RoboJackets/roboracing-electrical/README.md

# RoboRacing Electrical
This is a repository for the RoboJackets' RoboRacing Electrical team.

## rigatoni
Contains current files associated with Rigatoni.

## sedani
Contains current files associated with Sedani.

## archive
Contains old files no longer in use on the current robots.
