RoboJackets/roboracing-electrical/rigatoni/distributed-vision/CAMOutputs/Assembly/DistributedVisionSchematicPage1_3 4VER2.txt

Partlist exported from /Users/oankarpatil/Documents/GitHub/roboracing-electrical/distributed-vision/DistributedVisionSchematicPage1_3 4VER2.sch at 16/05/2021 17:10

Qty Value                        Device                       Package                    Parts                                                                                            Description                                                                                     AVAILABILITY COMMENT   DATASHEET-URL                                              DESCRIPTION                                                                            DIGI-KEY_PART_NUMBER DKPN                    EU_ROHS_COMPLIANCE FRES   IR   ISAT MF                MOUNT MP              PACKAGE                     PART-NUMBER  POPULARITY POWER PRICE PURCHASE-URL                                                     RDC-MAX RDC-TYP SPICEPREFIX TOLERANCE VALUE VERSION 
1   0.022uF, 50V                 C-USC0603                    C0603                      C123                                                                                             CAPACITOR, American symbol                                                                                                                                                                                                                                                                                                                                                                                                                 37                                                                                                      C                                   
1   0.1uF                        C-USC0402                    C0402                      C120                                                                                             CAPACITOR, American symbol                                                                                                                                                                                                                                                                                                                                                                                                                                                                                                                                                             
2   0.220uF                      C-USC0603                    C0603                      C124, C126                                                                                       CAPACITOR, American symbol                                                                                                                                                                                                                                                                                                                                                                                                                 37                                                                                                      C                                   
2   1-84952-5                    1-84952-5                    TE_1-84952-5               J8, J9                                                                                                                                                                                                        1-84952-5                                                             Conn FPC Connector SKT 15 POS 1mm Solder RA SMD T/R                                   A101391CT-ND                                 Compliant                           TE Connectivity         1-84952-5       None                                                            https://pricing.snapeda.com/search/part/1-84952-5/?ref=eda                                                           
1   1.3A  120r                   INDUCTOR_0805                0805                       L8                                                                                               Generic 0805 Inductor                                                                                                                                                                                                                                                                                                                                                                                                                                                                                                                                                                  
2   1.3A 120r                    INDUCTOR_0805                0805                       L4, L7                                                                                           Generic 0805 Inductor                                                                                                                                                                                                                                                                                                                                                                                                                                                                                                                                                                  
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
2   47k                          R-US_R0603                   R0603                      R8, R9                                                                                           RESISTOR, American symbol                                                                                                                                                                                                                                                                                                                                                                                                                  77                                                                                                      R                                   
1   47uH                         7447709470_7447709470        WE-PD_1210                 L9                                                                                               WE-PD SMT Power Inductor                                                                                               https://www.we-online.com/catalog/datasheet/7447709470.pdf                                                                                                             732-1246-1-ND                              6.5MHz 3.8A 4.5A                   SMT                                                7447709470                                                                                          60mOhm  46mOhm                        47uH  Standard
2   49.9, 1%                     R-US_R0402                   R0402                      R80, R81                                                                                         RESISTOR, American symbol                                                                                                                                                                                                                                                                                                                                                                                                                                                                                                                                                              
2   4A                           INDUCTOR_0805                0805                       L1, L2                                                                                           Generic 0805 Inductor                                                                                                                                                                                                                                                                                                                                                                                                                                                                                                                                                                  
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
1   ARJM11C7-104-AB-EW2          ARJM11C7-104-AB-EW2          CONN_EW_ABR                J12                                                                                              1 Port RJ45 Magjack Connector Through Hole 10/100 Base-T, AutoMDIX, Power over Ethernet (PoE)                                                                                                                                                                                                 535-14148-ND                                                                                                                                                                                                                                                                             
1   DM3D-SF                      DM3D-SF                      CONN8_DM3D-SF_HIR          J6                                                                                               10 (8 + 2) Position Card Connector Secure Digital - microSD™ Surface Mount, Right Angle Gold                                                                                                                                                                                                  HR1941CT-ND                                                                                                                                                                                                                                                                              
3   GRN                          LEDCHIP-LED0603              CHIP-LED0603               D3, D5, D7                                                                                       LED                                                                                                                                                                                                                                                                                                                                                                                                                                        26                                                                                                                                          
1   IFX91041                     IFX91041                     SOIC-8-EXPOSED_PAD         U11                                                                                              1.8A DC/DC Step-Down Voltage Regulator                                                                                                                                                                                                                                                        IFX91041EJV50XUMA1CT-ND                                                                                                                                                                                                                                                                  
1   JST-XH-02-PIN-LONG-PAD       JST-XH-02-PIN-LONG-PAD       JST-XH-02-PACKAGE-LONG-PAD X1                                                                                               JST XH Connector 2 Pin                                                                                                                                                                                                                                                                                                                                                                                                                                                                                                                                                                 
1   LAN9513-JZXQFN64_9X9MC_MCH-M LAN9513-JZXQFN64_9X9MC_MCH-M QFN64_9X9MC_MCH-M          U3                                                                                               USB to Ethernet. Datasheet link: https://ww1.microchip.com/downloads/en/DeviceDoc/00002305A.pdf                                                                                                                                                                                               LAN9513-JZX-ND                                                                                                                                                                                                                                                                           
1   LM26420XMH                   LM26420XMH                   SOP65P640X175-21N          U1                                                                                               Frequency Synchronous Step-Down DCDC Regulator Check prices                                     Good                                                                               Dual 2 A, high-efficiency synchronous DC/DC converter 20-HTSSOP -40 to 125                                                                                             Texas Instruments       LM26420XMH/NOPB HTSSOP-20 Texas Instruments                               None  https://pricing.snapeda.com/search/part/LM26420XMH/NOPB/?ref=eda                                                     
2   MOUNT-PAD-ROUND2.8           MOUNT-PAD-ROUND2.8           2,8-PAD                    H1, H2                                                                                           MOUNTING PAD, round                                                                                                                                                                                                                                                                                                                                                                                                                        6                                                                                                                                           
1   NTS260ESFT3G                 NTS260ESFT3G                 SOD123FL_DIO               D10                                                                                              Diode Schottky 2A Surface Mount SOD-123FL                                                                                                                                                                                                                                                     NTS260ESFT3GOSCT-ND                                                                                                                                                                                                                                                                      
1   RASPBERRRY_COMPUTE_CM3       RASPBERRRY_COMPUTE_CM3       TE_1473149-4_WITH_CM3PLUS  J2                                                                                               RASPBERRY PI COMPUTE 3+ 16GB                                                                                                                                                                                                                                                                  1690-1031-ND                                                                                                                                                                                                                                                                             
2   SP3003-02                    SP3003-02                    SC70-5                     U8, U9                                                                                           TVS DIODE ARRAY                                                                                                                                                                                                                                                                               F3302CT-ND                                                                                                                                                                                                                                                                               
1   TPS26600PWPR                 TPS26600PWPR                 PWP0016H_N                 U12                                                                                                                                                                                                                                                                                                                                                                                            296-47292-1-ND                                                                                                                                                                                                                                                                           
1   USBR-A-D-F-O-TH              USBR-A-D-F-O-TH              SAMTEC_USBR-A-D-F-O-TH     J1                                                                                               HIGH RETENTION USB TYPE A DOUBLE ROW Check prices                                                                                                                                  USB-A (USB TYPE-A) USB 2.0 Receptacle Connector 8 Position Through Hole, Right Angle  SAM10376-ND                                                                      Samtec                  USBR-A-D-F-O-TH None                                                            https://pricing.snapeda.com/search/part/USBR-A-D-F-O-TH/?ref=eda
