RoboJackets/roboracing-electrical/archive/2016-2017/macaroni/doc/ElectricalDocumentation.pdf

Pins:
- Radio: A1, A2
- Mux Output: 10, 11 (both PWM)
- Relay: 5
- Encoder: 3 (interrupt), 4
- Mux State: A0, A3 (pick one)

Layout

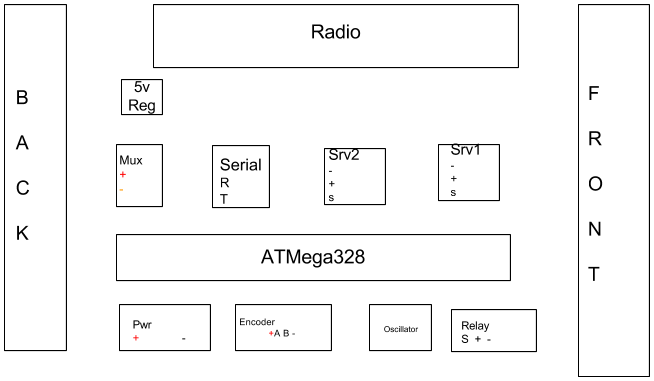
[picture p4: figure]
