RoboJackets/roboracing-electrical/neopixel_board/neopixel_board.png

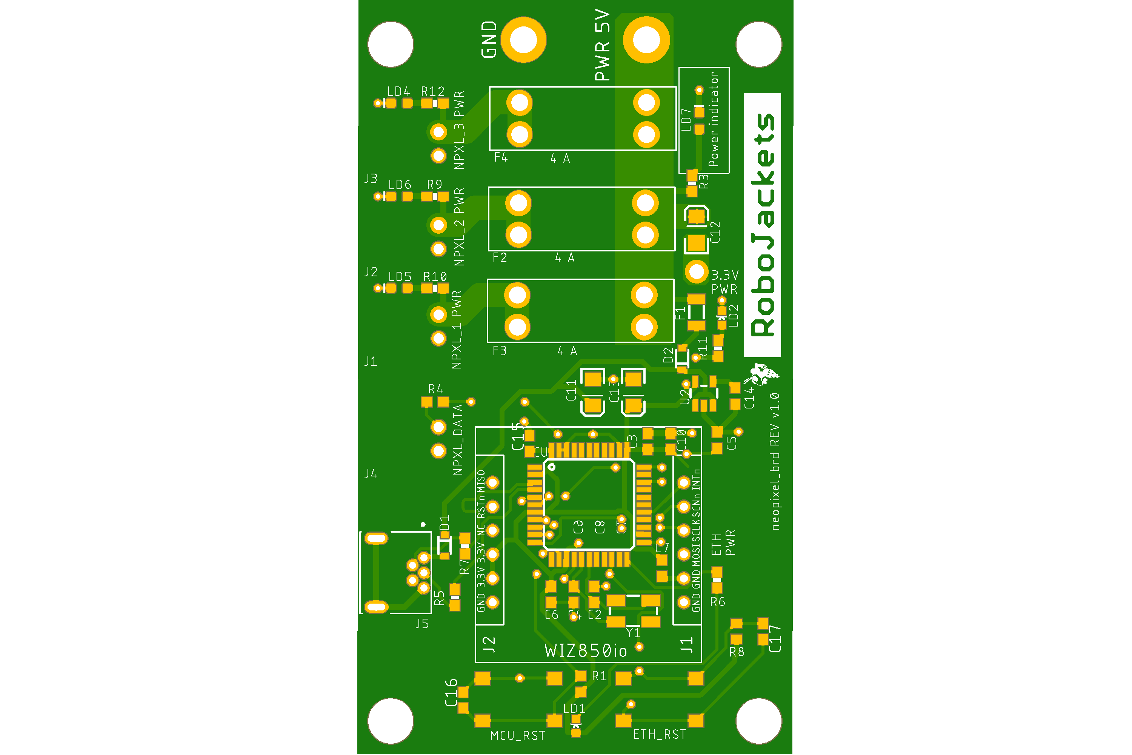
neopixel_board/neopixel_board.png
