RoboJackets/roboracing-electrical/rigatoni/estop/Specs/hytech_main_power_relay_control.png

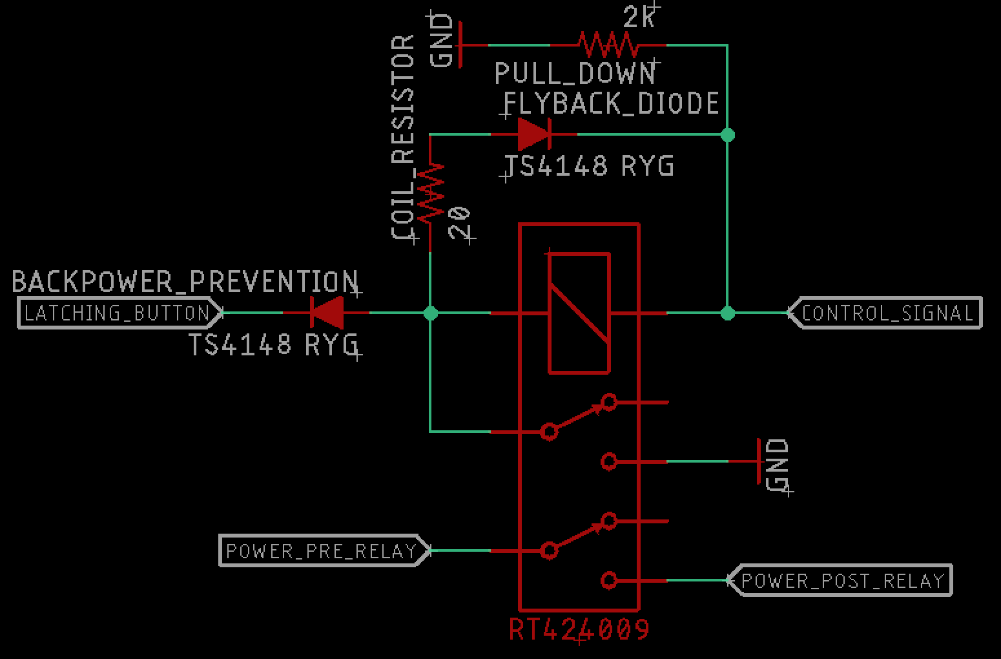
rigatoni/estop/Specs/hytech_main_power_relay_control.png
