RoboJackets/roboracing-electrical/rigatoni/radar-adapter/board_mfg_bottom.png

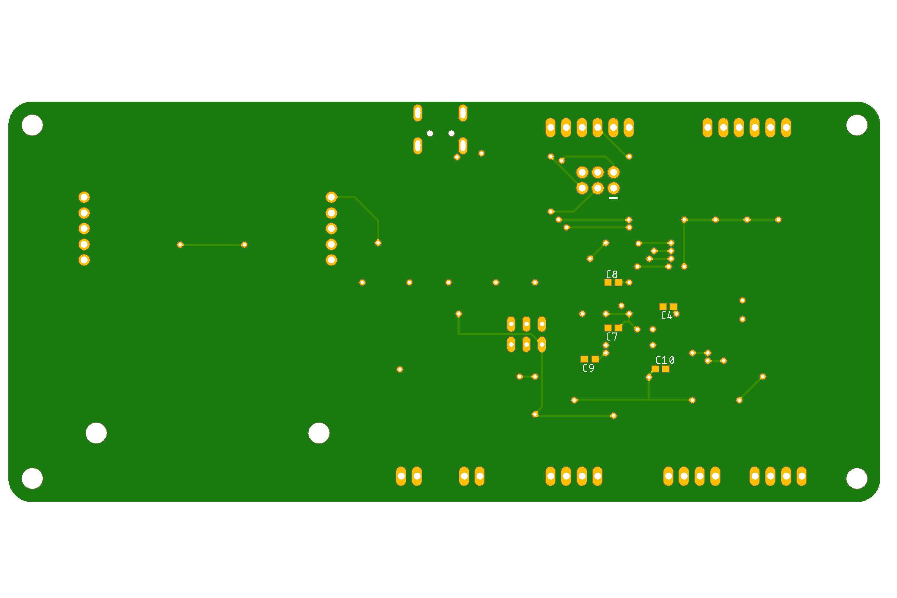
rigatoni/radar-adapter/board_mfg_bottom.png
