RoboJackets/roboracing-electrical/rigatoni/radar-adapter/board_mfg_top.png

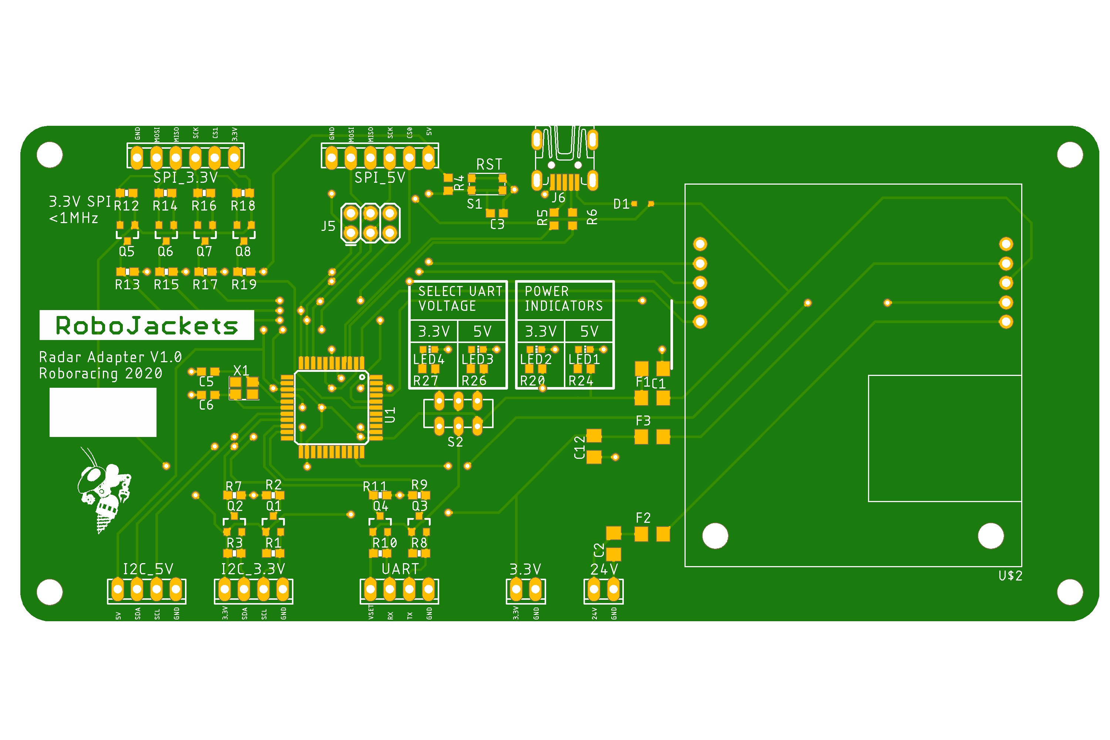
rigatoni/radar-adapter/board_mfg_top.png
