RoboJackets/roboracing-electrical/rigatoni/Steering/Mounting CAD/Steering_Top.png

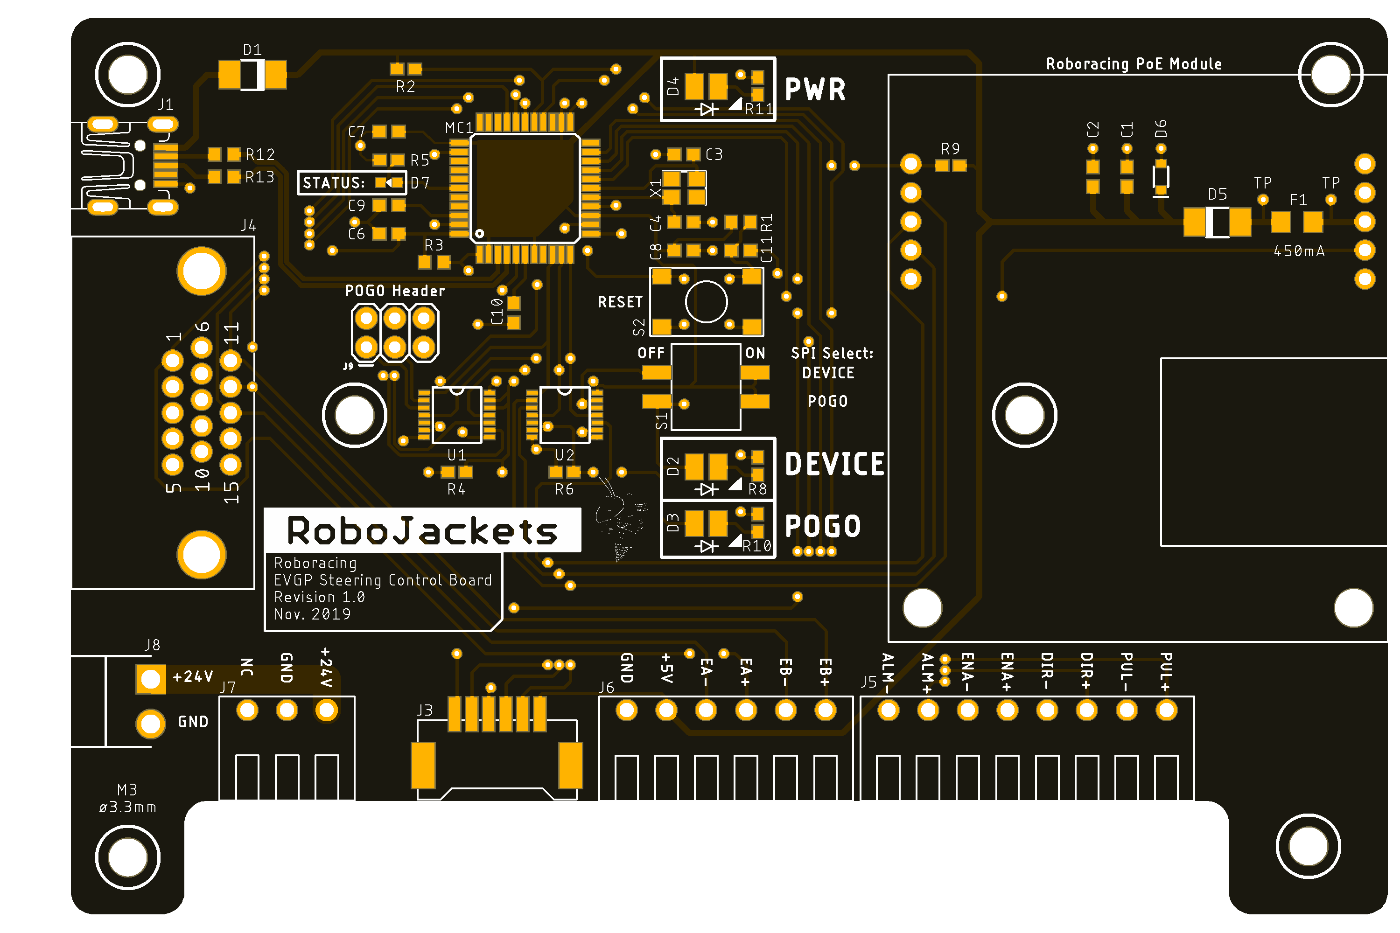
rigatoni/Steering/Mounting CAD/Steering_Top.png
