RoboJackets/roboracing-electrical/rigatoni/Steering/PCB Concept.jpg

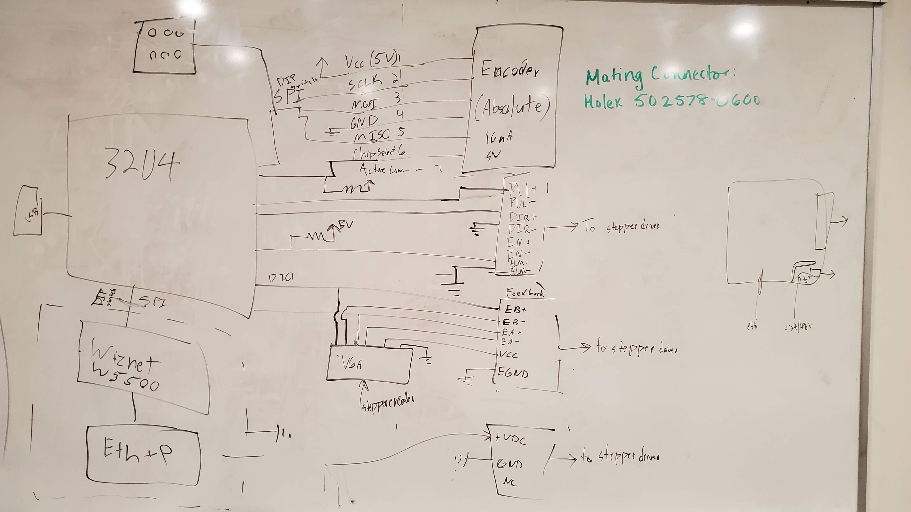
rigatoni/Steering/PCB Concept.jpg
