RoboJackets/roboracing-electrical/rigatoni/Steering/SteeringV2/SteeringV2.png

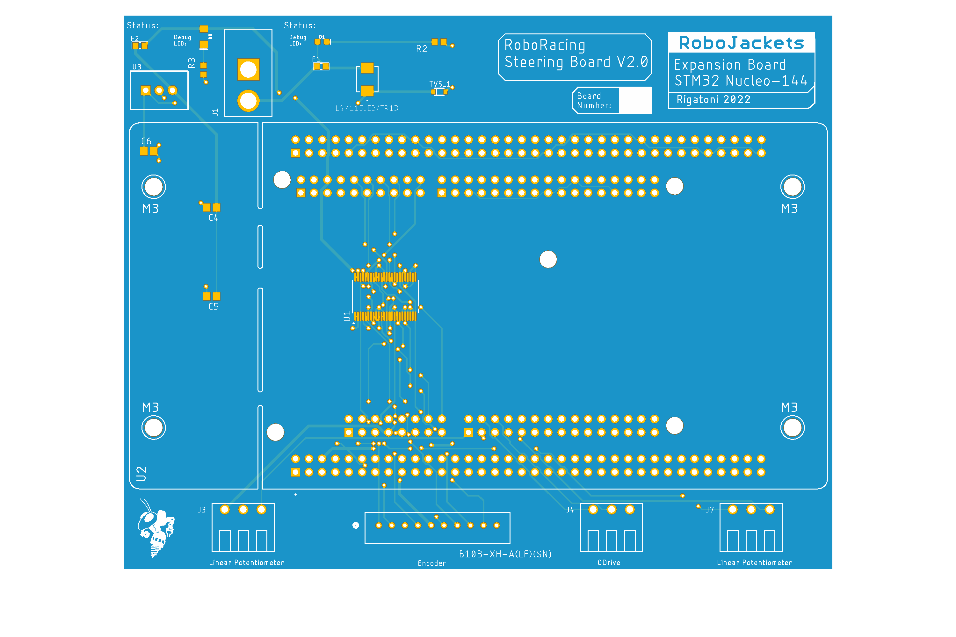
rigatoni/Steering/SteeringV2/SteeringV2.png
