RoboJackets/roboracing-electrical/sedani/estop/Eagle Files/e-stop-radio_v1.3_bot.png

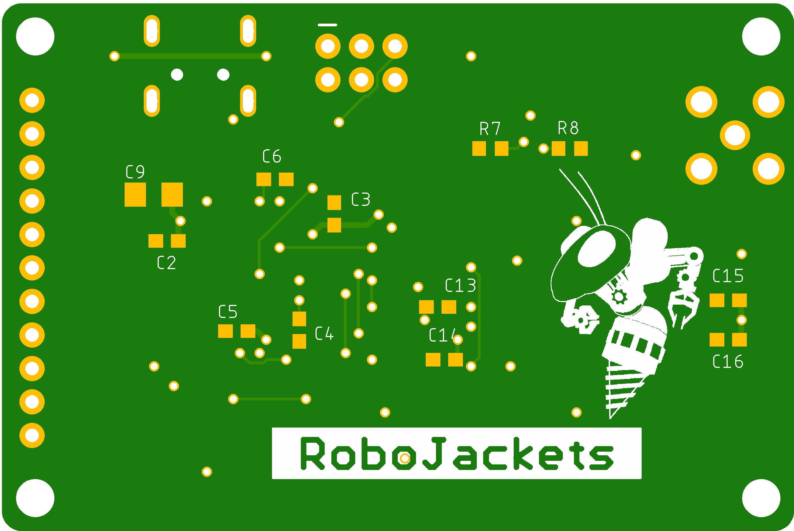
sedani/estop/Eagle Files/e-stop-radio_v1.3_bot.png
