RoboJackets/roboracing-electrical/sedani/estop/Eagle Files/e-stop-radio_v1.3_top.png

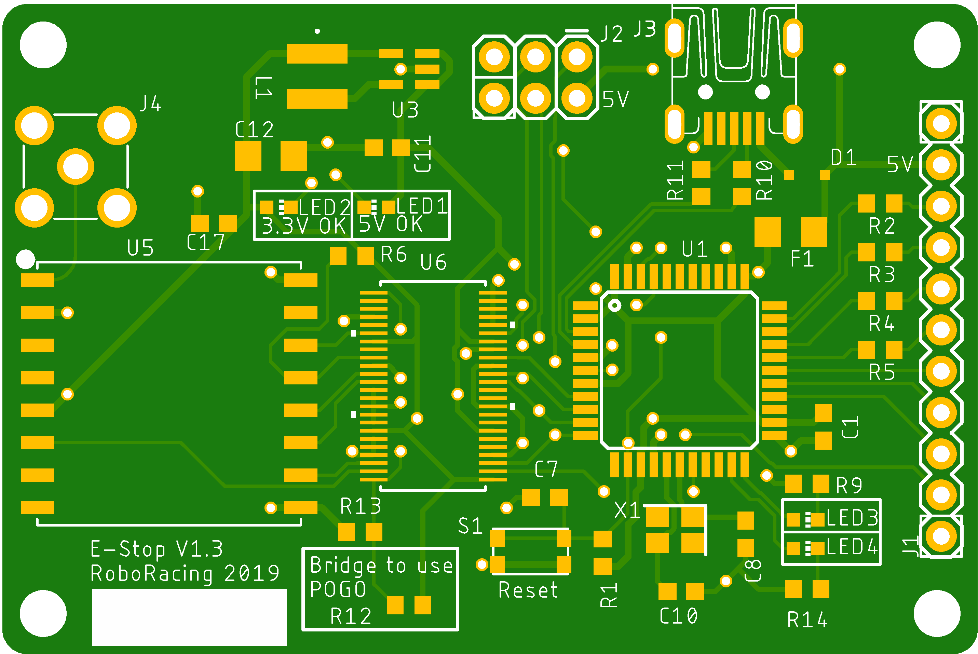
sedani/estop/Eagle Files/e-stop-radio_v1.3_top.png
