RoboJackets/roboracing-electrical/lidar-breakout/PartsList_LidarBreakout.xlsx

Part # | ORDER Quantities | Inventory | QTY | Price | Manufacturer Part # | Manuafacturer | Description | Supplier
455-1568-1-ND | 18 | 0 | 6 | $0.56 | SM06B-GHS-TB(LF)(SN) | JST | CONN HEADER SMD R/A 6POS 1.25MM | DIGIKEY | $3.36
CR0603-JW-201ELFCT-ND | 18 | 0 | 6 | $0.10 | CR0603-JW-201ELF | Bourns Inc. | RES SMD 200 OHM 5% 1/10W 0603 | DIGIKEY | $0.60
CR0603-JW-331ELFCT-ND | 15 | 0 | 5 | $0.10 | CR0603-JW-331ELF | Bourns Inc. | RES SMD 330 OHM 5% 1/10W 0603 | DIGIKEY | $0.50
160-1647-1-ND | 10 | 8 | 6 | $0.53 | LTST-C191TBKT | Lite-On Inc. | LED BLUE CLEAR SMD | DIGIKEY | $3.18
160-1446-1-ND | 8 | 4 | 4 | $0.29 | LTST-C191KGKT | Lite-On Inc. | LED GREEN CLEAR SMD | DIGIKEY | $1.16
507-1797-1-ND | 6 | 13 | 6 | $0.13 | 0ZCJ0020FF2E | Bel Fuse Inc. | PTC RESET FUSE 30V 200MA 1206 | DIGIKEY | $0.78
CR0603-JW-472ELFCT-ND | 6 | 0 | 2 | $0.10 | CR0603-JW-472ELF | Bourns Inc. | RES SMD 4.7K OHM 5% 1/10W 0603 | DIGIKEY | $0.20
1276-1182-1-ND | 5 | 4 | 3 | $0.10 | CL10A105KP8NNNC | Samsung Electro-Mechanics | CAP CER 1UF 10V X5R 0603 | DIGIKEY | $0.30
H2960CT-ND | 3 | 0 | 1 | $0.99 | UX60-MB-5S8 | Hirose Electric Co Ltd | CONN RCPT USB2.0 MINI B SMD R/A | DIGIKEY | $0.99
1276-1921-1-ND | 3 | 1 | 1 | $0.10 | CL10B103KB8NCNC | Samsung Electro-Mechanics | CAP CER 10000PF 50V X7R 0603 | DIGIKEY | $0.10
P22.0HCT-ND | 3 | 3 | 2 | $0.10 | ERJ-3EKF22R0V | Panasonic Electronic Components | RES SMD 22 OHM 1% 1/10W 0603 | DIGIKEY | $0.20
BSS84PH6433XTMA1CT-ND | 3 | 0 | 1 | $0.39 | BSS84PH6433XTMA1 | Infineon Technologies | MOSFET P-CH 60V 170MA SOT-23 | DIGIKEY | $0.39
490-9961-1-ND | 3 | 0 | 1 | $0.75 | GRM21BR61A476ME15L | Murata Electronics North America | CAP CER 47UF 10V X5R 0805 | DIGIKEY | $0.75
1276-1168-1-ND | 3 | 0 | 1 | $0.10 | CL10C471JB8NNNC | Samsung Electro-Mechanics | CAP CER 470PF 50V C0G/NP0 0603 | DIGIKEY | $0.10
EG4372-ND | 3 | 0 | 1 | $0.32 | TL1105XF160Q | E-Switch | SWITCH TACTILE SPST-NO 0.05A 12V | DIGIKEY | $0.32
WM1837CT-ND | 2 | 4 | 2 | $0.16 | 43030-0001 | Molex | CONN TERM FEMALE 20-24AWG TIN | DIGIKEY | $0.32
507-1806-1-ND | 2 | 4 | 2 | $0.21 | 0ZCJ0100FF2E | Bel Fuse Inc. | PTC RESET FUSE 6V 1A 1206 | DIGIKEY | $0.42
SER4070CT-ND | 2 | 1 | 1 | $0.36 | TSX-3225 16.0000MF18X-AC0 | EPSON | CRYSTAL 16.00 MHZ 9PF SMD | DIGIKEY | $0.36
1276-2143-1-ND | 2 | 4 | 2 | $0.10 | CL10C090DB8NNNC | Samsung Electro-Mechanics | CAP CER 9PF 50V C0G/NP0 0603 | DIGIKEY | $0.20
NCP59151DS50R4GOSCT-ND | 2 | 2 | 1 | $1.88 | NCP59151ds50r4g | ON Semiconductor | IC REG LINEAR 5V 1.5A D2PAK-5 | DIGIKEY | $1.88
WM1860-ND | 1 | 2 | 1 | $0.96 | 436500200 | Molex | CONN HEADER 2POS 3MM RT ANG TIN | DIGIKEY | $0.96
WM1845-ND | 1 | 2 | 1 | $0.33 | 43645-0200 | Molex | CONN RECEPT 2POS 3MM SINGLE ROW | DIGIKEY | $0.33
507-1773-1-ND | 1 | 2 | 1 | $0.21 | 0ZCG0150BF2C | Bel Fuse Inc. | PTC RESET FUSE 24V 1.5A 1812 | DIGIKEY | $0.21
160-1447-1-ND | 1 | 2 | 1 | $0.29 | LTST-C191KRKT | Lite-On Inc. | LED RED CLEAR SMD | DIGIKEY | $0.29
576-1281-1-ND | 1 | 2 | 1 | $0.92 | MIC5219-3.3YM5-TR | Microchip Technology | IC REG LINEAR 3.3V 500MA SOT23-5 | DIGIKEY | $0.92
ATMEGA32U4-AU-ND | 1 | 2 | 1 | $4.12 | ATMEGA32U4-AU | Microchip Technology | IC MCU 8BIT 32KB FLASH 44TQFP | DIGIKEY | $4.12
1276-1085-1-ND | 1 | 0 | 3 | $0.11 | CL10A225KP8NNNC | Samsung Electro-Mechanics | CAP CER 2.2UF 10V X5R 0603 | DIGIKEY | $0.33
455-1596-ND | 0 | 38 | 6 | $0.17 | GHR-06V-S | JST | CONN GH HOUSING 6POS 1.25MM | DIGIKEY | $1.02
455-1606-1-ND | 0 | ?? | 36 | $0.11 | SSHL-002T-P0.2 | JST | CONN TERMINAL GH 30-26 AWG | DIGIKEY | $3.96
1528-2553-ND | 0 | 2 | 1 | $1.95 | 3643 | Adafruit Industries LLC | 2.1MM DC POWER JACK WITH ROCKER | DIGIKEY | $1.95
P16767CT-ND | 0 | 4 | 1 | $0.32 | EVQ-P7J01P | Panasonic Electronic Components | SWITCH TACTILE SPST-NO 0.05A 12V | DIGIKEY | $0.32
1276-1258-1-ND | 0 | 31 | 13 | $0.10 | CL10F104ZO8NNNC | Samsung Electro-Mechanics | CAP CER 0.1UF 16V Y5V 0603 | DIGIKEY | $1.30
APD340VRTR-G1DICT-ND | 0 | 7 | 2 | $0.44 | APD340VRTR-G1 | Diodes Incorporated | DIODE SCHOTTKY 40V 3A DO214AC | DIGIKEY | $0.88
P15367CT-ND | 0 | 3 | 1 | $0.80 | EEU-FR1E681LB | Panasonic Electronic Components | CAP ALUM 680UF 20% 25V RADIAL | DIGIKEY | $0.80
1528-1104-ND | 0 | 29 | 1 | $0.45 | 1655 | Adafruit Industries LLC | ADDRESS LED DISCR SER RGB | DIGIKEY | $0.45
RHM10KADCT-ND | 0 | 6 | 2 | $0.14 | ESR03EZPF1002 | Rohm Semiconductor | RES SMD 10K OHM 1% 1/4W 0603 | DIGIKEY | $0.28
P975-ND | 0 | 5 | 1 | $0.27 | ECE-A1EKS100 | Panasonic Electronic Components | CAP ALUM 10UF 20% 25V RADIAL | DIGIKEY | $0.27
