RoboJackets/roboracing-electrical/rigatoni/estop_motherboard/Motherboard Components.csv

 | Specs | Quantity | URL
Connectors
To Optocouplers and Button | JST XH connector (female,2pin) | 3 | https://www.digikey.com/product-detail/en/jst-sales-america-inc/B2B-XH-A-LF-SN/455-2247-ND/1651045
 | JST XH connector (male,2pin) | 3 | https://www.digikey.com/product-detail/en/jst-sales-america-inc/XHP-2/455-2266-ND/555485
To Sensors and Brake | JST XH connector (female,3pin) | 3 | https://www.digikey.com/product-detail/en/jst-sales-america-inc/B3B-XH-A-LF-SN/455-2248-ND/1651046
 | JST XH connector (male,3pin) | 3 | https://www.digikey.com/product-detail/en/jst-sales-america-inc/XHP-3/455-2219-ND/1651017
To Stack Light | JST XH connector (female,4pin) | 1 | https://www.digikey.com/product-detail/en/jst-sales-america-inc/B4B-XH-A-LF-SN/455-2249-ND/1651047
 | JST XH connector (male,4pin) | 1 | https://www.digikey.com/product-detail/en/jst-sales-america-inc/XHP-4/455-2267-ND/683353
USB Connector | Horizontal, mini-usb | 1 | https://www.digikey.com/product-detail/en/cui-devices/UJ2-MBH-1-SMT-TR/102-4003-1-ND/6187925
ICs
AND Gates | AND GATE 2CH 2-INP US8 | 2 | https://www.digikey.com/product-detail/en/on-semiconductor/NL27WZ08USG/NL27WZ08USGOSCT-ND/964589
ATMEGA32u4 |  | 1 | https://www.digikey.com/product-detail/en/microchip-technology/ATMEGA32U4RC-AU/ATMEGA32U4RC-AU-ND/2507982
Stack Light
MOSFET | Dual N-Channel MOSFET | 2 | https://www.digikey.com/product-detail/en/DMN53D0LDW-7/DMN53D0LDW-7DICT-ND/4935006
LEDs
Device LED | Blue 0603 | 1 | https://www.digikey.com/product-detail/en/kingbright/APT1608QBC-D/754-1434-1-ND/2163792
Power LED | Green 0603 | 1 | https://www.digikey.com/product-detail/en/kingbright/APT1608CGCK/754-1116-1-ND/1747833
Ethernet
0.3A Fuse | PTC, for the 24V | 1 | https://www.digikey.com/product-detail/en/schurter-inc/PFNF.012.2/486-3546-1-ND/7682667
0.5A Fuse | PTC, for the 5V | 1 | https://www.digikey.com/product-detail/en/schurter-inc/PFNF.035.2/486-3548-1-ND/7682669
Reset/Clock
Pushbutton | KMR2 | 1 | https://www.digikey.com/product-detail/en/c-k/KMR211GLFS/401-1426-1-ND/550461
Crystal Oscillator | TSX-3225 16.0000MHF18X-AC0 | 1 | https://www.digikey.com/product-detail/en/epson/TSX-3225-16.0000MF18X-AC0/SER4070CT-ND/5413939
Diode
For USB | 200mA | 1 | https://www.digikey.com/product-detail/en/on-semiconductor/BAT54HT1G/BAT54HT1GOSCT-ND/917809
Resistors
For USB | 22 ohm, 0603 | 2 | https://www.digikey.com/product-detail/en/bourns-inc/CR0603-FX-22R0ELF/118-CR0603-FX-22R0ELFCT-ND/3925311
For LEDs | 330 ohm, 0603 | 2 | https://www.digikey.com/product-detail/en/bourns-inc/CR0603-JW-331ELF/CR0603-JW-331ELFCT-ND/3767680
Pull up/down resistors | 10k ohm, 0603; for RST, stack light, button connector | 5 | https://www.digikey.com/product-detail/en/bourns-inc/CR0603-JW-102ELF/CR0603-JW-102ELFCT-ND/3740984
Capacitors
For crystal oscillator | 9pF, 0603 ceramic | 2 | https://www.digikey.com/product-detail/en/samsung-electro-mechanics/CL10C090DB8NNNC/1276-2143-1-ND/3890229
For AREF | 10nF/10,000pF, 0603 ceramic | 1 | https://www.digikey.com/product-detail/en/kemet/C0603C103J5RACTU/399-1092-1-ND/411367
For VCC, RST button debounce | 0.1uF, 0603 ceramic | 5 | https://www.digikey.com/product-detail/en/yageo/CC0603KRX7R9BB104/311-1344-1-ND/2103128
For UCAP | 1uF, 0603 ceramic | 1 | https://www.digikey.com/product-detail/en/tdk-corporation/CGJ3E1X7R1E105K080AC/445-13311-1-ND/3954977
For ethernet-POE | 47uF, 1206 ceramic | 2 | https://www.digikey.com/product-detail/en/yageo/CC1206MKX5R7BB476/311-3521-1-ND/7164542
