RoboJackets/roboracing-electrical/rigatoni/radar-adapter/RADAR BOM.xlsx

Part | Value | Device | Package | Description | Vendor Part Number | description | Unit Quantity | Order Quantity | Unit Price | Total Cost
Header | 2 position | MTA02-100 | 10X02MTA | AMP connector | 455-2247-ND | CONN HEADER VERT 2POS 2.5MM | 2 | 3 | $0.15 | $0.45
Header | 4 position | MTA04-100 | 10X04MTA | AMP connector | 455-2249-ND | CONN HEADER VERT 4POS 2.5MM | 3 | 4 | $0.21 | $0.84
Header | 6 position | MTA06-100 | 10X06MTA | AMP connector | 455-2271-ND | CONN HEADER VERT 6POS 2.5MM | 2 | 3 | $0.27 | $0.81
C1 | 10uF | C-USC1206 | C1206 | CAPACITOR, American symbol | 478-10766-1-ND | CAP CER 10UF 10V X5R 0603 | 3 | 5 | $0.14 | $0.70
C3 | 0.1uF | C-USC0603 | C0603 | CAPACITOR, American symbol | 1276-1006-1-ND | CAP CER 0.1UF 25V X7R 0603 | 5 | 10 | $0.03 | $0.27
C5 | 9pF | C-USC0603 | C0603 | CAPACITOR, American symbol | 490-11483-1-ND | CAP CER 9PF 50V C0G/NP0 0603 | 2 | 4 | $0.12 | $0.48
C8 | 1 uF | C-USC0603 | C0603 | CAPACITOR, American symbol | 1276-1102-1-ND | CAP CER 1UF 25V X5R 0603 | 1 | 10 | $0.04 | $0.35
D1 | 200mA | DIODE-SOD323-R | SOD323-R | DIODE | 1727-3561-1-ND | DIODE SCHOTTKY 30V 200MA SOD323 | 1 | 2 | $0.21 | $0.42
F1 | 0.3A | CHIP_FUSE1206 | F1206 | FUSE | F10984CT-ND | PTC RESET FUSE 24V 300MA 1206 | 3 | 4 | $1.12 | $4.48
J6 | UX60-MB-5S8 | UX60-MB-5S8 | UX60-MB-5S8 | Mini USB Connector | 102-4003-1-ND | CONN RCPT USB2.0 MINI B SMD R/A | 1 | 2 | $0.49 | $0.98
LED1 | RED | LEDCHIP-LED0603 | CHIP-LED0603 | LED | 732-4979-1-ND | LED RED CLEAR 0603 SMD | 2 | 3 | $0.14 | $0.42
LED2 | GREEN | LEDCHIP-LED0603 | CHIP-LED0603 | LED | 732-4971-1-ND | LED GREEN CLEAR 0603 SMD | 2 | 3 | $0.14 | $0.42
Q1 | BSS138 | MOSFET-NCHANNELSMD | SOT23-3 | MOSFET | BSS138CT-ND | MOSFET N-CH 50V 220MA SOT23-3 | 5 | 10 | $0.19 | $1.88
R1 | 10K | RESISTOR0603-RES | 0603-RES | Resistor | CR0603-FX-1002ELFCT-ND | RES SMD 10K OHM 1% 1/10W 0603 | 5 | 10 | $0.02 | $0.16
R5 | 22 | R-US_R0603 | R0603 | RESISTOR, American symbol | CR0603-JW-220ELFCT-ND | RES SMD 22 OHM 5% 1/10W 0603 | 2 | 10 | $0.01 | $0.14
R8 | 4.7K | RESISTOR0603-RES | 0603-RES | Resistor | CR0603-FX-4701ELFCT-ND | RES SMD 4.7K OHM 1% 1/10W 0603 | 6 | 10 | $0.02 | $0.16
R12 | 2.2K | RESISTOR0603-RES | 0603-RES | Resistor | CR0603-JW-222ELFCT-ND | RES SMD 2.2K OHM 5% 1/10W 0603 | 3 | 10 | $0.01 | $0.14
R13 | 1.2K | RESISTOR0603-RES | 0603-RES | Resistor | 118-CR0603-JW-122ELFCT-ND | RES SMD 1.2K OHM 5% 1/10W 0603 | 3 | 10 | $0.02 | $0.22
R20 | 220 | R-US_R0603 | R0603 | RESISTOR, American symbol | 118-CR0603-FX-2200ELFCT-ND | RES SMD 220 OHM 1% 1/10W 0603 | 1 | 10 | $0.02 | $0.16
R24 | 330 | R-US_R0603 | R0603 | RESISTOR, American symbol | CR0603-FX-3300ELFCT-ND | RES SMD 330 OHM 1% 1/10W 0603 | 3 | 10 | $0.02 | $0.16
S1 | KMR2 | KMR2 | KMR2 | Reset button | 401-1426-1-ND | Pushbutton | 1 | 2 | $0.48 | $0.96
U$4 | DPDT_SLIDE_SWITCH | DPDT_SLIDE_SWITCH | DPDT_SLIDE_SWITCH | SWITCH | 401-2001-ND | SWITCH SLIDE DPDT 300MA 6V | 1 | 2 | $0.54 | $1.08
U1 | ATMEGA32U4-AU | ATMEGA32U4-AU | TQFP44 | http://www.ladyada.net/library/eagle | ATMEGA32U4-AURCT-ND | IC MCU 8BIT 32KB FLASH 44TQFP | 1 | 2 | $4.71 | $9.42
X1 | TSX-3225 16.0000MF18X-AC0 | XTAL-3.2X2.5 | XTAL-3.2X2.5 | CRYSTAL OSCILLATOR | SER4070CT-ND | CRYSTAL 16.0000MHZ 9PF SMD | 1 | 2 | $0.33 | $0.66
 |  |  |  |  |  |  |  |  | Total: | $25.76
