RoboJackets/roboracing-electrical/rigatoni/distributed-vision/CAMOutputs/Assembly/DisbVision_JLC_BOM.xlsx

Comment | Designator | Footprint | LCSC Part #（optional）
0.022uF, 50V | C123 | 0603_C
0.1uF | C120 | 0603_C
0.220uF | C124, C126 | 0603_C
1-84952-5 | J8, J9 | TE_1-84952-5
1.3A 120r | L4, L7, L8 | 0805_L
10000pF | C118, C119 | 0402_C
10000pF | C4, C8, C9, C13, C18, C19, C20, C33, C51, C52, C58, C75, C76, C77, C80, C85, C86, C117, C121 | 0603_C
10000pF, 50V | C122 | 0603_C
100k | R23, R24 | 0603_R
100nF | C5, C6, C10, C15, C16, C21, C42, C45, C46, C50, C69, C70, C71, C78, C81, C82, C83, C84, C88, C91, C72, C79 | 0603_C
100nF | C60, C63, C68 | 0402_C
100uF | C125, C129 | E2-5
10k | R13, R14,R78,R79 | 0603_R
10nF | C61 | 0402_C
10uF | C73 | 0402_C
10uF | C7, C12, C17, C22, C35, C102, C103 | 0603_C
11.8k, 1% | R86 | 0603_R
12.4k, 1.0% | R27 | 0805_R
12.7k | R11 | 0603_R
12k, 1.0% | R26 | 0805_R
1M | R39 | 0805_R
1uF | C14, C64 | 0402_C
1uF, 50V | C127 | 0603_C
2.2uF, 50V | C128 | 0603_C
20k, 1% | R84 | 0603_R
22 | RN42, RN43 | 4_1206_RN
22k, 1% | R77 | 0603_R
22k | R82 | 0603_R
22uF | C23, C24 | 0603_C
22uF | C26, C27, C28, C29 | 0805_C
25 MHz | Q7 | FA-20H
2A | F1, F2 | 1812
30.1k, 1% | R85 | 0603_R
31.6k | R10 | 0603_R
330 | R97 | 0603_R
33pF | C65, C66 | 0402_C
34EWMSP12M6RT | S2 | 34EWMSP12M6RT
4.7k | R28, R30, R32, R40 | 0805_R
4.7k | R16, R20, R21, R22, R96 | 0603_R
4.7uF | C62 | 0402_C
4.7uF | C43, C44 | 0603_C
470 | R74, R75, R98 | 0603_R
470nF | C25 | 0603_C
47k | R8, R9 | 0603_R
47uH | L9 | WE-PD_1210
49.9, 1% | R80, R81 | 0402_R
4A | L1, L2 | 0805_L
5.1k | R7 | 0603_R
66.5k, 1% | R87 | 0603_R
715k, 1% | R83 | 0603_R
75, 1% | R73, R76 | 0603_R
‎ARJM11C7-114-BA-EW2‎ | J12 | CONN_EW_ABR
DM3D-SF | J6 | CONN8_DM3D-SF_HIR
‎XZVG53W-8 | D3, D5, D7 | CHIP-LED0603
‎TLF50211ELXUMA2‎ | U11 | SOIC-8
‎B2B-XH-A(LF)(SN)‎ | X1 | JST-XH-02
LAN9513-JZX | U3 | QFN64_9X9MC_MCH-M
LM26420XMH | U1 | SOP65P640X175-21N
‎SMD26PL-TP‎ | D10 | SOD123FL_DIO
RASPBERRRY_COMPUTE_CM3 | J2 | TE_1473149-4_WITH_CM3PLUS
‎SP3003-02XTG‎ | U8, U9 | SC70-5
‎TPS26602PWPT‎ | U12 | PWP0016H_N
USBR-A-D-F-O-TH | J1 | SAMTEC_USBR-A-D-F-O-TH
