RoboJackets/roboracing-electrical/rigatoni/distributed-vision/CAMOutputs/Assembly/DisbVisionBOMVer2_1.xlsx

Value | Designator | Footprint | Device | Quantity | DigiKey Part Number
0.022uF, 50V | C123 | C0603 | C-USC0603 | 1 | 1276-1104-1-ND
0.1uF | C120 | C0402 | C-USC0402 | 1 | 399-C0603X104K5RAC3316CT-ND
0.220uF | C124, C126 | C0603 | C-USC0603 | 2 | 478-1243-1-ND
1-84952-5 | J8, J9 | TE_1-84952-5 | 1-84952-5 | 2 | A101391CT-ND
1.3A 120r | L8 | 805 | INDUCTOR_0805 | 1 | 541-1406-1-ND
1.3A 120r | L4, L7 | 805 | INDUCTOR_0805 | 2 | 541-1406-1-ND
10000pF | C118, C119 | C0402 | C-USC0402 | 2 | 478-5007-1-ND
10000pF | C117, C121 | C0603 | C-USC0603 | 2 | 445-8116-1-ND
10000pF, 50V | C122 | C0603 | C-USC0603 | 1 | 478-1254-1-ND
100k | R23, R24 | R0603 | R-US_R0603 | 2 | 541-100KAYCT-ND
100nF | C72, C79 | C0603 | C-USC0603 | 2 | 445-5667-1-ND
100nF | C60, C63, C68 | C0402 | C-USC0402 | 3 | 1276-1001-1-ND
100nF | C5, C6, C10, C15, C16, C21, C42, C45, C46, C50, C69, C70, C71, C78, C81, C82, C83, C84, C88, C91 | C0603 | C-USC0603 | 20 | 445-5667-1-ND
100uF | C125 | E2-5 | CPOL-USE2-5 | 1 | 445-6007-1-ND
100uF, 35V | C129 | E2,5-7 | CPOL-USE2.5-7 | 1 | 445-6007-1-ND
10k | R13, R14,R78,R79 | R0603 | R-US_R0603 | 4 | 1135-1057-1-ND
10nF | C61 | C0402 | C-USC0402 | 1 | 720-1362-1-ND
10nF | C4, C8, C9, C13, C18, C19, C20, C33, C51, C52, C58, C75, C76, C77, C80, C85, C86 | C0603 | C-USC0603 | 17 | 445-8116-1-ND
10uF | C73 | C0402 | C-USC0402 | 1 | 478-10059-1-ND
10uF | C7, C12, C17, C22, C35, C102, C103 | C0603 | C-USC0603 | 7 | 445-9065-1-ND
11.8k, 1% | R86 | R0603 | R-US_R0603 | 1 | 541-RCS060311K8FKEACT-ND
12.4k, 1.0% | R27 | RC0805N | ERJ-L06KF50MV | 1 | 541-12.4KTCT-ND
12.7k | R11 | R0603 | R-US_R0603 | 1 | 541-3584-1-ND
12k, 1.0% | R26 | RC0805N | ERJ-L06KF50MV | 1 | 541-10502-1-ND
1M | R39 | RC0805N | ERJ-L06KF50MV | 1 | 541-1.00MTCT-ND
1uF | C14, C64 | C0402 | C-USC0402 | 2 | 445-9066-1-ND
1uF, 50V | C127 | C0603 | C-USC0603 | 1 | 445-7468-1-ND
2.2uF, 50V | C128 | C0603 | C-USC0603 | 1 | 490-12332-1-ND
20k, 1% | R84 | R0603 | R-US_R0603 | 1 | 541-2993-1-ND
22 | RN42, RN43 | RA-4_1206 | RA-41206 | 2 | CAY16-22R0F4LFCT-ND
22k, 1% | R77 | R0603 | R-US_R0603 | 1 | 541-10441-1-ND
22k | R82 | R0603 | R-US_R0603 | 1 | 541-CRCW060322K0JNEACCT-ND
22uF | C23, C24 | C0603 | C-USC0603 | 2 | 1276-2868-1-ND
22uF | C26, C27, C28, C29 | C0805 | C-USC0805 | 4 | 445-11527-1-ND
25 MHz | Q7 | FA-20H | FA-20H | 1 | XC3051CT-ND
2A | F1, F2 | 1812 | PTCFUSE-1812 | 2 | SF-0603F200-2CT-ND
30.1k, 1% | R85 | R0603 | R-US_R0603 | 1 | 541-5345-1-ND
31.6k | R10 | R0603 | R-US_R0603 | 1 | 541-RCS060331K6FKEACT-ND
330 | R97 | R0603 | R-US_R0603 | 1 | 541-330GCT-ND
33pF | C65, C66 | C0402 | C-USC0402 | 2 | 445-1241-1-ND
34EWMSP12M6RT | S2 | 34EWMSP12M6RT | 34EWMSP12M6RT | 1 | GH7540CT-ND
4.7k | R28, R30, R32, R40 | RC0805N | ERJ-L06KF50MV | 4 | 541-CRCW08054K70JNEAIFCT-ND
4.7k | R16, R20, R21, R22, R96 | R0603 | R-US_R0603 | 5 | 541-4.7KGCT-ND
4.7uF | C62 | C0402 | C-USC0402 | 1 | 490-11980-1-ND
4.7uF | C43, C44 | C0603 | C-USC0603 | 2 | 1276-6794-1-ND
470 | R74, R75, R98 | R0603 | R-US_R0603 | 3 | 541-4055-1-ND
470nF | C25 | C0603 | C-USC0603 | 1 | 587-3476-1-ND
47k | R8, R9 | R0603 | R-US_R0603 | 2 | 541-4021-1-ND
47uH | L9 | WE-PD_1210 | 7447709470_7447709470 | 1 | 732-1246-1-ND
49.9, 1% | R80, R81 | R0402 | R-US_R0402 | 2 | 541-2963-1-ND
4A | L1, L2 | 805 | INDUCTOR_0805 | 2 | 541-1555-1-ND
5.1k | R7 | R0603 | R-US_R0603 | 1 | 541-2035-1-ND
66.5k, 1% | R87 | R0603 | R-US_R0603 | 1 | 541-CRCW060366K5FKEBCT-ND
715k, 1% | R83 | R0603 | R-US_R0603 | 1 | 311-715KHRCT-ND
75, 1% | R73, R76 | R0603 | R-US_R0603 | 2 | 541-2196-1-ND
ARJM11C7-104-AB-EW2 | J12 | CONN_EW_ABR | ARJM11C7-104-AB-EW2 | 1 | 535-14148-ND
DM3D-SF | J6 | CONN8_DM3D-SF_HIR | DM3D-SF | 1 | HR1941CT-ND
GRN | D3, D5, D7 | CHIP-LED0603 | LEDCHIP-LED0603 | 3 | 1497-1215-1-ND
IFX91041 | U11 | SOIC-8-EXPOSED_PAD | IFX91041 | 1 | IFX91041EJV50XUMA1CT-ND
JST-XH-02-PIN | X1 | JST-XH-02-PIN-LONG-PAD | JST-XH-02-PACKAGE-LONG-PAD | 1 | 455-2247-ND
LAN9513-JZXQF | U3 | QFN64_9X9MC_MCH-M | N64_9X9MC_MCH-M LAN9513-JZXQFN64_9X9MC_MCH-M | 1 | LAN9513-JZX-ND
LM26420XMH | U1 | SOP65P640X175-21N | LM26420XMH | 1 | 296-LM26420XMH/NOPB-ND
NTS260ESFT3G | D10 | SOD123FL_DIO | NTS260ESFT3G | 1 | NTS260ESFT3GOSCT-ND
CONN SKT SODIMM 200POS R/A SMD | J2 | TE_1473149-4_WITH_CM3PLUS | RASPBERRRY_COMPUTE_CM3 | 1 | A114854-ND
RASPBERRRY_COMPUTE_CM3 |  |  |  | 1 | 1690-1031-ND
SP3003-02 | U8, U9 | SC70-5 | SP3003-02 | 2 | F3302CT-ND
TPS26600PWPR | U12 | PWP0016H_N | TPS26600PWPR | 1 | 296-47292-1-ND
USBR-A-D-F-O-TH | J1 | SAMTEC_USBR-A-D-F-O-TH | USBR-A-D-F-O-TH | 1 | SAM10376-ND
