RoboJackets/roboracing-electrical/rigatoni/2024-drive-steering/2024-drive-steering.csv

Source: | C:\Users\JMACHALE\RoboJackets\roboracing-electrical\2024-drive-steering\2024-drive-steering.kicad_sch
Date: | 4/13/2024 21:35
Tool: | Eeschema 7.0.7
Generator: | C:\Program Files\KiCad\7.0\bin\scripting\plugins/bom_csv_grouped_by_value.py
Component Count: | 15
Collated Components:
Item | Qty | Reference(s) | Value | LibPart | Footprint | Datasheet | DNP | DigiKey Part Number | Part Description | Part Name
1 | 1 | C1 | 10uF | Device:C | Capacitor_SMD:C_0805_2012Metric_Pad1.18x1.45mm_HandSolder | https://mm.digikey.com/Volume0/opasdata/d220001/medias/docus/609/CL21A106KOQNNNE_Spec.pdf |  | 1276-1096-1-ND | 10 µF ±10% 16V Ceramic Capacitor X5R 0805 (2012 Metric) | CL21A106KOQNNNE
2 | 2 | C2, C3 | 47uF | Device:C | Capacitor_SMD:C_1210_3225Metric_Pad1.33x2.70mm_HandSolder | https://www.samsungsem.com/resources/file/global/support/product_catalog/MLCC.pdf |  | 1276-3376-1-ND | 47 µF ±10% 16V Ceramic Capacitor X5R 1210 (3225 Metric) | CL32A476KOJNNNE
3 | 1 | CR1 | Schottky - LSM115JE3/TR13 | Device:D_Schottky | RoboRacing:DO-214BA_MCH | https://mm.digikey.com/Volume0/opasdata/d220001/medias/docus/794/LSM115J.pdf |  | 150-LSM115JE3/TR13CT-ND | Diode 15 V 1A Surface Mount DO-214BA
4 | 1 | D1 | YELLOW | Device:LED | LED_SMD:LED_0603_1608Metric_Pad1.05x0.95mm_HandSolder | https://www.we-online.com/components/products/datasheet/150060YS75000.pdf |  | 732-4981-1-ND | Yellow 590nm LED Indication - Discrete 2V 0603 (1608 Metric) | 150060YS75000
5 | 1 | D2 | TVS - D5V0L1B2WS-7 | Device:D_TVS | Diode_SMD:D_SOD-323_HandSoldering | https://www.diodes.com/assets/Datasheets/D5V0L1B2WS.pdf |  | D5V0L1B2WS-7DICT-ND | 14V Clamp 6A (8/20µs) Ipp Tvs Diode Surface Mount SOD-323
6 | 1 | D3 | GREEN | Device:LED | LED_SMD:LED_0603_1608Metric_Pad1.05x0.95mm_HandSolder | https://www.we-online.com/components/products/datasheet/150060GS75000.pdf |  | 732-4971-1-ND | Green 520nm LED Indication - Discrete 3.2V 0603 (1608 Metric) | 150060GS75000
7 | 1 | F1 | Fuse 500mA | Device:Fuse | Fuse:Fuse_0603_1608Metric_Pad1.05x0.95mm_HandSolder | https://www.belfuse.com/resources/datasheets/circuitprotection/ds-cp-c2q-series.pdf |  | 507-1089-1-ND | 500 mA 32 V AC 63 V DC Fuse Board Mount (Cartridge Style Excluded) Surface Mount 0603 (1608 Metric) | C2Q 500
8 | 1 | J1 | Barrel_Jack | Connector:Barrel_Jack | RoboRacing:CUI_PJ-037A | https://www.cuidevices.com/product/resource/pj-037a.pdf |  | CP-037A-ND | Power Barrel Connector Jack 2.10mm ID (0.083"), 5.50mm OD (0.217") Through Hole, Right Angle | PJ-037A
9 | 1 | J3 | Screw_Terminal_01x03 | Connector:Screw_Terminal_01x03 | RoboRacing:282837-3_TYC | https://www.te.com/usa-en/product-282837-3.datasheet.pdf |  | A113321-ND | 3 Position Wire to Board Terminal Block Horizontal with Board 0.200" (5.08mm) Through Hole | 282837-3
10 | 2 | J4, J5 | Screw_Terminal_01x02 | Connector:Screw_Terminal_01x02 | RoboRacing:TE_282837-2 | https://www.te.com/usa-en/product-282837-2.datasheet.pdf |  | A113320-ND | 2 Position Wire to Board Terminal Block Horizontal with Board 0.200" (5.08mm) Through Hole | 282837-2
11 | 1 | R1 | 499R | Device:R_US | Resistor_SMD:R_0603_1608Metric_Pad0.98x0.95mm_HandSolder | https://www.yageo.com/upload/media/product/products/datasheet/rchip/PYu-RC_Group_51_RoHS_L_12.pdf |  | 311-499HRCT-ND | 499 Ohms ±1% 0.1W, 1/10W Chip Resistor 0603 (1608 Metric) Moisture Resistant Thick Film | RC0603FR-07499RL
12 | 1 | R2 | 150R | Device:R_US | Resistor_SMD:R_0603_1608Metric_Pad0.98x0.95mm_HandSolder | https://www.yageo.com/upload/media/product/productsearch/datasheet/rchip/PYu-AC_51_RoHS_L_10.pdf |  | YAG3568CT-ND | 150 Ohms ±1% 0.1W, 1/10W Chip Resistor 0603 (1608 Metric) Automotive AEC-Q200, Moisture Resistant Thick Film | AC0603FR-07150RL
13 | 1 | U1 | TPSM84205EAB | RoboRacing:TPSM84205EAB | RoboRacing:TPSM84205EAB | https://www.ti.com/lit/ds/symlink/tpsm84203.pdf?HQS=dis-dk-null-digikeymode-dsf-pf-null-wwe&ts=1712864330127 |  | 296-47074-ND | Linear Regulator Replacement DC DC Converter 1 Output 5V 1.5A 7V - 28V Input
