RoboJackets/roboracing-electrical/neopixel_board/partsList_Neopixel.xlsx

Digikey Part # | Order Quatities | QTY | Price | Manufacturer Part # | Manuafacturer | Description | Supplier | Total Cost | link
ATMEGA32U4-AURCT-ND |  | 1 | $4.20 | ATMEGA32U4-AUR | Microchip Technology | Microcontroller | Digikey |  | https://www.digikey.com/product-detail/en/microchip-technology/ATMEGA32U4-AUR/ATMEGA32U4-AURCT-ND/3440960
WM17143CT-ND |  | 1 | $0.83 | 475890001 | Molex | USB Programmer | Digikey |  | https://www.digikey.com/product-detail/en/molex-llc/0475890001/WM17143CT-ND/1832255
1278-1043-ND |  | 1 | $19.87 | WIZ850IO | WIZnet | INTERNET OFFLOAD PLAT | Digikey |  | https://www.digikey.com/product-detail/en/wiznet/WIZ850IO/1278-1043-ND/8789619
576-1281-1-ND |  | 1 | $0.92 | MIC5219-3.3YM5-TR | Microchip Technology | IC REG LINEAR 3.3V 500mA | Digikey |  | https://www.digikey.com/product-detail/en/microchip-technology/MIC5219-3.3YM5-TR/576-1281-1-ND/771902
SAM11929-ND |  | 4 | $0.55 | SSW-102-02-T-S-RA | Samtec Inc. | CONN RCPT 2POS (right angle) | Digikey |  | https://www.digikey.com/product-detail/en/samtec-inc/SSW-102-02-T-S-RA/SAM11929-ND/6691686
CKN9112CT-ND |  | 2 | $0.17 | PTS645SM43SMTR92 LFS | C&K | SWITCH TACTILE | Digikey |  | https://www.digikey.com/product-detail/en/c-k/PTS645SM43SMTR92-LFS/CKN9112CT-ND/1146934
