RoboJackets/roboracing-electrical/kicad-libraries/3D Models/LSM115JE3_TR13.STEP

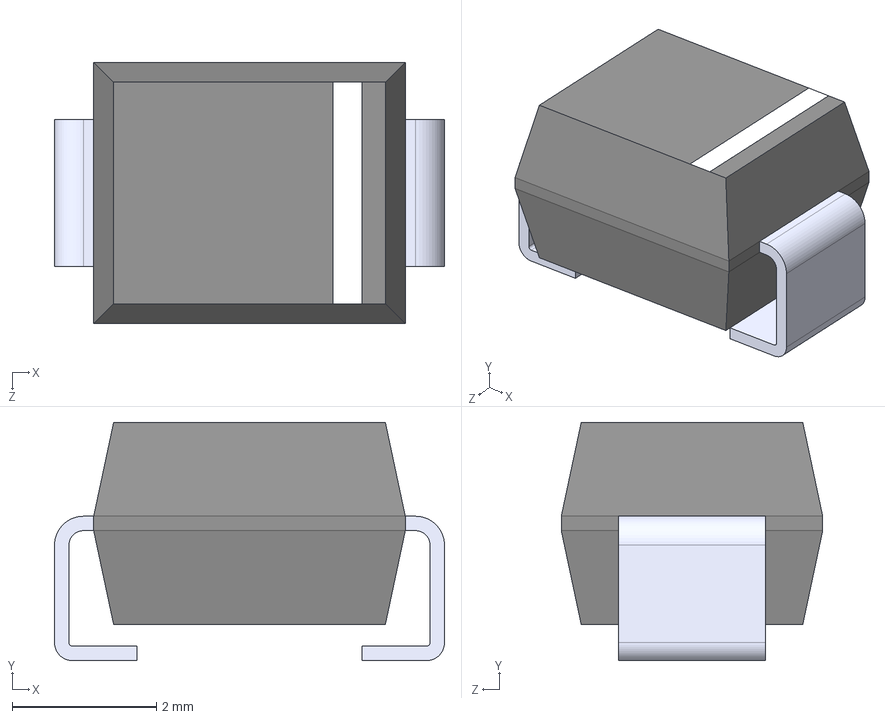
[picture p14: CAD file, 2025-03-09]
kicad-libraries/3D Models/LSM115JE3_TR13.STEP
5.40 x 3.30 x 3.62 mm
