RoboJackets/roboracing-electrical/sedani/estop/Eagle Files/e-stop-radio.dxf

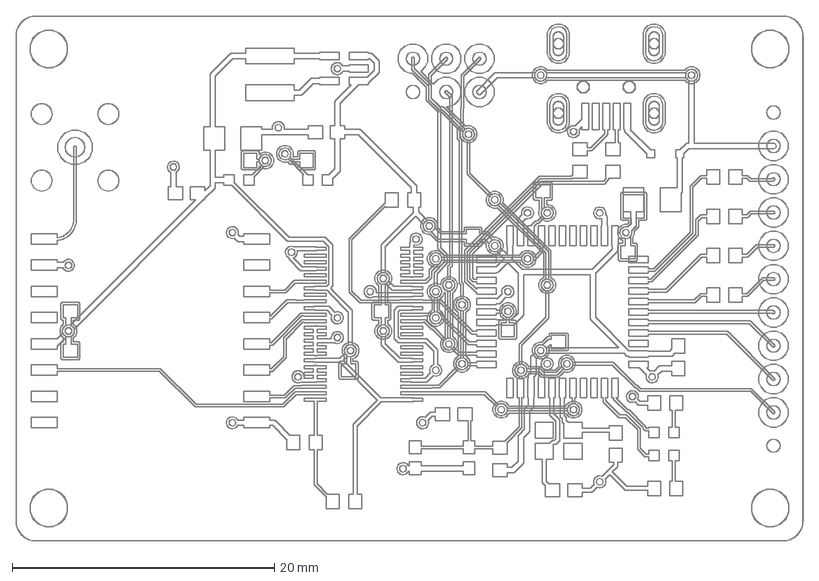
[picture p15: CAD file, 2020-05-11]
sedani/estop/Eagle Files/e-stop-radio.dxf
60.0 x 40.0 mm
