RoboJackets/roboracing-electrical/kicad-libraries/3D Models/RELAY_AGQ_PAN.step

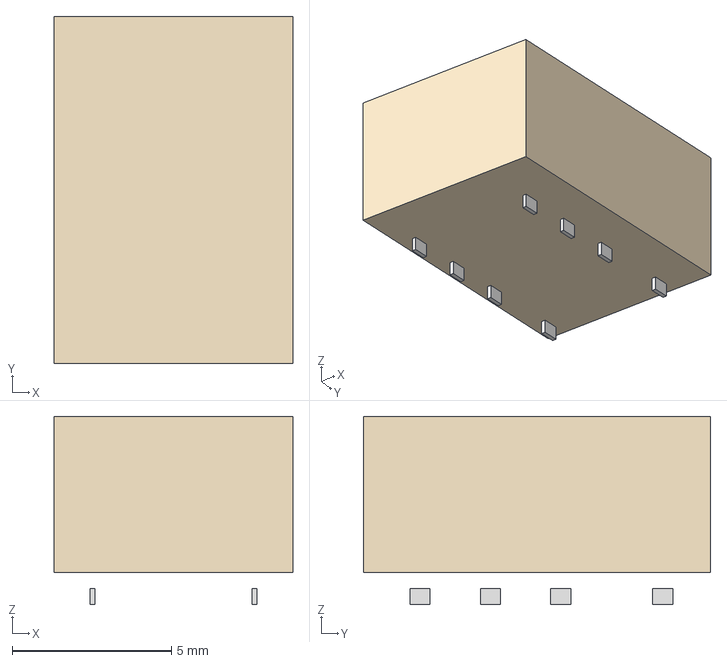
[picture p16: CAD file, 2025-03-09]
kicad-libraries/3D Models/RELAY_AGQ_PAN.step
7.49 x 10.9 x 5.92 mm
