RoboJackets/roboracing-electrical/(list of files, cad)

Other CAD files:
rigatoni/Steering/Mounting CAD/92000A114_18-8 SS METRIC PAN HEAD PHIL MACHINE SCREW.ipt
rigatoni/Steering/Mounting CAD/92000A120_18-8 SS METRIC PAN HEAD PHIL MACHINE SCREW.ipt
rigatoni/Steering/Mounting CAD/92095A208_18-8 SS BUTTON-HEAD SOCKET CAP SCREW.ipt
rigatoni/Steering/Mounting CAD/93657A207_NYLON UNTHREADED SPACER.ipt
rigatoni/Steering/Mounting CAD/95947A509_ALUM FEM THRDED HEX STANDOFF.ipt
rigatoni/Steering/Mounting CAD/Aluminum_Heatsink_Base.ipt
rigatoni/Steering/Mounting CAD/CL57T_Stepper_Driver.ipt
rigatoni/Steering/Mounting CAD/M3_5mm_Insert.ipt
rigatoni/Steering/Mounting CAD/OldVersions/92000A120_18-8 SS METRIC PAN HEAD PHIL MACHINE SCREW.0001.ipt
rigatoni/Steering/Mounting CAD/OldVersions/Aluminum_Heatsink_Base.0007.ipt
rigatoni/Steering/Mounting CAD/OldVersions/M3_5mm_Insert.0003.ipt
rigatoni/Steering/Mounting CAD/OldVersions/Plastic_Bracket.0016.ipt
rigatoni/Steering/Mounting CAD/OldVersions/Steering Electrical Assembly.0014.iam
rigatoni/Steering/Mounting CAD/OldVersions/Steering.brd.0008.ipt
rigatoni/Steering/Mounting CAD/OldVersions/ethernet_poe.brd.0003.ipt
rigatoni/Steering/Mounting CAD/Plastic_Bracket.ipt
rigatoni/Steering/Mounting CAD/Steering Electrical Assembly.iam
rigatoni/Steering/Mounting CAD/Steering.brd.ipt
rigatoni/Steering/Mounting CAD/ethernet_poe.brd.ipt
