RoboJackets/roboracing-electrical/sedani/estop/Specs/remote-wiring-diagram.png

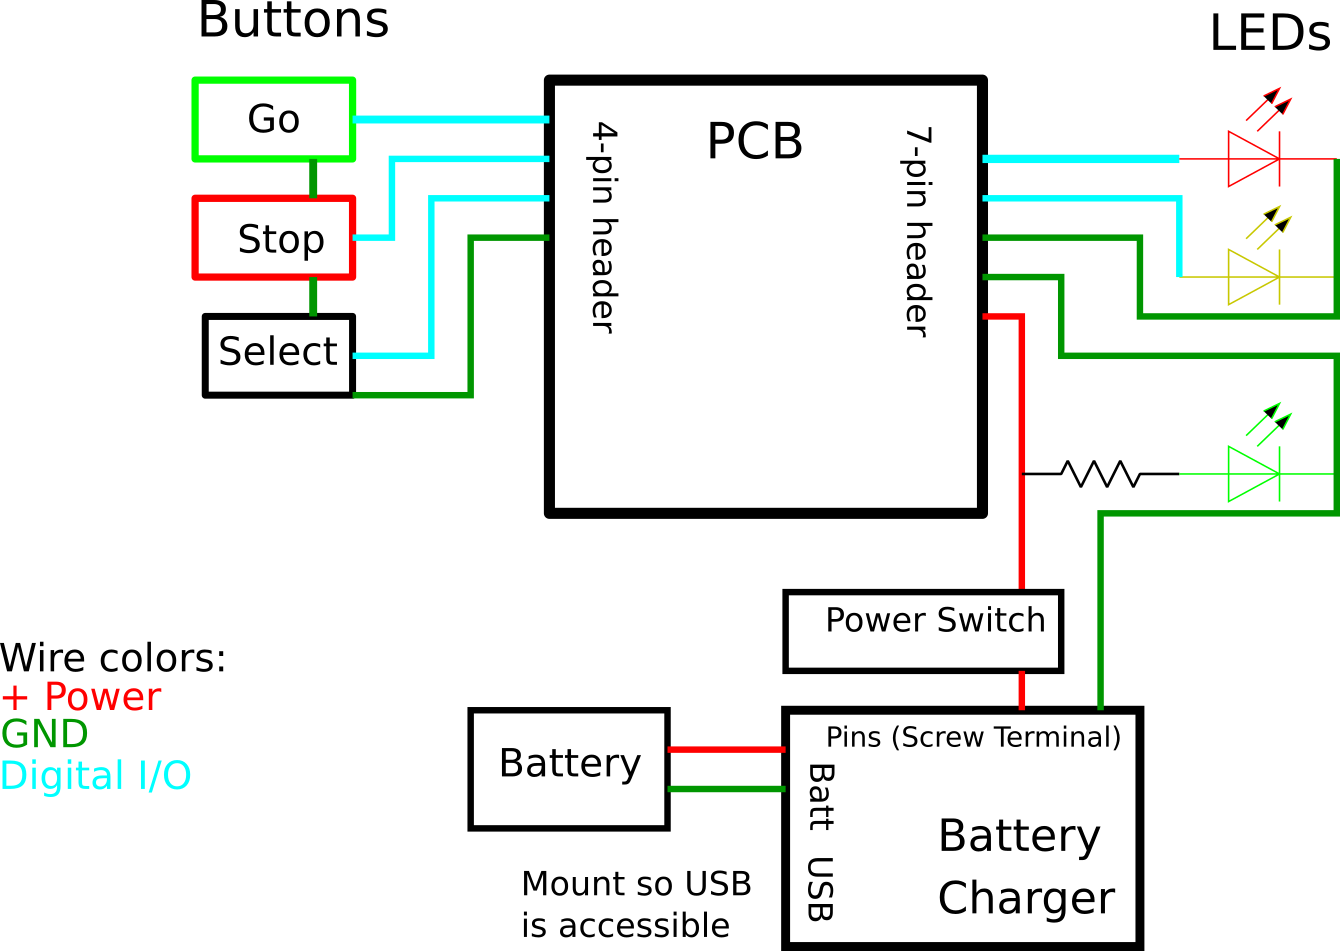
sedani/estop/Specs/remote-wiring-diagram.png
