RoboJackets/roboracing-electrical/(threads)

Thread 10 (2018-12-02):

Power source requirements will be different for Sedani and Bigolii

Iwilsonp, 2018-12-02:
Make sure it can handle both

Iwilsonp, 2018-12-02:
Added a 5V terminal for regulated 5V on Bigoli that bypasses 5V regulator. Don't populate 5V regulator on Bigoli except for decoupling caps.

Closed 2018-12-02.

Thread 11 (2018-12-02):

Reverse Polarity Protection on power input

Iwilsonp, 2018-12-02:

Iwilsonp, 2018-12-02:
Can use an ideal diode to save on board complexity over P-FET circuit and voltage drop over Schottky diode.

jfkunz, 2018-12-04:
added diode for regulated input and mosfet protection for unregulated input

Closed 2018-12-04.

Thread 13 (2018-12-02):

Don’t run LEDs off of SDA and SCL lines

Iwilsonp, 2018-12-02:
Have it connected to an interrupt run when a packet is received

Iwilsonp, 2018-12-02:
Might be able to use wire.onRecieve to use an interrupt to toggle an LED whenever we get a packet.

jfkunz, 2018-12-04:
Added I2C activity led

Closed 2018-12-04.

Thread 19 (2018-12-02):

Silkscreen might not get printed

Iwilsonp, 2018-12-02:
Could be too close to the edge.

Closed 2019-01-10.

Thread 20 (2018-12-02):

Missing Decoupling caps between VCC1_3.3 and GND; Between 2 and 4 0.1uF caps between VCC1_3.3V and GND

kwaddles, 2018-12-02:

Closed 2019-03-24.

Thread 26 (2018-12-02):

USB D+ and D- routing

Iwilsonp, 2018-12-02:
Must be same length and must be parallel. We can use Eagle's Meander tool and guide here: https://www.autodesk.com/products/eagle/blog/route-differential-pairs/

Iwilsonp, 2018-12-07:
Fixed it in the schematic, not routed yet.

Closed 2019-01-08.

Thread 38 (2018-12-02):

Swap order of remote and button E-STOP

Iwilsonp, 2018-12-02:

Iwilsonp, 2019-01-15:
Done.

Closed 2019-01-15.

Thread 43 (2018-12-02):

Verify power input diode

Iwilsonp, 2018-12-02:

jspall0327, 2019-01-14:
Need to prevent the PC from powering the 5V rail.

Iwilsonp, 2019-01-15:
Done. MCU USB power cannot power board.

Closed 2019-01-15.

Thread 8 (2018-12-02):

External Oscillator for more speed on SPI line

Iwilsonp, 2018-12-02:
Not sue why - isn't this exactly what the crystal is?

jfkunz, 2018-12-04:
Crystal already there

Closed 2018-12-04.

Thread 53 (2019-01-06):

Add reset pushbutton on board or terminals to external pushbutton

jspall0327, 2019-01-06:
When the board bricks, we need to easily reset it. Nice if we could put a pushbutton reset on the enclosure/hole that we can put pointy thing to reset it.

Iwilsonp, 2019-01-13:
Done

Closed 2019-01-13.

Thread 62 (2019-02-22):

Swap Enable LED direction so ground faces outside

akeener97, 2019-02-22:

Closed 2019-02-28.

Thread 68 (2019-03-05):

Reverse Lidar Header Pinout to Match Color Scheme

akeener97, 2019-03-05:

Closed 2019-03-12.

Thread 69 (2019-03-10):

Change fuse package

Iwilsonp, 2019-03-10:
The fuse package on the 3.1 control board is incorrect. Should be changed to 1812.

jspall0327, 2019-04-29:
Corrected in v3.2

Closed 2019-04-29.

Thread 70 (2019-03-10):

Get diode with right package

Iwilsonp, 2019-03-10:
Need to order a new Schottky diode with the right package for the diode that prevents the Pro Micro from backdriving the rest of the 5V system.

jspall0327, 2019-04-29:
Corrected on v3.2

Closed 2019-04-29.

Thread 76 (2019-03-28):

Correct Silkscreen issues for Sedani

jspall0327, 2019-03-28:

jspall0327, 2019-04-29:
Resolved in v3.2

Closed 2019-04-29.

Thread 85 (2019-04-27):

3.3V Regulator Feedback on Wrong Side of Inductor

akeener97, 2019-04-27:

Iwilsonp, 2019-05-03:
Done in v1.1

Closed 2019-05-03.

Thread 88 (2019-04-29):

Make it easier to not include level shifter on remote board

jspall0327, 2019-04-29:

Iwilsonp, 2019-05-03:
Changed ATMEGA to be 5V, so done. (Current level shifter is needed for both remote and car boards).

Closed 2019-05-03.

Thread 94 (2019-05-02):

Fix MC Reset PB Pin to Signal Connections

akeener97, 2019-05-02:

Thread 101 (2019-06-04):

Connect reset line from RFM69HCW to DIO on Atmega

jspall0327, 2019-06-04:
3.3V reset line. Note- Atmega is running at 5V so should voltage divide

Thread 103 (2019-06-04):

Replace existing level shifter with one that works with SPI

jspall0327, 2019-06-04:

Thread 107 (2019-09-16):

Use symbol for Tri-state Buffer and Inverter in Control Board Schematic

varunm99, 2019-09-16:
Currently the two above named circuit components are represented by boxes.  However they have actual circuit symbols.  The parts for these components need to be edited in the library file and updated in the schematic.
