RoboJackets/roboracing-electrical/rigatoni/distributed-vision/DistributedVision.pdf

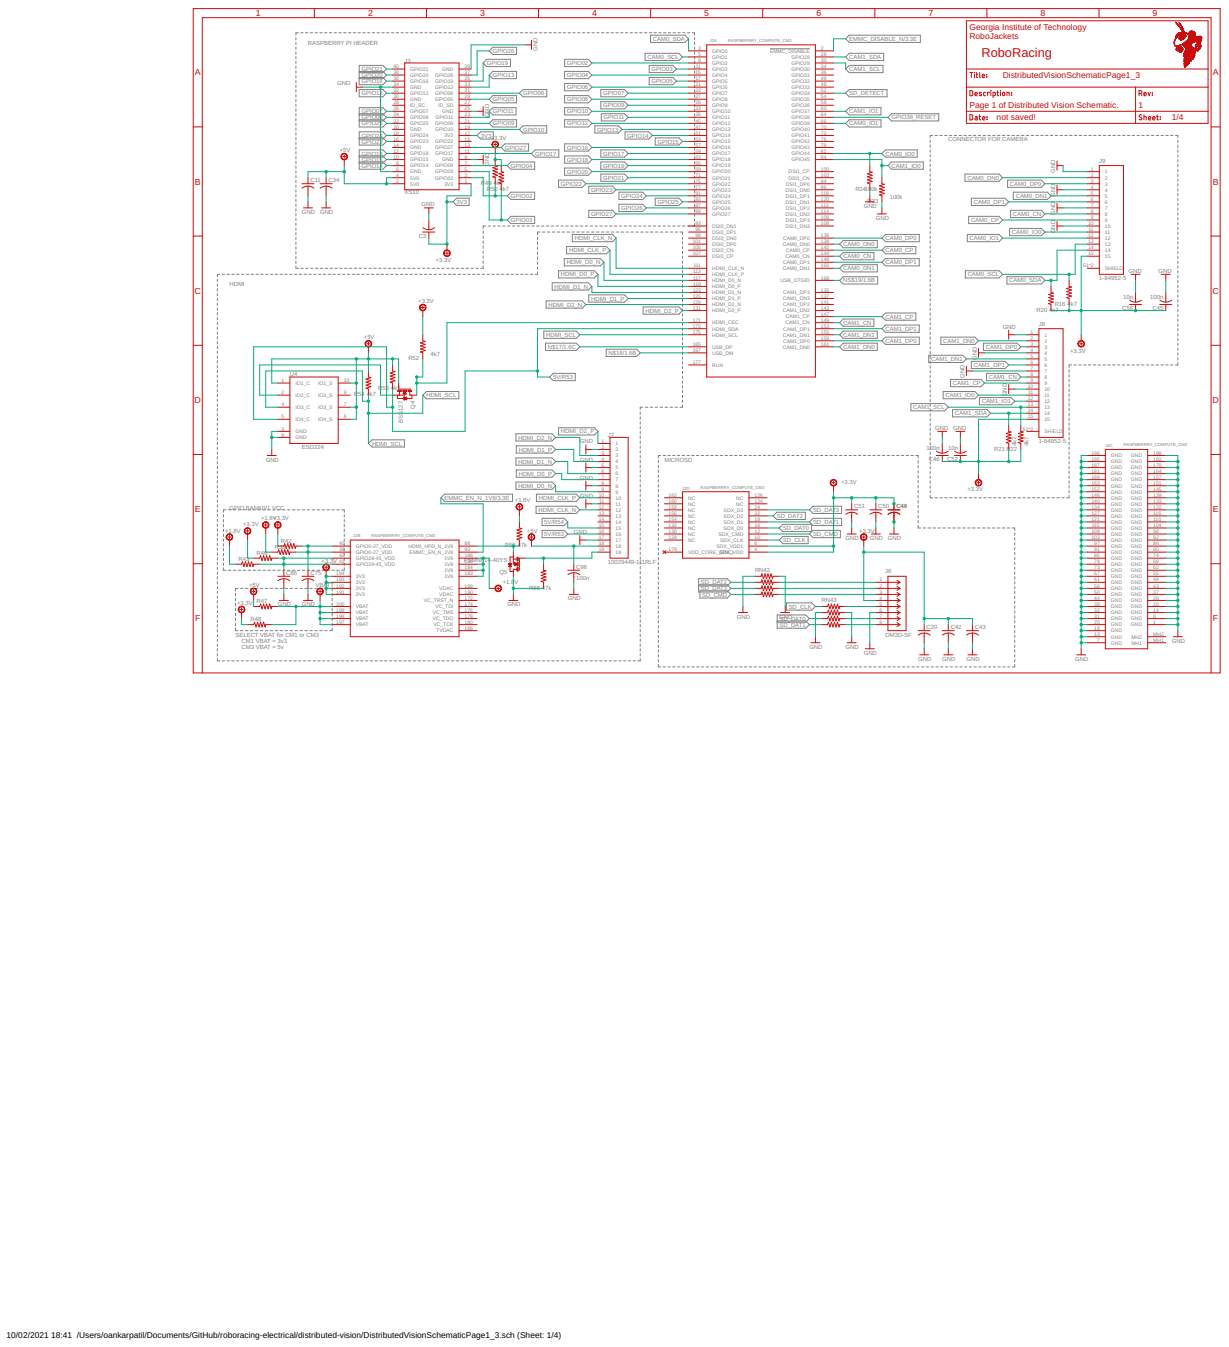
[picture p18: page 1]

Georgia Institute of Technology
RoboJackets
RoboRacing

SELECT VBAT for CM1 or CM3
CM1 VBAT = 3v3
CM3 VBAT = 5v

10/02/2021 18:41 /Users/oankarpatil/Documents/GitHub/roboracing-electrical/distributed-vision/DistributedVisionSchematicPage1_3.sch (Sheet: 1/4)

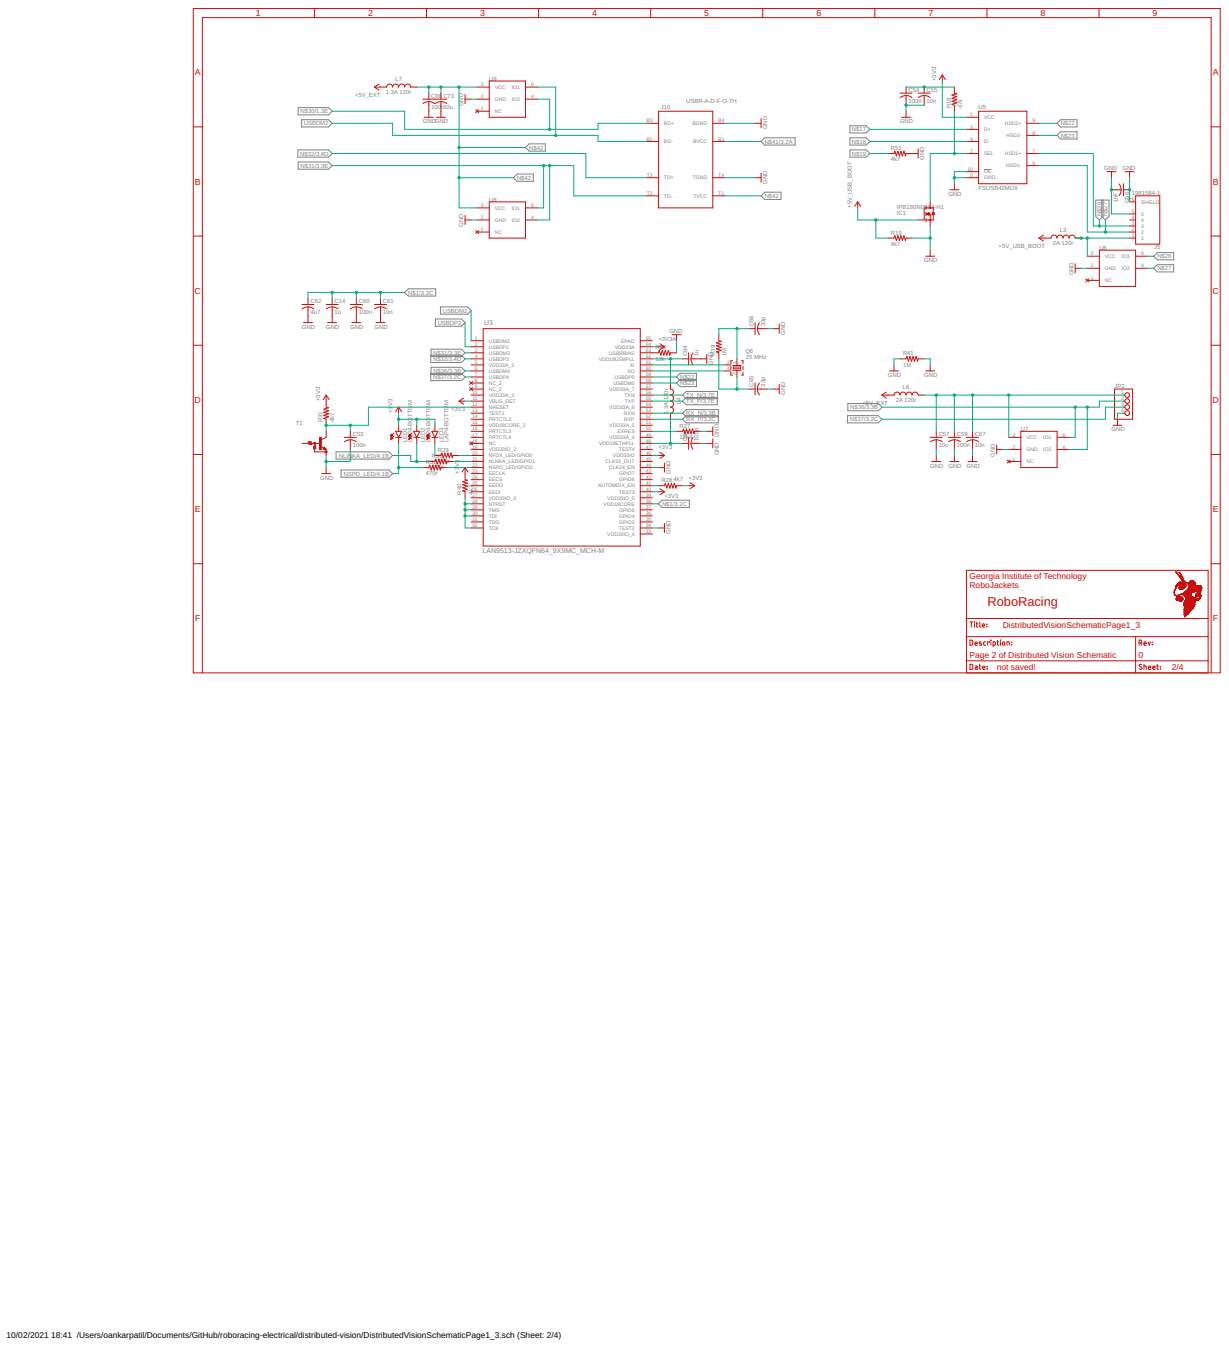
[picture p19: page 2]

USBR-A-D-F-O-TH GND GND

Georgia Institute of Technology
RoboJackets
RoboRacing

10/02/2021 18:41 /Users/oankarpatil/Documents/GitHub/roboracing-electrical/distributed-vision/DistributedVisionSchematicPage1_3.sch (Sheet: 2/4)

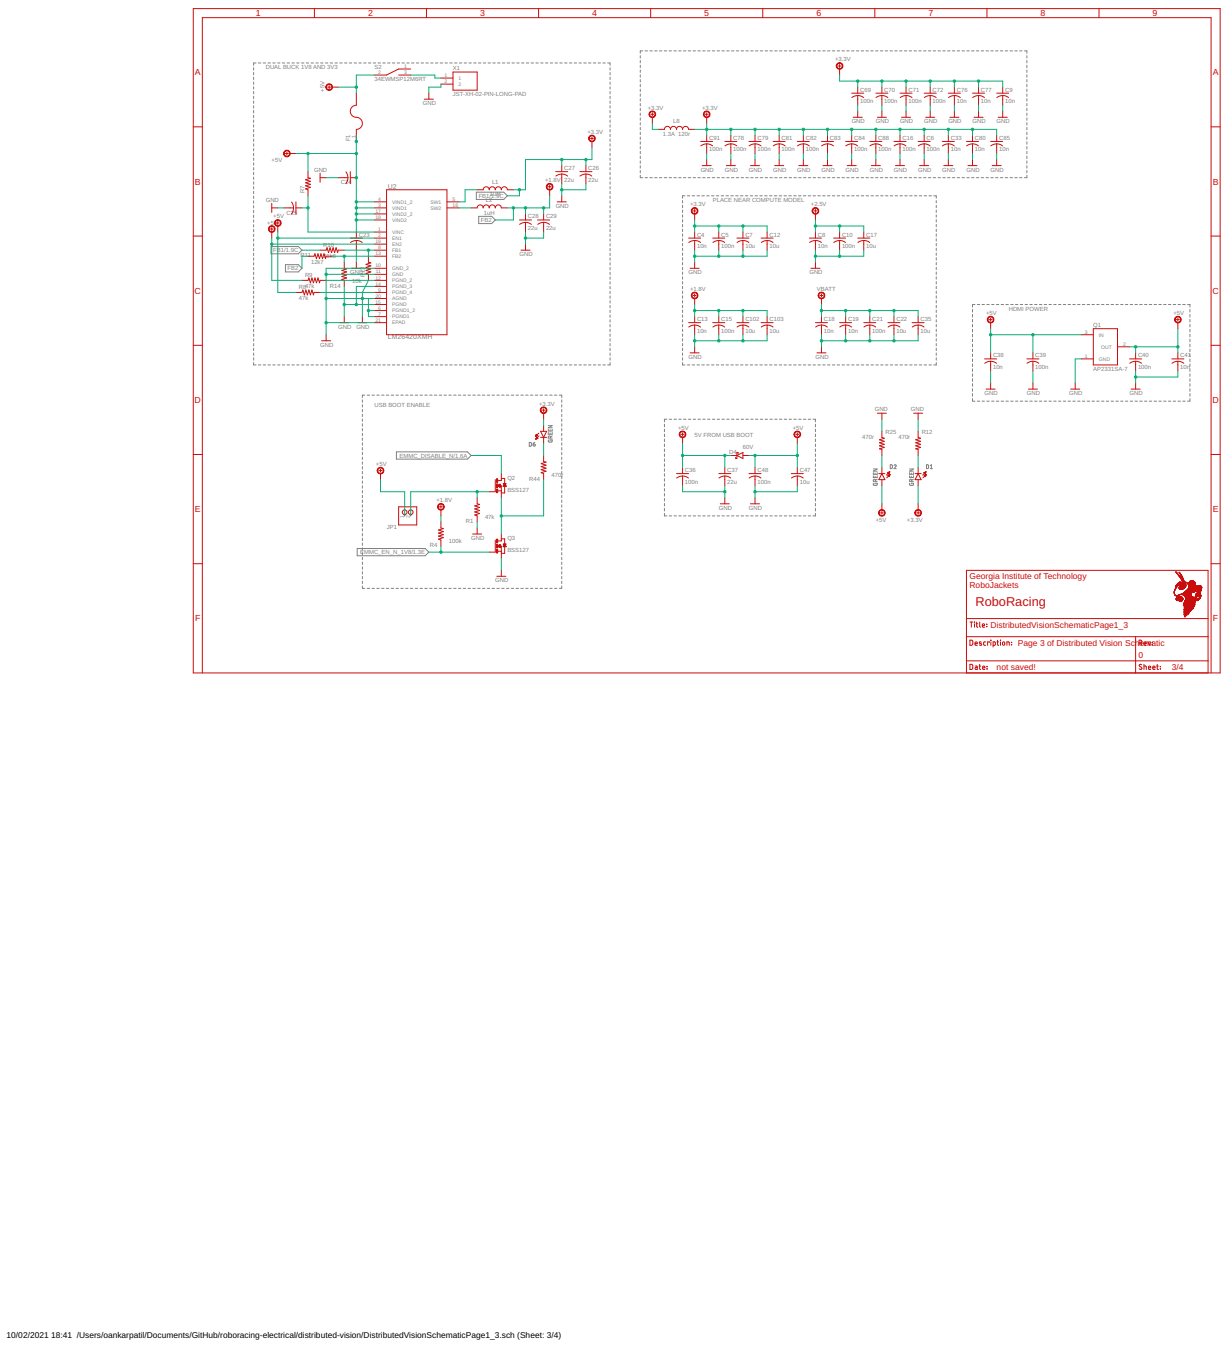
[picture p20: page 3]

PLACE NEAR COMPUTE MODEL

Georgia Institute of Technology
RoboJackets
RoboRacing

DistributedVisionSchematicPage1_3
Page 3 of Distributed Vision Schematic

10/02/2021 18:41 /Users/oankarpatil/Documents/GitHub/roboracing-electrical/distributed-vision/DistributedVisionSchematicPage1_3.sch (Sheet: 3/4)

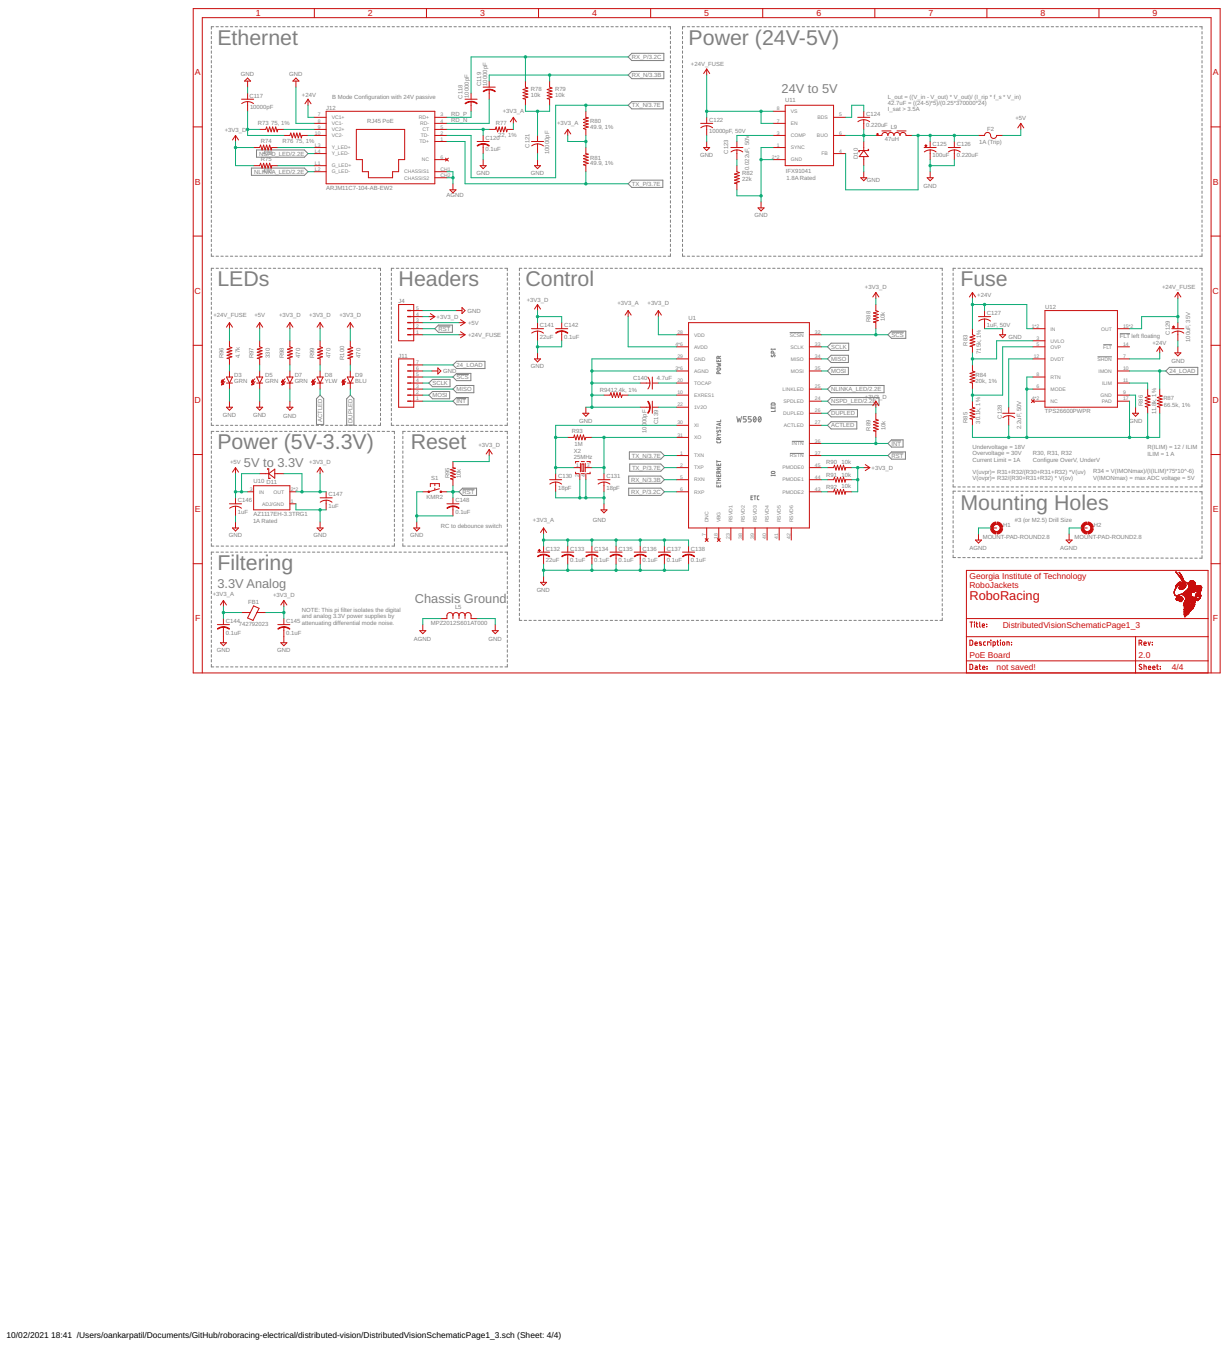
[picture p21: page 4]

B Mode Configuration with 24V passive

R34 = V(IMONmax)/(I(ILIM)*75*10^-6)
V(IMONmax) = max ADC voltage = 5V

RC to debounce switch

Georgia Institute of Technology
RoboJackets
RoboRacing

NOTE: This pi filter isolates the digital and analog 3.3V power supplies by attenuating differential mode noise.

10/02/2021 18:41 /Users/oankarpatil/Documents/GitHub/roboracing-electrical/distributed-vision/DistributedVisionSchematicPage1_3.sch (Sheet: 4/4)
