RoboJackets/roboracing-electrical/archive/2016-2017/macaroni/doc/RoboRacing RC Block Diagram.pdf

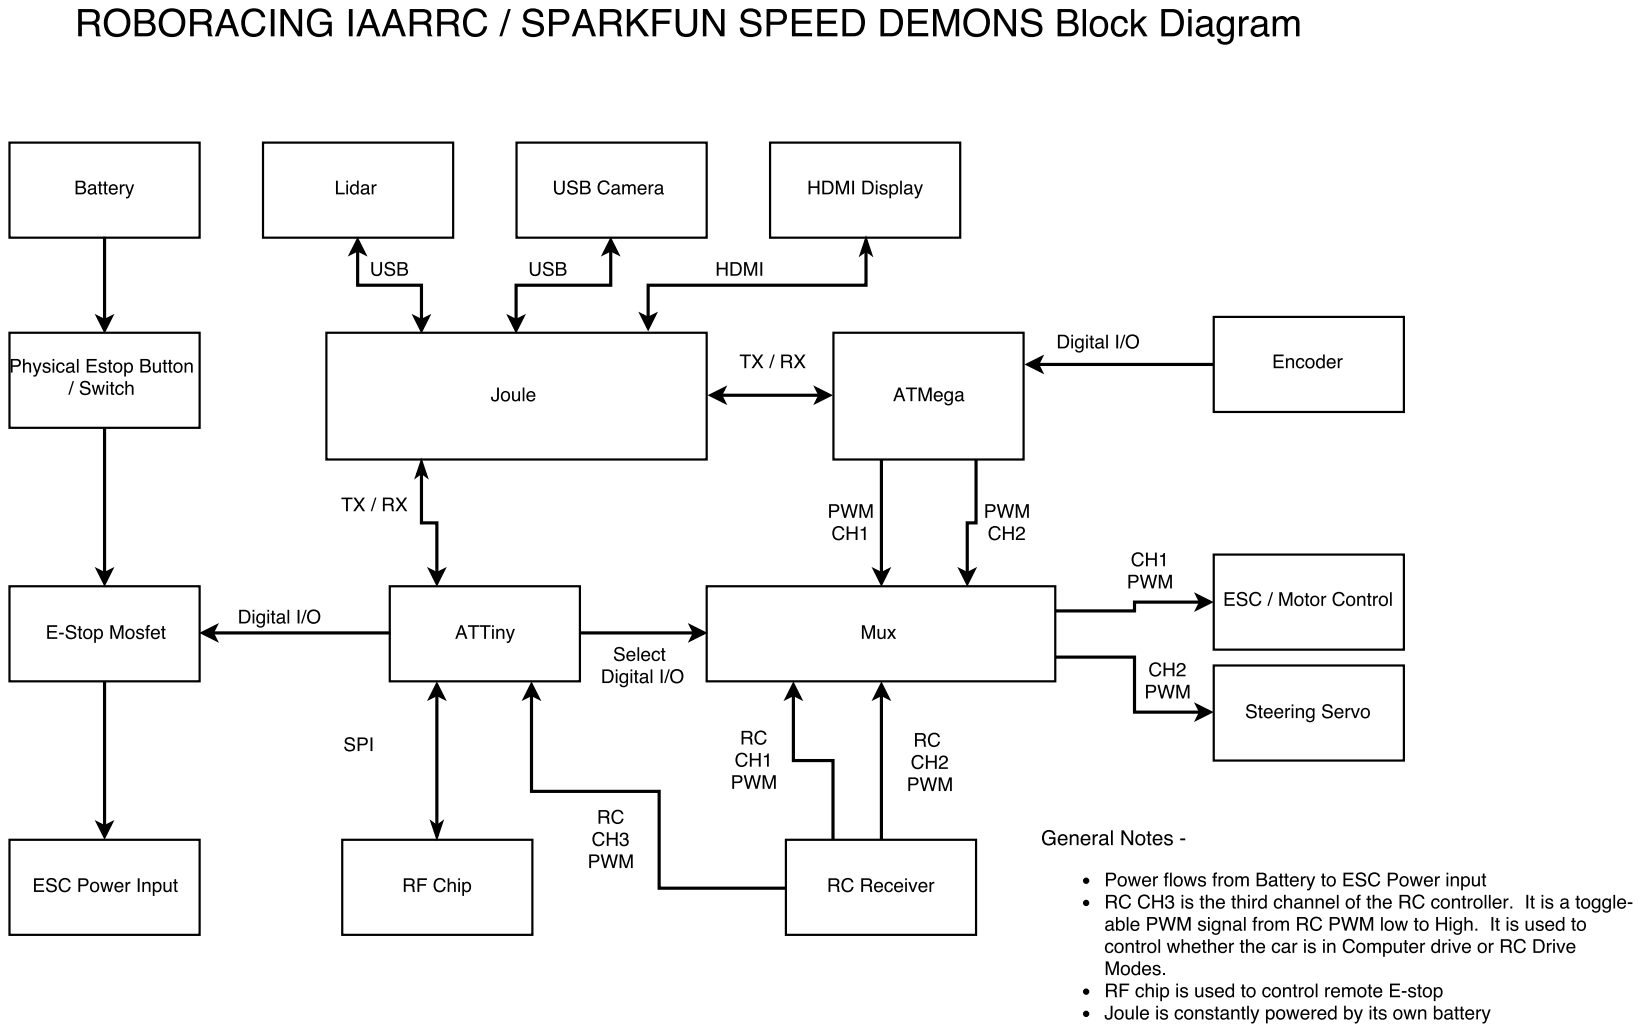
[picture p22: page 1]
