RoboJackets/roboracing-electrical/rigatoni/2024-drive-steering/2024-drive-steering.kicad_pcb

## KiCad design rigatoni/2024-drive-steering/2024-drive-steering.kicad_pcb (2025-03-09)

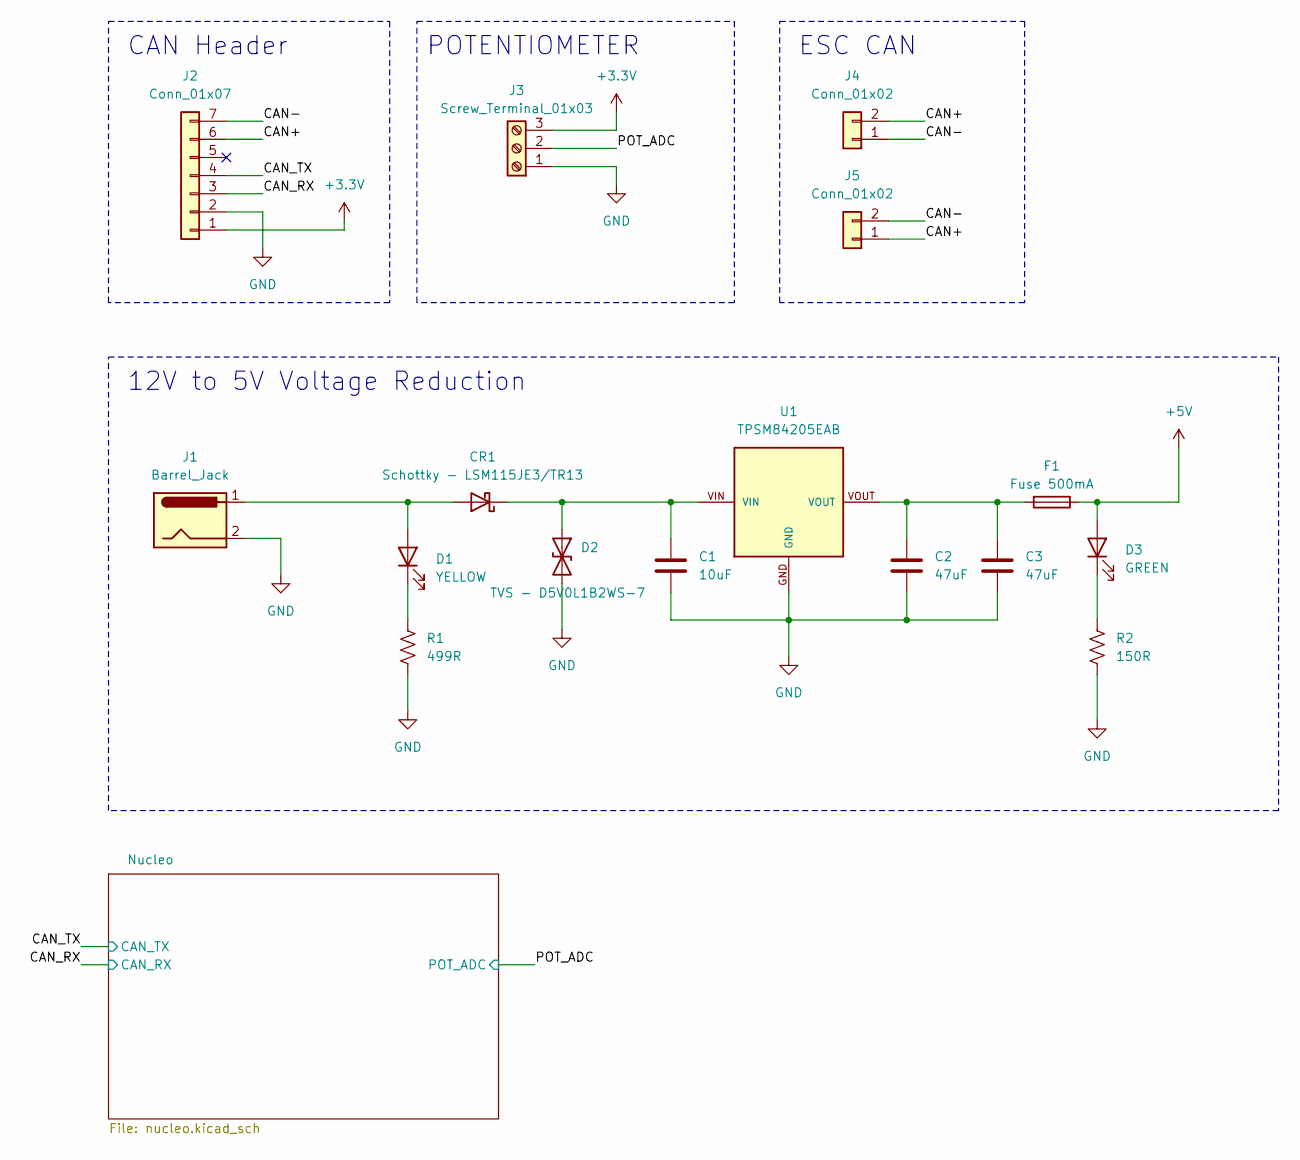
[picture p23: schematic 2024-drive-steering.kicad_sch, Drive/Steering Board]

Parts:
C1: 10uF; C_0805_2012Metric_Pad1.18x1.45mm_HandSolder; Part Name CL21A106KOQNNNE; DigiKey Part Number 1276-1096-1-ND
C2, C3: 47uF; C_1210_3225Metric_Pad1.33x2.70mm_HandSolder; Part Name CL32A476KOJNNNE; DigiKey Part Number 1276-3376-1-ND
CR1: Schottky - LSM115JE3/TR13; DO-214BA_MCH; Part Description Diode 15 V 1A Surface Mount DO-214BA; DigiKey Part Number 150-LSM115JE3/TR13CT-ND
D1: YELLOW; LED_0603_1608Metric_Pad1.05x0.95mm_HandSolder; Part Name 150060YS75000; DigiKey Part Number 732-4981-1-ND
D2: TVS - D5V0L1B2WS-7; D_SOD-323_HandSoldering; Part Description 14V Clamp 6A (8/20µs) Ipp Tvs Diode Sur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; DigiKey Part Number D5V0L1B2WS-7DICT-ND
D3: GREEN; LED_0603_1608Metric_Pad1.05x0.95mm_HandSolder; Part Name 150060GS75000; DigiKey Part Number 732-4971-1-ND
F1: Fuse 500mA; Fuse_0603_1608Metric_Pad1.05x0.95mm_HandSolder; Part Name C2Q 500; DigiKey Part Number 507-1089-1-ND
J1: Barrel_Jack; CUI_PJ-037A; Part Name PJ-037A; DigiKey Part Number CP-037A-ND
J2: Conn_01x07; CAN_Header
J3: Screw_Terminal_01x03; 282837-3_TYC; Part Name 282837-3; DigiKey Part Number A113321-ND
J4, J5: Conn_01x02; JST_PH_B2B-PH-K_1x02_P2.00mm_Vertical
R1: 499R; R_0603_1608Metric_Pad0.98x0.95mm_HandSolder; Part Name RC0603FR-07499RL; DigiKey Part Number 311-499HRCT-ND
R2: 150R; R_0603_1608Metric_Pad0.98x0.95mm_HandSolder; Part Name AC0603FR-07150RL; DigiKey Part Number YAG3568CT-ND
U1: TPSM84205EAB; Part Description Linear Regulator Replacement DC DC Conv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; DigiKey Part Number 296-47074-ND

Connections:
+3.3V: J2.1, J3.3; also elsewhere on the board
+5V: D3.2 (A), F1.1; also elsewhere on the board
/CAN+: J2.6, J4.2, J5.1
/CAN-: J2.7, J4.1, J5.2
/CAN_RX: J2.3; also elsewhere on the board
/CAN_TX: J2.4; also elsewhere on the board
/POT_ADC: J3.2; also elsewhere on the board
GND: C1.2, C2.2, C3.2, D2.2 (A2), J1.2, J2.2, J3.1, R1.1, R2.2, U1.GND; also elsewhere on the board
unnamed: C2.1, C3.1, F1.2, U1.VOUT
unnamed: CR1.2 (A), D1.2 (A), J1.1
unnamed: C1.1, CR1.1 (K), D2.1 (A1), U1.VIN
unnamed: D1.1 (K), R1.2
unnamed: D3.1 (K), R2.1

Notes on the sheet:
12V to 5V Voltage Reduction
ESC CAN
POTENTIOMETER
CAN Header

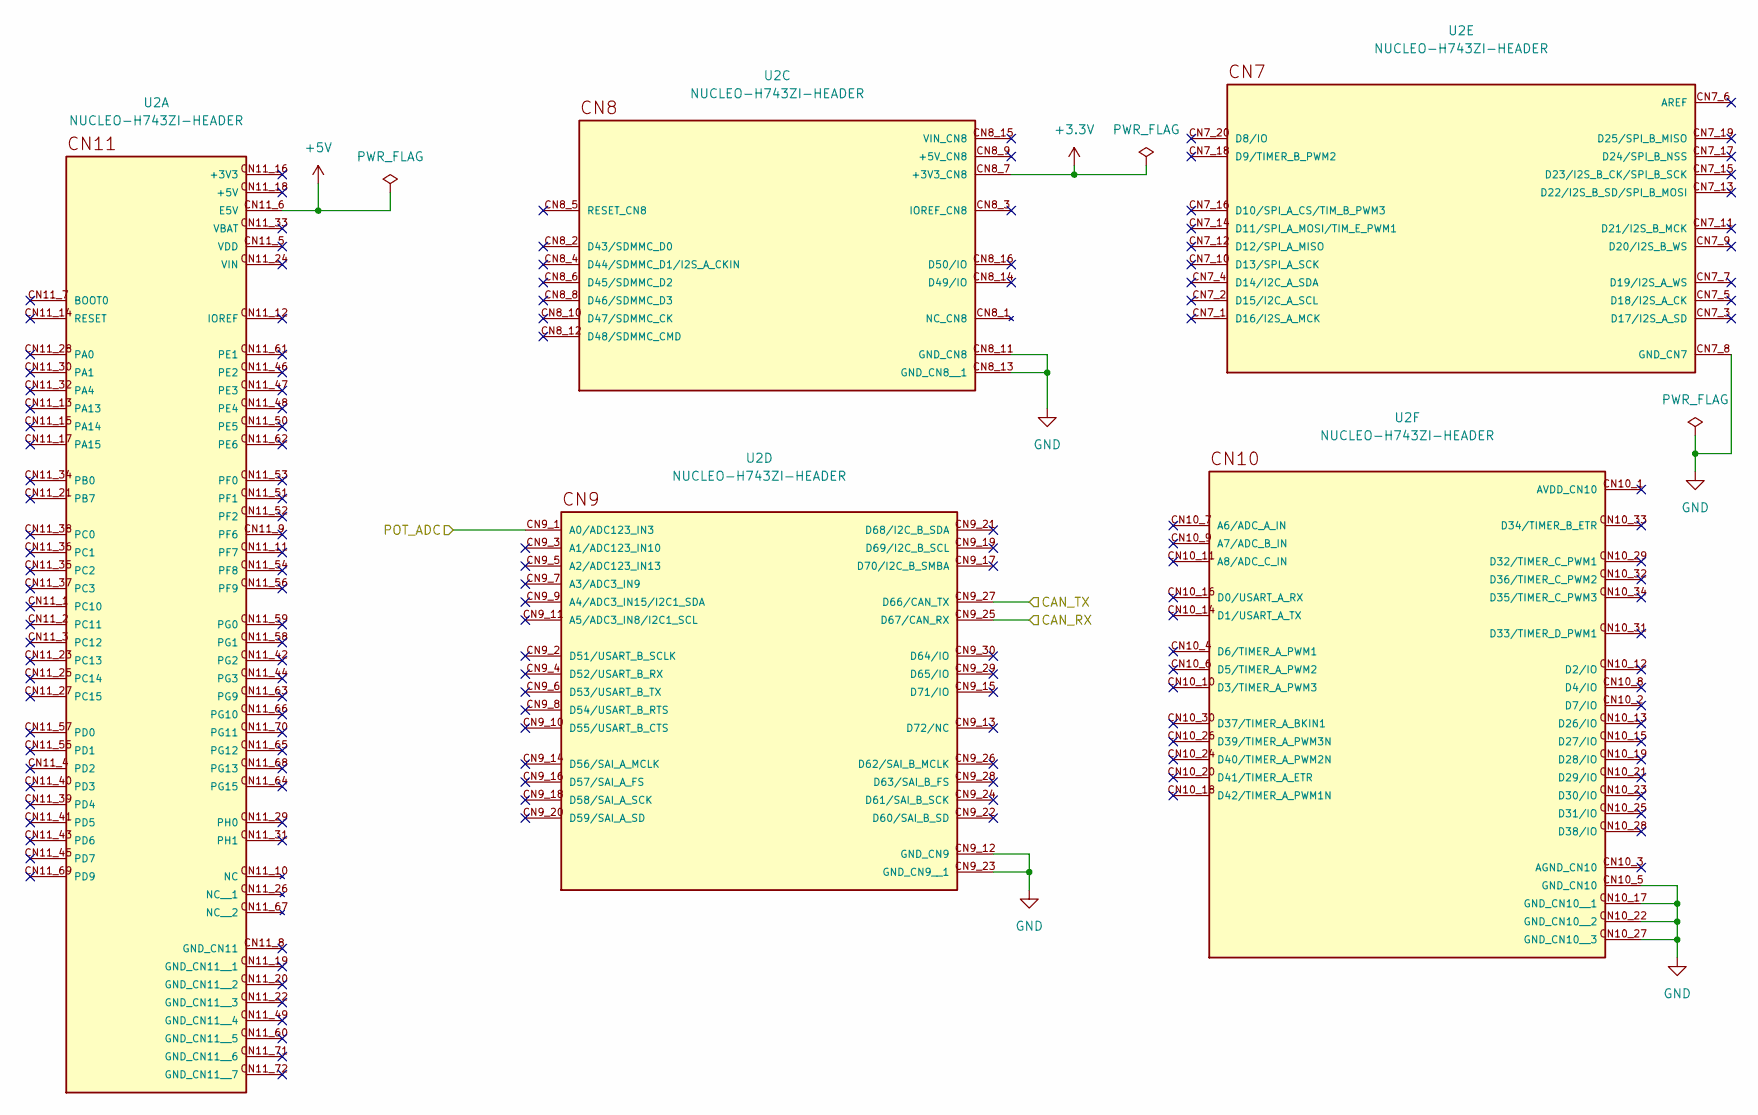
[picture p24: schematic nucleo.kicad_sch, Drive/Steering Board]

Parts:
U2: NUCLEO-H743ZI-HEADER; Custom-Nucleo144-Header; PARTREV 8

Connections:
+3.3V: U2.CN8_7 (+3V3_CN8); also elsewhere on the board
+5V: U2.CN11_6 (E5V); also elsewhere on the board
/CAN_RX: U2.CN9_25 (D67/CAN_RX); also elsewhere on the board
/CAN_TX: U2.CN9_27 (D66/CAN_TX); also elsewhere on the board
/POT_ADC: U2.CN9_1 (A0/ADC123_IN3); also elsewhere on the board
GND: U2.CN7_8 (GND_CN7), U2.CN8_11 (GND_CN8), U2.CN8_13 (GND_CN8__1), U2.CN9_12 (GND_CN9), U2.CN9_23 (GND_CN9__1), U2.CN10_5 (GND_CN10), U2.CN10_17 (GND_CN10__1), U2.CN10_22 (GND_CN10__2), U2.CN10_27 (GND_CN10__3); also elsewhere on the board

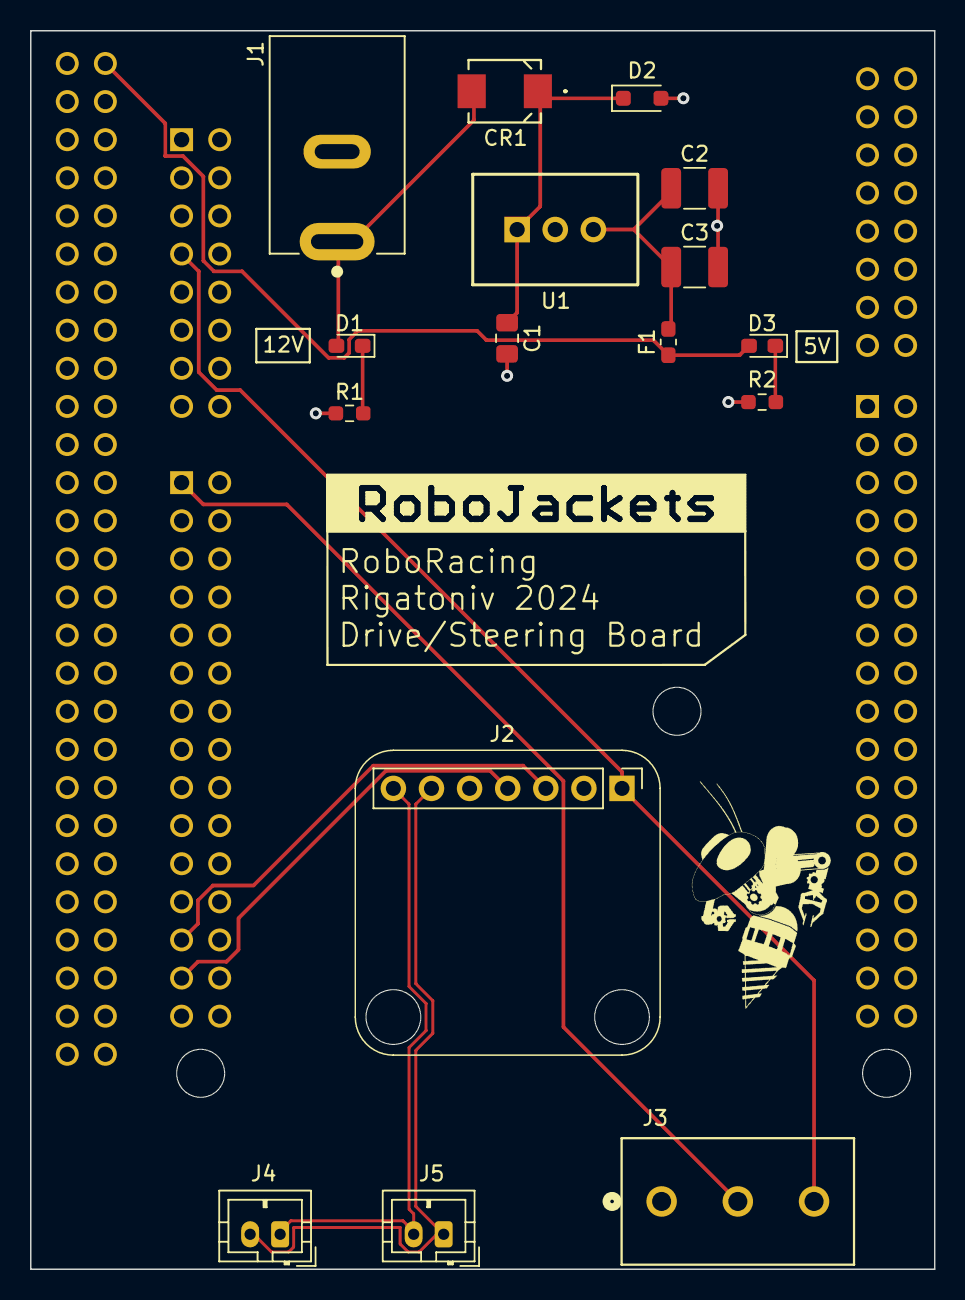
[picture p25: board 2024-drive-steering.kicad_pcb from above]

Board: 2 copper layers, 60.2 x 82.5 mm, 17 parts (0 on the bottom side), 13 nets.
