RoboJackets/roboracing-electrical/rigatoni/Steering/SteeringV2/SteeringV2.brd

## EAGLE design rigatoni/Steering/SteeringV2/SteeringV2.brd (2024-01-21)

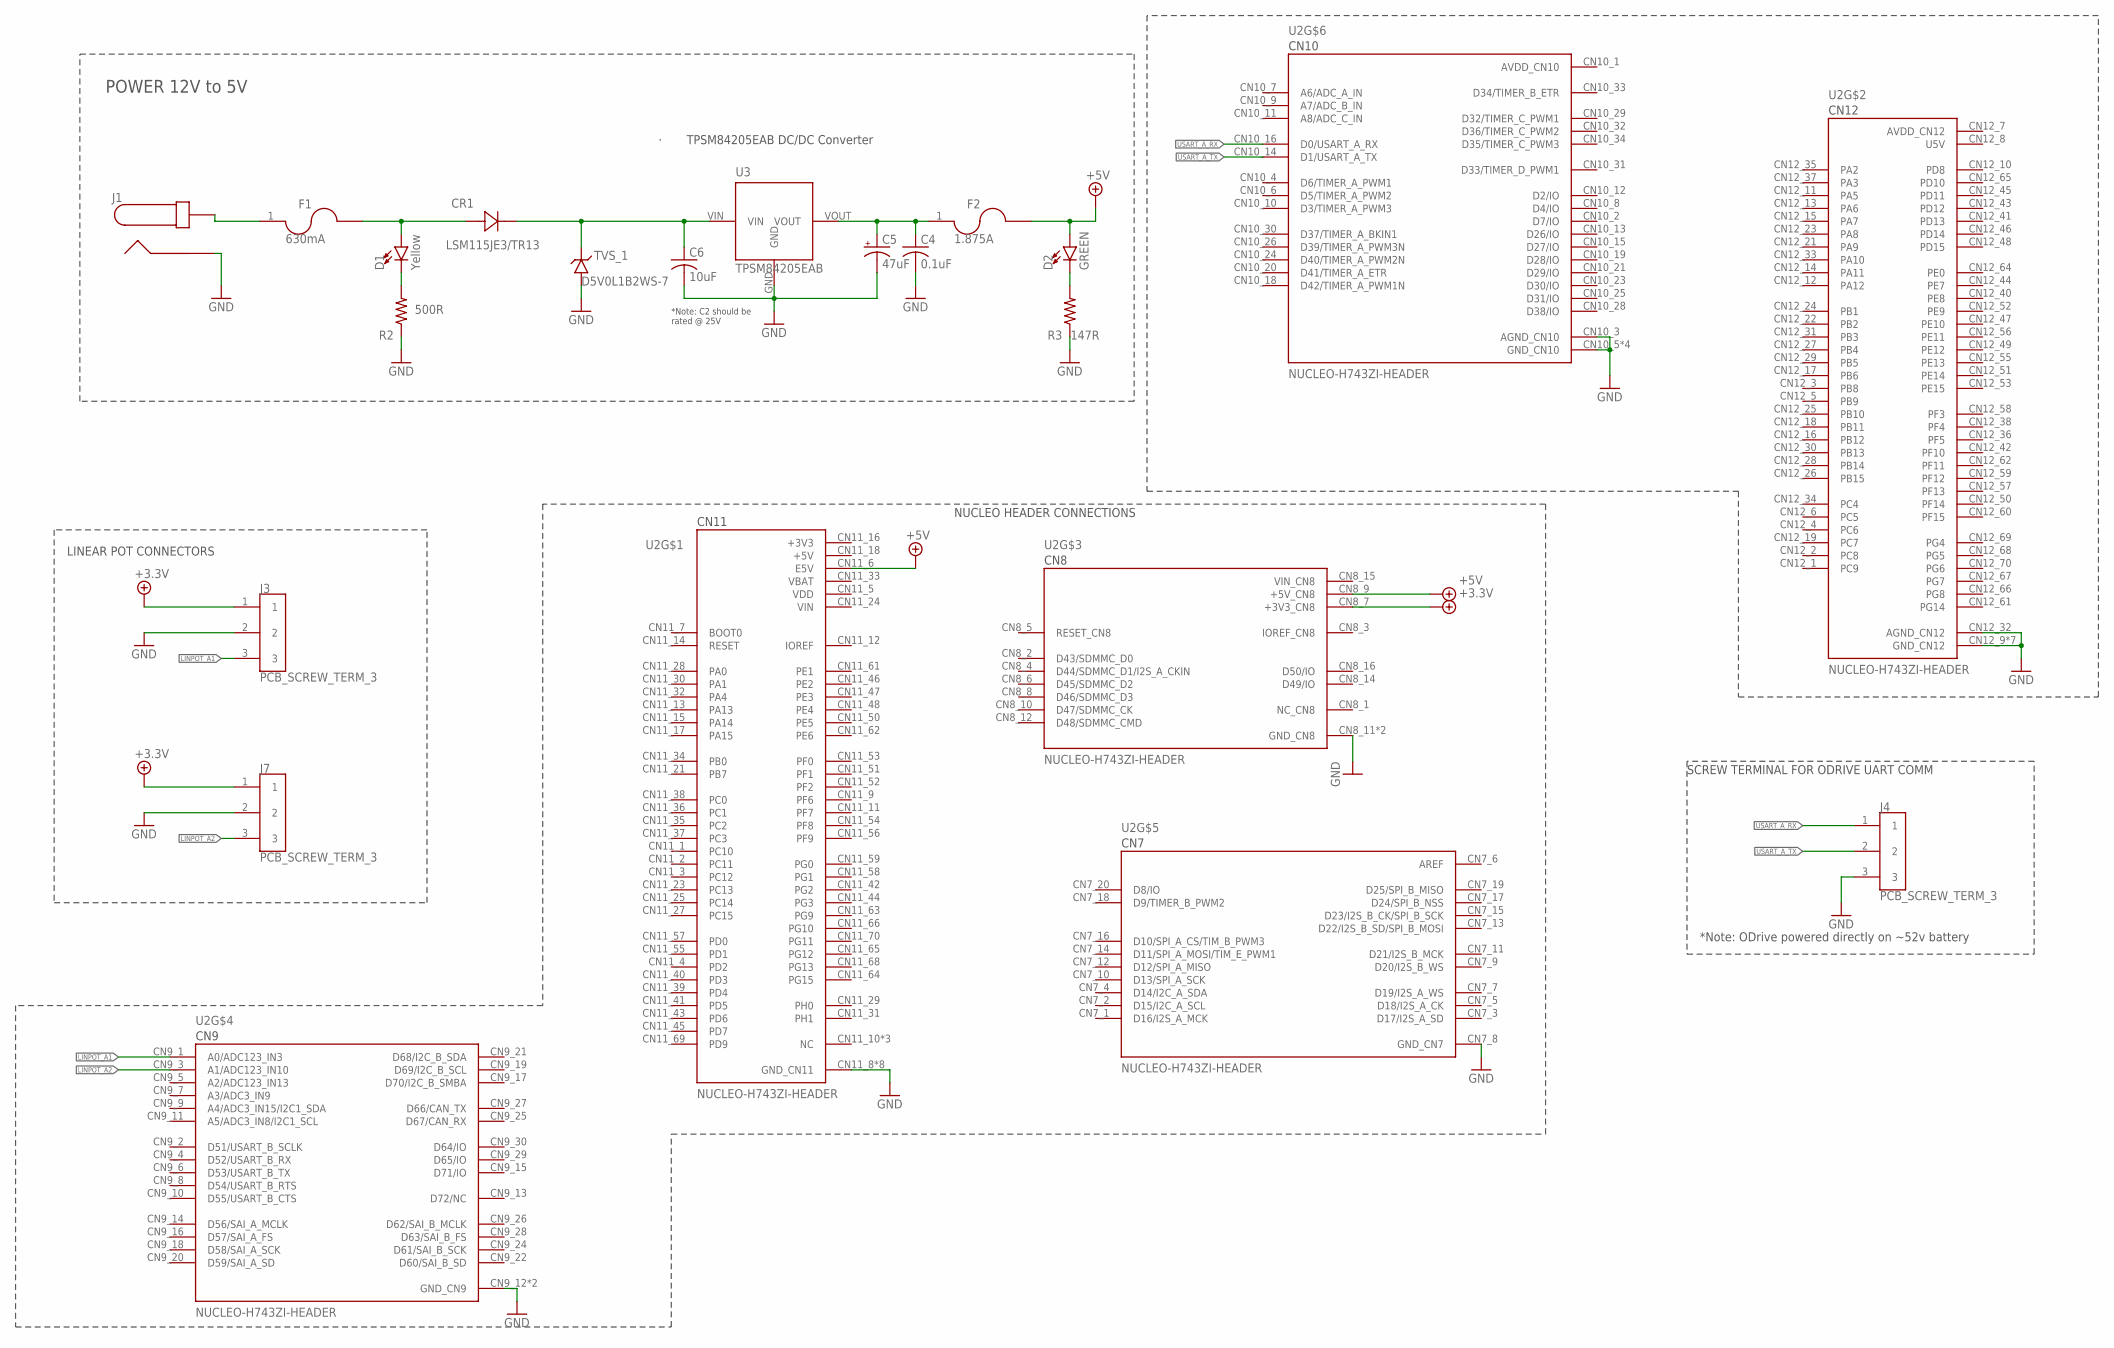
[picture p26: schematic SteeringV2.sch]

Parts:
C4: 0.1uF; C0805
C5: 47uF; EIA3528
C6: 10uF; C0805
CR1: LSM115JE3/TR13; DO-214BA_MCH
D1: Yellow; LED-0603
D2: GREEN; LED-1206
F1: 630mA; F0603
F2: 1.875A; F0603
J1: PJ-037A
J3, J4, J7: PCB_SCREW_TERM_3; SCREW_TERMINAL_PCB_CONN_3_POLE
R2: 500R; R0603
R3: 147R; R0603
TVS_1: D5V0L1B2WS-7; SOD-323
U2: NUCLEO-H743ZI-HEADER; MODULE_NUCLEO-H743ZI
U3: TPSM84205EAB

Connections:
5V_MAIN: C4.1, C5.A (+), F2.1, U3.VOUT
+3.3V: J3.1, J7.1, U2.CN8_7 (+3V3_CN8)
+3V3: U2.CN11_16 (+3V3)
+5V: D2.A, F2.2, U2.CN8_9 (+5V_CN8), U2.CN11_6 (E5V), U2.CN11_18 (+5V)
AREF: U2.CN7_6 (AREF)
AVDD_CN10: U2.CN10_1 (AVDD_CN10)
AVDD_CN12: U2.CN12_7 (AVDD_CN12)
GND: C4.2, C5.C (-), C6.2, J1.P$1 (2), J3.2, J4.3, J7.2, R2.1, R3.1, TVS_1.A, U2.CN7_8 (GND_CN7), U2.CN8_11 (GND_CN8), U2.CN8_13 (GND_CN8), U2.CN9_12 (GND_CN9), U2.CN9_23 (GND_CN9), U2.CN10_3 (AGND_CN10), U2.CN10_5 (GND_CN10), U2.CN10_17 (GND_CN10), U2.CN10_22 (GND_CN10), U2.CN10_27 (GND_CN10), U2.CN11_8 (GND_CN11), U2.CN11_19 (GND_CN11), U2.CN11_20 (GND_CN11), U2.CN11_22 (GND_CN11), U2.CN11_49 (GND_CN11), U2.CN11_60 (GND_CN11), U2.CN11_71 (GND_CN11), U2.CN11_72 (GND_CN11), U2.CN12_9 (GND_CN12), U2.CN12_20 (GND_CN12), U2.CN12_32 (AGND_CN12), U2.CN12_39 (GND_CN12), U2.CN12_54 (GND_CN12), U2.CN12_63 (GND_CN12), U2.CN12_71 (GND_CN12), U2.CN12_72 (GND_CN12), U3.GND
LINPOT_A1: J3.3, U2.CN9_1 (A0/ADC123_IN3)
LINPOT_A2: J7.3, U2.CN9_3 (A1/ADC123_IN10)
unnamed: CR1.2, D1.A, F1.2
unnamed: C6.1, CR1.1, TVS_1.C, U3.VIN
unnamed: F1.1, J1.P$2 (1)
unnamed: D1.C, R2.2
unnamed: D2.C, R3.2
U5V: U2.CN12_8 (U5V)
USART_A_RX: J4.1, U2.CN10_16 (D0/USART_A_RX)
USART_A_TX: J4.2, U2.CN10_14 (D1/USART_A_TX)
VBAT: U2.CN11_33 (VBAT)
VDD: U2.CN11_5 (VDD)
VIN: U2.CN11_24 (VIN)
VIN_CN8: U2.CN8_15 (VIN_CN8)

Notes on the sheet:
POWER 12V to 5V
NUCLEO HEADER CONNECTIONS
SCREW TERMINAL FOR ODRIVE UART COMM
LINEAR POT CONNECTORS
*Note: ODrive powered directly on ~52v battery
· TPSM84205EAB DC/DC Converter
*Note: C2 should be rated @ 25V

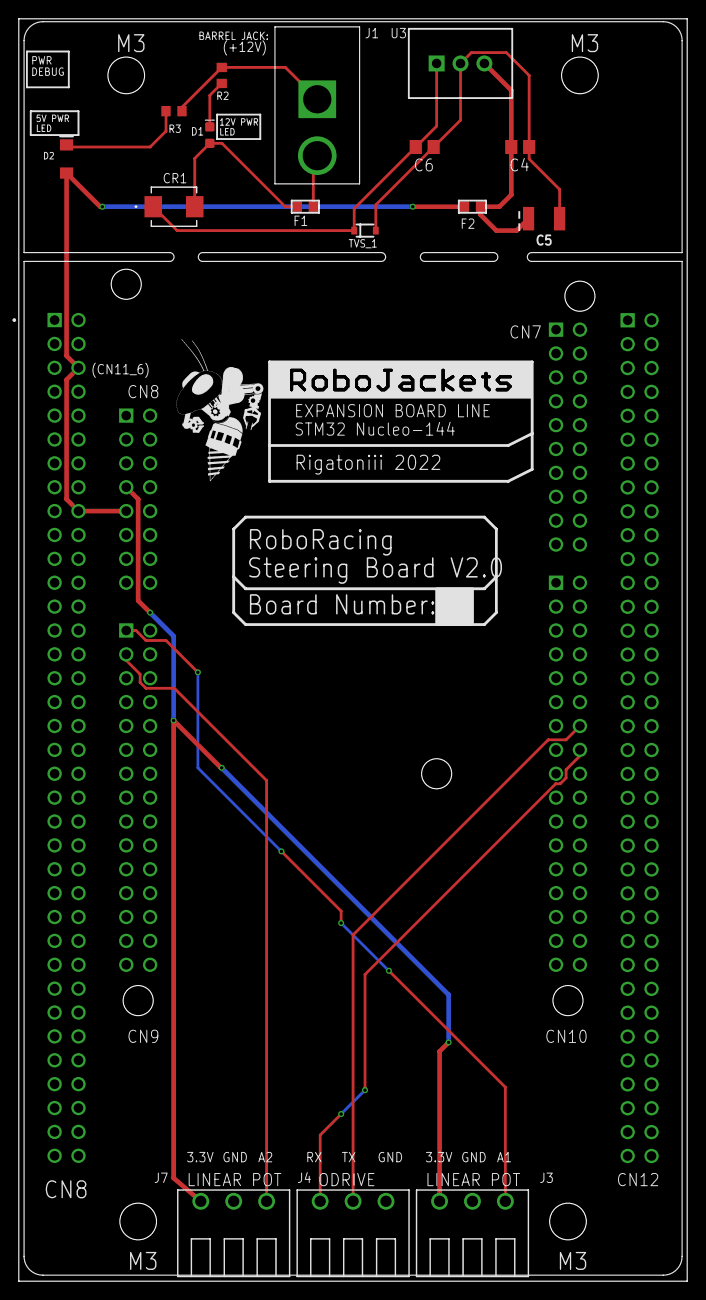
[picture p27: board SteeringV2.brd from above]

Board: 2 copper layers, 71.1 x 134.3 mm, 23 parts (0 on the bottom side), 13 nets.

Other parts of the board:
U$1: ROBOBUZZ_0.8X
U$2, U$3, U$4, U$5: STANDOFF-HOLE
U$6: ROBOJACKETS
