RoboJackets/roboracing-electrical/rigatoni/Steering/Steering.brd

## EAGLE design rigatoni/Steering/Steering.brd (2020-05-11)

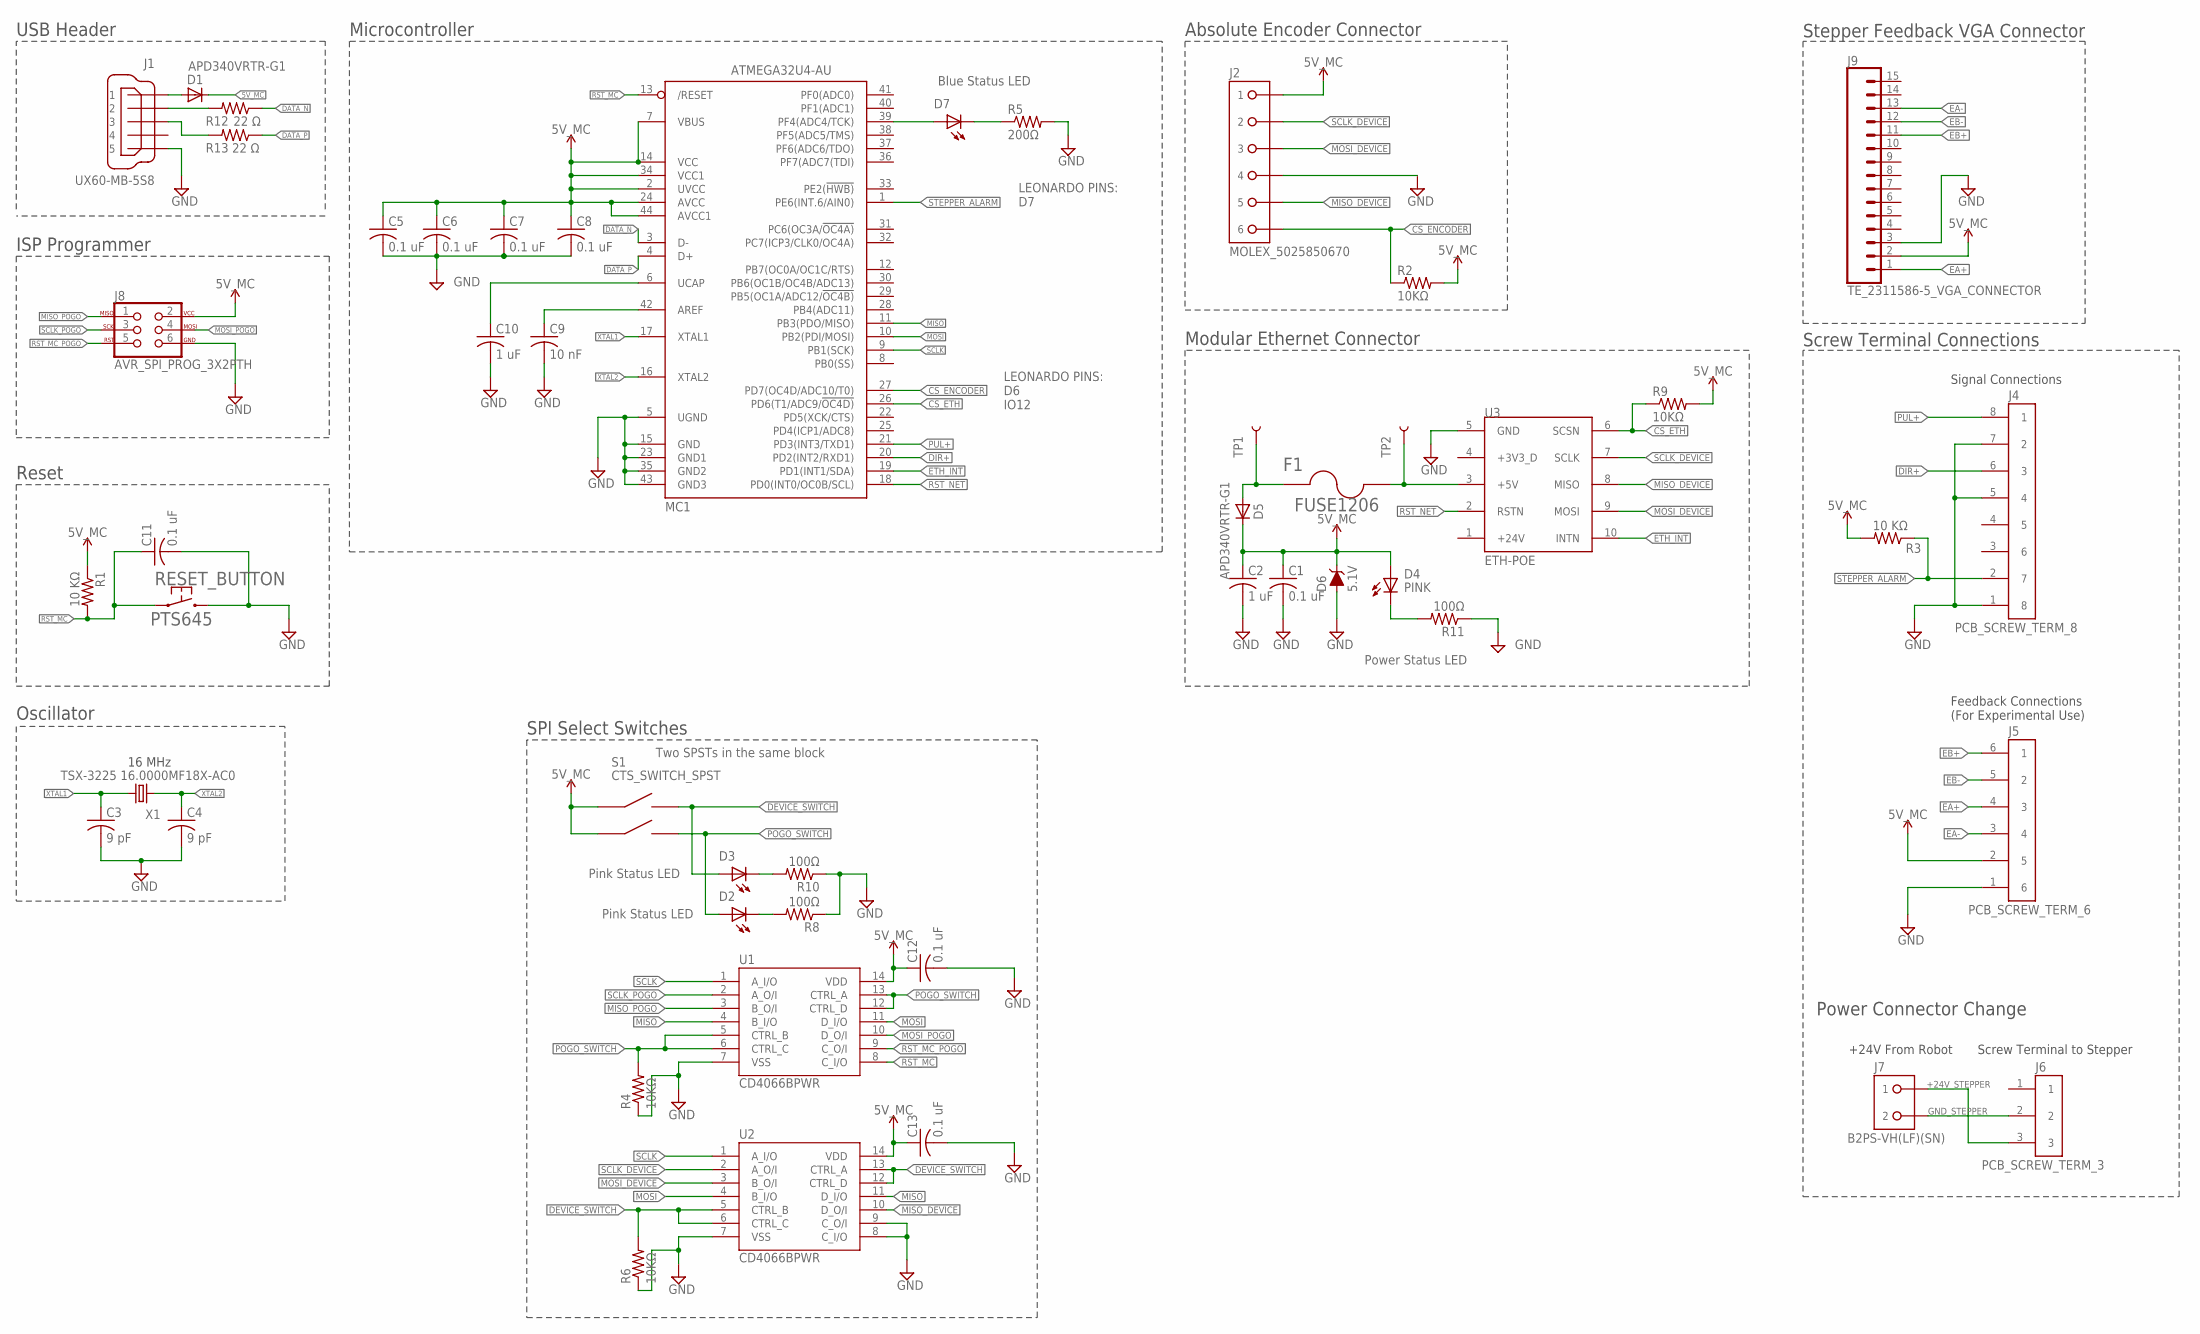
[picture p28: schematic Steering.sch]

Parts:
C1, C5, C6, C7, C8, C11, C12, C13: 0.1 uF; C0603
C2, C10: 1 uF; C0603
C3, C4: 9 pF; C0603
C9: 10 nF; C0603
D1, D5: APD340VRTR-G1; DO-214AC
D2, D3: LED_AA3528VRVCS/A; KINGBRIGHT_LED
D4: PINK; KINGBRIGHT_LED
D6: 5.1V; SOD-323
D7: BLUE; CHIP-LED0603
F1: FUSE1206; F1206
J1: UX60-MB-5S8
J2: MOLEX_5025850670
J4: PCB_SCREW_TERM_8; SCREW_TERMINAL_PCB_CONN_8_POLE
J5: PCB_SCREW_TERM_6; SCREW_TERMINAL_PCB_CONN_6_POLE
J6: PCB_SCREW_TERM_3; SCREW_TERMINAL_PCB_CONN_3_POLE
J7: B2PS-VH(LF)(SN); B2PS-CENTERED
J8: AVR_SPI_PROG_3X2PTH; 2X3
J9: TE_2311586-5_VGA_CONNECTOR; TE_VGA_2311586-5
MC1: ATMEGA32U4-AU; TQFP44
R1, R3: 10 KΩ; R0603
R2, R4, R6, R9: 10KΩ; R0603W
R5: 200Ω; R0603W
R8, R10, R11: 100Ω; R0603W
R12, R13: 22 Ω; R0603
RESET_BUTTON: PTS645
S1: CTS_SWITCH_SPST; CTS_DIP_SWITCH
TP1, TP2: TEST-POINTTP_15TH_THRU; TP_15TH
U1, U2: CD4066BPWR; TSSOP14
U3: ETH-POE; HDRVR10W64P4000X254_2X5_1016X508X254B
X1: TSX-3225 16.0000MF18X-AC0; XTAL-3.2X2.5

Connections:
5V_MC: C1.1, C2.1, C5.1, C6.1, C7.1, C8.1, C12.1, C13.1, D1.C, D4.P$2 (A), D5.C, D6.C, J2.1, J5.2 (5), J8.2, J9.2, MC1.2 (UVCC), MC1.7 (VBUS), MC1.14 (VCC), MC1.24 (AVCC), MC1.34 (VCC1), MC1.44 (AVCC1), R1.1, R2.2 (PIN2), R3.2, R9.2 (PIN2), S1.A2 (COMMON), S1.B2 (COMMON1), U1.14 (VDD), U2.14 (VDD)
+24V_STEPPER: J6.3, J7.1
AREF: C9.1, MC1.42 (AREF)
CS_ENCODER: J2.6, MC1.27 (PD7(OC4D/ADC10/T0)), R2.1 (PIN1)
CS_ETH: MC1.26 (PD6(T1/ADC9/!OC4D)), R9.1 (PIN1), U3.6 (SCSN)
DATA_N: MC1.3 (D-), R12.1
DATA_P: MC1.4 (D+), R13.1
DEVICE_SWITCH: D3.P$2 (A), R6.2 (PIN2), S1.A1 (A), U2.5 (CTRL_B), U2.6 (CTRL_C), U2.12 (CTRL_D), U2.13 (CTRL_A)
DIR+: J4.6 (3), MC1.20 (PD2(INT2/RXD1))
EA+: J5.4 (3), J9.1
EA-: J5.3 (4), J9.13
EB+: J5.6 (1), J9.11
EB-: J5.5 (2), J9.12
ETH_INT: MC1.19 (PD1(INT1/SDA)), U3.10 (INTN)
GND: C1.2, C2.2, C3.2, C4.2, C5.2, C6.2, C7.2, C8.2, C9.2, C10.2, C11.2, C12.2, C13.2, D6.A, J1.5, J2.4, J4.1 (8), J4.5 (4), J4.7 (2), J5.1 (6), J8.6, J9.3, MC1.5 (UGND), MC1.15 (GND), MC1.23 (GND1), MC1.35 (GND2), MC1.43 (GND3), R4.1 (PIN1), R5.2 (PIN2), R6.1 (PIN1), R8.1 (PIN1), R10.1 (PIN1), R11.1 (PIN1), RESET_BUTTON.P$3 (2), RESET_BUTTON.P$4 (2), U1.7 (VSS), U2.7 (VSS), U2.8 (C_I/O), U2.9 (C_O/I), U3.5 (GND)
GND_STEPPER: J6.2, J7.2
MISO: MC1.11 (PB3(PDO/MISO)), U1.4 (B_I/O), U2.11 (D_I/O)
MISO_DEVICE: J2.5, U2.10 (D_O/I), U3.8 (MISO)
MISO_POGO: J8.1, U1.3 (B_O/I)
MOSI: MC1.10 (PB2(PDI/MOSI)), U1.11 (D_I/O), U2.4 (B_I/O)
MOSI_DEVICE: J2.3, U2.3 (B_O/I), U3.9 (MOSI)
MOSI_POGO: J8.4, U1.10 (D_O/I)
unnamed: D1.A, J1.1
unnamed: D7.A, MC1.39 (PF4(ADC4/TCK))
unnamed: D7.C (K), R5.1 (PIN1)
unnamed: D3.P$1 (B), R10.2 (PIN2)
unnamed: D2.P$1 (B), R8.2 (PIN2)
unnamed: J1.2, R12.2
unnamed: F1.2, TP2.P$1, U3.3 (+5V)
unnamed: D4.P$1 (B), R11.2 (PIN2)
unnamed: D5.A, F1.1, TP1.P$1
unnamed: J1.3, R13.2
POGO_SWITCH: D2.P$2 (A), R4.2 (PIN2), S1.B1 (A1), U1.5 (CTRL_B), U1.6 (CTRL_C), U1.12 (CTRL_D), U1.13 (CTRL_A)
PUL+: J4.8 (1), MC1.21 (PD3(INT3/TXD1))
RST_MC: C11.1, MC1.13 (/RESET), R1.2, RESET_BUTTON.P$1 (1), RESET_BUTTON.P$2 (1), U1.8 (C_I/O)
RST_MC_POGO: J8.5, U1.9 (C_O/I)
RST_NET: MC1.18 (PD0(INT0/OC0B/SCL)), U3.2 (RSTN)
SCLK: MC1.9 (PB1(SCK)), U1.1 (A_I/O), U2.1 (A_I/O)
SCLK_DEVICE: J2.2, U2.2 (A_O/I), U3.7 (SCLK)
SCLK_POGO: J8.3, U1.2 (A_O/I)
STEPPER_ALARM: J4.2 (7), MC1.1 (PE6(INT.6/AIN0)), R3.1
UCAP: C10.1, MC1.6 (UCAP)
XTAL1: C3.1, MC1.17 (XTAL1), X1.1
XTAL2: C4.1, MC1.16 (XTAL2), X1.3 (2)

Notes on the sheet:
Reset
Oscillator
Microcontroller
USB Header
16 MHz
ISP Programmer
Stepper Feedback VGA Connector
Absolute Encoder Connector
LEONARDO PINS: D6 IO12
Screw Terminal Connections
Modular Ethernet Connector
Signal Connections
Feedback Connections (For Experimental Use)
Power Connector Change
LEONARDO PINS: D7
+24V From Robot
SPI Select Switches
Screw Terminal to Stepper
Blue Status LED
Power Status LED
Pink Status LED
Two SPSTs in the same block

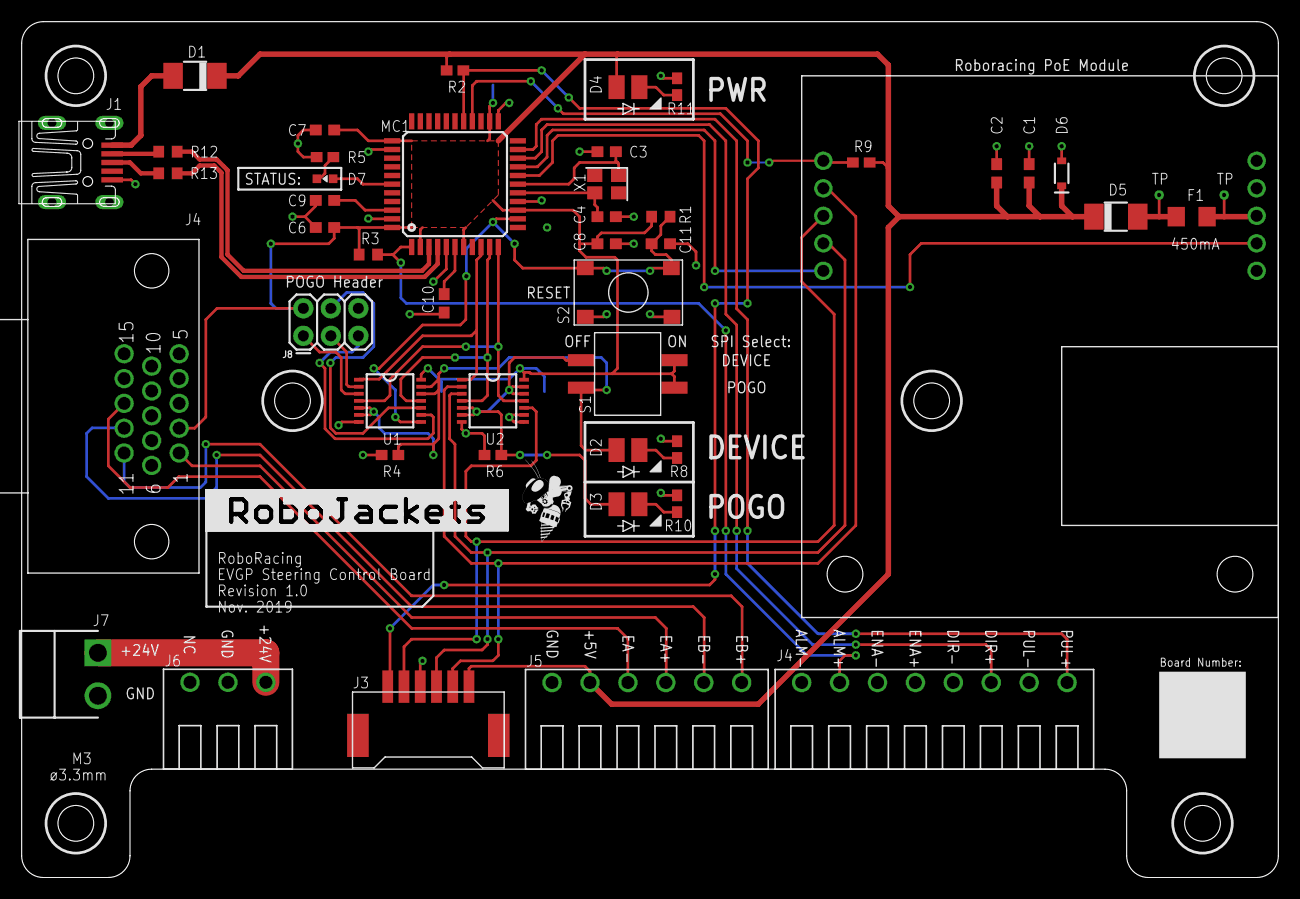
[picture p29: board Steering.brd from above]

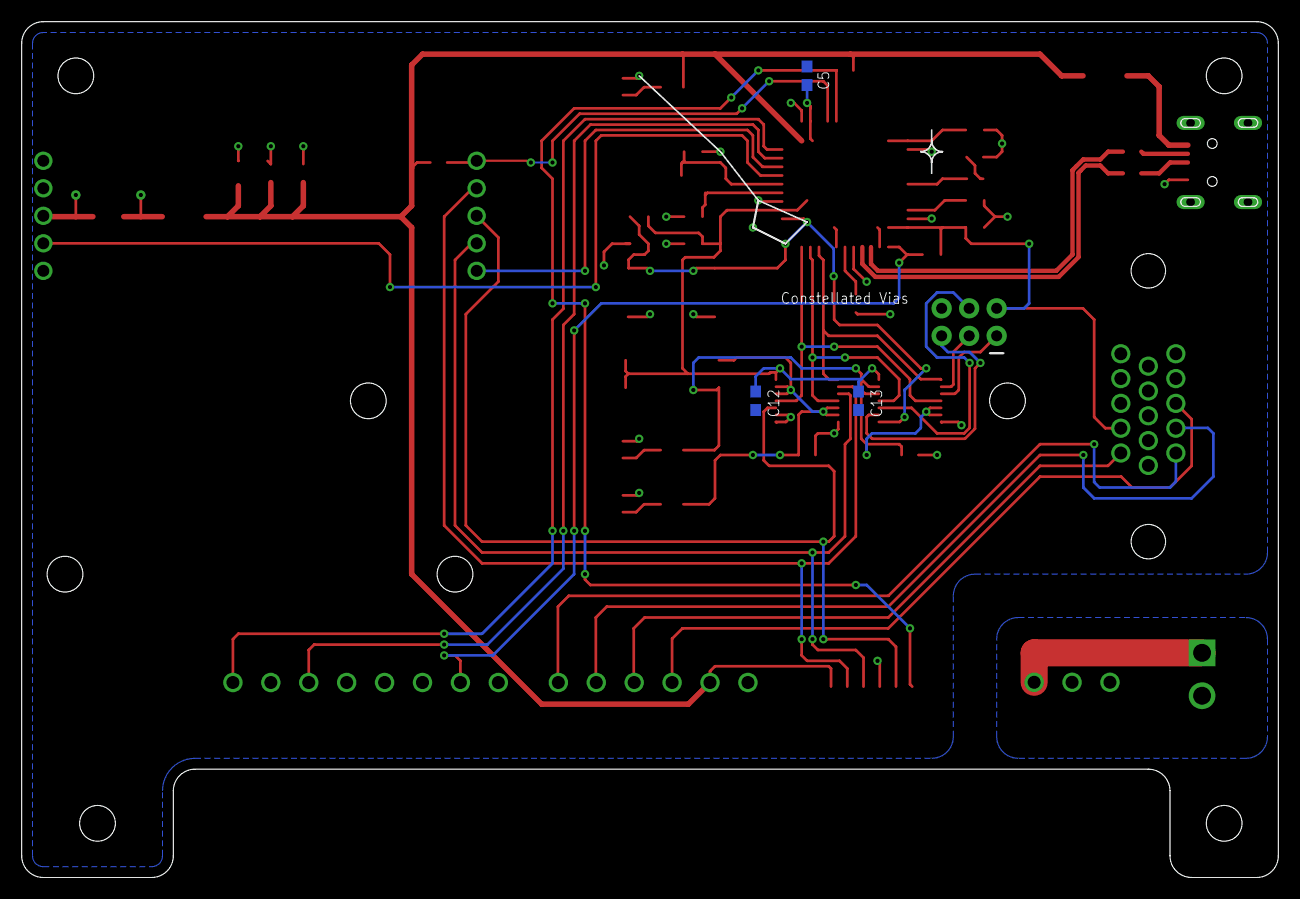
[picture p30: board Steering.brd from below]

Board: 2 copper layers, 116.0 x 79.0 mm, 52 parts (3 on the bottom side), 44 nets.

Other parts of the board:
U$4: ROBOJACKETS
U$5: ROBOBUZZ_0.4X
