RoboJackets/roboracing-electrical/rigatoni/manual-rc/manual-rc.brd

## EAGLE design rigatoni/manual-rc/manual-rc.brd (2020-05-11)

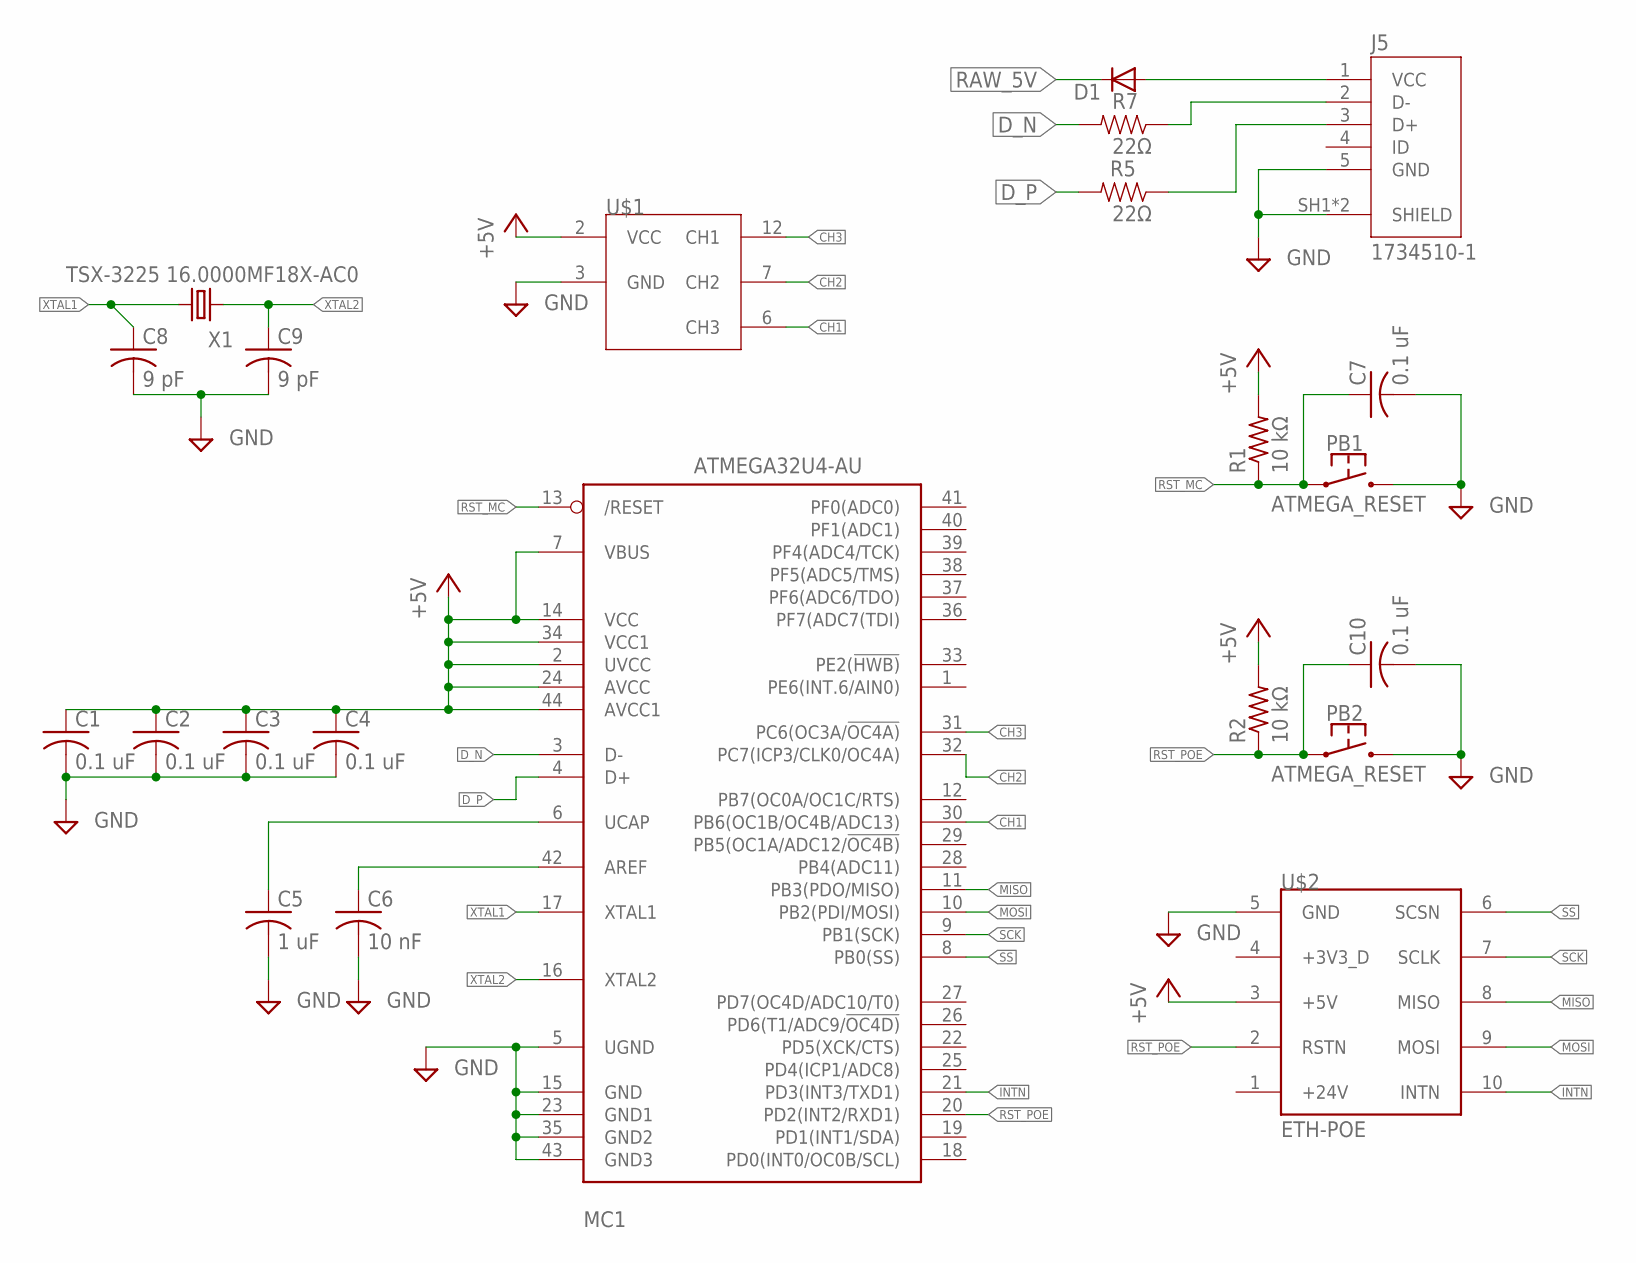
[picture p31: schematic manual-rc.sch]

Parts:
C1, C2, C3, C4, C7, C10: 0.1 uF; C0603
C5: 1 uF; C0603
C6: 10 nF; C0603
C8, C9: 9 pF; C0603
D1: DIODESOD; SOD-323
J5: 1734510-1; TE_1734510-1
MC1: ATMEGA32U4-AU; TQFP44
PB1, PB2: ATMEGA_RESET; TACT_PB_RA
R1, R2: 10 kΩ; R0603
R5, R7: 22Ω; 0603-RES
U$1: HK-GT2B; HDRVR12W64P254_4X3_1016X508X254B
U$2: ETH-POE; HDRVR10W64P4000X254_2X5_1016X508X254B
X1: TSX-3225 16.0000MF18X-AC0; XTAL-3.2X2.5

Connections:
+5V: C1.1, C2.1, C3.1, C4.1, MC1.2 (UVCC), MC1.7 (VBUS), MC1.14 (VCC), MC1.24 (AVCC), MC1.34 (VCC1), MC1.44 (AVCC1), U$1.2 (VCC), U$2.3 (+5V)
CH1: MC1.30 (PB6(OC1B/OC4B/ADC13)), U$1.6 (CH3)
CH2: MC1.32 (PC7(ICP3/CLK0/OC4A)), U$1.7 (CH2)
CH3: MC1.31 (PC6(OC3A/!OC4A)), U$1.12 (CH1)
D2_N: J5.2 (D-), R7.1
D2_P: J5.3 (D+), R5.1
D_N: MC1.3 (D-), R7.2
D_P: MC1.4 (D+), R5.2
GND: C1.2, C2.2, C3.2, C4.2, C5.2, C6.2, C7.2, C10.2, PB1.P$2 (2), PB2.P$2 (2), U$1.3 (GND), U$2.5 (GND)
INTN: MC1.21 (PD3(INT3/TXD1)), U$2.10 (INTN)
MISO: MC1.11 (PB3(PDO/MISO)), U$2.8 (MISO)
MOSI: MC1.10 (PB2(PDI/MOSI)), U$2.9 (MOSI)
unnamed: C5.1, MC1.6 (UCAP)
unnamed: C6.1, MC1.42 (AREF)
unnamed: MC1.5 (UGND), MC1.15 (GND), MC1.23 (GND1), MC1.35 (GND2), MC1.43 (GND3)
unnamed: R1.2, R2.2
unnamed: J5.5 (GND), J5.SH1 (SHIELD), J5.SH2 (SHIELD)
unnamed: C8.2, C9.2
unnamed: D1.2 (A), J5.1 (VCC)
RAW_5V: D1.1 (C)
RST_MC: C7.1, MC1.13 (/RESET), PB1.P$1 (1), R1.1
RST_POE: C10.1, MC1.20 (PD2(INT2/RXD1)), PB2.P$1 (1), R2.1, U$2.2 (RSTN)
SCK: MC1.9 (PB1(SCK)), U$2.7 (SCLK)
SS: MC1.8 (PB0(SS)), U$2.6 (SCSN)
XTAL1: C8.1, MC1.17 (XTAL1), X1.1
XTAL2: C9.1, MC1.16 (XTAL2), X1.3 (2)

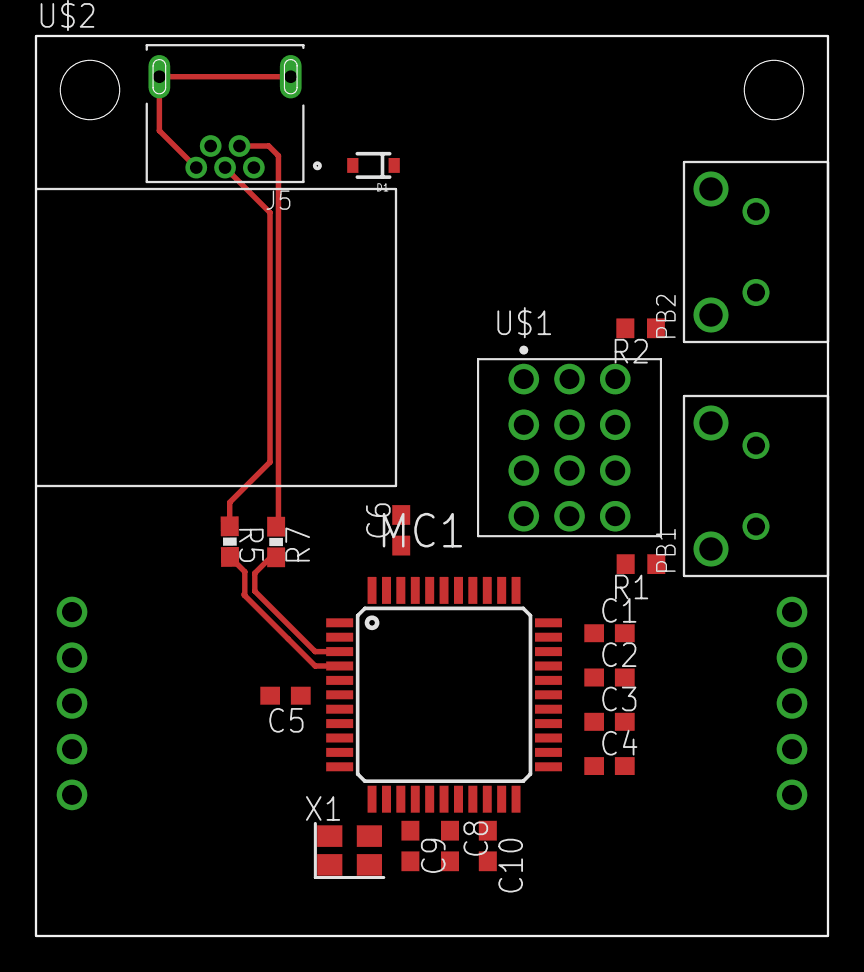
[picture p32: board manual-rc.brd from above]

Board: 2 copper layers, 44.0 x 50.0 mm, 22 parts (1 on the bottom side), 25 nets.
