RoboJackets/roboracing-electrical/rigatoni/manual-rc/manual-rc-v2.brd

## EAGLE design rigatoni/manual-rc/manual-rc-v2.brd (2020-05-11)

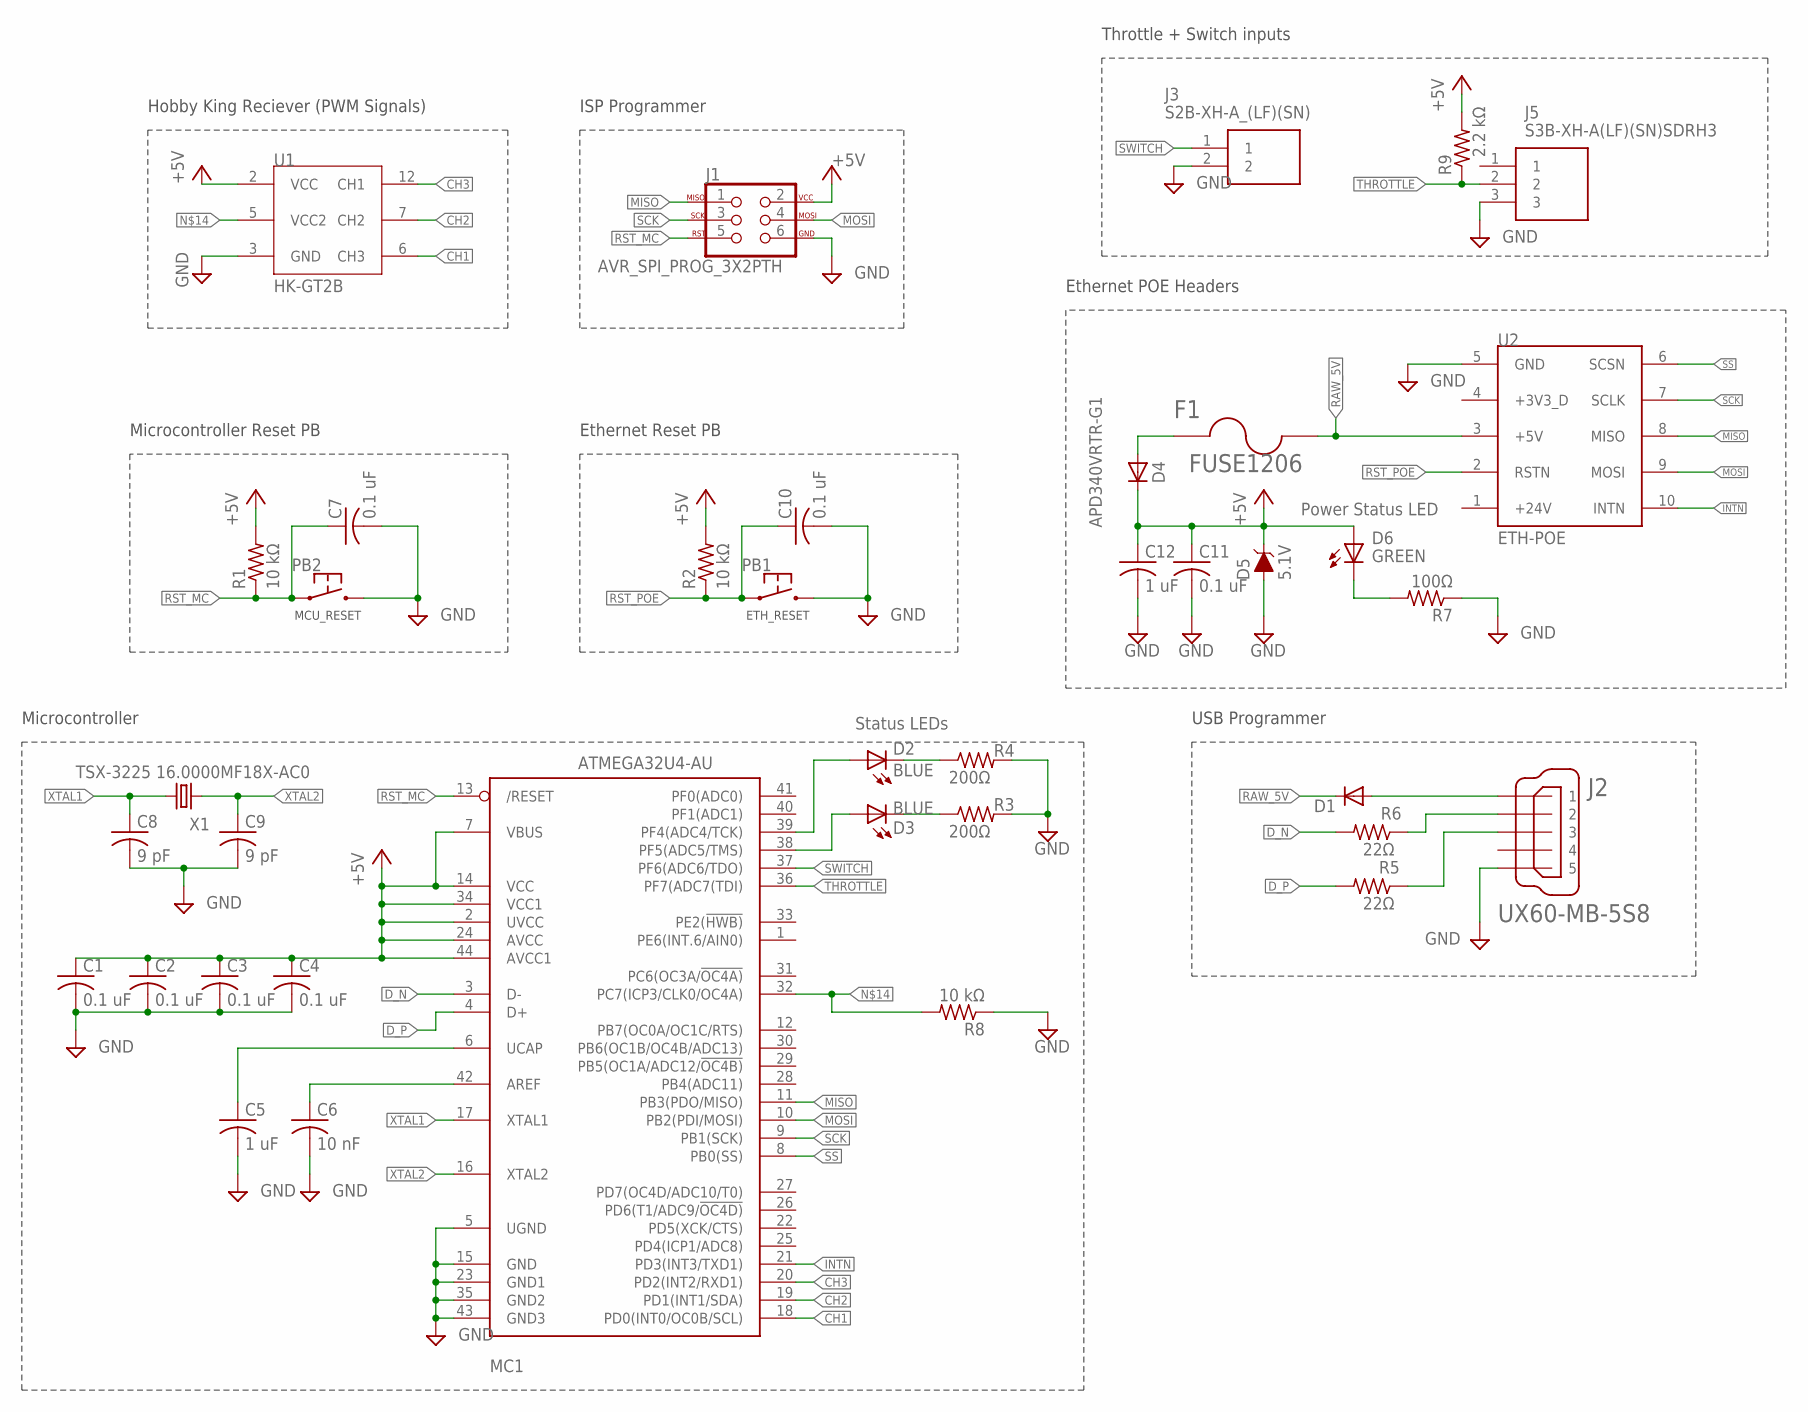
[picture p33: schematic manual-rc-v2.sch]

Parts:
C1, C2, C3, C4, C7, C10, C11: 0.1 uF; C0603
C5, C12: 1 uF; C0603
C6: 10 nF; C0603
C8, C9: 9 pF; C0603
D1: DIODESOD; SOD-323
D2, D3: BLUE; CHIP-LED0603
D4: APD340VRTR-G1; DO-214AC
D5: 5.1V; SOD-323
D6: GREEN; CHIP-LED0603
F1: FUSE1206; F1206
J1: AVR_SPI_PROG_3X2PTH; 2X3
J2: UX60-MB-5S8
J3: S2B-XH-A_(LF)(SN); SHDR2W80P0X250_1X2_740X1150X61
J5: S3B-XH-A(LF)(SN)SDRH3; SHDR4
MC1: ATMEGA32U4-AU; TQFP44
PB1, PB2: PTS645
R1, R2, R8: 10 kΩ; R0603
R3, R4: 200Ω; R0603W
R5, R6: 22Ω; R0603
R7: 100Ω; R0603W
R9: 2.2 kΩ; R0603
U1: HK-GT2B; HDRVR12W64P254_4X3_1016X508X254B
U2: ETH-POE; HDRVR10W64P4000X254_2X5_1016X508X254B
X1: TSX-3225 16.0000MF18X-AC0; XTAL-3.2X2.5

Connections:
+5V: C1.1, C2.1, C3.1, C4.1, C11.1, C12.1, D4.C, D5.C, D6.A, J1.2, MC1.2 (UVCC), MC1.7 (VBUS), MC1.14 (VCC), MC1.24 (AVCC), MC1.34 (VCC1), MC1.44 (AVCC1), R1.2, R2.2, R9.2, U1.2 (VCC)
CH1: MC1.18 (PD0(INT0/OC0B/SCL)), U1.6 (CH3)
CH2: MC1.19 (PD1(INT1/SDA)), U1.7 (CH2)
CH3: MC1.20 (PD2(INT2/RXD1)), U1.12 (CH1)
D_N: MC1.3 (D-), R6.2
D_P: MC1.4 (D+), R5.2
GND: C1.2, C2.2, C3.2, C4.2, C5.2, C6.2, C7.2, C8.2, C9.2, C10.2, C11.2, C12.2, D5.A, J1.6, J2.5, J3.2, J5.3, MC1.5 (UGND), MC1.15 (GND), MC1.23 (GND1), MC1.35 (GND2), MC1.43 (GND3), PB1.P$3 (2), PB1.P$4 (2), PB2.P$3 (2), PB2.P$4 (2), R3.2 (PIN2), R4.2 (PIN2), R7.1 (PIN1), R8.1, U1.3 (GND), U2.5 (GND)
INTN: MC1.21 (PD3(INT3/TXD1)), U2.10 (INTN)
MISO: J1.1, MC1.11 (PB3(PDO/MISO)), U2.8 (MISO)
MOSI: J1.4, MC1.10 (PB2(PDI/MOSI)), U2.9 (MOSI)
unnamed: C5.1, MC1.6 (UCAP)
unnamed: C6.1, MC1.42 (AREF)
unnamed: D2.A, MC1.39 (PF4(ADC4/TCK))
unnamed: D3.C (K), R3.1 (PIN1)
unnamed: J2.2, R6.1
unnamed: D1.2 (A), J2.1
unnamed: J2.3, R5.1
unnamed: D6.C (K), R7.2 (PIN2)
unnamed: D2.C (K), R4.1 (PIN1)
unnamed: D4.A, F1.1
unnamed: D3.A, MC1.38 (PF5(ADC5/TMS))
unnamed: MC1.32 (PC7(ICP3/CLK0/OC4A)), R8.2, U1.5 (VCC2)
RAW_5V: D1.1 (C), F1.2, U2.3 (+5V)
RST_MC: C7.1, J1.5, MC1.13 (/RESET), PB2.P$1 (1), PB2.P$2 (1), R1.1
RST_POE: C10.1, PB1.P$1 (1), PB1.P$2 (1), R2.1, U2.2 (RSTN)
SCK: J1.3, MC1.9 (PB1(SCK)), U2.7 (SCLK)
SS: MC1.8 (PB0(SS)), U2.6 (SCSN)
SWITCH: J3.1, MC1.37 (PF6(ADC6/TDO))
THROTTLE: J5.2, MC1.36 (PF7(ADC7(TDI)), R9.1
XTAL1: C8.1, MC1.17 (XTAL1), X1.1
XTAL2: C9.1, MC1.16 (XTAL2), X1.3 (2)

Notes on the sheet:
Hobby King Reciever (PWM Signals)
Microcontroller
ISP Programmer
Ethernet Reset PB
Microcontroller Reset PB
Ethernet POE Headers
USB Programmer
Power Status LED
Status LEDs
BLUE
Throttle + Switch inputs

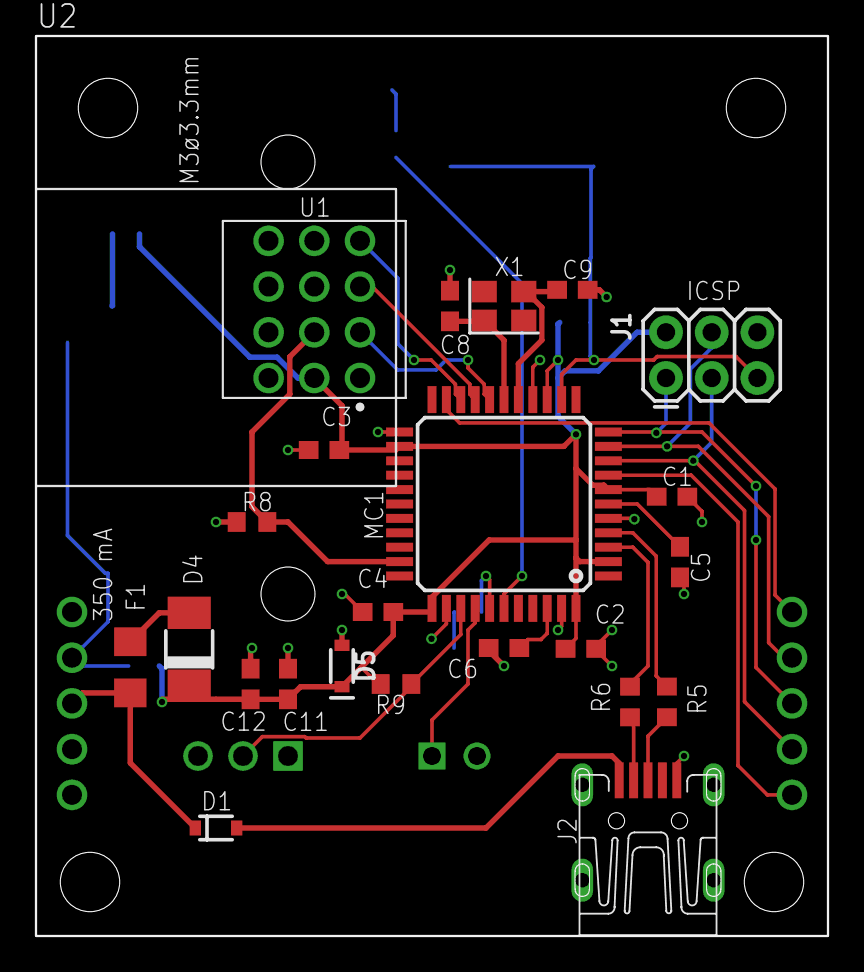
[picture p34: board manual-rc-v2.brd from above]

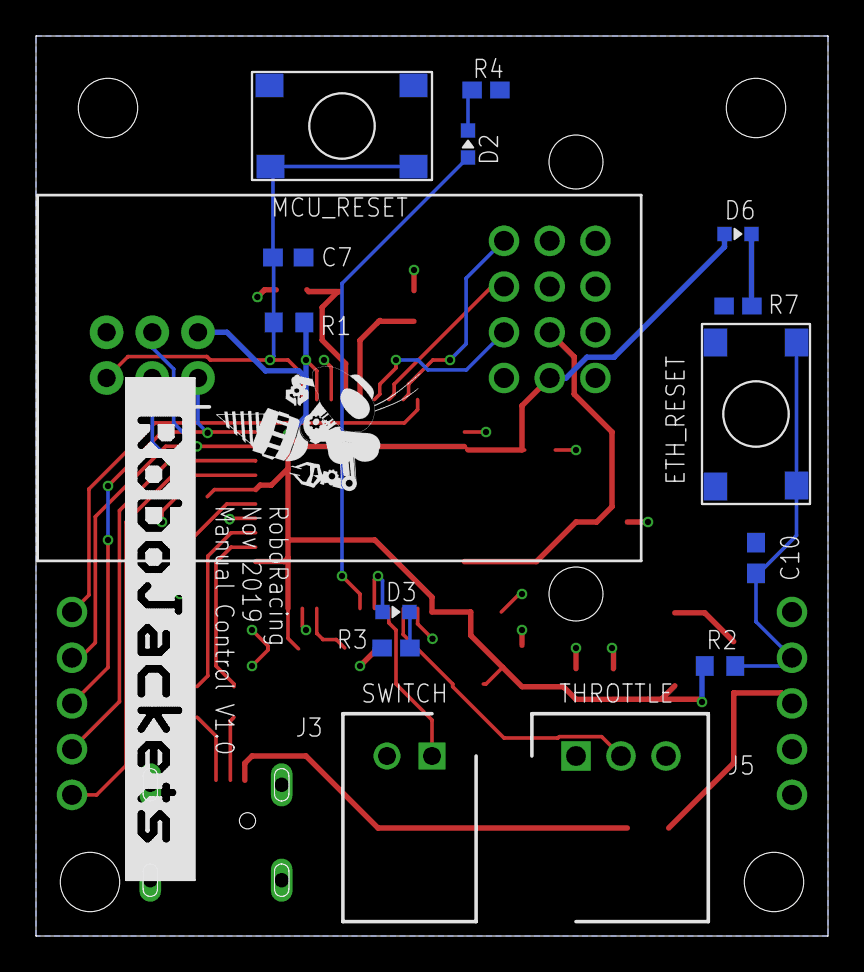
[picture p35: board manual-rc-v2.brd from below]

Board: 2 copper layers, 44.0 x 50.0 mm, 40 parts (16 on the bottom side), 31 nets.

Other parts of the board:
U$3: ROBOBUZZ_0.6X
U$4: ROBOJACKETS
