RoboJackets/roboracing-electrical/rigatoni/Speedometer/Speedometer.brd

## EAGLE design rigatoni/Speedometer/Speedometer.brd (2021-10-24)

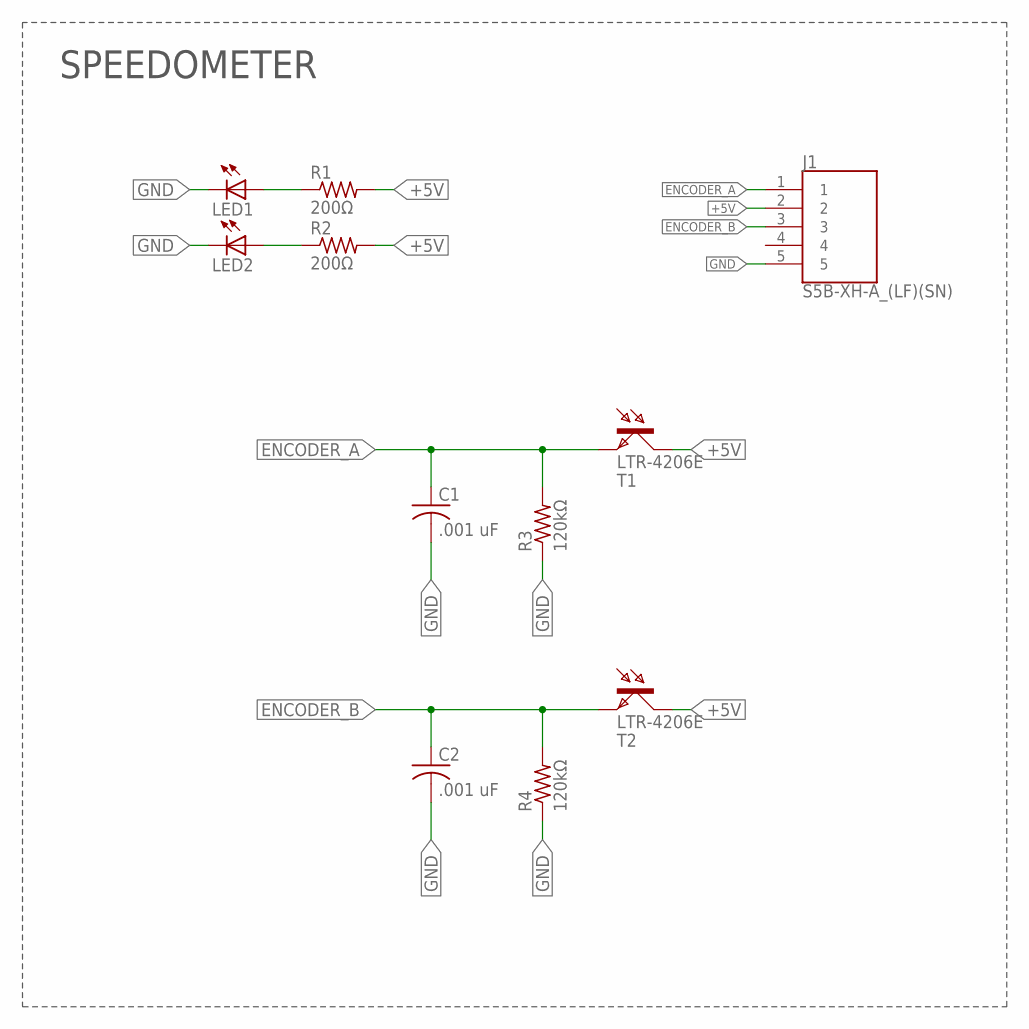
[picture p36: schematic Speedometer.sch]

Parts:
C1, C2: .001 uF; C0603
J1: S5B-XH-A_(LF)(SN); SHDR5W80P0X250_1X5_1490X1150X6
LED1, LED2: LED3MM
R1, R2: 200Ω; R0603
R3, R4: 120kΩ; R0603
T1, T2: LTR-4206E; BPX81

Connections:
+5V: J1.2, R1.2, R2.2, T1.C, T2.C
ENCODER_A: C1.1, J1.1, R3.2, T1.E
ENCODER_B: C2.1, J1.3, R4.2, T2.E
GND: C1.2, C2.2, J1.5, LED1.K (C), LED2.K (C), R3.1, R4.1
unnamed: LED1.A, R1.1
unnamed: LED2.A, R2.1

Notes on the sheet:
SPEEDOMETER

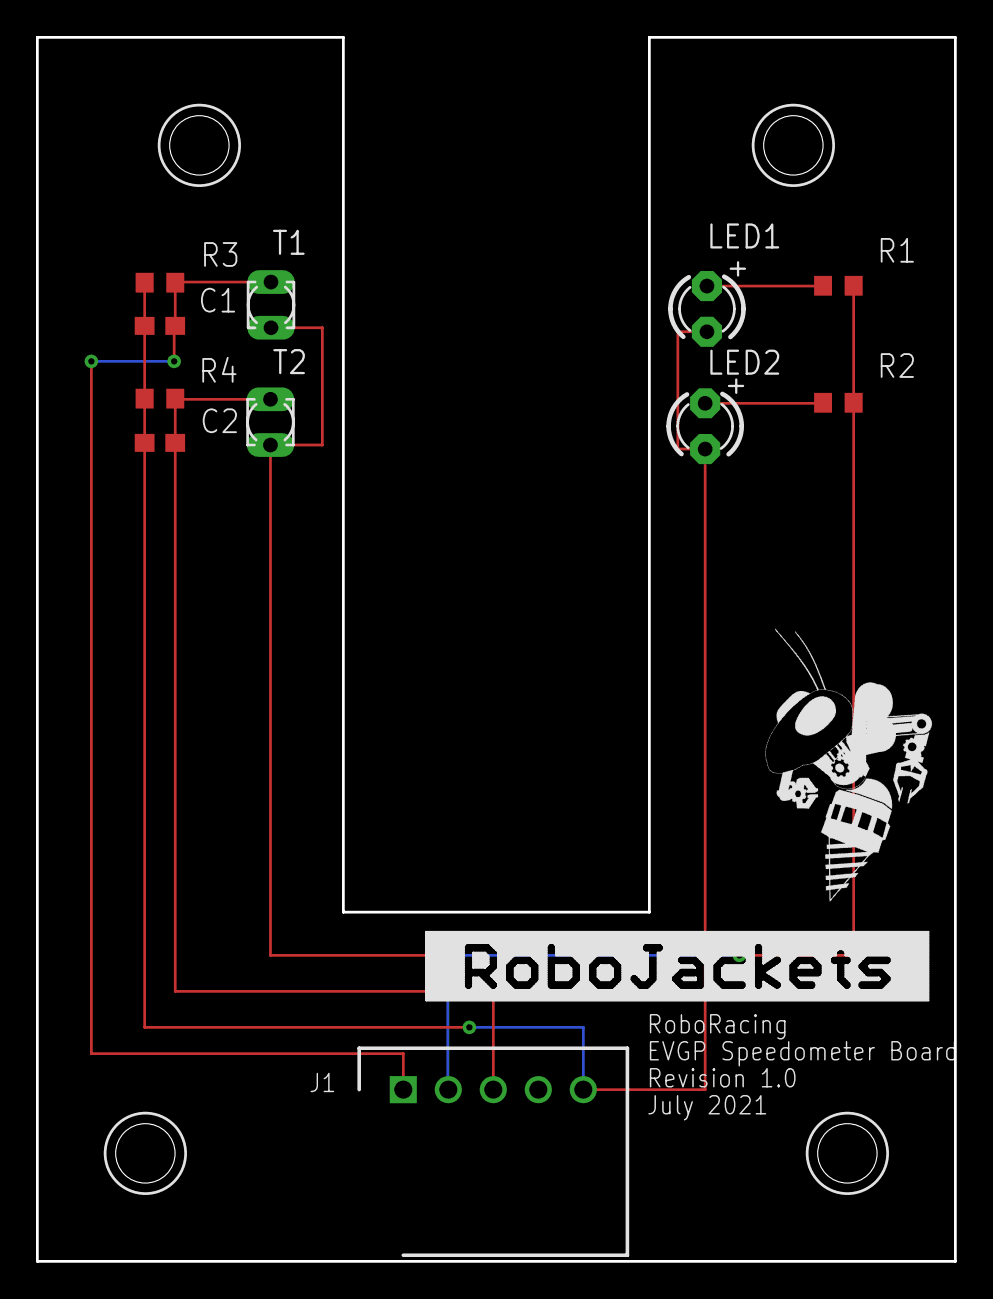
[picture p37: board Speedometer.brd from above]

Board: 2 copper layers, 51.0 x 68.0 mm, 13 parts (0 on the bottom side), 6 nets.

Other parts of the board:
U$1: ROBOBUZZ_0.8X
U$2: ROBOJACKETS
