RoboJackets/roboracing-electrical/rigatoni/ethernet_poe/v2/ethernet_poe.brd

## EAGLE design rigatoni/ethernet_poe/v2/ethernet_poe.brd (2020-09-19, an earlier design)

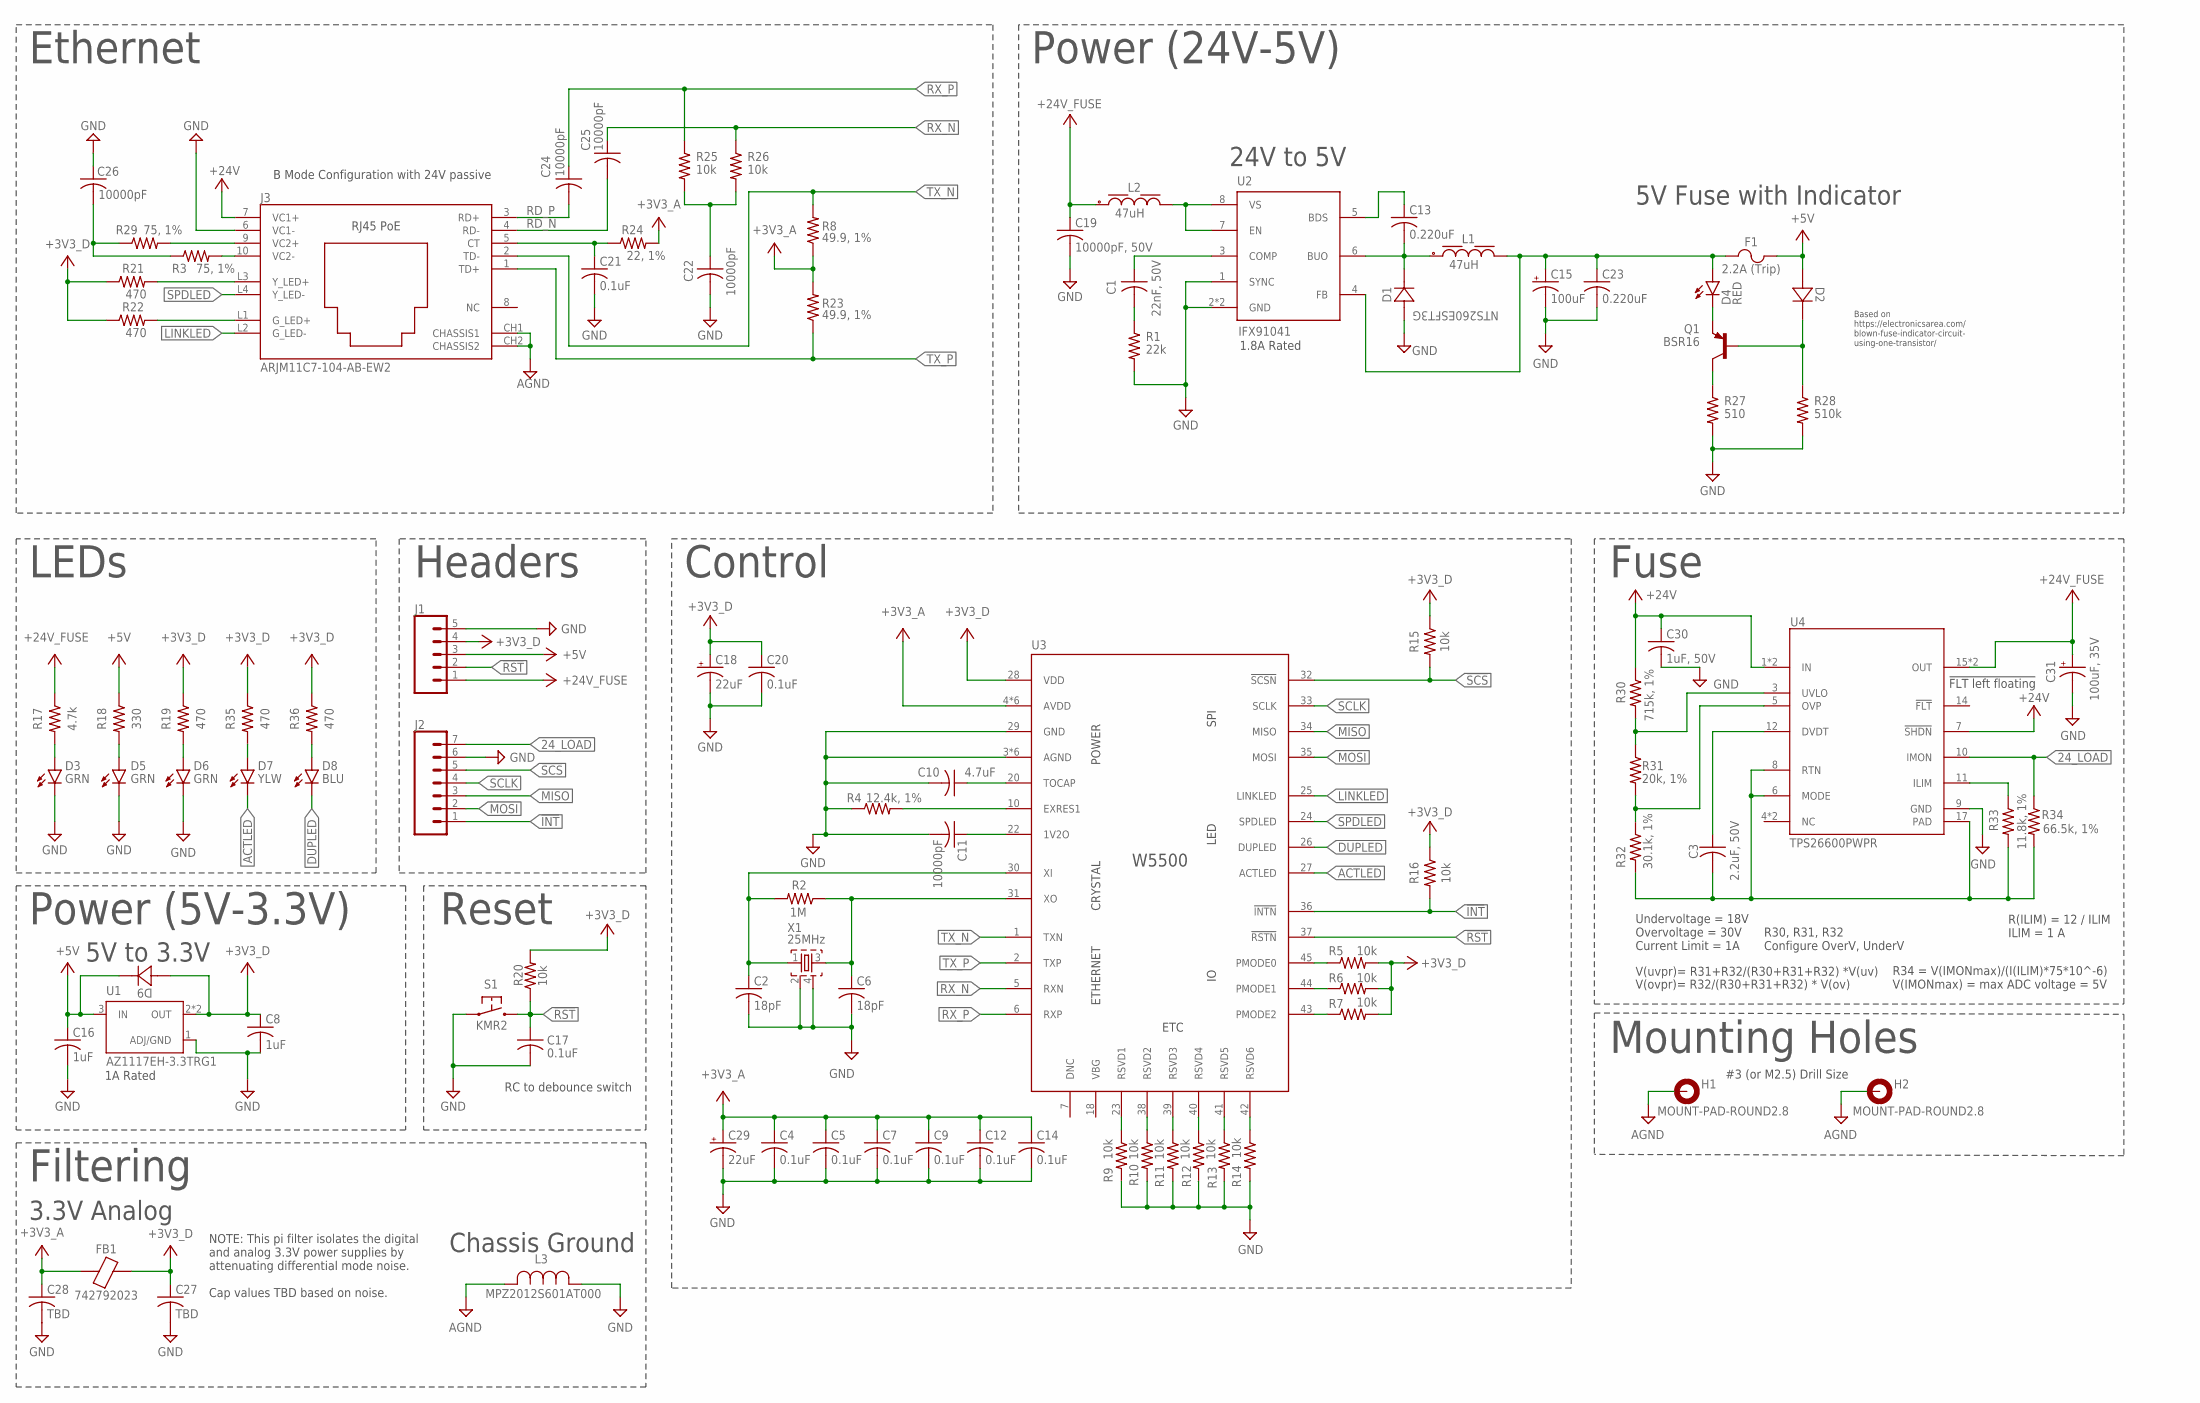
[picture p38: schematic ethernet_poe.sch]

Parts:
C1: 22nF, 50V; C0603
C2, C6: 18pF; C0603
C3: 2.2uF, 50V; C0603
C4, C5, C7, C9, C12, C14: 0.1uF; C0402
C8, C16: 1uF; C0603
C10: 4.7uF; C0603
C11, C24, C25: 10000pF; C0402
C13, C23: 0.220uF; C0603
C15: 100uF; E2-5
C17, C20, C21: 0.1uF; C0603
C18: 22uF; E2-5
C19: 10000pF, 50V; C0603
C22, C26: 10000pF; C0603
C27, C28: TBD; C0603
C29: 22uF; PANASONIC_C
C30: 1uF, 50V; C0603
C31: 100uF, 35V; E2-5
D1: NTS260ESFT3G; DIO_SS26FL
D2, D9: 1N4148W-7-F; SOD123_DIO
D3, D5, D6: GRN; CHIP-LED0603
D4: RED; CHIP-LED0603
D7: YLW; CHIP-LED0603
D8: BLU; CHIP-LED0603
F1: 2.2A (Trip); 0ZCG_BEL
FB1: 742792023; 0805
H1, H2: MOUNT-PAD-ROUND2.8; 2,8-PAD
J1: CONN_05; 1X05
J2: CONN_07; 1X07
J3: ARJM11C7-104-AB-EW2; CONN_EW_ABR
L1: 47uH; WE-PD_1260
L2: 47uH; WE-PD_7345
L3: MPZ2012S601AT000; IND_2012_TDK
Q1: BSR16; SOT-23-3
R1: 22k; R0603
R2: 1M; R0402
R3, R29: 75, 1%; R0603
R4: 12.4k, 1%; R0603
R5, R6, R7, R9, R10, R11, R12, R13, R14, R15, R16, R20, R25, R26: 10k; R0603
R8, R23: 49.9, 1%; R0402
R17: 4.7k; R0603
R18: 330; R0603
R19, R21, R22, R35, R36: 470; R0603
R24: 22, 1%; R0603
R27: 510; R0603
R28: 510k; R0603
R30: 715k, 1%; R0603
R31: 20k, 1%; R0603
R32: 30.1k, 1%; R0603
R33: 11.8k, 1%; R0603
R34: 66.5k, 1%; R0603
S1: KMR2
U1: AZ1117EH-3.3TRG1; SOT230P700X180-4N
U2: IFX91041; SOIC-8-EXPOSED_PAD
U3: W5500; 48-LQFP
U4: TPS26600PWPR; PWP0016H_N
X1: 25MHz; OSCILLATOR-SMD-2.5X2

Connections:
3V3_LED: D6.A, R19.2
3V3_LED1: D7.A, R35.2
3V3_LED2: D8.A, R36.2
5V_LED: D5.A, R18.2
5V_RAW: C13.2, D1.1, L1.1, U2.6 (BUO)
24V_LED: D3.A, R17.2
24_LOAD: J2.7, R34.1, U4.10 (IMON)
!INT: J2.1, R16.2, U3.36 (!INTN)
!RST: C17.1, J1.2, R20.1, S1.2.1 (2), S1.2.2 (2), U3.37 (!RSTN)
!SCS: J2.5, R15.2, U3.32 (!SCSN)
+3V3_A: C4.1, C5.1, C7.1, C9.1, C12.1, C14.1, C28.1, C29.+, FB1.1, R8.1, R23.2, R24.2, U3.4 (AVDD), U3.8 (AVDD), U3.11 (AVDD), U3.15 (AVDD), U3.17 (AVDD), U3.21 (AVDD)
+3V3_D: C8.1, C18.+, C20.1, C27.1, D9.2, FB1.2, J1.4, R5.2, R6.2, R7.2, R15.1, R16.1, R19.1, R20.2, R21.1, R22.1, R35.1, R36.1, U1.2 (OUT), U1.4 (OUT), U3.28 (VDD)
+5V: C16.1, D2.2, D9.1, F1.2, J1.3, R18.1, U1.3 (IN)
+5V_PREFUSE: C15.+, C23.1, D4.A, F1.1, L1.2, U2.4 (FB)
+24V: C30.1, J3.7 (VC1+), R30.1, U4.1 (IN), U4.2 (IN), U4.7 (!SHDN)
+24V_FILTERED: L2.2, U2.7 (EN), U2.8 (VS)
+24V_FUSE: C19.1, C31.+, J1.1, L2.1, R17.1, U4.15 (OUT), U4.16 (OUT)
ACTLED: D7.C, U3.27 (ACTLED)
AGND: H1.B2,8, H2.B2,8, J3.CH1 (CHASSIS1), J3.CH2 (CHASSIS2), L3.2
CT: C21.1, J3.5 (CT), R24.1
DUPLED: D8.C, U3.26 (DUPLED)
GND: C2.2, C4.2, C5.2, C6.2, C7.2, C8.2, C9.2, C10.2, C11.2, C12.2, C14.2, C15.-, C16.2, C17.2, C18.-, C19.2, C20.2, C21.2, C22.2, C23.2, C26.1, C27.2, C28.2, C29.-, C30.2, C31.-, D1.2, D3.C, D5.C, D6.C, J1.5, J2.6, J3.6 (VC1-), L3.1, R1.2, R4.1, R9.2, R10.2, R11.2, R12.2, R13.2, R14.2, R27.2, R28.2, S1.1.1 (1), S1.1.2 (1), U1.1 (ADJ/GND), U2.1 (SYNC), U2.2 (GND), U2.9 (GND), U3.3 (AGND), U3.9 (AGND), U3.14 (AGND), U3.16 (AGND), U3.19 (AGND), U3.29 (GND), U3.48 (AGND), U4.9 (GND), X1.2 (SHD1), X1.4 (SHD2)
G_LED+: J3.L1 (G_LED+), R22.2
LINKLED: J3.L2 (G_LED-), U3.25 (LINKLED)
MISO: J2.3, U3.34 (MISO)
MOSI: J2.2, U3.35 (MOSI)
unnamed: R9.1, U3.23 (RSVD1)
unnamed: R10.1, U3.38 (RSVD2)
unnamed: R11.1, U3.39 (RSVD3)
unnamed: R5.1, U3.45 (PMODE0)
unnamed: R6.1, U3.44 (PMODE1)
unnamed: R12.1, U3.40 (RSVD4)
unnamed: R7.1, U3.43 (PMODE2)
unnamed: J3.9 (VC2+), R29.2
unnamed: R30.2, R31.1, U4.3 (UVLO)
unnamed: J3.10 (VC2-), R3.2
unnamed: C6.1, R2.1, U3.31 (XO), X1.3 (OUT)
unnamed: C26.2, R3.1, R29.1
unnamed: C2.1, R2.2, U3.30 (XI), X1.1 (IN)
unnamed: C13.1, U2.5 (BDS)
unnamed: C1.2, R1.1
unnamed: C1.1, U2.3 (COMP)
unnamed: C11.1, U3.22 (1V2O)
unnamed: C10.1, U3.20 (TOCAP)
unnamed: R13.1, U3.41 (RSVD5)
unnamed: R4.2, U3.10 (EXRES1)
unnamed: R14.1, U3.42 (RSVD6)
unnamed: D4.C, Q1.2 (E)
unnamed: D2.1, Q1.1 (B), R28.1
unnamed: Q1.3 (C), R27.1
unnamed: R31.2, R32.1, U4.5 (OVP)
unnamed: C3.1, U4.12 (DVDT)
unnamed: R33.1, U4.11 (ILIM)
RD_N: C25.2, J3.4 (RD-)
RD_P: C24.2, J3.3 (RD+)
RTN: C3.2, R32.2, R33.2, R34.2, U4.6 (MODE), U4.8 (RTN), U4.17 (PAD)
RX_FILTER: C22.1, R25.2, R26.2
RX_N: C25.1, R26.1, U3.5 (RXN)
RX_P: C24.1, R25.1, U3.6 (RXP)
SCLK: J2.4, U3.33 (SCLK)
SPDLED: J3.L4 (Y_LED-), U3.24 (SPDLED)
TX_N: J3.2 (TD-), R8.2, U3.1 (TXN)
TX_P: J3.1 (TD+), R23.1, U3.2 (TXP)
Y_LED+: J3.L3 (Y_LED+), R21.2

Notes on the sheet:
Power (24V-5V)
Control
LEDs
Ethernet
Headers
RC to debounce switch
Reset
24V to 5V
5V to 3.3V
5V Fuse with Indicator
3.3V Analog
B Mode Configuration with 24V passive
Based on https://electronicsarea.com/ blown-fuse-indicator-circuit- using-one-transistor/
NOTE: This pi filter isolates the digital and analog 3.3V power supplies by attenuating differential mode noise. Cap values TBD based on noise.
R(ILIM) = 12 / ILIM ILIM = 1 A
Undervoltage = 18V Overvoltage = 30V Current Limit = 1A
R30, R31, R32 Configure OverV, UnderV
V(ovpr)= R32/(R30+R31+R32) * V(ov)
V(uvpr)= R31+R32/(R30+R31+R32) *V(uv)
Fuse
!FLT left floating
Mounting Holes
Power (5V-3.3V)
Filtering
Chassis Ground
R34 = V(IMONmax)/(I(ILIM)*75*10^-6) V(IMONmax) = max ADC voltage = 5V
1.8A Rated
#3 (or M2.5) Drill Size
1A Rated

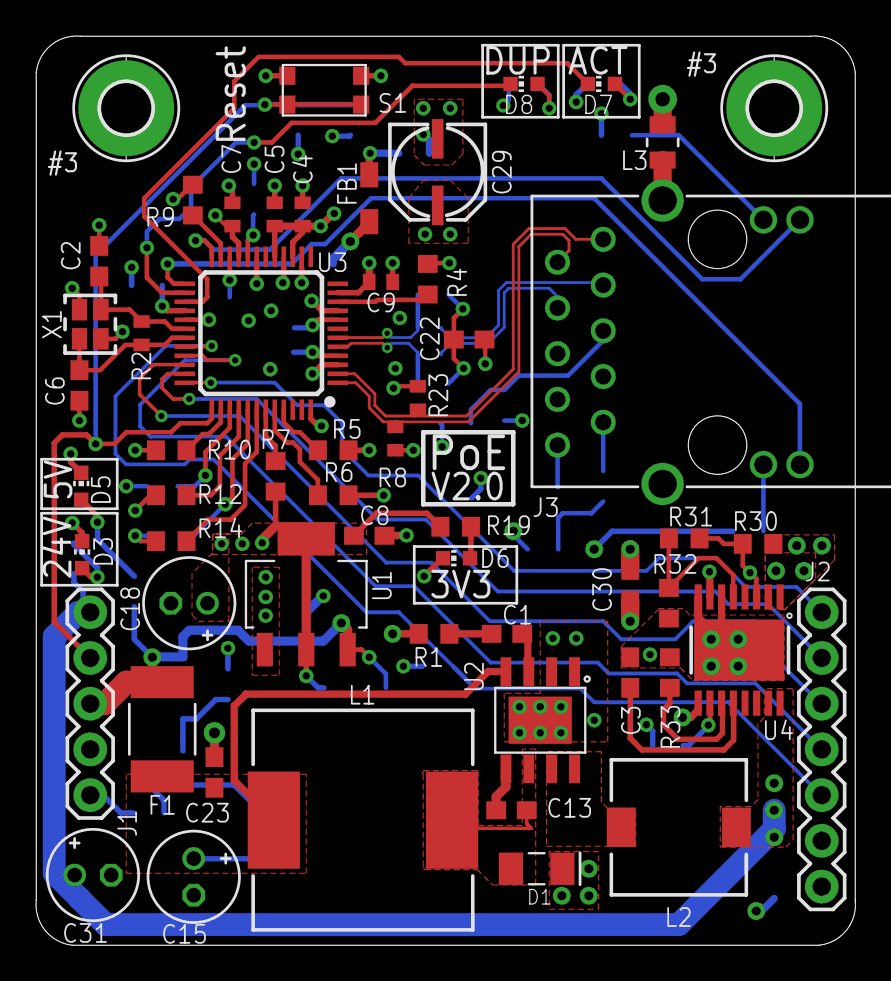
[picture p39: board rigatoni/ethernet_poe/v2/ethernet_poe.brd from above]

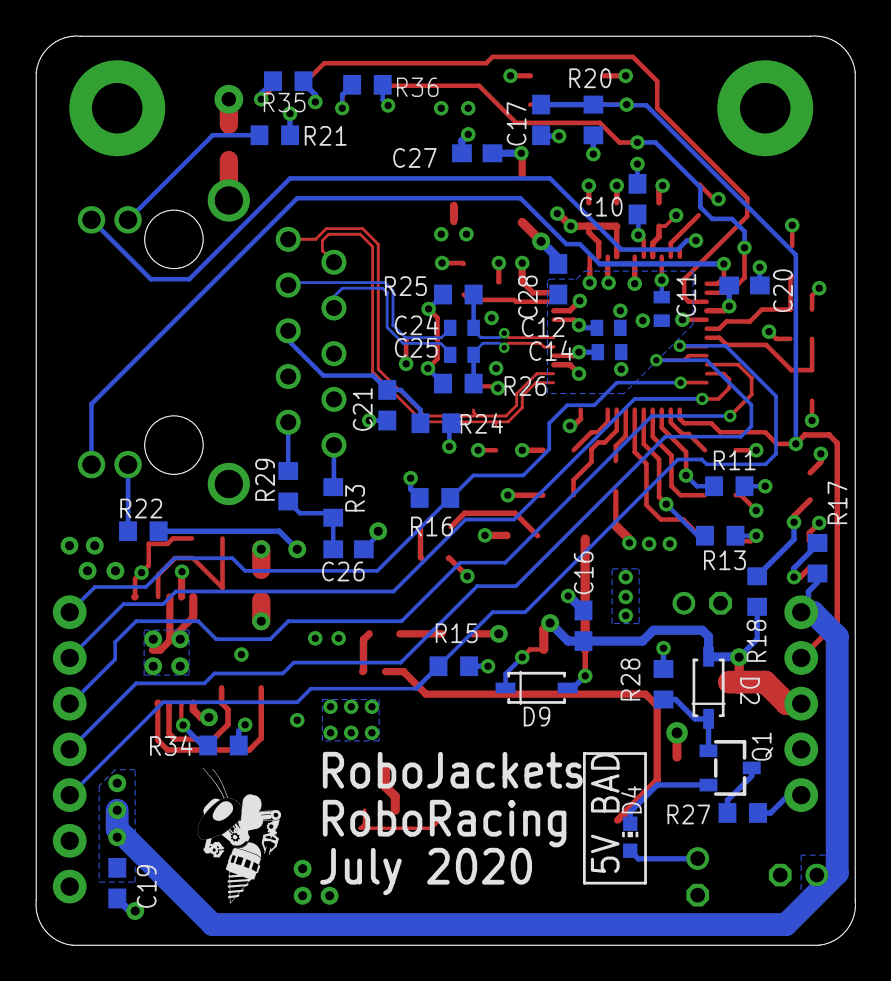
[picture p40: board rigatoni/ethernet_poe/v2/ethernet_poe.brd from below]

Board: 4 copper layers, 45.5 x 50.5 mm, 94 parts (38 on the bottom side), 64 nets.

Other parts of the board:
U$2: ROBOBUZZ_0.4X
