RoboJackets/roboracing-electrical/rigatoni/distributed-vision/DistributedVision.brd

## EAGLE design rigatoni/distributed-vision/DistributedVision.brd (2021-10-24)

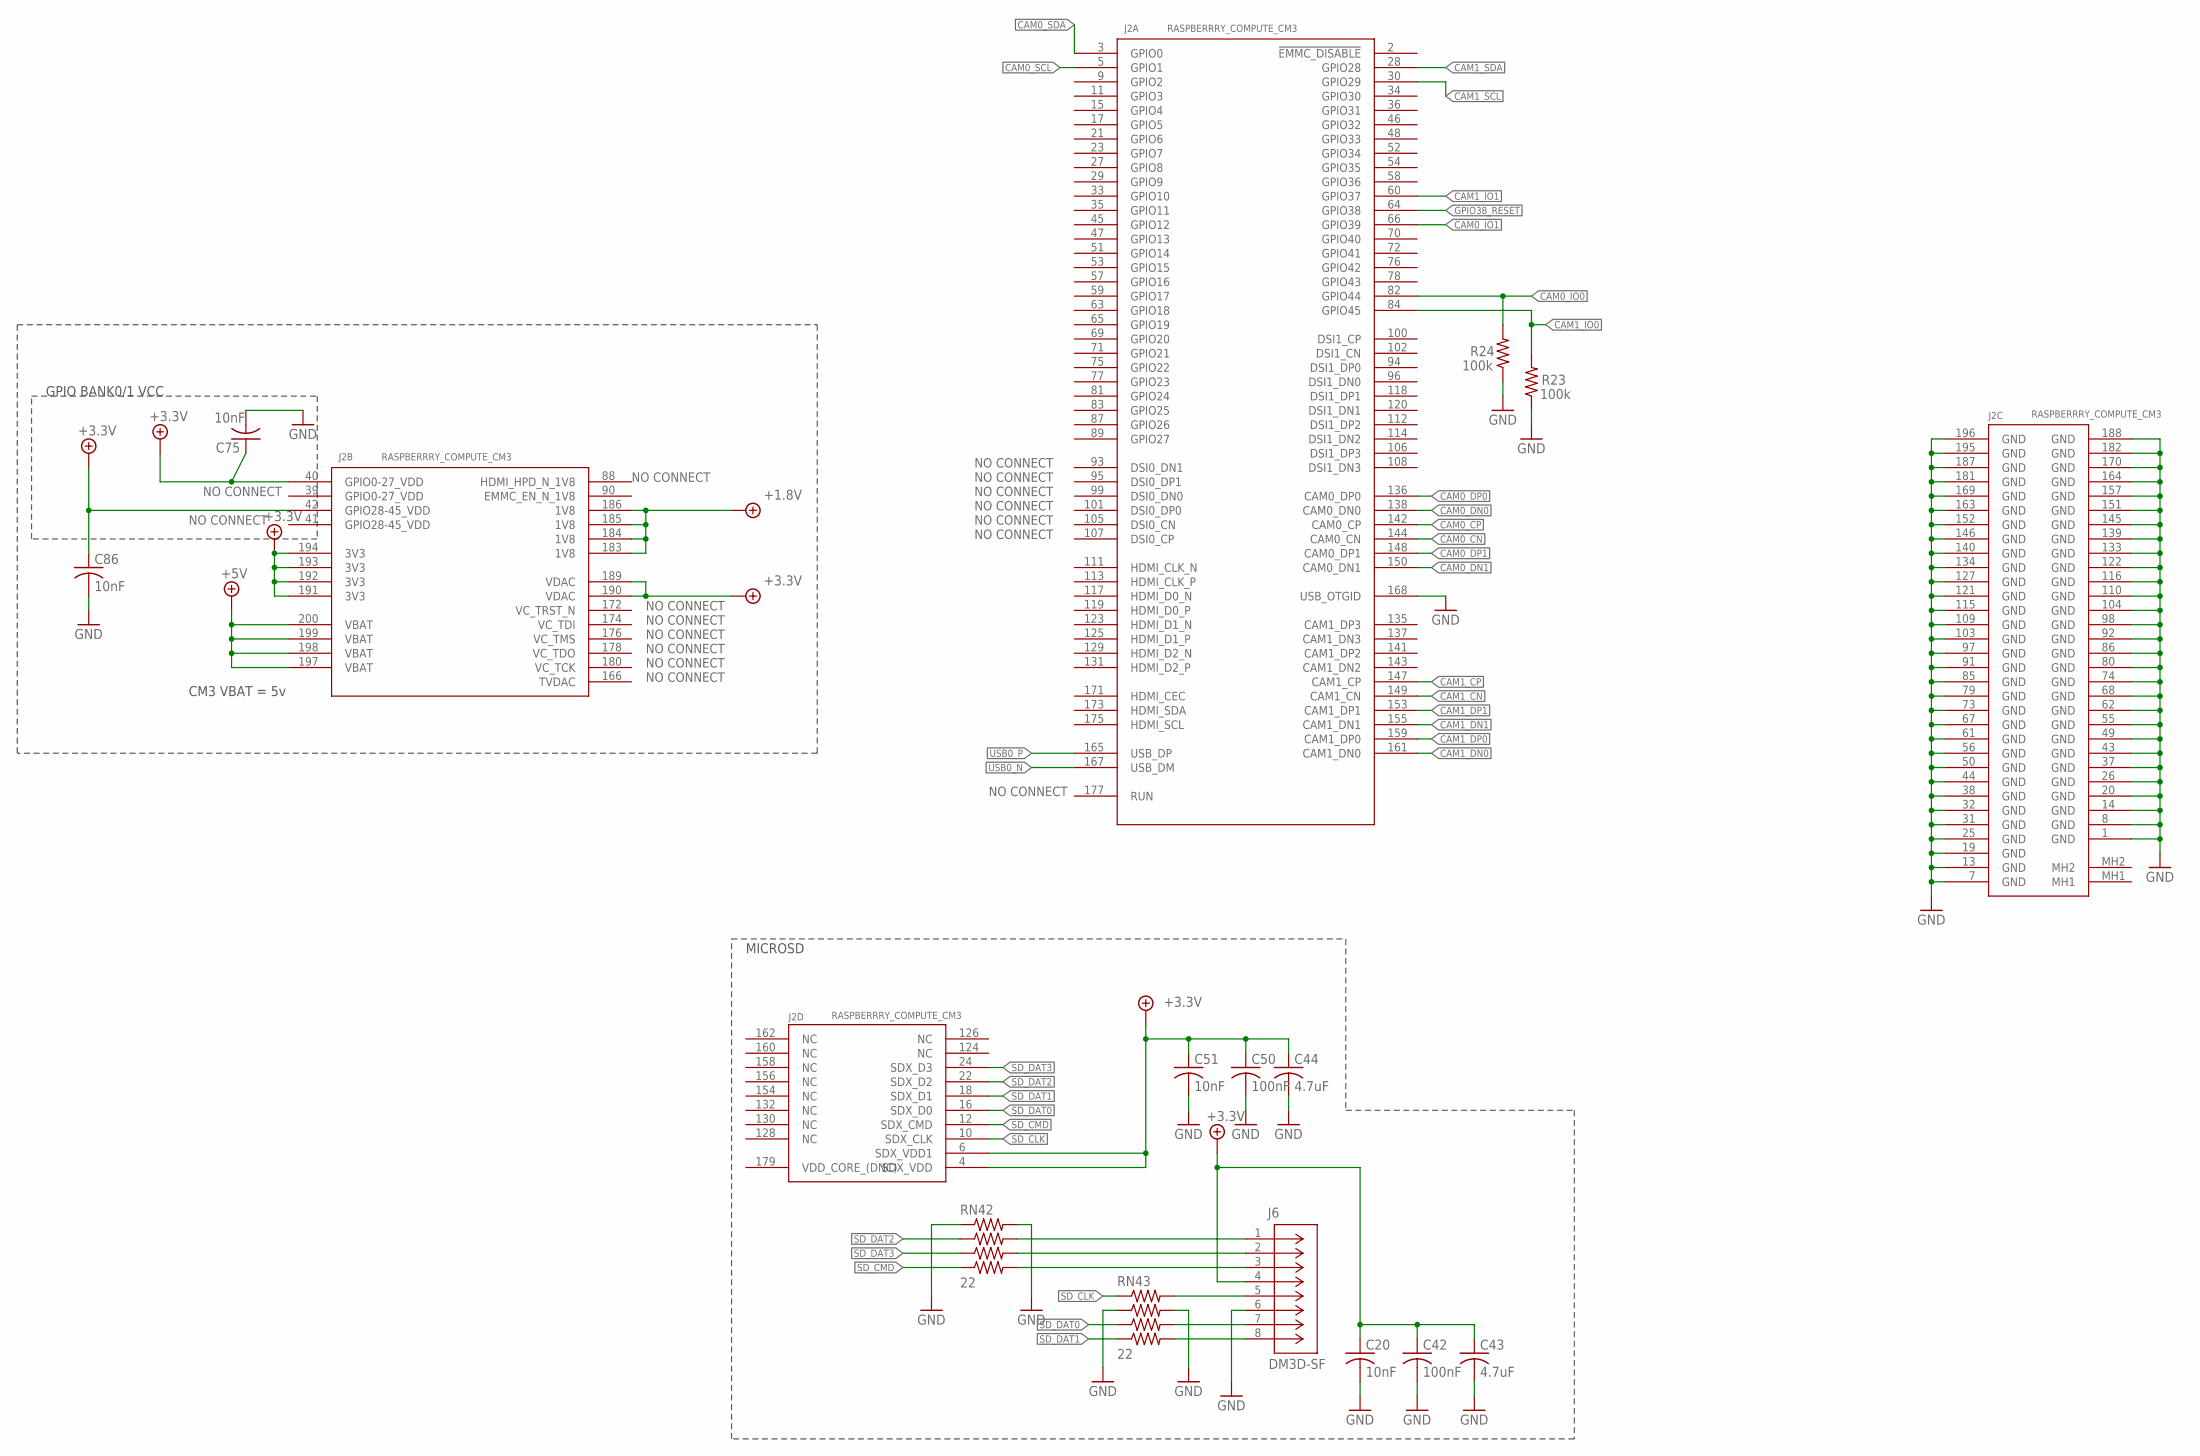
[picture p41: schematic DistributedVision.sch, sheet 1, Page 1]

Parts:
C20, C51, C75, C86: 10nF; C0603
C42, C50: 100nF; C0603
C43, C44: 4.7uF; C0603
J2: RASPBERRRY_COMPUTE_CM3; TE_1473149-4_WITH_CM3PLUS
J6: DM3D-SF; CONN8_DM3D-SF_HIR
R23, R24: 100k; R0603
RN42, RN43: 22; RA-4_1206

Connections:
+1.8V: J2.183 (1V8), J2.184 (1V8), J2.185 (1V8), J2.186 (1V8); also elsewhere on the board
+3.3V: C20.1, C42.1, C43.1, C44.1, C50.1, C51.1, C75.1, C86.1, J2.4 (SDX_VDD), J2.6 (SDX_VDD1), J2.40 (GPIO0-27_VDD), J2.42 (GPIO28-45_VDD), J2.189 (VDAC), J2.190 (VDAC), J2.191 (3V3), J2.192 (3V3), J2.193 (3V3), J2.194 (3V3), J6.4; also elsewhere on the board
+5V: J2.197 (VBAT), J2.198 (VBAT), J2.199 (VBAT), J2.200 (VBAT); also elsewhere on the board
CAM0_CN: J2.144 (CAM0_CN); also elsewhere on the board
CAM0_CP: J2.142 (CAM0_CP); also elsewhere on the board
CAM0_DN0: J2.138 (CAM0_DN0); also elsewhere on the board
CAM0_DN1: J2.150 (CAM0_DN1); also elsewhere on the board
CAM0_DP0: J2.136 (CAM0_DP0); also elsewhere on the board
CAM0_DP1: J2.148 (CAM0_DP1); also elsewhere on the board
CAM0_IO0: J2.82 (GPIO44), R24.2; also elsewhere on the board
CAM0_IO1: J2.66 (GPIO39); also elsewhere on the board
CAM0_SCL: J2.5 (GPIO1); also elsewhere on the board
CAM0_SDA: J2.3 (GPIO0); also elsewhere on the board
CAM1_CN: J2.149 (CAM1_CN); also elsewhere on the board
CAM1_CP: J2.147 (CAM1_CP); also elsewhere on the board
CAM1_DN0: J2.161 (CAM1_DN0); also elsewhere on the board
CAM1_DN1: J2.155 (CAM1_DN1); also elsewhere on the board
CAM1_DP0: J2.159 (CAM1_DP0); also elsewhere on the board
CAM1_DP1: J2.153 (CAM1_DP1); also elsewhere on the board
CAM1_IO0: J2.84 (GPIO45), R23.2; also elsewhere on the board
CAM1_IO1: J2.60 (GPIO37); also elsewhere on the board
CAM1_SCL: J2.30 (GPIO29); also elsewhere on the board
CAM1_SDA: J2.28 (GPIO28); also elsewhere on the board
GND: C20.2, C42.2, C43.2, C44.2, C50.2, C51.2, C75.2, C86.2, J2.1 (GND), J2.7 (GND), J2.8 (GND), J2.13 (GND), J2.14 (GND), J2.19 (GND), J2.20 (GND), J2.25 (GND), J2.26 (GND), J2.31 (GND), J2.32 (GND), J2.37 (GND), J2.38 (GND), J2.43 (GND), J2.44 (GND), J2.49 (GND), J2.50 (GND), J2.55 (GND), J2.56 (GND), J2.61 (GND), J2.62 (GND), J2.67 (GND), J2.68 (GND), J2.73 (GND), J2.74 (GND), J2.79 (GND), J2.80 (GND), J2.85 (GND), J2.86 (GND), J2.91 (GND), J2.92 (GND), J2.97 (GND), J2.98 (GND), J2.103 (GND), J2.104 (GND), J2.109 (GND), J2.110 (GND), J2.115 (GND), J2.116 (GND), J2.121 (GND), J2.122 (GND), J2.127 (GND), J2.133 (GND), J2.134 (GND), J2.139 (GND), J2.140 (GND), J2.145 (GND), J2.146 (GND), J2.151 (GND), J2.152 (GND), J2.157 (GND), J2.163 (GND), J2.164 (GND), J2.168 (USB_OTGID), J2.169 (GND), J2.170 (GND), J2.181 (GND), J2.182 (GND), J2.187 (GND), J2.188 (GND), J2.195 (GND), J2.196 (GND), J6.6, R23.1, R24.1, RN42.1, RN42.2, RN43.3, RN43.4; also elsewhere on the board
GPIO0-27_VDD: J2.39 (GPIO0-27_VDD)
GPIO28-45_VDD: J2.41 (GPIO28-45_VDD)
GPIO38_RESET: J2.64 (GPIO38)
unnamed: J6.1, RN42.4
unnamed: J6.2, RN42.6
unnamed: J6.3, RN42.8
unnamed: J6.5, RN43.2
unnamed: J6.7, RN43.6
unnamed: J6.8, RN43.8
SD_CLK: J2.10 (SDX_CLK), RN43.1
SD_CMD: J2.12 (SDX_CMD), RN42.7
SD_DAT0: J2.16 (SDX_D0), RN43.5
SD_DAT1: J2.18 (SDX_D1), RN43.7
SD_DAT2: J2.22 (SDX_D2), RN42.3
SD_DAT3: J2.24 (SDX_D3), RN42.5
USB0_N: J2.167 (USB_DM); also elsewhere on the board
USB0_P: J2.165 (USB_DP); also elsewhere on the board
VC_TCK: J2.180 (VC_TCK)
VC_TDO: J2.178 (VC_TDO)

Notes on the sheet:
MICROSD
NO CONNECT
GPIO BANK0/1 VCC
CM3 VBAT = 5v

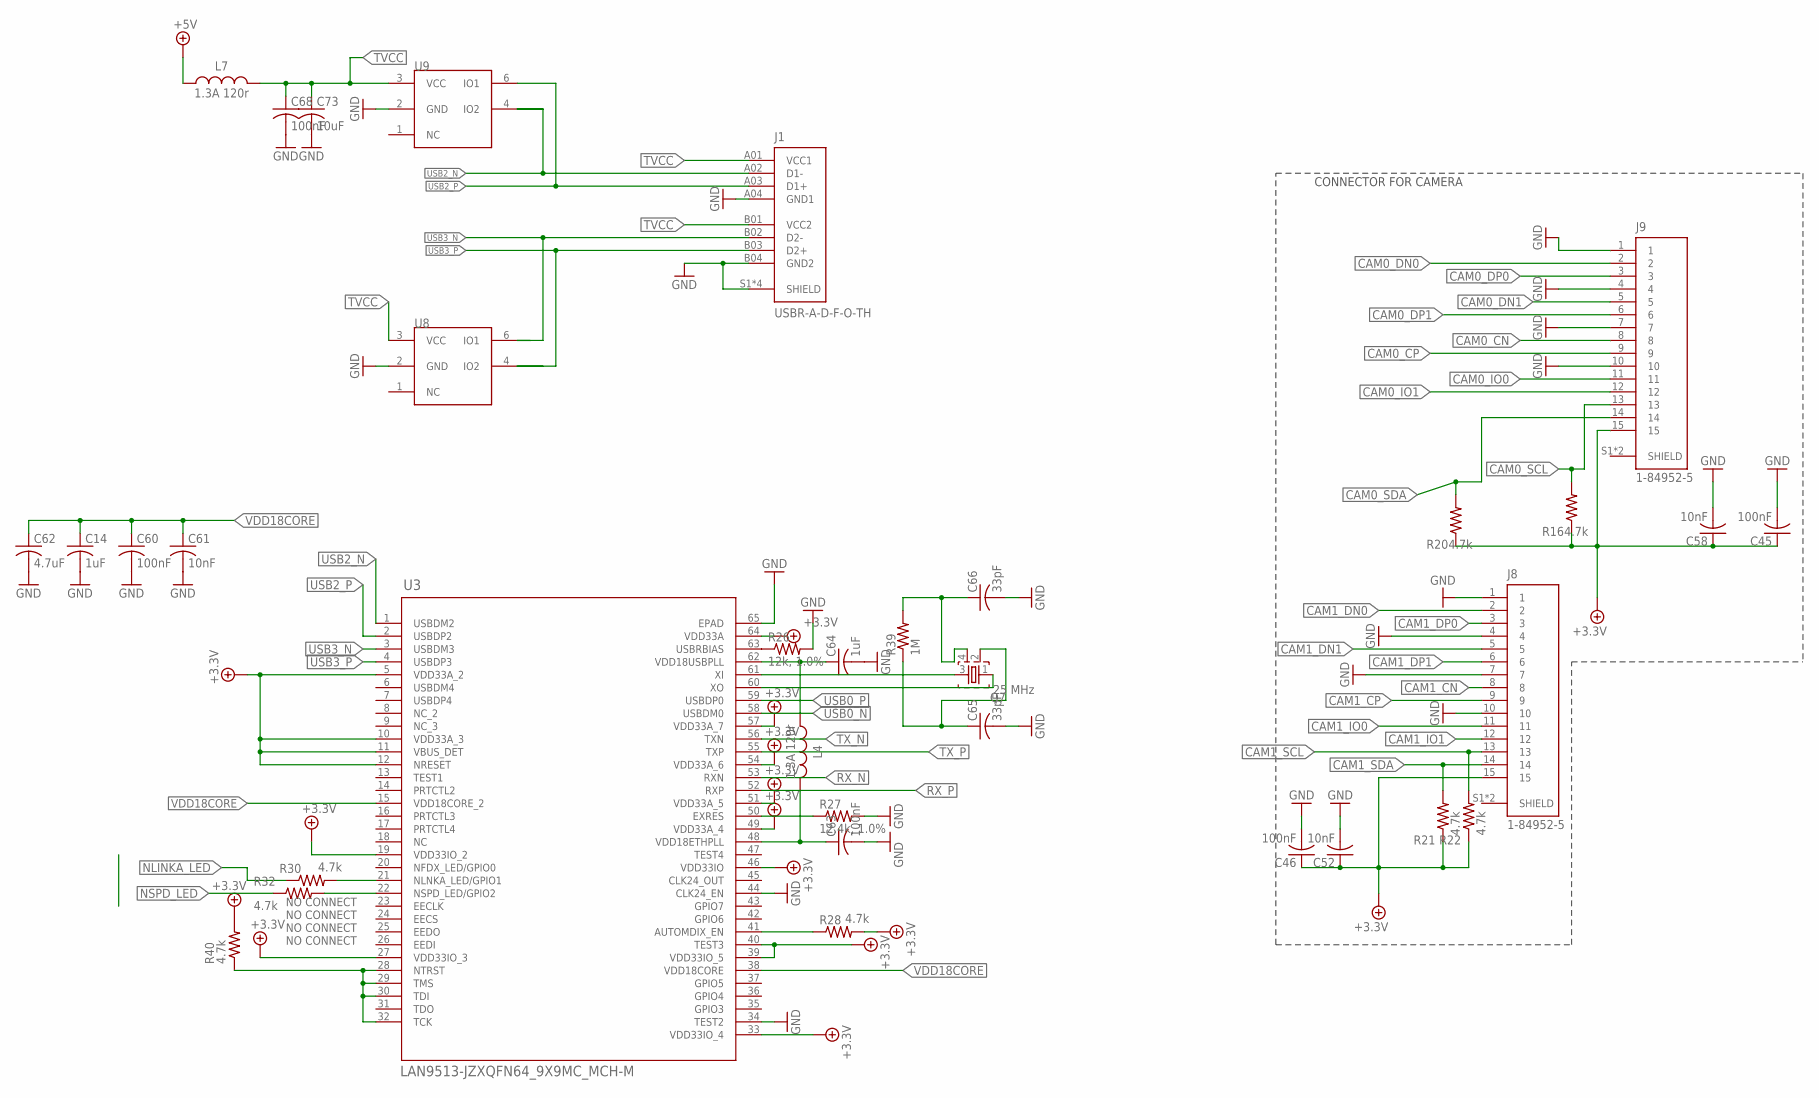
[picture p42: schematic DistributedVision.sch, sheet 2]

Parts:
C14, C64: 1uF; C0402
C45, C46: 100nF; C0603
C52, C58: 10nF; C0603
C60, C63, C68: 100nF; C0402
C61: 10nF; C0402
C62: 4.7uF; C0402
C65, C66: 33pF; C0402
C73: 10uF; C0402
J1: USBR-A-D-F-O-TH; SAMTEC_USBR-A-D-F-O-TH
J8, J9: 1-84952-5; TE_1-84952-5
L4, L7: 1.3A 120r; 0805
Q7: 25 MHz; FA-20H
R16, R20, R21, R22: 4.7k; R0603
R26: 12k, 1.0%; RC0805N
R27: 12.4k, 1.0%; RC0805N
R28, R30, R32, R40: 4.7k; RC0805N
R39: 1M; RC0805N
U3: LAN9513-JZXQFN64_9X9MC_MCH-M; QFN64_9X9MC_MCH-M
U8, U9: SP3003-02; SC70-5

Connections:
+3.3V: C45.1, C46.1, C52.1, C58.1, J8.15, J9.15, R16.1, R20.1, R21.1, R22.1, R28.2 (PIN2), R40.2 (PIN2), U3.5 (VDD33A_2), U3.10 (VDD33A_3), U3.11 (VBUS_DET), U3.12 (NRESET), U3.19 (VDD33IO_2), U3.27 (VDD33IO_3), U3.33 (VDD33IO_4), U3.39 (VDD33IO_5), U3.40 (TEST3), U3.46 (VDD33IO), U3.49 (VDD33A_4), U3.51 (VDD33A_5), U3.54 (VDD33A_6), U3.57 (VDD33A_7), U3.64 (VDD33A); also elsewhere on the board
+5V: L7.1; also elsewhere on the board
CAM0_CN: J9.8; also elsewhere on the board
CAM0_CP: J9.9; also elsewhere on the board
CAM0_DN0: J9.2; also elsewhere on the board
CAM0_DN1: J9.5; also elsewhere on the board
CAM0_DP0: J9.3; also elsewhere on the board
CAM0_DP1: J9.6; also elsewhere on the board
CAM0_IO0: J9.11; also elsewhere on the board
CAM0_IO1: J9.12; also elsewhere on the board
CAM0_SCL: J9.13, R16.2; also elsewhere on the board
CAM0_SDA: J9.14, R20.2; also elsewhere on the board
CAM1_CN: J8.8; also elsewhere on the board
CAM1_CP: J8.9; also elsewhere on the board
CAM1_DN0: J8.2; also elsewhere on the board
CAM1_DN1: J8.5; also elsewhere on the board
CAM1_DP0: J8.3; also elsewhere on the board
CAM1_DP1: J8.6; also elsewhere on the board
CAM1_IO0: J8.11; also elsewhere on the board
CAM1_IO1: J8.12; also elsewhere on the board
CAM1_SCL: J8.13, R22.2; also elsewhere on the board
CAM1_SDA: J8.14, R21.2; also elsewhere on the board
GND: C14.2, C45.2, C46.2, C52.2, C58.2, C60.2, C61.2, C62.2, C63.2, C64.2, C65.2, C66.2, C68.2, C73.2, J1.A04 (GND1), J1.B04 (GND2), J1.S1 (SHIELD), J1.S2 (SHIELD), J1.S3 (SHIELD), J1.S4 (SHIELD), J8.1, J8.4, J8.7, J8.10, J9.1, J9.4, J9.7, J9.10, R26.2 (PIN2), R27.2 (PIN2), U3.34 (TEST2), U3.44 (CLK24_EN), U3.65 (EPAD), U8.2 (GND), U9.2 (GND); also elsewhere on the board
unnamed: C64.1, L4.1, U3.62 (VDD18USBPLL)
unnamed: C63.1, L4.2, U3.48 (VDD18ETHPLL)
unnamed: R30.2 (PIN2), U3.21 (NLNKA_LED/GPIO1)
unnamed: R32.2 (PIN2), U3.22 (NSPD_LED/GPIO2)
unnamed: R40.1 (PIN1), U3.28 (NTRST), U3.29 (TMS), U3.30 (TDI), U3.32 (TCK)
unnamed: Q7.3, U3.61 (XI)
unnamed: Q7.1, U3.60 (XO)
unnamed: C66.1, Q7.4, R39.2 (PIN2)
unnamed: C65.1, Q7.2, R39.1 (PIN1)
unnamed: R26.1 (PIN1), U3.63 (USBRBIAS)
unnamed: R28.1 (PIN1), U3.41 (AUTOMDIX_EN)
unnamed: R27.1 (PIN1), U3.50 (EXRES)
NLINKA_LED: R30.1 (PIN1)
NSPD_LED: R32.1 (PIN1)
RX_N: U3.53 (RXN); also elsewhere on the board
RX_P: U3.52 (RXP); also elsewhere on the board
TVCC: C68.1, C73.1, J1.A01 (VCC1), J1.B01 (VCC2), L7.2, U8.3 (VCC), U9.3 (VCC)
TX_N: U3.56 (TXN); also elsewhere on the board
TX_P: U3.55 (TXP); also elsewhere on the board
USB0_N: U3.58 (USBDM0); also elsewhere on the board
USB0_P: U3.59 (USBDP0); also elsewhere on the board
USB2_N: J1.A02 (D1-), U3.1 (USBDM2)
USB2_P: J1.A03 (D1+), U3.2 (USBDP2)
USB3_N: J1.B02 (D2-), U3.3 (USBDM3)
USB3_P: J1.B03 (D2+), U3.4 (USBDP3)
USBDM2: U9.6 (IO1)
VDD18CORE: C14.1, C60.1, C61.1, C62.1, U3.15 (VDD18CORE_2), U3.38 (VDD18CORE)

Notes on the sheet:
CONNECTOR FOR CAMERA
NO CONNECT

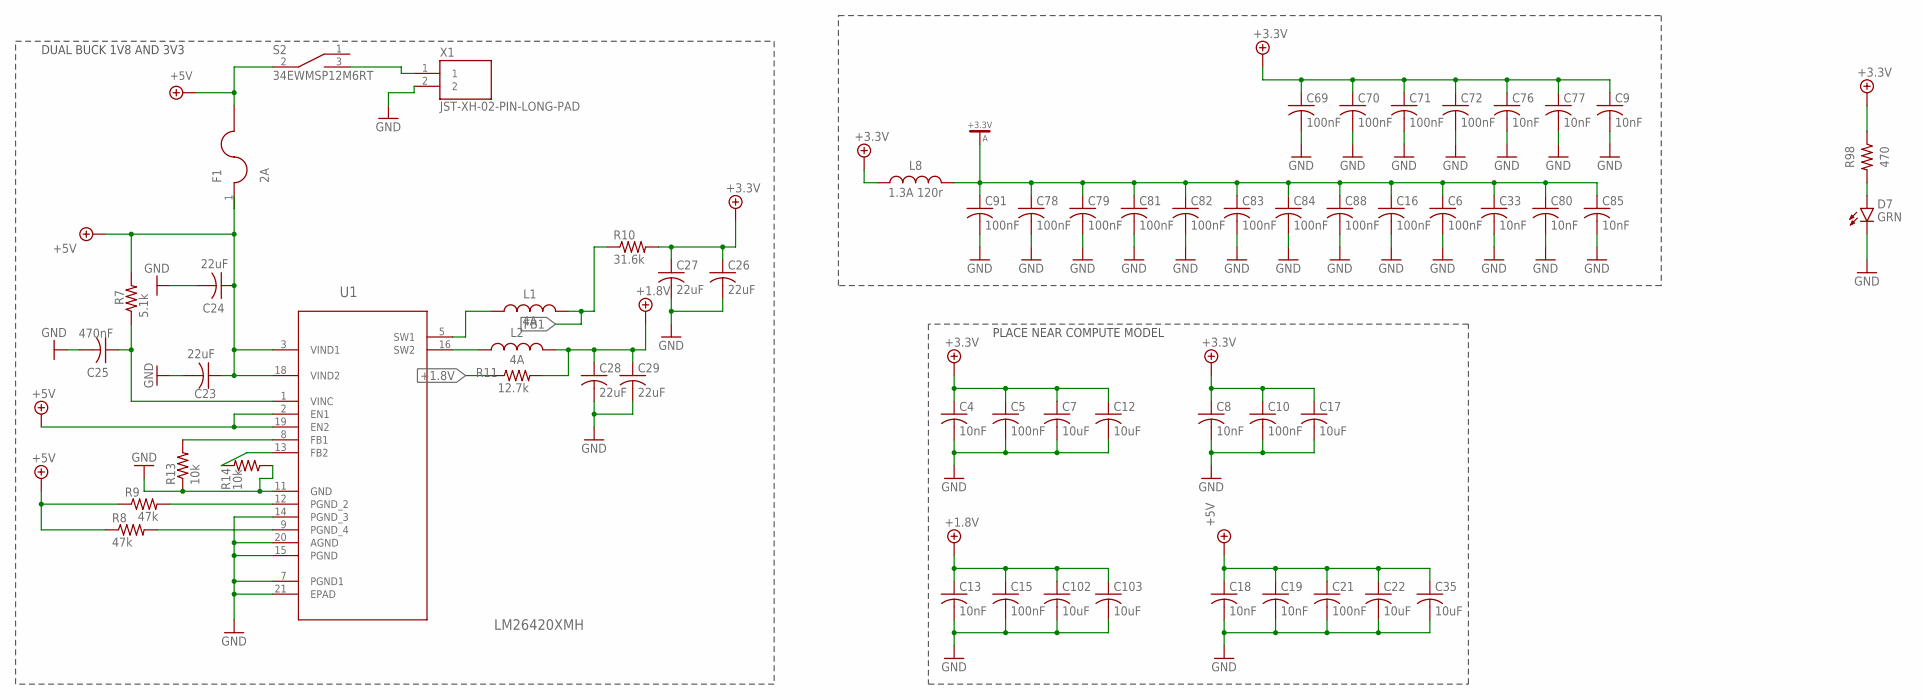
[picture p43: schematic DistributedVision.sch, sheet 3, Page 3]

Parts:
C4, C8, C9, C13, C18, C19, C33, C76, C77, C80, C85: 10nF; C0603
C5, C6, C10, C15, C16, C21, C69, C70, C71, C72, C78, C79, C81, C82, C83, C84, C88, C91: 100nF; C0603
C7, C12, C17, C22, C35, C102, C103: 10uF; C0603
C23, C24: 22uF; C0603
C25: 470nF; C0603
C26, C27, C28, C29: 22uF; C0805
D7: GRN; CHIP-LED0603
F1: 2A; 1812
L1, L2: 4A; 0805
L8: 1.3A 120r; 0805
R7: 5.1k; R0603
R8, R9: 47k; R0603
R10: 31.6k; R0603
R11: 12.7k; R0603
R13, R14: 10k; R0603
R98: 470; R0603
S2: 34EWMSP12M6RT
U1: LM26420XMH; SOP65P640X175-21N
X1: JST-XH-02-PIN-LONG-PAD; JST-XH-02-PACKAGE-LONG-PAD

Connections:
3V3_LED: D7.A, R98.2
+1.8V: C13.1, C15.1, C28.1, C29.1, C102.1, C103.1, L2.2, R11.2; also elsewhere on the board
+3.3V: C4.1, C5.1, C7.1, C8.1, C9.1, C10.1, C12.1, C17.1, C26.1, C27.1, C69.1, C70.1, C71.1, C72.1, C76.1, C77.1, L8.1, R10.2, R98.1; also elsewhere on the board
+3.3V-A: C6.1, C16.1, C33.1, C78.1, C79.1, C80.1, C81.1, C82.1, C83.1, C84.1, C85.1, C88.1, C91.1, L8.2
+5V: C18.1, C19.1, C21.1, C22.1, C23.1, C24.1, C35.1, F1.1, F1.2, R7.2, R8.1, R9.1, S2.2 (COMMON), U1.2 (EN1), U1.3 (VIND1), U1.18 (VIND2), U1.19 (EN2); also elsewhere on the board
BVCC: S2.3 (B), X1.1
FB1: L1.2, R10.1
GND: C4.2, C5.2, C6.2, C7.2, C8.2, C9.2, C10.2, C12.2, C13.2, C15.2, C16.2, C17.2, C18.2, C19.2, C21.2, C22.2, C23.2, C24.2, C25.2, C26.2, C27.2, C28.2, C29.2, C33.2, C35.2, C69.2, C70.2, C71.2, C72.2, C76.2, C77.2, C78.2, C79.2, C80.2, C81.2, C82.2, C83.2, C84.2, C85.2, C88.2, C91.2, C102.2, C103.2, D7.C, R13.1, R14.1, U1.7 (PGND1), U1.11 (GND), U1.14 (PGND_3), U1.15 (PGND), U1.20 (AGND), U1.21 (EPAD), X1.2; also elsewhere on the board
unnamed: R13.2, U1.8 (FB1)
unnamed: C25.1, R7.1, U1.1 (VINC)
unnamed: R8.2, U1.9 (PGND_4)
RX_N: L1.1, U1.5 (SW1); also elsewhere on the board
RX_P1: R9.2, U1.12 (PGND_2)
USBDM4: L2.1, U1.16 (SW2)
USBDP4: R14.2, U1.13 (FB2)

Notes on the sheet:
DUAL BUCK 1V8 AND 3V3
PLACE NEAR COMPUTE MODEL
