RoboJackets/roboracing-electrical/rigatoni/distributed-vision/DistributedVision.brd

## EAGLE design rigatoni/distributed-vision/DistributedVision.brd (continued)

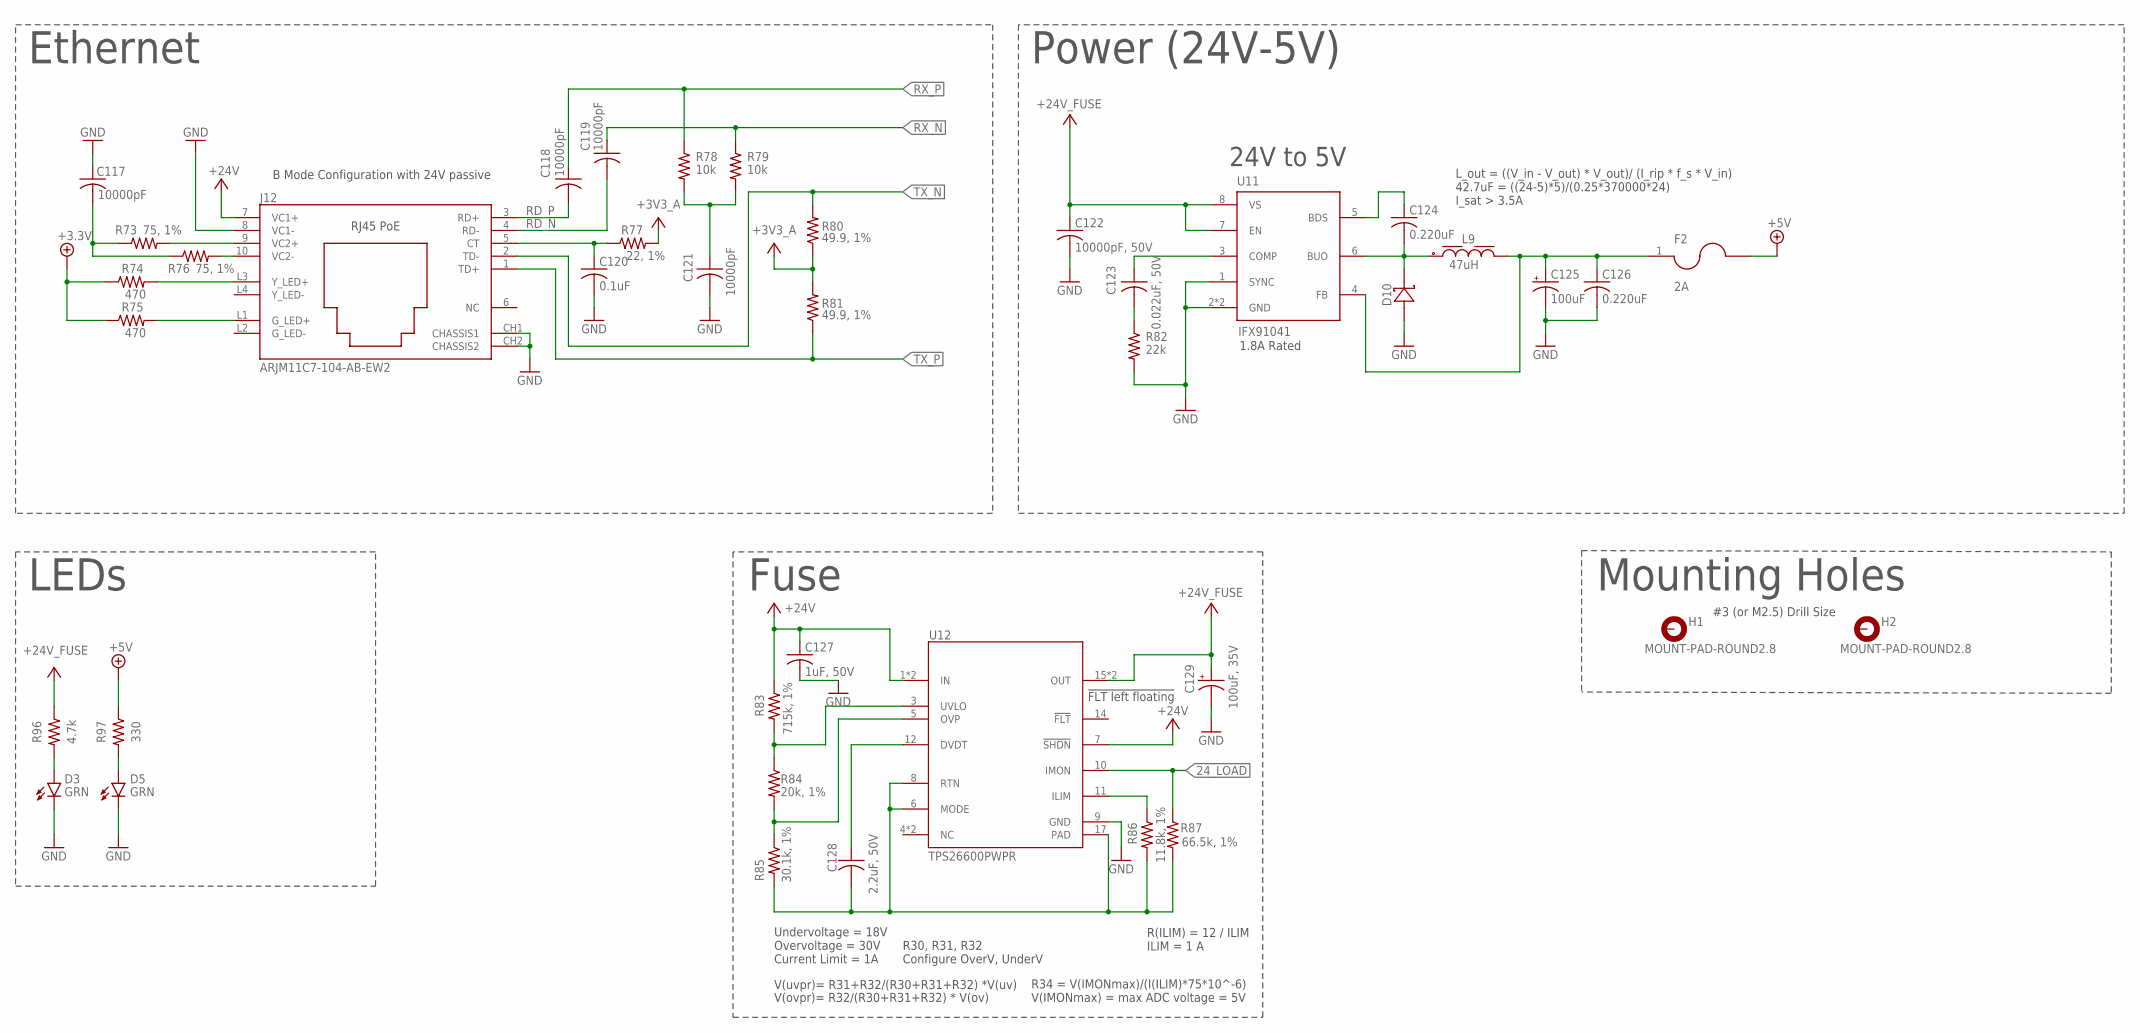
[picture p44: schematic DistributedVision.sch, sheet 4]

Parts:
C117, C121: 10000pF; C0603
C118, C119: 10000pF; C0402
C120: 0.1uF; C0402
C122: 10000pF, 50V; C0603
C123: 0.022uF, 50V; C0603
C124, C126: 0.220uF; C0603
C125: 100uF; E2-5
C127: 1uF, 50V; C0603
C128: 2.2uF, 50V; C0603
C129: 100uF, 35V; E2,5-7
D3, D5: GRN; CHIP-LED0603
D10: NTS260ESFT3G; SOD123FL_DIO
F2: 2A; 1812
H1, H2: MOUNT-PAD-ROUND2.8; 2,8-PAD
J12: ARJM11C7-104-AB-EW2; CONN_EW_ABR
L9: 47uH; WE-PD_1210
R73, R76: 75, 1%; R0603
R74, R75: 470; R0603
R77: 22, 1%; R0603
R78, R79: 10k; R0603
R80, R81: 49.9, 1%; R0402
R82: 22k; R0603
R83: 715k, 1%; R0603
R84: 20k, 1%; R0603
R85: 30.1k, 1%; R0603
R86: 11.8k, 1%; R0603
R87: 66.5k, 1%; R0603
R96: 4.7k; R0603
R97: 330; R0603
U11: IFX91041; SOIC-8-EXPOSED_PAD
U12: TPS26600PWPR; PWP0016H_N

Connections:
5V_LED: D5.A, R97.2
5V_RAW: C124.2, D10.1, L9.1, U11.6 (BUO)
24V_LED: D3.A, R96.2
24_LOAD: R87.1, U12.10 (IMON)
+3.3V: R74.1, R75.1; also elsewhere on the board
+3V3_A: R77.2, R80.1, R81.2
+5V: F2.2, R97.1; also elsewhere on the board
+5V_PREFUSE: C125.+, C126.1, F2.1, L9.2, U11.4 (FB)
+24V: C127.1, J12.7 (VC1+), R83.1, U12.1 (IN), U12.2 (IN), U12.7 (!SHDN)
+24V_FUSE: C122.1, C129.+, R96.1, U11.7 (EN), U11.8 (VS), U12.15 (OUT), U12.16 (OUT)
CT: C120.1, J12.5 (CT), R77.1
GND: C117.1, C120.2, C121.2, C122.2, C125.-, C126.2, C127.2, C129.-, D3.C, D5.C, D10.2, J12.8 (VC1-), J12.CH1 (CHASSIS1), J12.CH2 (CHASSIS2), R82.2, U11.1 (SYNC), U11.2 (GND), U11.9 (GND), U12.9 (GND); also elsewhere on the board
G_LED+: J12.L1 (G_LED+), R75.2
unnamed: C123.1, U11.3 (COMP)
unnamed: J12.9 (VC2+), R73.2
unnamed: J12.10 (VC2-), R76.2
unnamed: C124.1, U11.5 (BDS)
unnamed: C123.2, R82.1
unnamed: C117.2, R73.1, R76.1
unnamed: R83.2, R84.1, U12.3 (UVLO)
unnamed: R84.2, R85.1, U12.5 (OVP)
unnamed: C128.1, U12.12 (DVDT)
unnamed: R86.1, U12.11 (ILIM)
RD_N: C119.2, J12.4 (RD-)
RD_P: C118.2, J12.3 (RD+)
RTN: C128.2, R85.2, R86.2, R87.2, U12.6 (MODE), U12.8 (RTN), U12.17 (PAD)
RX_FILTER: C121.1, R78.2, R79.2
RX_N: C119.1, R79.1; also elsewhere on the board
RX_P: C118.1, R78.1; also elsewhere on the board
TX_N: J12.2 (TD-), R80.2; also elsewhere on the board
TX_P: J12.1 (TD+), R81.1; also elsewhere on the board
Y_LED+: J12.L3 (Y_LED+), R74.2

Notes on the sheet:
Power (24V-5V)
LEDs
Ethernet
24V to 5V
B Mode Configuration with 24V passive
R(ILIM) = 12 / ILIM ILIM = 1 A
Undervoltage = 18V Overvoltage = 30V Current Limit = 1A
R30, R31, R32 Configure OverV, UnderV
V(ovpr)= R32/(R30+R31+R32) * V(ov)
V(uvpr)= R31+R32/(R30+R31+R32) *V(uv)
Fuse
!FLT left floating
Mounting Holes
R34 = V(IMONmax)/(I(ILIM)*75*10^-6) V(IMONmax) = max ADC voltage = 5V
1.8A Rated
#3 (or M2.5) Drill Size
L_out = ((V_in - V_out) * V_out)/ (I_rip * f_s * V_in) 42.7uF = ((24-5)*5)/(0.25*370000*24) I_sat > 3.5A

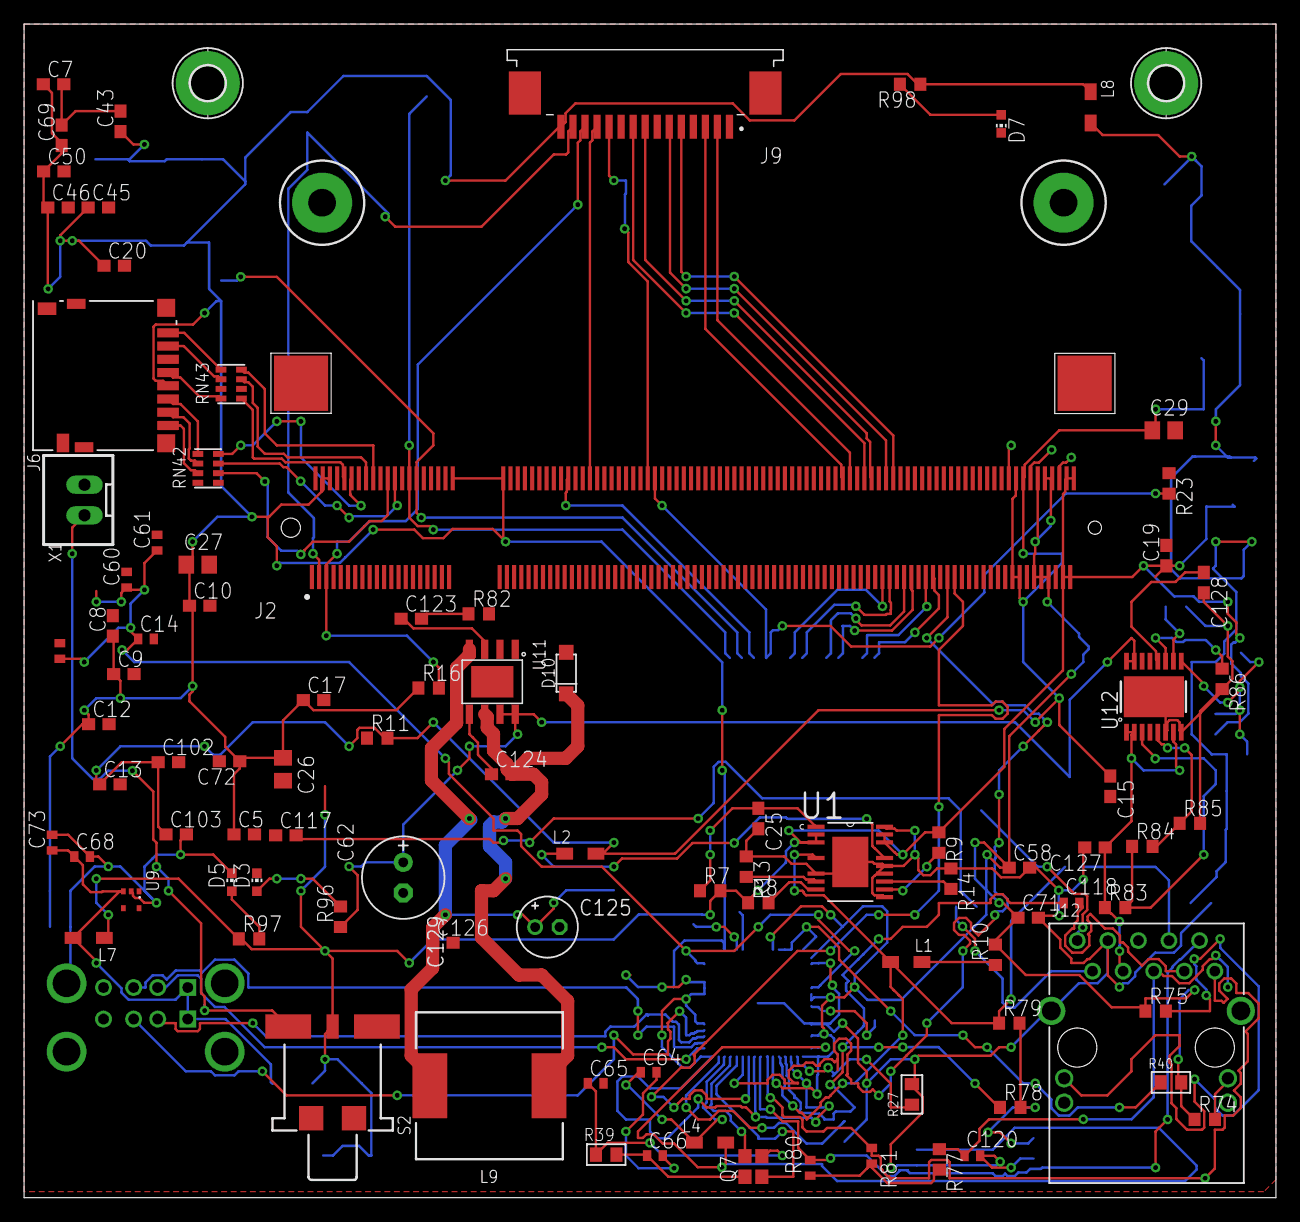
[picture p45: board DistributedVision.brd from above]

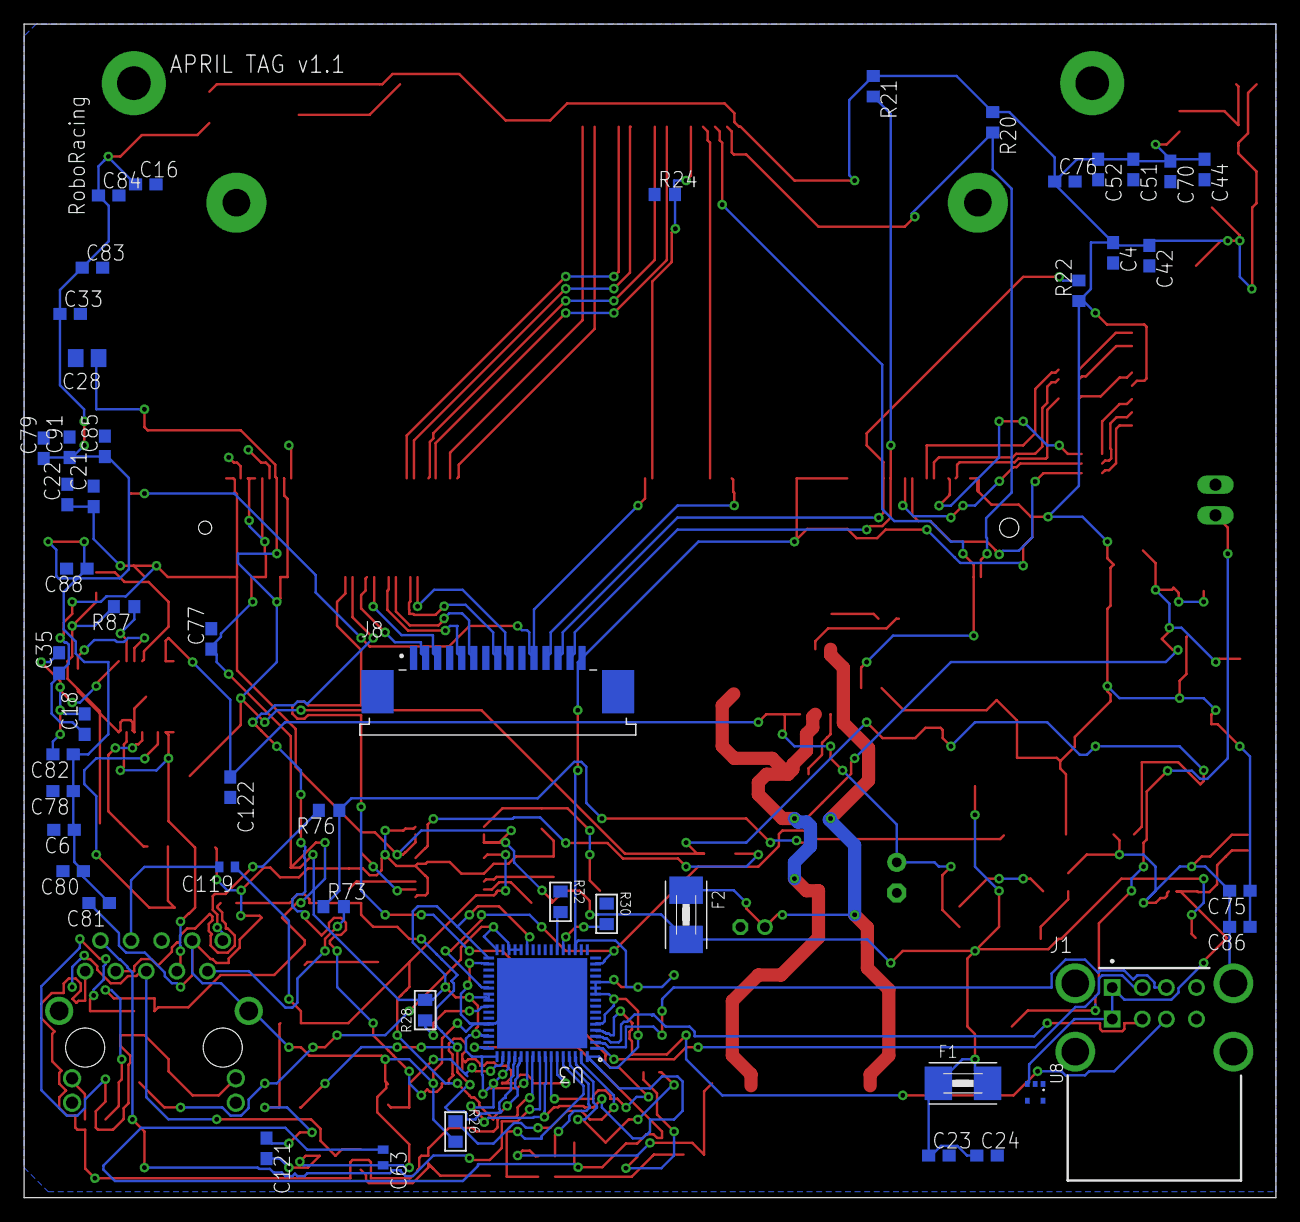
[picture p46: board DistributedVision.brd from below]

Board: 2 copper layers, 104.0 x 97.5 mm, 147 parts (51 on the bottom side), 95 nets.
