RoboJackets/roboracing-electrical/rigatoni/estop_motherboard/EVGP_Estop_Motherboard.brd

## EAGLE design rigatoni/estop_motherboard/EVGP_Estop_Motherboard.brd (2020-05-11)

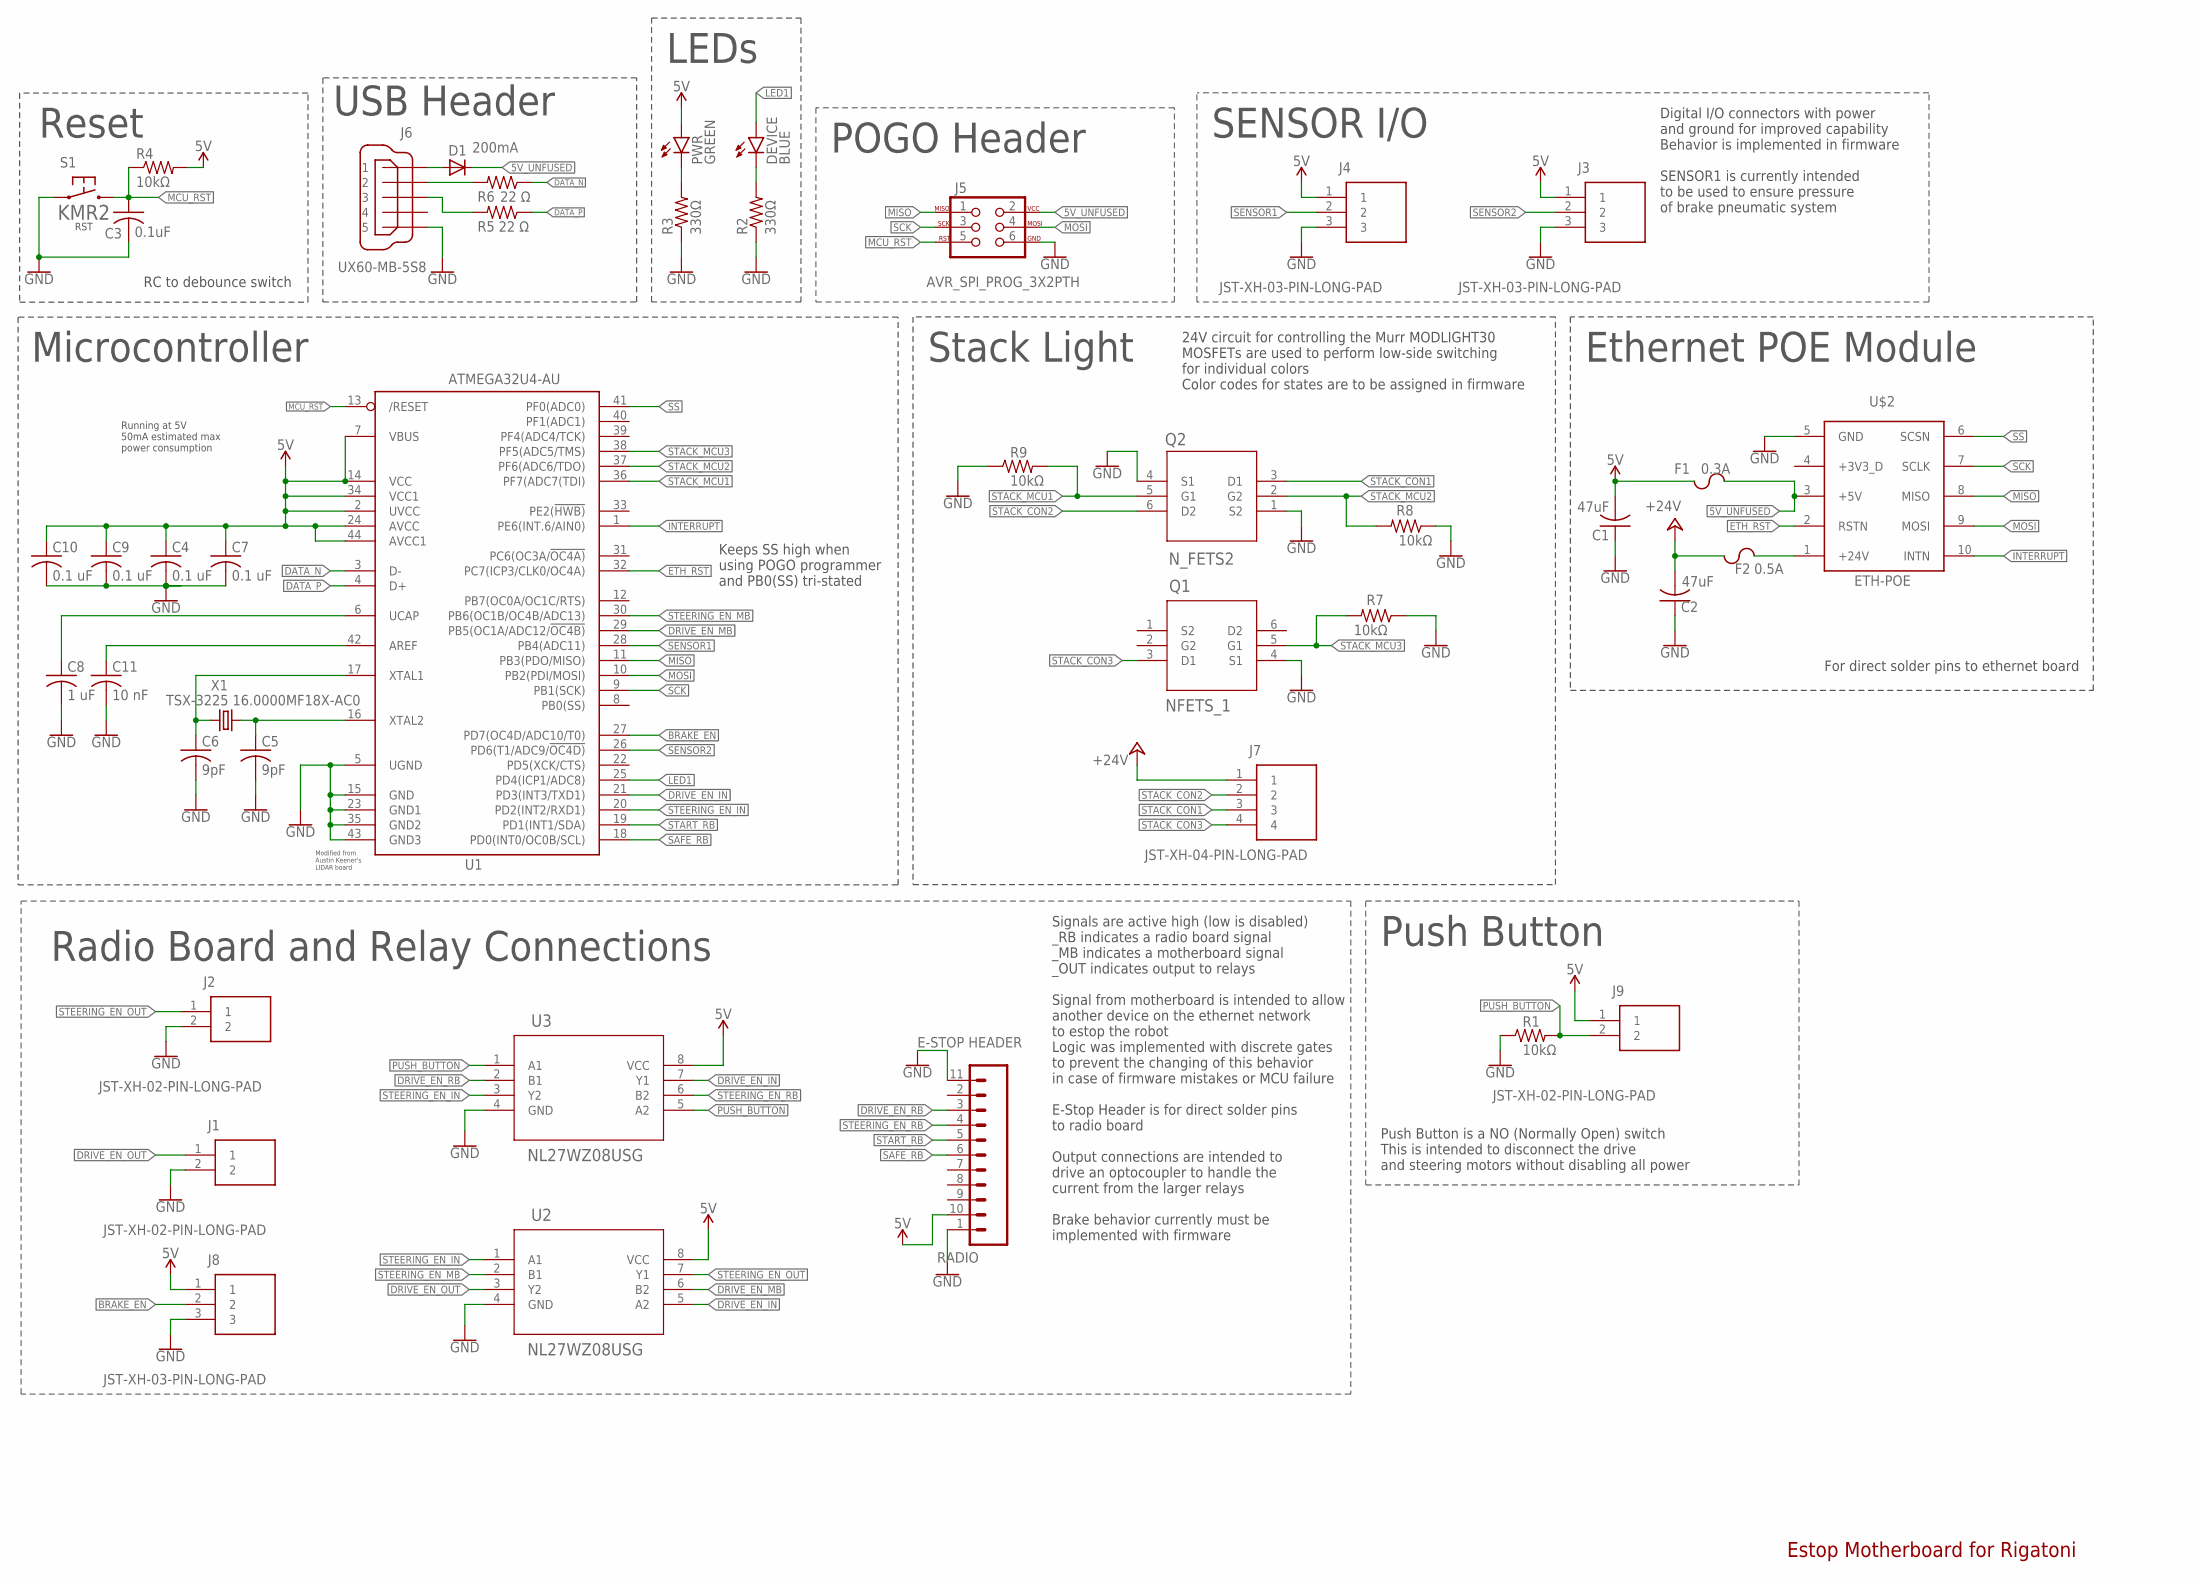
[picture p47: schematic EVGP_Estop_Motherboard.sch]

Parts:
C1, C2: 47uF; C1206
C3: 0.1uF; C0603
C4, C7, C9, C10: 0.1 uF; C0603
C5, C6: 9pF; C0603
C8: 1 uF; C0603
C11: 10 nF; C0603
D1: 200mA; SOD323-R
DEVICE: BLUE; CHIP-LED0603
F1: 0.3A; F1206
F2: 0.5A; F1206
J1, J2, J9: JST-XH-02-PIN-LONG-PAD; JST-XH-02-PACKAGE-LONG-PAD
J3, J4, J8: JST-XH-03-PIN-LONG-PAD; JST-XH-03-PACKAGE-LONG-PAD
J5: AVR_SPI_PROG_3X2PTH; 2X3
J6: UX60-MB-5S8
J7: JST-XH-04-PIN-LONG-PAD; JST-XH-04-PACKAGE-LONG-PAD
PWR: GREEN; CHIP-LED0603
Q1: NFETS_1; SOT-363
Q2: N_FETS2; SOT-363
R1, R4, R7, R8, R9: 10kΩ; R0603
R2, R3: 330Ω; R0603
R5, R6: 22 Ω; R0603
RADIO: E-STOP HEADER; RADIO_V1.3
S1: KMR2
U1: ATMEGA32U4-AU; TQFP44
U2, U3: NL27WZ08USG; US8_2P40X2P10
U$2: ETH-POE; HDRVR10W64P4000X254_2X5_1016X508X254B
X1: TSX-3225 16.0000MF18X-AC0; XTAL-3.2X2.5

Connections:
5V: C1.2, C4.1, C7.1, C9.1, C10.1, F1.1, J3.1, J4.1, J8.1, J9.1, PWR.A, R4.2, RADIO.10 (5V), U1.2 (UVCC), U1.7 (VBUS), U1.14 (VCC), U1.24 (AVCC), U1.34 (VCC1), U1.44 (AVCC1), U2.8 (VCC), U3.8 (VCC)
5V_UNFUSED: D1.C, F1.2, J5.2, U$2.3 (+5V)
24V_UNFUSED: F2.2, U$2.1 (+24V)
+24V: C2.2, F2.1, J7.1
AREF: C11.1, U1.42 (AREF)
BRAKE_EN: J8.2, U1.27 (PD7(OC4D/ADC10/T0))
DATA_N: R6.1, U1.3 (D-)
DATA_P: R5.1, U1.4 (D+)
DRIVE_EN_IN: U1.21 (PD3(INT3/TXD1)), U2.5 (A2), U3.7 (Y1)
DRIVE_EN_MB: U1.29 (PB5(OC1A/ADC12/!OC4B)), U2.6 (B2)
DRIVE_EN_OUT: J1.1, U2.3 (Y2)
DRIVE_EN_RB: RADIO.3 (D1), U3.2 (B1)
ETH_RST: U1.32 (PC7(ICP3/CLK0/OC4A)), U$2.2 (RSTN)
GND: C1.1, C2.1, C3.2, C4.2, C5.2, C6.2, C7.2, C8.2, C9.2, C10.2, C11.2, J1.2, J2.2, J3.3, J4.3, J5.6, J6.5, J8.3, Q1.4 (S1), Q2.1 (S2), Q2.4 (S1), R1.1, R2.1, R3.1, R7.1, R8.1, R9.1, RADIO.1 (GND), RADIO.11 (GND), S1.1.1 (1), S1.1.2 (1), U1.5 (UGND), U1.15 (GND), U1.23 (GND1), U1.35 (GND2), U1.43 (GND3), U2.4 (GND), U3.4 (GND), U$2.5 (GND)
INTERRUPT: U1.1 (PE6(INT.6/AIN0)), U$2.10 (INTN)
LED1: DEVICE.A, U1.25 (PD4(ICP1/ADC8))
MCU_RST: C3.1, J5.5, R4.1, S1.2.1 (2), S1.2.2 (2), U1.13 (/RESET)
MISO: J5.1, U1.11 (PB3(PDO/MISO)), U$2.8 (MISO)
MOSI: J5.4, U1.10 (PB2(PDI/MOSI)), U$2.9 (MOSI)
unnamed: PWR.C, R3.2
unnamed: J6.2, R6.2
unnamed: DEVICE.C, R2.2
unnamed: D1.A, J6.1
unnamed: J6.3, R5.2
PUSH_BUTTON: J9.2, R1.2, U3.1 (A1), U3.5 (A2)
SAFE_RB: RADIO.6 (D4), U1.18 (PD0(INT0/OC0B/SCL))
SCK: J5.3, U1.9 (PB1(SCK)), U$2.7 (SCLK)
SENSOR1: J4.2, U1.28 (PB4(ADC11))
SENSOR2: J3.2, U1.26 (PD6(T1/ADC9/!OC4D))
SS: U1.41 (PF0(ADC0)), U$2.6 (SCSN)
STACK_CON1: J7.3, Q2.3 (D1)
STACK_CON2: J7.2, Q2.6 (D2)
STACK_CON3: J7.4, Q1.3 (D1)
STACK_MCU1: Q2.5 (G1), R9.2, U1.36 (PF7(ADC7(TDI))
STACK_MCU2: Q2.2 (G2), R8.2, U1.37 (PF6(ADC6/TDO))
STACK_MCU3: Q1.5 (G1), R7.2, U1.38 (PF5(ADC5/TMS))
START_RB: RADIO.5 (D3), U1.19 (PD1(INT1/SDA))
STEERING_EN_IN: U1.20 (PD2(INT2/RXD1)), U2.1 (A1), U3.3 (Y2)
STEERING_EN_MB: U1.30 (PB6(OC1B/OC4B/ADC13)), U2.2 (B1)
STEERING_EN_OUT: J2.1, U2.7 (Y1)
STEERING_EN_RB: RADIO.4 (D2), U3.6 (B2)
UCAP: C8.1, U1.6 (UCAP)
XTAL1: C6.1, U1.17 (XTAL1), X1.1
XTAL2: C5.1, U1.16 (XTAL2), X1.3 (2)

Notes on the sheet:
Modified from Austin Keener's LIDAR board
POGO Header
RC to debounce switch
Reset
LEDs
Running at 5V 50mA estimated max power consumption
Microcontroller
USB Header
Keeps SS high when using POGO programmer and PB0(SS) tri-stated
Radio Board and Relay Connections
SENSOR I/O
Stack Light
Ethernet POE Module
Estop Motherboard for Rigatoni
Push Button
Signals are active high (low is disabled) _RB indicates a radio board signal _MB indicates a motherboard signal _OUT indicates output to relays Signal from motherboard is intended to allow another device on the ethernet network to estop the robot Logic was implemented with discrete gates to prevent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
Push Button is a NO (Normally Open) switch This is intended to disconnect the drive and steering motors without disabling all power
24V circuit for controlling the Murr MODLIGHT30 MOSFETs are used to perform low-side switching for individual colors Color codes for states are to be assigned in firmware
Digital I/O connectors with power and ground for improved capability Behavior is implemented in firmware SENSOR1 is currently intended to be used to ensure pressure of brake pneumatic system
For direct solder pins to ethernet board

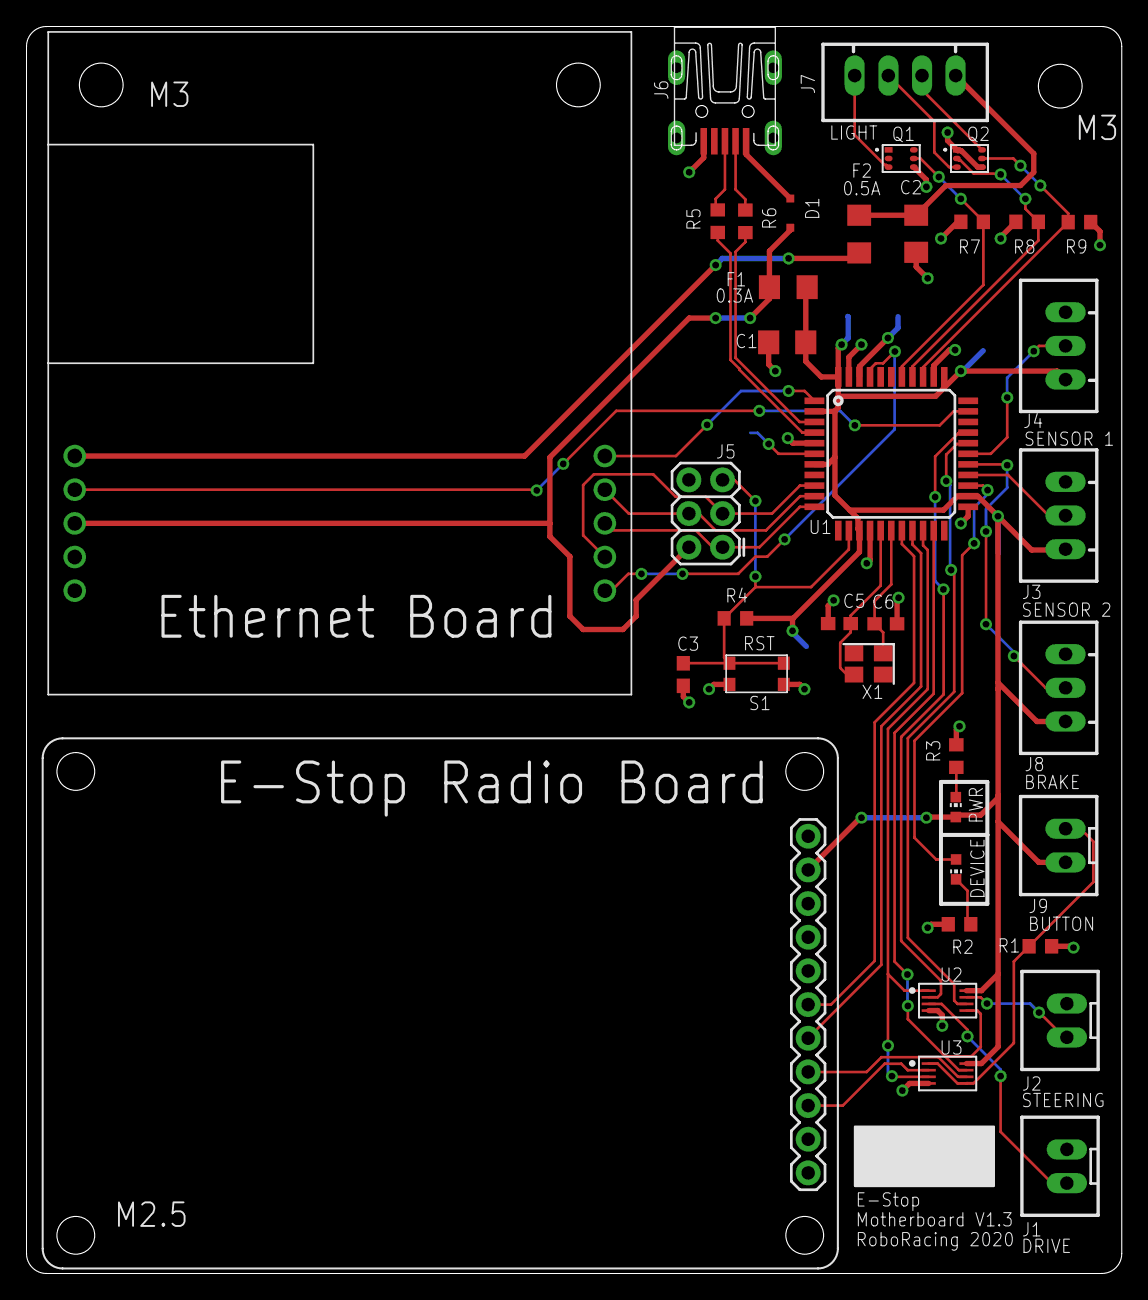
[picture p48: board EVGP_Estop_Motherboard.brd from above]

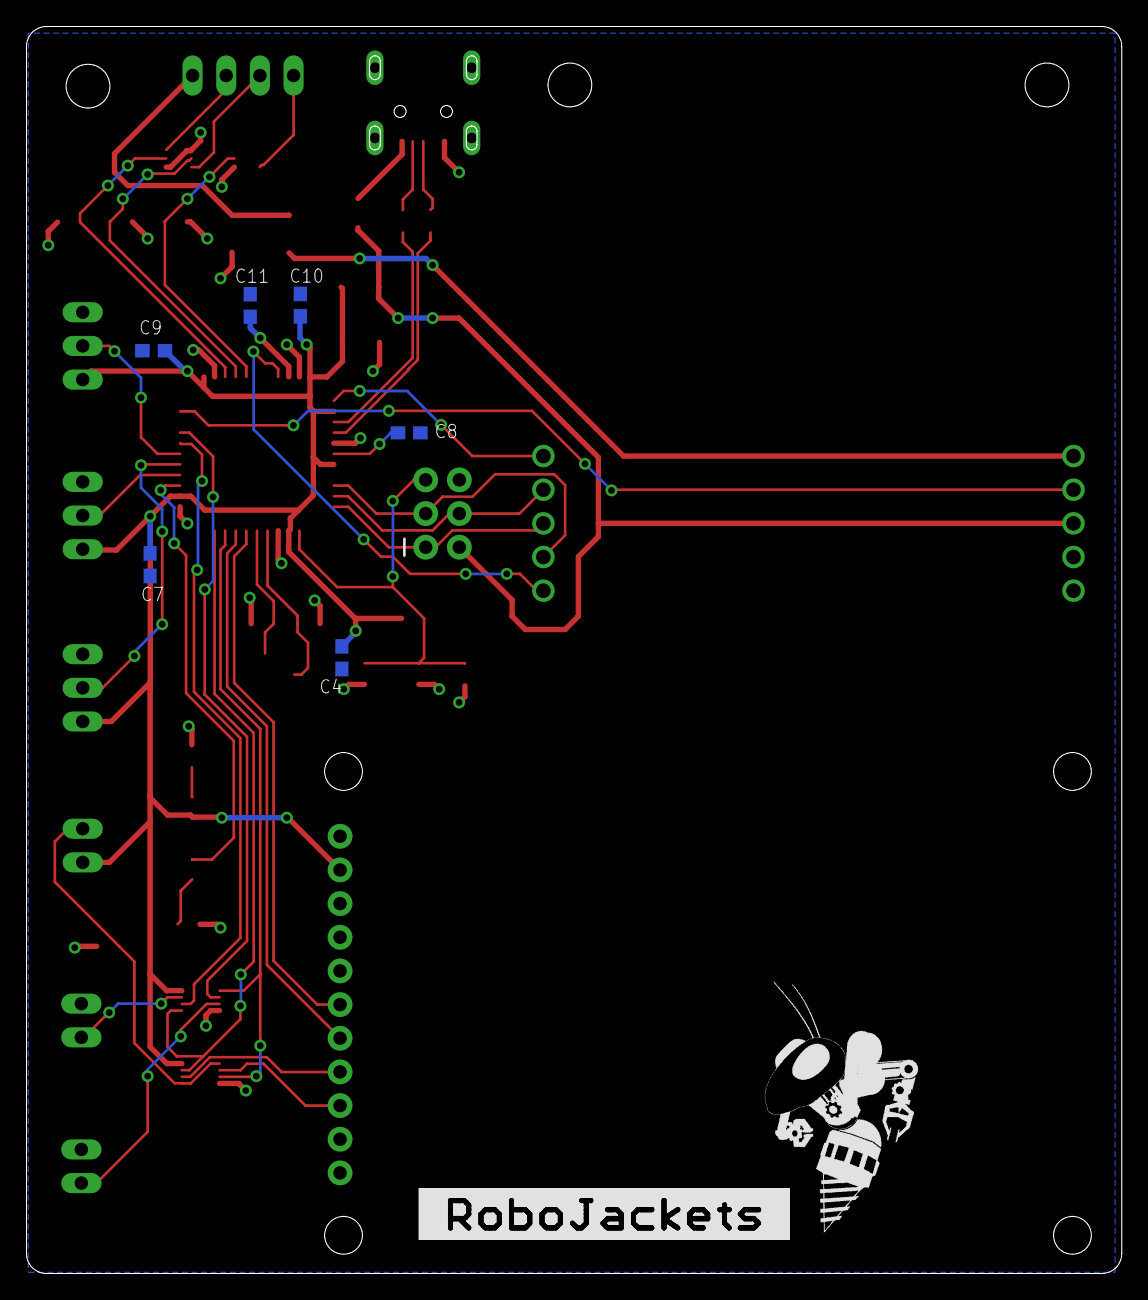
[picture p49: board EVGP_Estop_Motherboard.brd from below]

Board: 2 copper layers, 82.6 x 94.1 mm, 45 parts (8 on the bottom side), 44 nets.

Other parts of the board:
U$1: ROBOBUZZ_1.0X
U$3: ROBOJACKETS
