RoboJackets/roboracing-electrical/rigatoni/ethernet_top_board/ethernet_top_board.brd

## EAGLE design rigatoni/ethernet_top_board/ethernet_top_board.brd (2020-09-19)

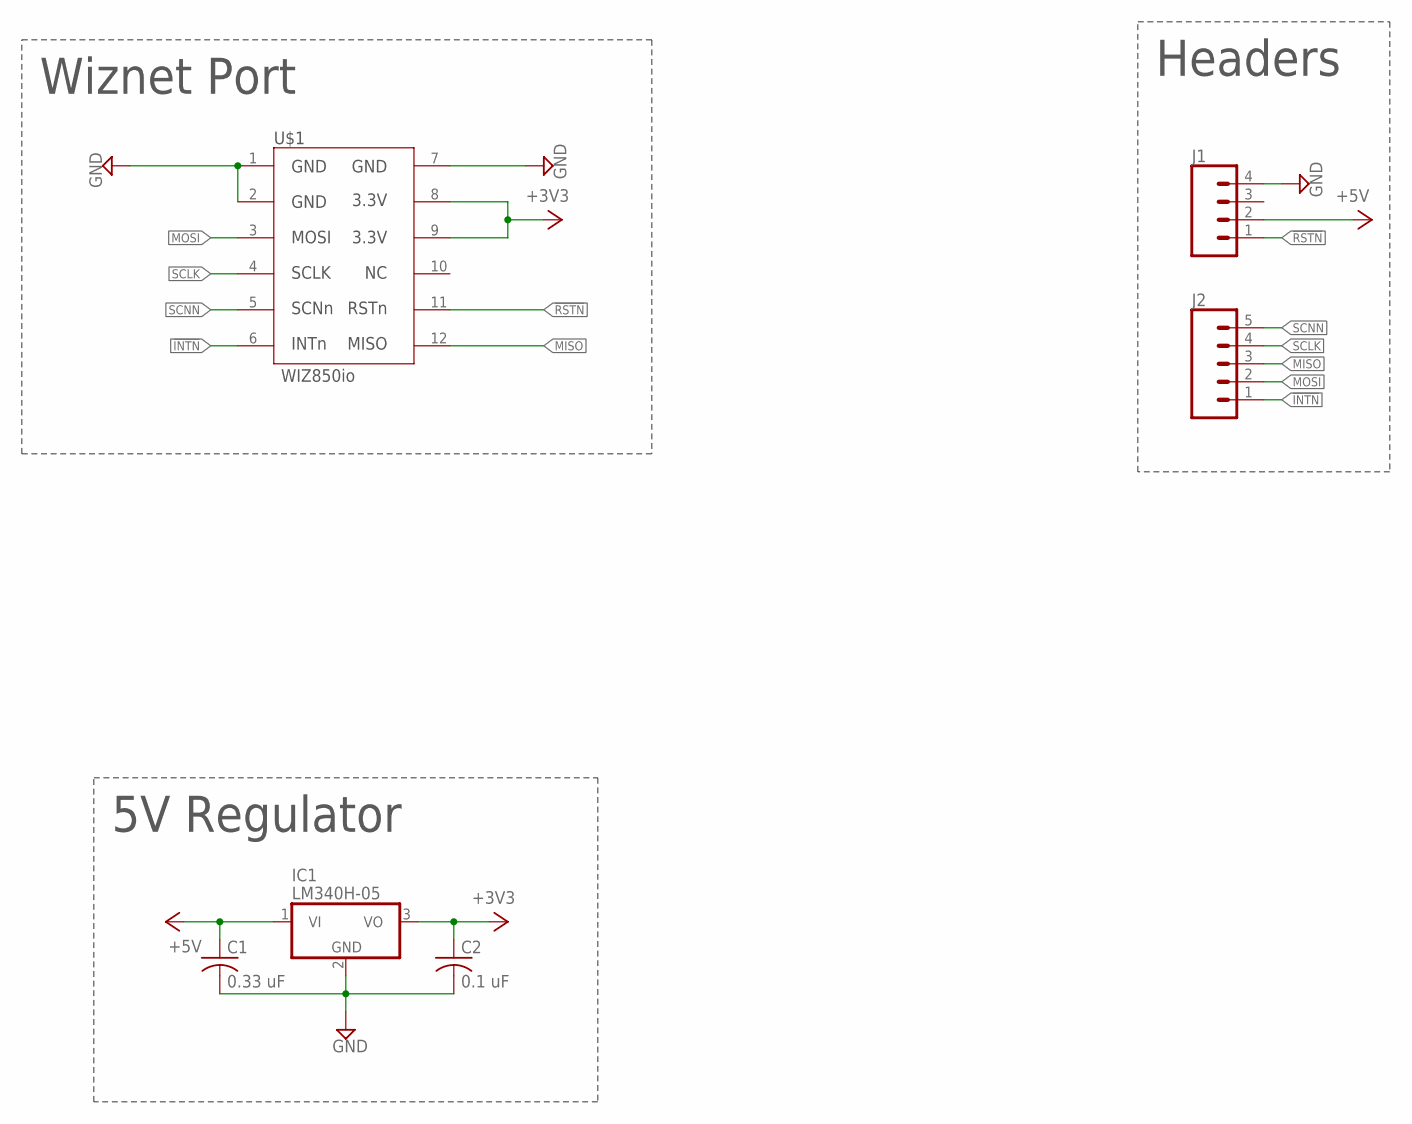
[picture p50: schematic ethernet_top_board.sch]

Parts:
C1: 0.33 uF; C0603
C2: 0.1 uF; C0603
IC1: LM340H-05; TO220H
J1: CONN_04; 1X04
J2: CONN_05; 1X05
U$1: WIZ850IO

Connections:
!INTN: J2.1, U$1.6
!RSTN: J1.1, U$1.11
+3V3: C2.1, IC1.3 (VO), U$1.8, U$1.9
+5V: C1.1, IC1.1 (VI), J1.2
GND: C1.2, C2.2, IC1.2 (GND), J1.4, U$1.1, U$1.2, U$1.7
MISO: J2.3, U$1.12
MOSI: J2.2, U$1.3
SCLK: J2.4, U$1.4
SCNN: J2.5, U$1.5

Notes on the sheet:
5V Regulator
Headers
Wiznet Port

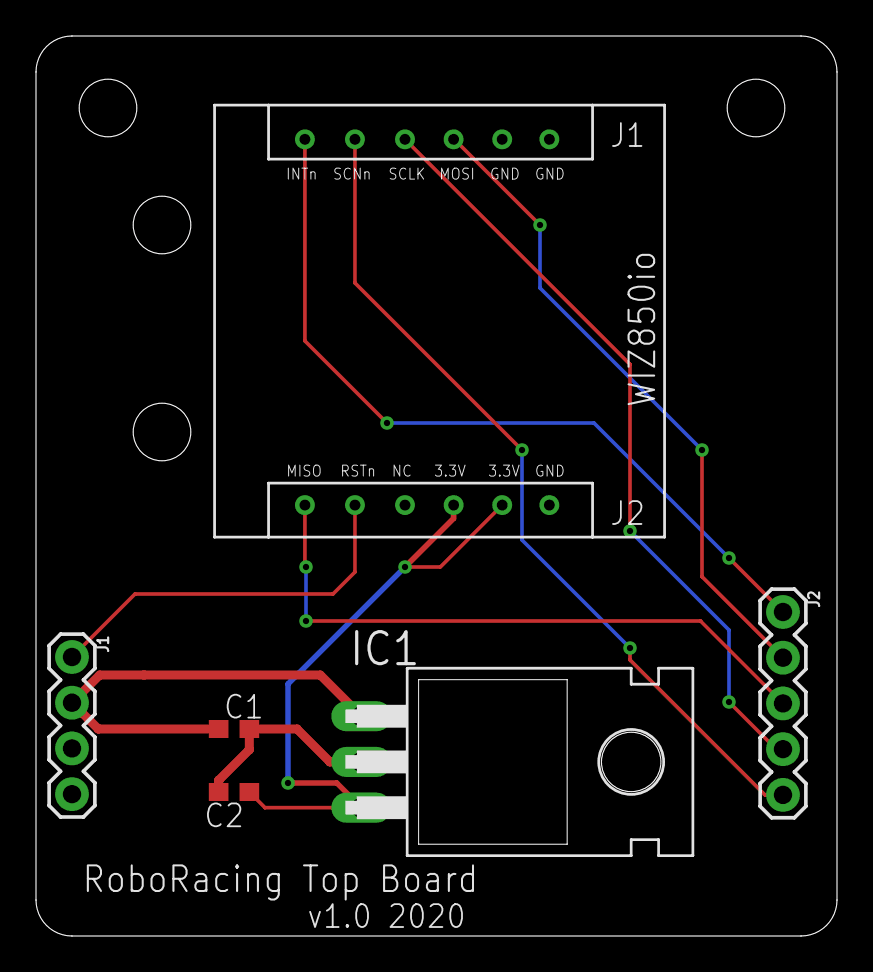
[picture p51: board ethernet_top_board.brd from above]

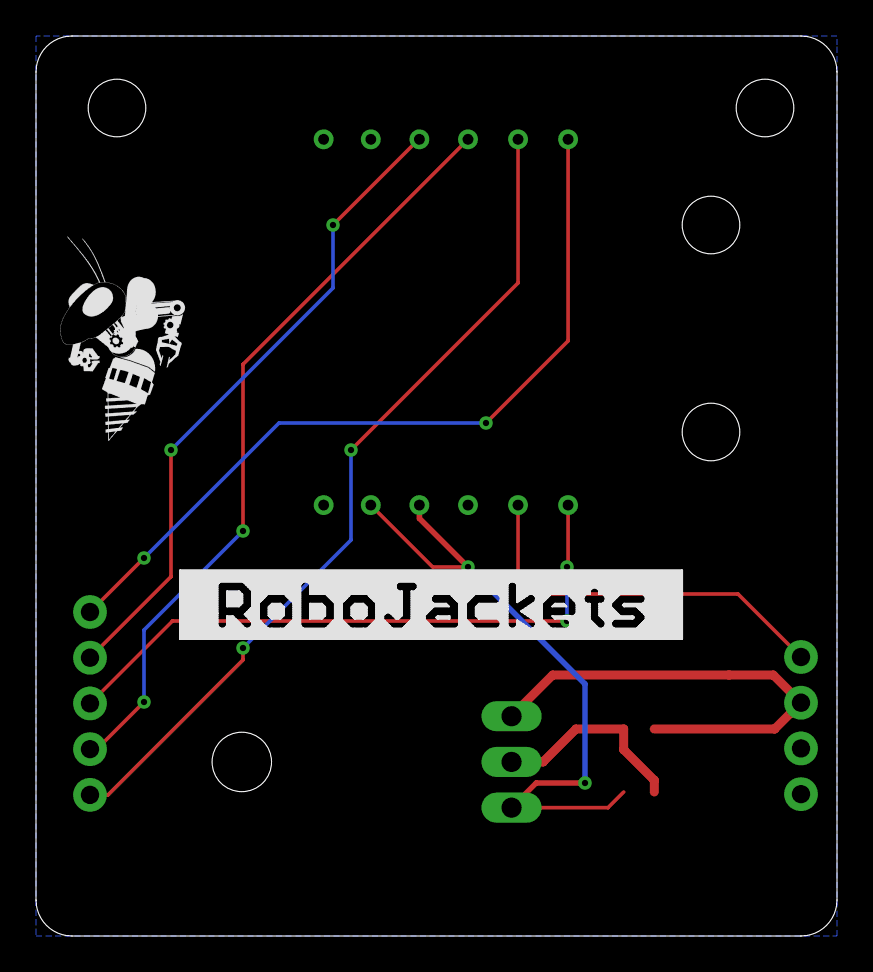
[picture p52: board ethernet_top_board.brd from below]

Board: 2 copper layers, 44.5 x 50.0 mm, 8 parts (2 on the bottom side), 9 nets.

Other parts of the board:
U$2: ROBOBUZZ_0.6X
U$3: ROBOJACKETS
