RoboJackets/roboracing-electrical/rigatoni/drive_brake/drive_brake.brd

## EAGLE design rigatoni/drive_brake/drive_brake.brd (2020-05-11)

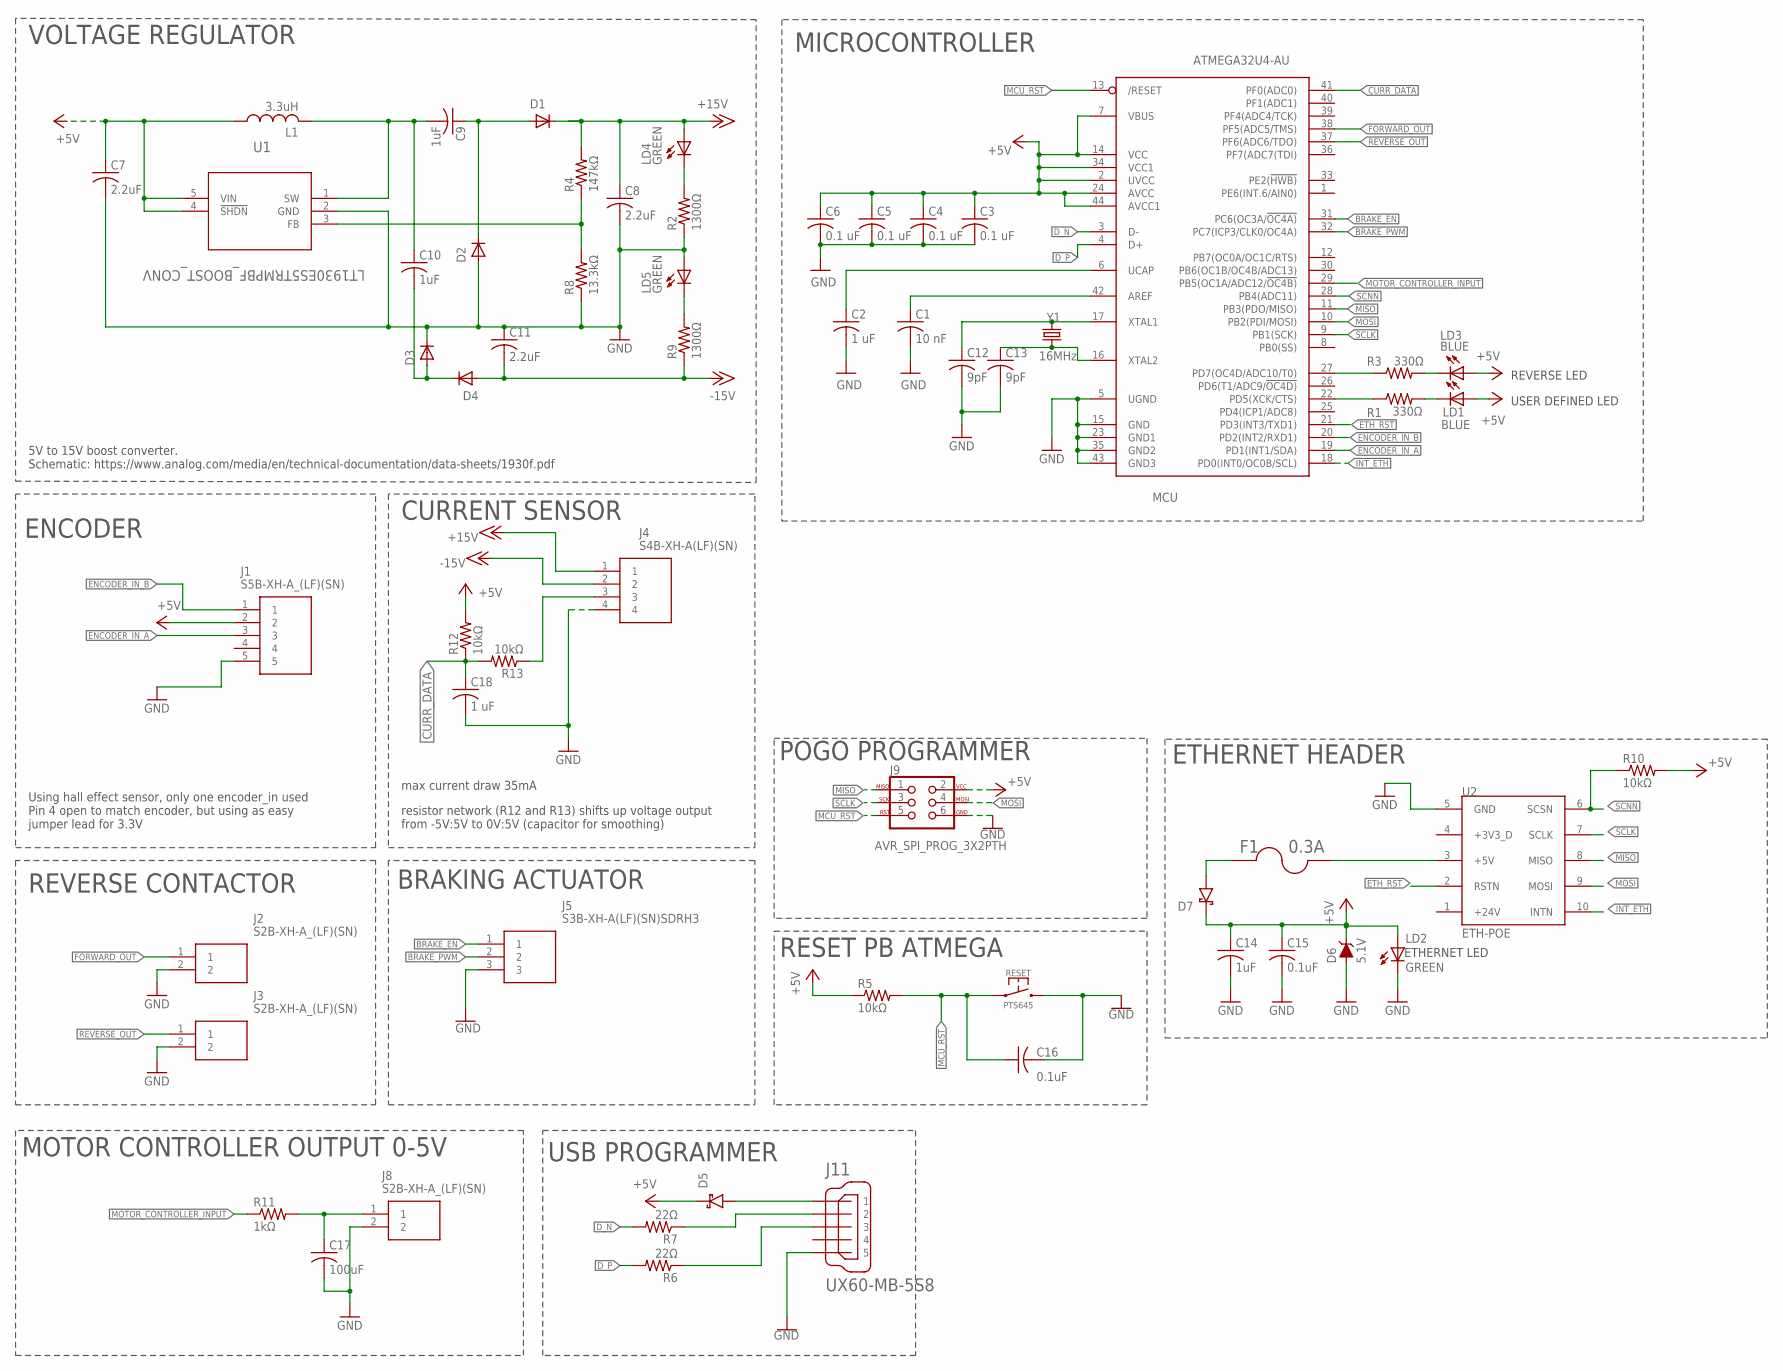
[picture p53: schematic drive_brake.sch]

Parts:
C1: 10 nF; C0603
C2, C18: 1 uF; C0603
C3, C4, C5, C6: 0.1 uF; C0603
C7: 2.2uF; C0805
C8, C11: 2.2uF; C1206
C9, C10, C14: 1uF; C0603
C12, C13: 9pF; C0603
C15, C16: 0.1uF; C0603
C17: 100uF; C1206
D1, D2, D3, D4: DIODE-SOD123; SOD123
D5, D7: SCHOTTKYSOD-323; SOD-323
D6: 5.1V; SOD-323
F1: 0.3A; F1206
J1: S5B-XH-A_(LF)(SN); SHDR5W80P0X250_1X5_1490X1150X6
J2, J3, J8: S2B-XH-A_(LF)(SN); SHDR2W80P0X250_1X2_740X1150X61
J4: S4B-XH-A(LF)(SN); SHDR4W64P0X250_1X4_1240X1155X7
J5: S3B-XH-A(LF)(SN)SDRH3; SHDR4
J9: AVR_SPI_PROG_3X2PTH; 2X3
J11: UX60-MB-5S8
L1: 3.3uH; L3225M
LD1, LD3: BLUE; LED-0603
LD2, LD4, LD5: GREEN; LED-0603
MCU: ATMEGA32U4-AU; TQFP44
R1, R3: 330Ω; 0603-RES
R2, R9: 1300Ω; R0603
R4: 147kΩ; R0603
R5, R10: 10kΩ; R0603
R6, R7: 22Ω; 0603-RES
R8: 13.3kΩ; R0603
R11: 1kΩ; 0603-RES
R12, R13: 10kΩ; 0603-RES
RESET: PTS645
U1: LT1930ES5TRMPBF_BOOST_CONV; SOT-5_S
U2: ETH-POE; HDRVR10W64P4000X254_2X5_1016X508X254B
Y1: 16MHz; CRYSTAL-SMD-5X3

Connections:
+5V: C3.1, C4.1, C5.1, C6.1, C7.1, C14.1, C15.1, D5.C, D6.C, D7.C, J1.2, J9.2, L1.1, LD1.A, LD2.A, LD3.A, MCU.2 (UVCC), MCU.7 (VBUS), MCU.14 (VCC), MCU.24 (AVCC), MCU.34 (VCC1), MCU.44 (AVCC1), R5.1, R10.2, R12.2, U1.4 (!SHDN), U1.5 (VIN)
+15V: C8.1, D1.C, J4.1, LD4.A, R4.2
-15V: C11.2, D4.A, J4.2, R9.1
BRAKE_EN: J5.1, MCU.31 (PC6(OC3A/!OC4A))
BRAKE_PWM: J5.2, MCU.32 (PC7(ICP3/CLK0/OC4A))
CURR_DATA: C18.1, MCU.41 (PF0(ADC0)), R12.1, R13.2
CURR_RAW: J4.3, R13.1
D_N: MCU.3 (D-), R7.2
D_P: MCU.4 (D+), R6.2
ENCODER_IN_A: J1.3, MCU.19 (PD1(INT1/SDA))
ENCODER_IN_B: J1.1, MCU.20 (PD2(INT2/RXD1))
ETH_RST: MCU.21 (PD3(INT3/TXD1)), U2.2 (RSTN)
FORWARD_OUT: J2.1, MCU.38 (PF5(ADC5/TMS))
GND: C1.2, C2.2, C3.2, C4.2, C5.2, C6.2, C7.2, C8.2, C11.1, C12.2, C13.2, C14.2, C15.2, C16.2, C17.2, C18.2, D2.A, D3.C, D6.A, J1.5, J2.2, J3.2, J4.4, J5.3, J8.2, J9.6, J11.5, LD2.C, LD5.A, MCU.5 (UGND), MCU.15 (GND), MCU.23 (GND1), MCU.35 (GND2), MCU.43 (GND3), R2.1, R8.1, RESET.P$3 (2), RESET.P$4 (2), U1.2 (GND), U2.5 (GND)
INT_ETH: MCU.18 (PD0(INT0/OC0B/SCL)), U2.10 (INTN)
MCU_RST: C16.1, J9.5, MCU.13 (/RESET), R5.2, RESET.P$1 (1), RESET.P$2 (1)
MISO: J9.1, MCU.11 (PB3(PDO/MISO)), U2.8 (MISO)
MOSI: J9.4, MCU.10 (PB2(PDI/MOSI)), U2.9 (MOSI)
MOTOR_CONTROLLER_INPUT: MCU.29 (PB5(OC1A/ADC12/!OC4B)), R11.1
unnamed: C1.1, MCU.42 (AREF)
unnamed: C2.1, MCU.6 (UCAP)
unnamed: LD3.C, R3.2
unnamed: F1.2, U2.3 (+5V)
unnamed: R4.1, R8.2, U1.3 (FB)
unnamed: C9.2, C10.1, L1.2, U1.1 (SW)
unnamed: LD1.C, R1.2
unnamed: C10.2, D3.A, D4.C
unnamed: D5.A, J11.1
unnamed: D7.A, F1.1
unnamed: J11.2, R7.1
unnamed: J11.3, R6.1
unnamed: C13.1, MCU.16 (XTAL2), Y1.1
unnamed: LD4.C, R2.2
unnamed: C12.1, MCU.17 (XTAL1), Y1.3 (2)
unnamed: C9.1, D1.A, D2.C
unnamed: LD5.C, R9.2
unnamed: C17.1, J8.1, R11.2
REVERSE_OUT: J3.1, MCU.37 (PF6(ADC6/TDO))
SCLK: J9.3, MCU.9 (PB1(SCK)), U2.7 (SCLK)
SCNN: MCU.28 (PB4(ADC11)), R10.1, U2.6 (SCSN)
TXLED: MCU.22 (PD5(XCK/CTS)), R1.1
TXLED1: MCU.27 (PD7(OC4D/ADC10/T0)), R3.1

Notes on the sheet:
ENCODER
BRAKING ACTUATOR
REVERSE CONTACTOR
CURRENT SENSOR
USB PROGRAMMER
MOTOR CONTROLLER OUTPUT 0-5V
RESET PB ATMEGA
ETHERNET HEADER
POGO PROGRAMMER
MICROCONTROLLER
REVERSE LED
USER DEFINED LED
VOLTAGE REGULATOR
ETHERNET LED
max current draw 35mA
resistor network (R12 and R13) shifts up voltage output from -5V:5V to 0V:5V (capacitor for smoothing)
Using hall effect sensor, only one encoder_in used Pin 4 open to match encoder, but using as easy jumper lead for 3.3V
5V to 15V boost converter. Schematic: https://www.analog.com/media/en/technical-documentation/data-sheets/1930f.pdf

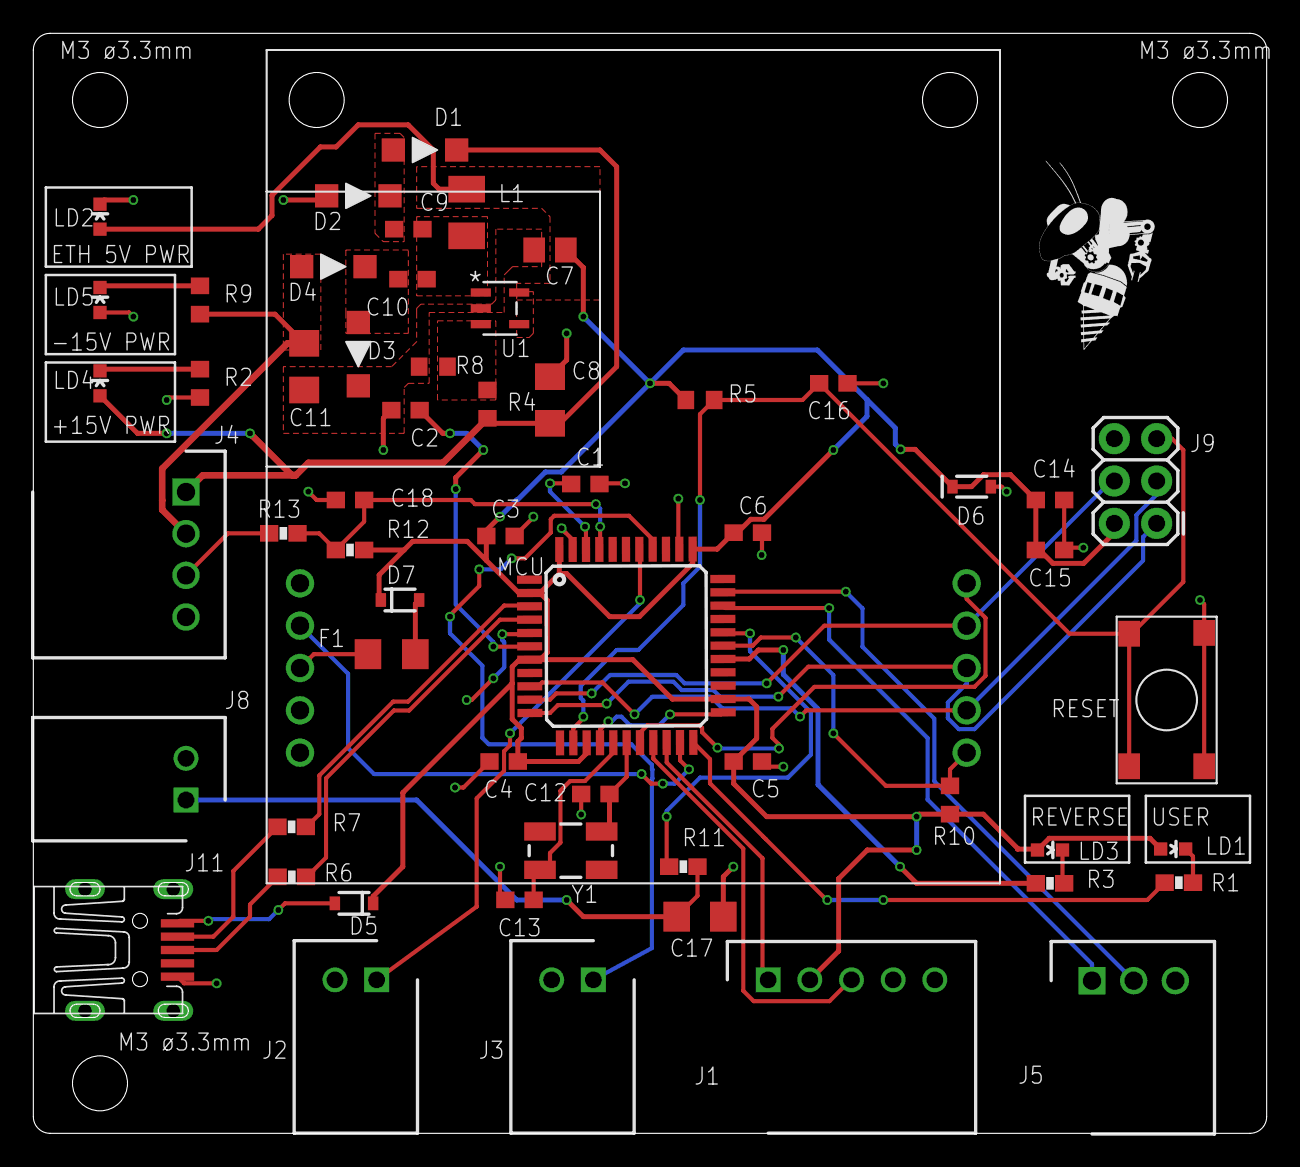
[picture p54: board drive_brake.brd from above]

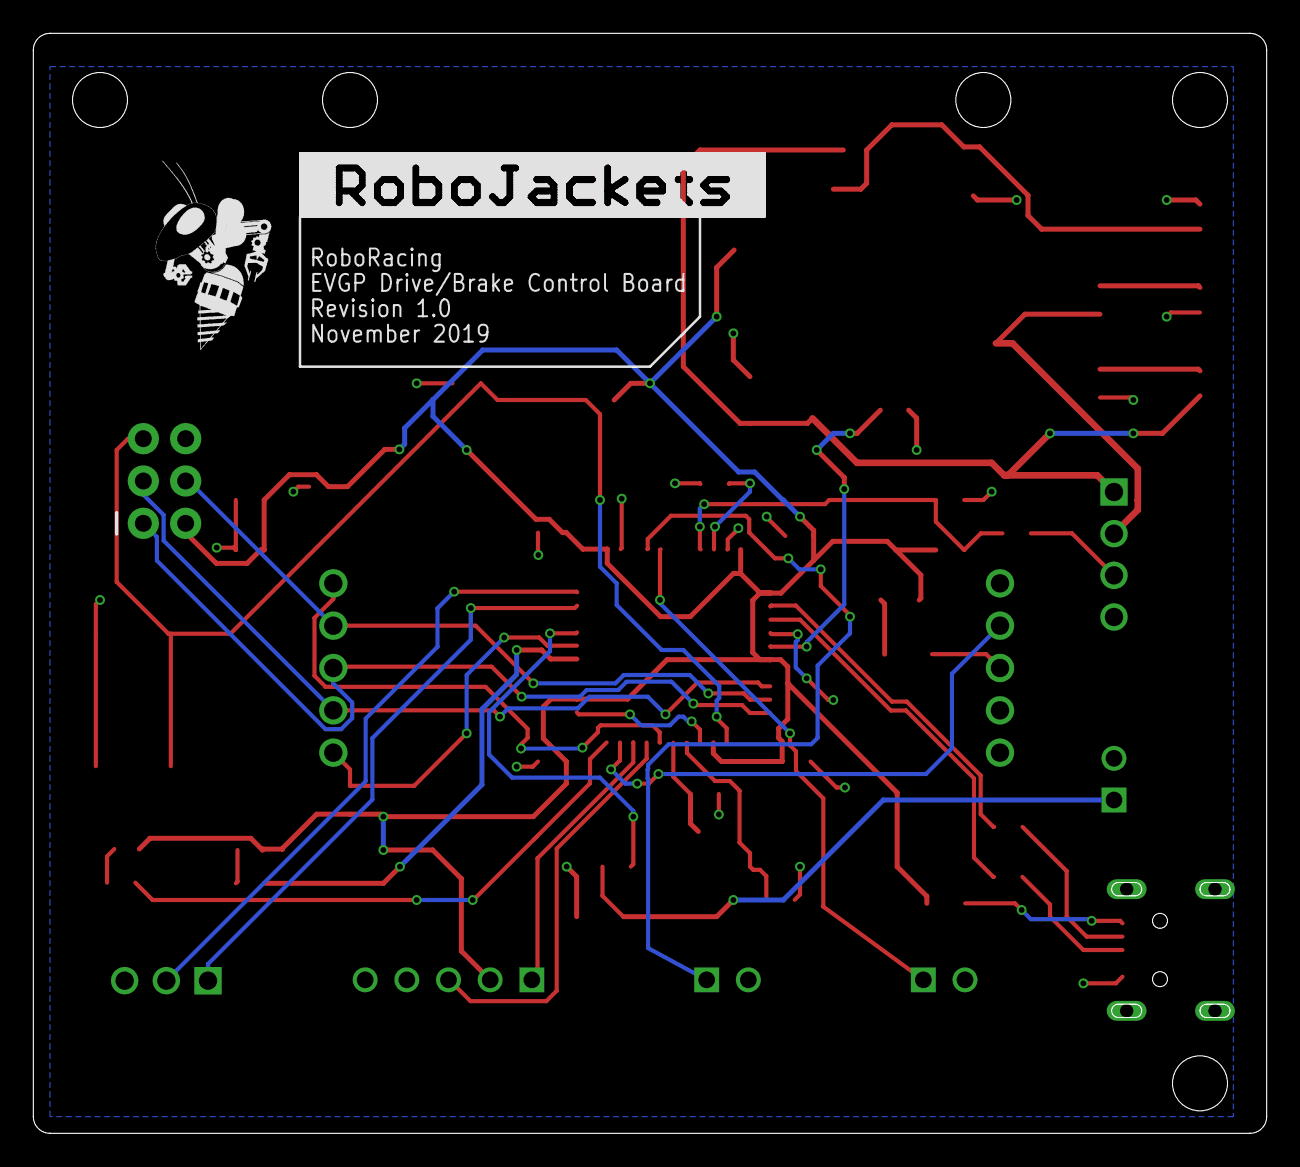
[picture p55: board drive_brake.brd from below]

Board: 2 copper layers, 74.0 x 66.0 mm, 61 parts (2 on the bottom side), 42 nets.

Other parts of the board:
E$3: ROBOBUZZ_0.6X
ROBORACING: ROBOJACKETS
U$1: ROBOBUZZ_0.6X
