RoboJackets/roboracing-electrical/rigatoni/ethernet_poe/v1/ethernet_poe.brd

## EAGLE design rigatoni/ethernet_poe/v1/ethernet_poe.brd (2020-05-11, an earlier design)

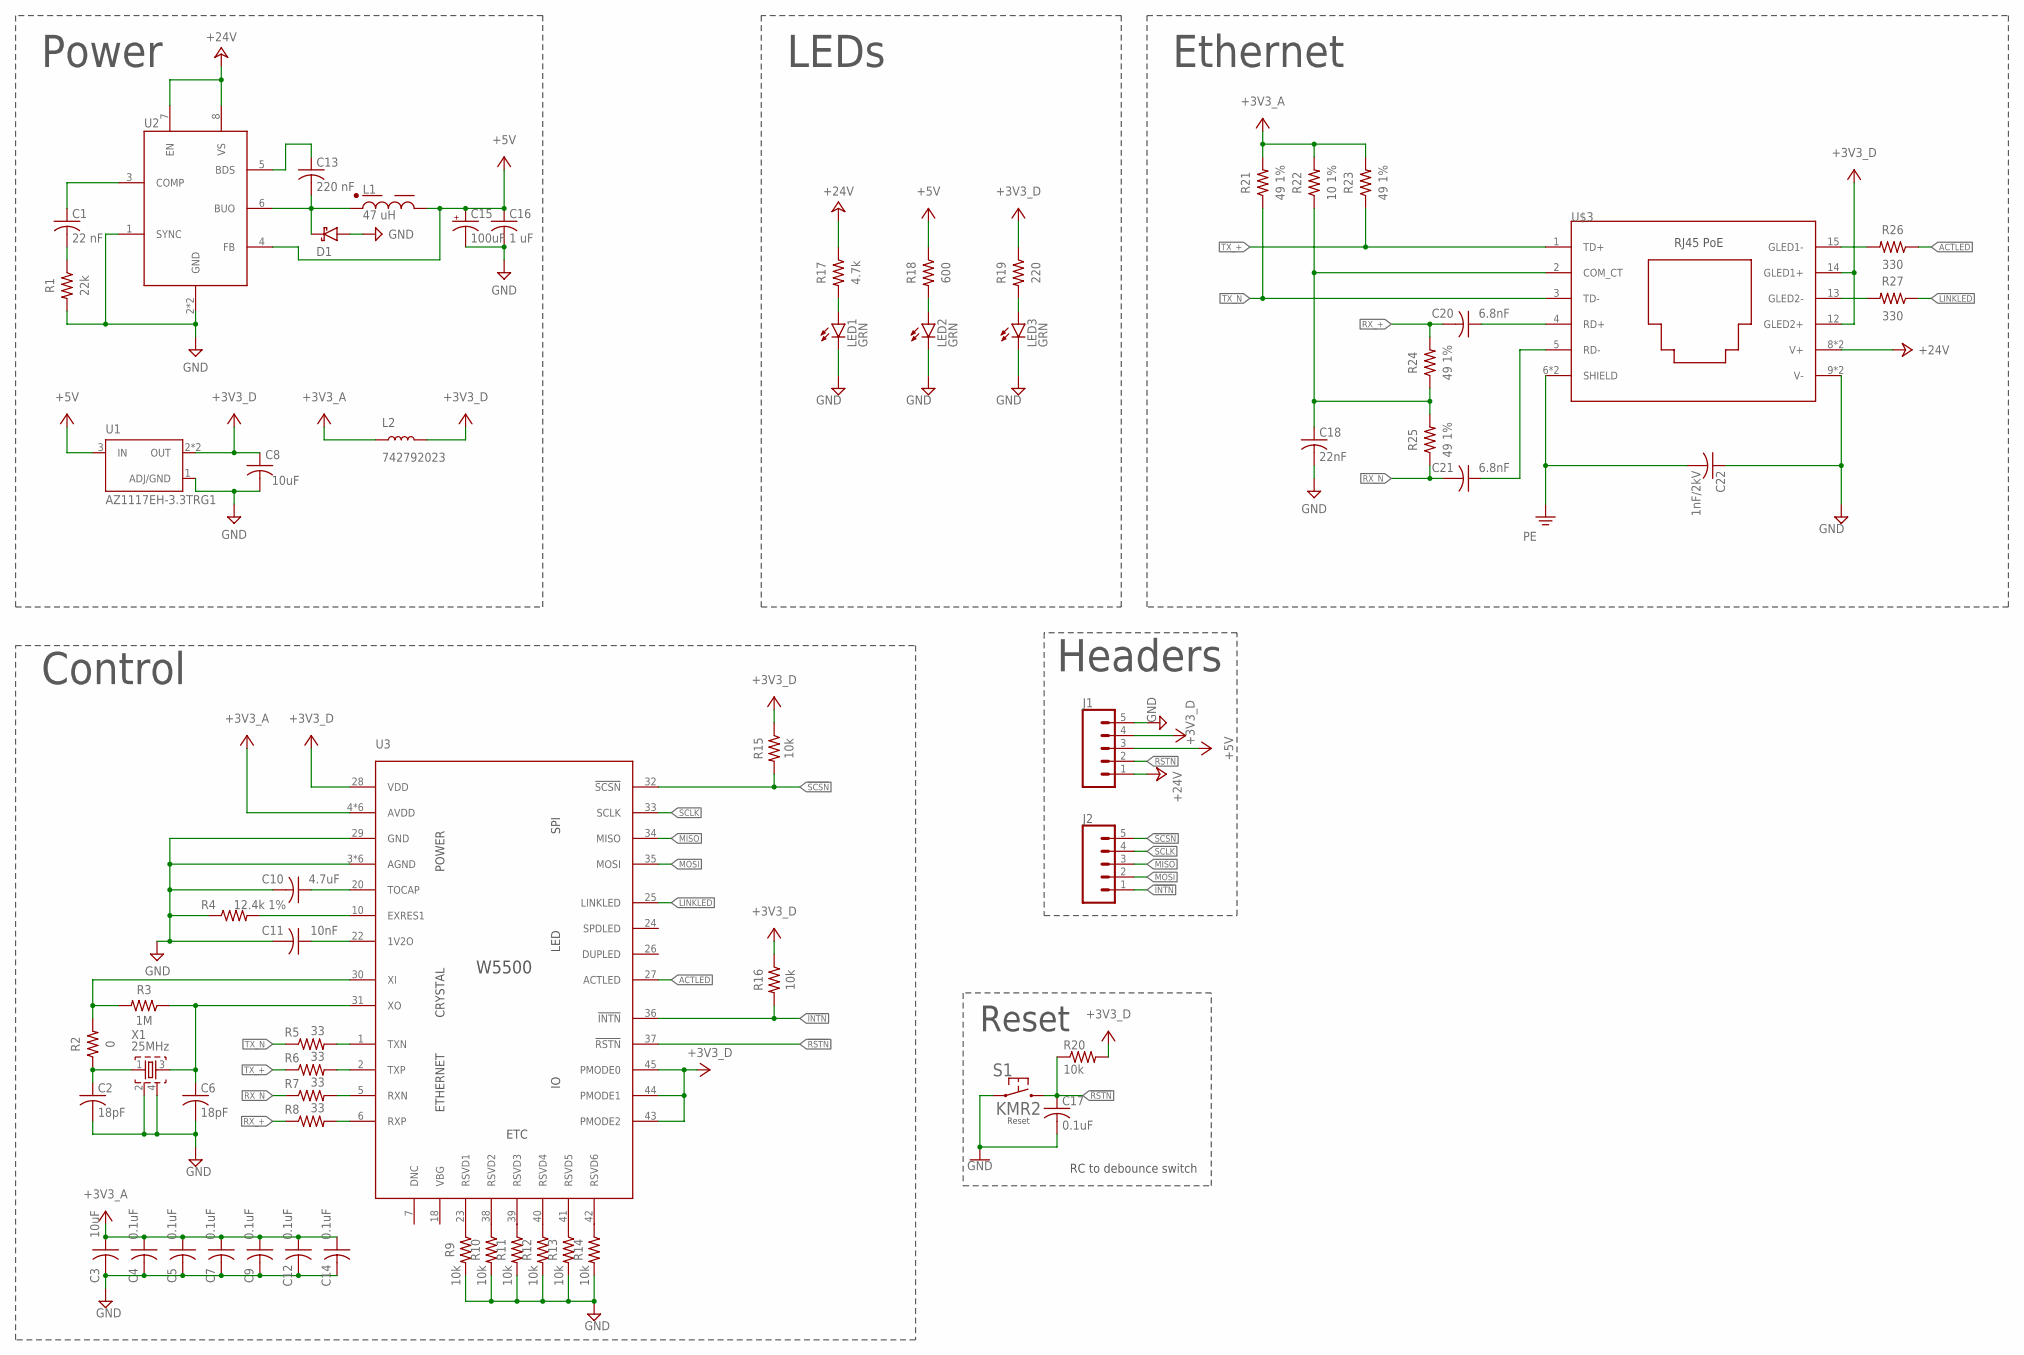
[picture p56: schematic ethernet_poe.sch]

Parts:
C1: 22 nF; C0603
C2, C6: 18pF; C0603
C3, C8: 10uF; C0603
C4, C5, C7, C9, C12, C14, C17: 0.1uF; C0603
C10: 4.7uF; C0603
C11: 10nF; C0603
C13: 220 nF; C0603
C15: 100uF; E2-5
C16: 1 uF; C0603
C18: 22nF; C0603
C20, C21: 6.8nF; C0603
C22: 1nF/2kV; C1206
D1: SCHOTTKYSOD-323; SOD-323
J1, J2: CONN_05; 1X05
L1: 47 uH; 744771147
L2: 742792023; 0805
LED1, LED2, LED3: GRN; CHIP-LED0603
R1: 22k; R0603
R2: 0; R0603
R3: 1M; R0603
R4: 12.4k 1%; R0603
R5, R6, R7, R8: 33; R0603
R9, R10, R11, R12, R13, R14, R15, R16, R20: 10k; R0603
R17: 4.7k; R0603
R18: 600; R0603
R19: 220; R0603
R21, R23, R24, R25: 49 1%; R0603
R22: 10 1%; R0603
R26, R27: 330; R0603
S1: KMR2
U1: AZ1117EH-3.3TRG1; SOT230P700X180-4N
U2: IFX91041; SOIC-8-EXPOSED_PAD
U3: W5500; 48-LQFP
U$3: SI-52003-F
X1: 25MHz; OSCILLATOR-SMD-2.5X2

Connections:
3V3_LED: LED3.A, R19.2
5V_LED: LED2.A, R18.2
24V_LED: LED1.A, R17.2
!INTN: J2.1, R16.2, U3.36 (!INTN)
!RSTN: C17.1, J1.2, R20.1, S1.2.1 (2), S1.2.2 (2), U3.37 (!RSTN)
!SCSN: J2.5, R15.2, U3.32 (!SCSN)
+3V3_A: C3.1, C4.1, C5.1, C7.1, C9.1, C12.1, C14.1, L2.1, R21.2, R22.2, R23.2, U3.4 (AVDD), U3.8 (AVDD), U3.11 (AVDD), U3.15 (AVDD), U3.17 (AVDD), U3.21 (AVDD)
+3V3_D: C8.1, J1.4, L2.2, R15.1, R16.1, R19.1, R20.2, U1.2 (OUT), U1.4 (OUT), U3.28 (VDD), U3.43 (PMODE2), U3.44 (PMODE1), U3.45 (PMODE0), U$3.12 (GLED2+), U$3.14 (GLED1+)
+5V: C15.+, C16.1, J1.3, L1.1, R18.1, U1.3 (IN), U2.4 (FB)
+24V: J1.1, R17.1, U2.7 (EN), U2.8 (VS), U$3.8 (V+), U$3.10 (V+)
ACTLED: R26.1, U3.27 (ACTLED)
COM_CT: C18.1, R22.1, R24.1, R25.2, U$3.2 (COM_CT)
GND: C2.2, C3.2, C4.2, C5.2, C6.2, C7.2, C8.2, C9.2, C10.2, C11.2, C12.2, C14.2, C15.-, C16.2, C17.2, C18.2, C22.1, D1.A, J1.5, LED1.C, LED2.C, LED3.C, R1.2, R4.1, R9.2, R10.2, R11.2, R12.2, R13.2, R14.2, S1.1.1 (1), S1.1.2 (1), U1.1 (ADJ/GND), U2.1 (SYNC), U2.2 (GND), U2.P$9 (GND), U3.3 (AGND), U3.9 (AGND), U3.14 (AGND), U3.16 (AGND), U3.19 (AGND), U3.29 (GND), U3.48 (AGND), U$3.9 (V-), U$3.11 (V-), X1.2 (SHD1), X1.4 (SHD2)
LINKLED: R27.1, U3.25 (LINKLED)
MISO: J2.3, U3.34 (MISO)
MOSI: J2.2, U3.35 (MOSI)
unnamed: R9.1, U3.23 (RSVD1)
unnamed: R10.1, U3.38 (RSVD2)
unnamed: R11.1, U3.39 (RSVD3)
unnamed: R5.2, U3.1 (TXN)
unnamed: R6.2, U3.2 (TXP)
unnamed: R12.1, U3.40 (RSVD4)
unnamed: R7.2, U3.5 (RXN)
unnamed: R8.2, U3.6 (RXP)
unnamed: C2.1, R2.1, X1.1 (IN)
unnamed: R27.2, U$3.13 (GLED2-)
unnamed: C6.1, R3.1, U3.31 (XO), X1.3 (OUT)
unnamed: R26.2, U$3.15 (GLED1-)
unnamed: R2.2, R3.2, U3.30 (XI)
unnamed: C13.2, D1.C, L1.P$2, U2.6 (BUO)
unnamed: C13.1, U2.5 (BDS)
unnamed: C1.2, R1.1
unnamed: C1.1, U2.3 (COMP)
unnamed: C11.1, U3.22 (1V2O)
unnamed: C10.1, U3.20 (TOCAP)
unnamed: R13.1, U3.41 (RSVD5)
unnamed: R4.2, U3.10 (EXRES1)
unnamed: R14.1, U3.42 (RSVD6)
PE: C22.2, U$3.6 (SHIELD), U$3.7 (SHIELD)
RD_+: C20.1, U$3.4 (RD+)
RD_N: C21.1, U$3.5 (RD-)
RX_+: C20.2, R8.1, R24.2
RX_N: C21.2, R7.1, R25.1
SCLK: J2.4, U3.33 (SCLK)
TX_+: R6.1, R23.1, U$3.1 (TD+)
TX_N: R5.1, R21.1, U$3.3 (TD-)

Notes on the sheet:
Power
Control
LEDs
Ethernet
Headers
RC to debounce switch
Reset

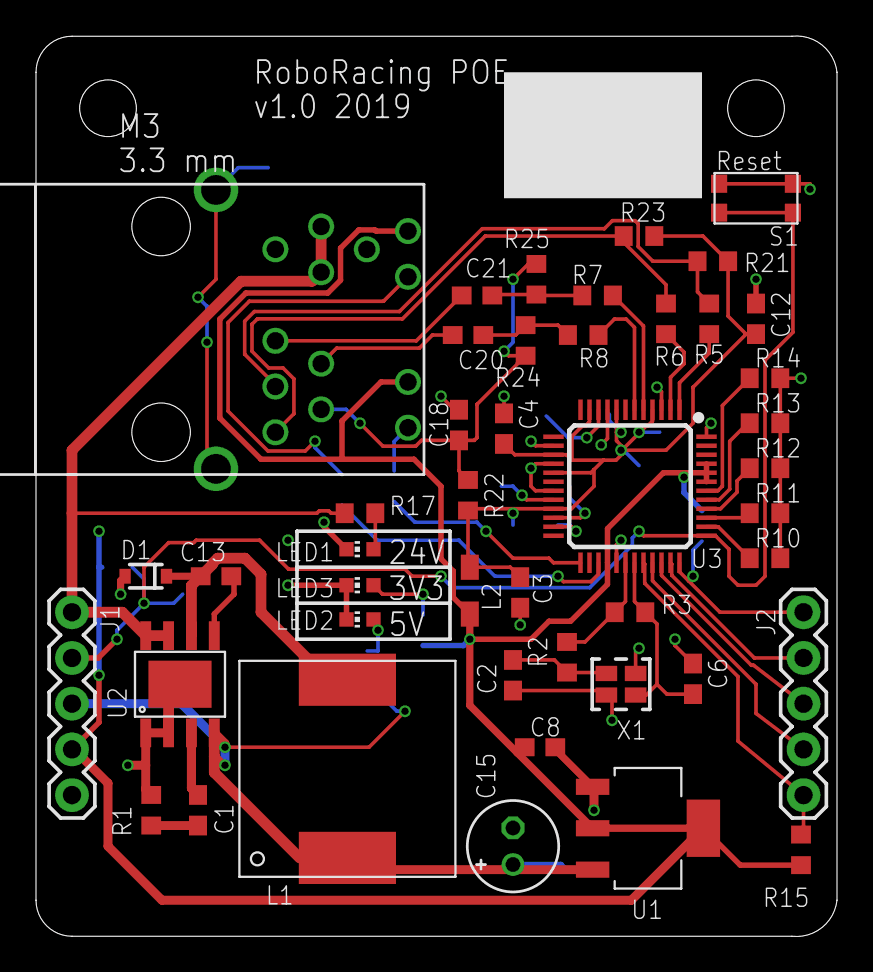
[picture p57: board rigatoni/ethernet_poe/v1/ethernet_poe.brd from above]

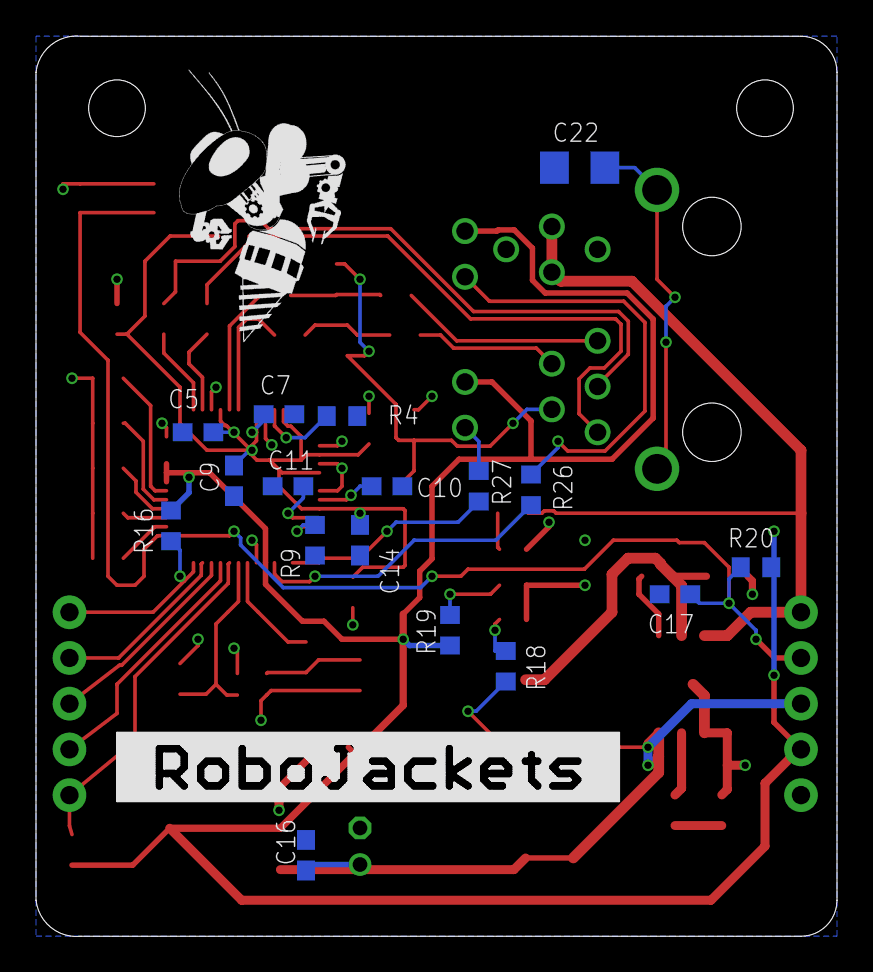
[picture p58: board rigatoni/ethernet_poe/v1/ethernet_poe.brd from below]

Board: 2 copper layers, 44.5 x 50.0 mm, 64 parts (19 on the bottom side), 46 nets.

Other parts of the board:
U$1: ROBOJACKETS
U$2: ROBOBUZZ_0.8X
