RoboJackets/roboracing-electrical/rigatoni/radar-adapter/adapterSchematic.brd

## EAGLE design rigatoni/radar-adapter/adapterSchematic.brd (2021-10-24)

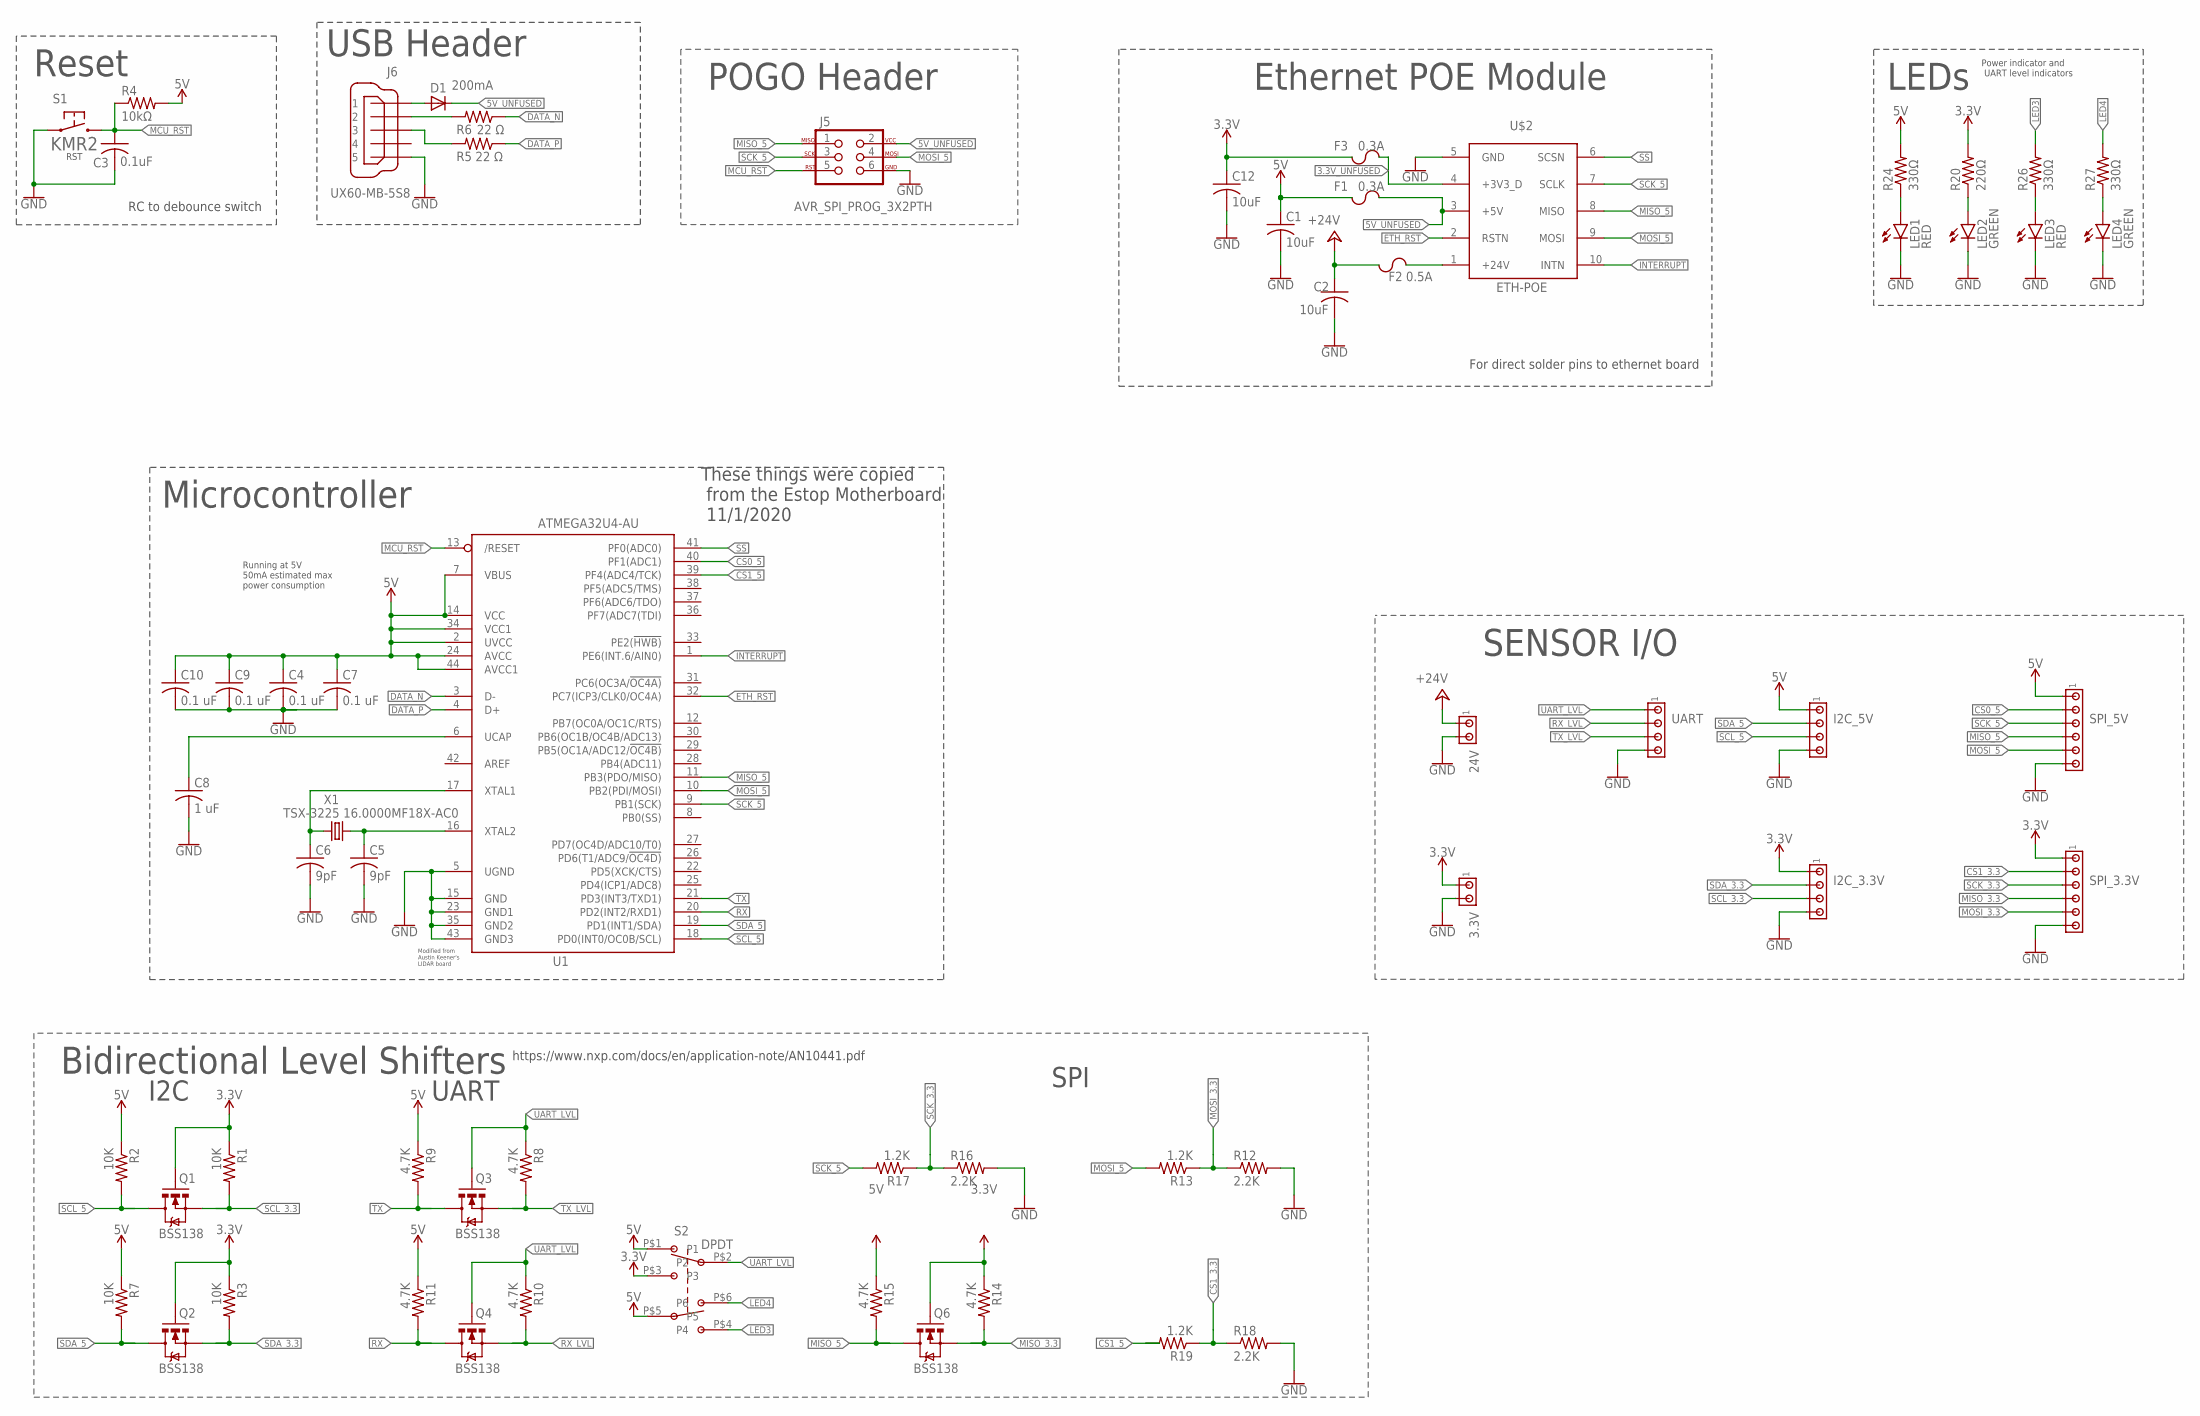
[picture p59: schematic adapterSchematic.sch]

Parts:
3.3V, 24V: MTA02-100; 10X02MTA
C1, C2, C12: 10uF; C1206
C3: 0.1uF; C0603
C4, C7, C9, C10: 0.1 uF; C0603
C5, C6: 9pF; C0603
C8: 1 uF; C0603
D1: 200mA; SOD323-R
F1, F3: 0.3A; F1206
F2: 0.5A; F1206
I2C_3.3V, I2C_5V: MTA04-100; 10X04MTA
J5: AVR_SPI_PROG_3X2PTH; 2X3
J6: UX60-MB-5S8
LED1, LED3: RED; CHIP-LED0603
LED2, LED4: GREEN; CHIP-LED0603
Q1, Q2, Q3, Q4, Q6: BSS138; SOT23-3
R1, R2, R3, R7: 10K; 0603-RES
R4: 10kΩ; R0603
R5, R6: 22 Ω; R0603
R8, R9, R10, R11, R14, R15: 4.7K; 0603-RES
R12, R16, R18: 2.2K; 0603-RES
R13, R17, R19: 1.2K; 0603-RES
R20: 220Ω; R0603
R24, R26, R27: 330Ω; R0603
S1: KMR2
SPI_3.3V, SPI_5V: MTA06-100; 10X06MTA
U1: ATMEGA32U4-AU; TQFP44
U$2: ETH-POE; HDRVR10W64P4000X254_2X5_1016X508X254B
U$4: DPDT_SLIDE_SWITCH
UART: MTA04-100; 10X04MTA
X1: TSX-3225 16.0000MF18X-AC0; XTAL-3.2X2.5

Connections:
3.3V: 3.3V.1, C12.1, F3.1, I2C_3.3V.1, Q1.1 (G), Q2.1 (G), Q6.1 (G), R1.1, R3.1, R14.1, R20.2, SPI_3.3V.1, U$4.P$3 (P3)
3.3V_UNFUSED: F3.2, U$2.4 (+3V3_D)
5V: C1.1, C4.1, C7.1, C9.1, C10.1, F1.1, I2C_5V.1, R2.1, R4.2, R7.1, R9.1, R11.1, R15.1, R24.2, SPI_5V.1, U1.2 (UVCC), U1.7 (VBUS), U1.14 (VCC), U1.24 (AVCC), U1.34 (VCC1), U1.44 (AVCC1), U$4.P$1 (P1), U$4.P$5 (P5)
5V_UNFUSED: D1.C, F1.2, J5.2, U$2.3 (+5V)
24V_UNFUSED: F2.2, U$2.1 (+24V)
+24V: 24V.1, C2.1, F2.1
CS0_5: SPI_5V.2, U1.40 (PF1(ADC1))
CS1_3.3: R18.1, R19.1, SPI_3.3V.2
CS1_5: R19.2, U1.39 (PF4(ADC4/TCK))
DATA_N: R6.1, U1.3 (D-)
DATA_P: R5.1, U1.4 (D+)
ETH_RST: U1.32 (PC7(ICP3/CLK0/OC4A)), U$2.2 (RSTN)
GND: 3.3V.2, 24V.2, C1.2, C2.2, C3.2, C4.2, C5.2, C6.2, C7.2, C8.2, C9.2, C10.2, C12.2, I2C_3.3V.4, I2C_5V.4, J5.6, J6.5, LED1.C, LED2.C, LED3.C, LED4.C, R12.2, R16.2, R18.2, S1.1.1 (1), S1.1.2 (1), SPI_3.3V.6, SPI_5V.6, U1.5 (UGND), U1.15 (GND), U1.23 (GND1), U1.35 (GND2), U1.43 (GND3), U$2.5 (GND), UART.4
INTERRUPT: U1.1 (PE6(INT.6/AIN0)), U$2.10 (INTN)
LED3: R26.2, U$4.P$4 (P4)
LED4: R27.2, U$4.P$6 (P6)
MCU_RST: C3.1, J5.5, R4.1, S1.2.1 (2), S1.2.2 (2), U1.13 (/RESET)
MISO_3.3: Q6.2 (S), R14.2, SPI_3.3V.4
MISO_5: J5.1, Q6.3 (D), R15.2, SPI_5V.4, U1.11 (PB3(PDO/MISO)), U$2.8 (MISO)
MOSI_3.3: R12.1, R13.1, SPI_3.3V.5
MOSI_5: J5.4, R13.2, SPI_5V.5, U1.10 (PB2(PDI/MOSI)), U$2.9 (MOSI)
unnamed: LED2.A, R20.1
unnamed: LED1.A, R24.1
unnamed: LED3.A, R26.1
unnamed: J6.2, R6.2
unnamed: D1.A, J6.1
unnamed: LED4.A, R27.1
unnamed: J6.3, R5.2
RX: Q4.3 (D), R11.2, U1.20 (PD2(INT2/RXD1))
RX_LVL: Q4.2 (S), R10.2, UART.2
SCK_3.3: R16.1, R17.1, SPI_3.3V.3
SCK_5: J5.3, R17.2, SPI_5V.3, U1.9 (PB1(SCK)), U$2.7 (SCLK)
SCL_3.3: I2C_3.3V.3, Q1.2 (S), R1.2
SCL_5: I2C_5V.3, Q1.3 (D), R2.2, U1.18 (PD0(INT0/OC0B/SCL))
SDA_3.3: I2C_3.3V.2, Q2.2 (S), R3.2
SDA_5: I2C_5V.2, Q2.3 (D), R7.2, U1.19 (PD1(INT1/SDA))
SS: U1.41 (PF0(ADC0)), U$2.6 (SCSN)
TX: Q3.3 (D), R9.2, U1.21 (PD3(INT3/TXD1))
TX_LVL: Q3.2 (S), R8.2, UART.3
UART_LVL: Q3.1 (G), Q4.1 (G), R8.1, R10.1, U$4.P$2 (P2), UART.1
UCAP: C8.1, U1.6 (UCAP)
XTAL1: C6.1, U1.17 (XTAL1), X1.1
XTAL2: C5.1, U1.16 (XTAL2), X1.3 (2)

Notes on the sheet:
Modified from Austin Keener's LIDAR board
Running at 5V 50mA estimated max power consumption
Microcontroller
Ethernet POE Module
For direct solder pins to ethernet board
RC to debounce switch
Reset
USB Header
POGO Header
SENSOR I/O
These things were copied from the Estop Motherboard 11/1/2020
Bidirectional Level Shifters
I2C
UART
SPI
Power indicator and UART level indicators
LEDs
https://www.nxp.com/docs/en/application-note/AN10441.pdf

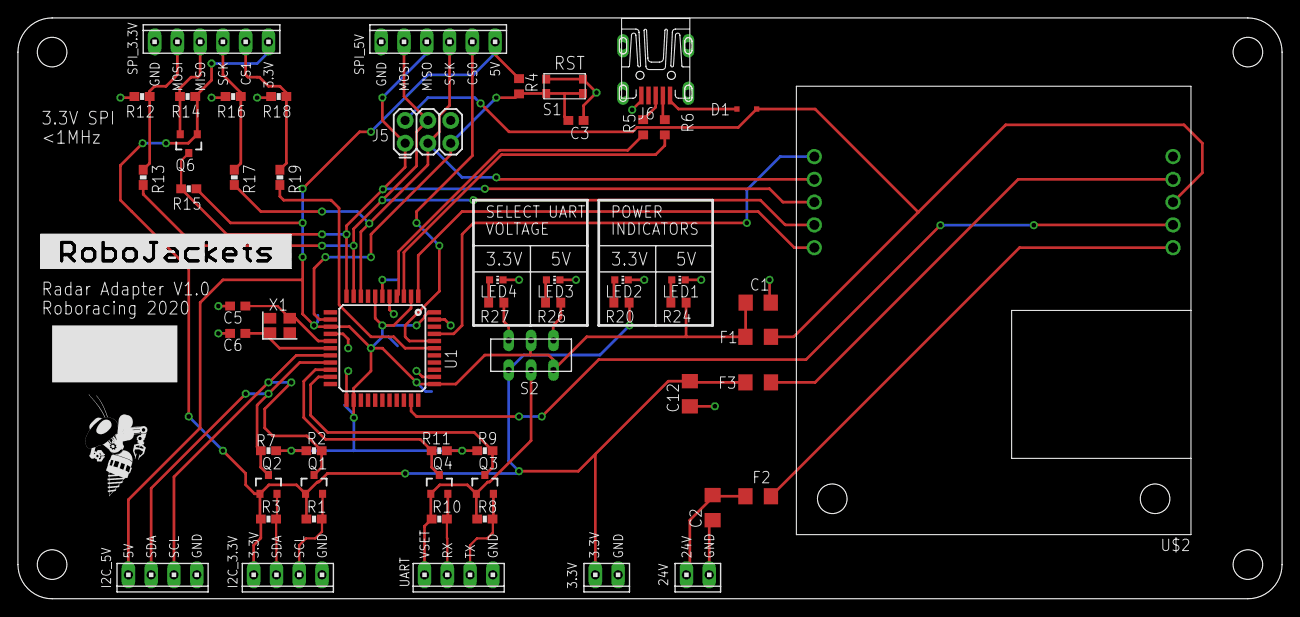
[picture p60: board adapterSchematic.brd from above]

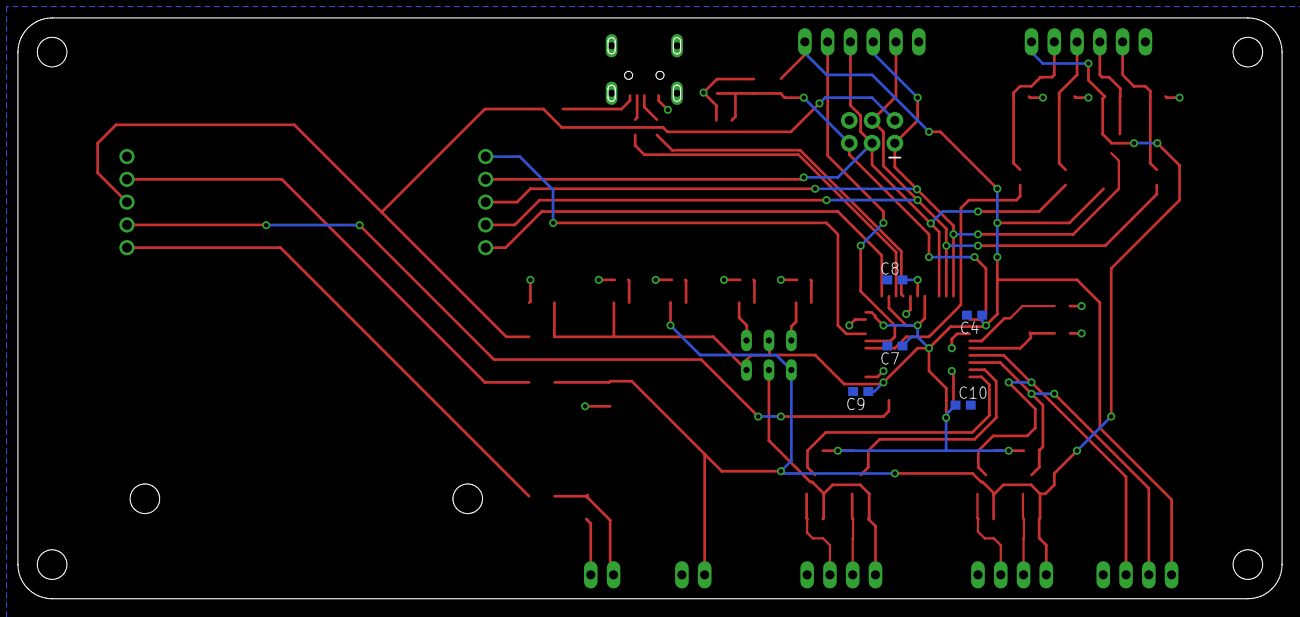
[picture p61: board adapterSchematic.brd from below]

Board: 2 copper layers, 141.0 x 64.8 mm, 63 parts (5 on the bottom side), 43 nets.

Other parts of the board:
U$1: ROBOBUZZ_0.6X
U$3: ROBOJACKETS
