RoboJackets/roboracing-electrical/sedani/estop/Eagle Files/e-stop-radio.brd

## EAGLE design sedani/estop/Eagle Files/e-stop-radio.brd (2020-05-11)

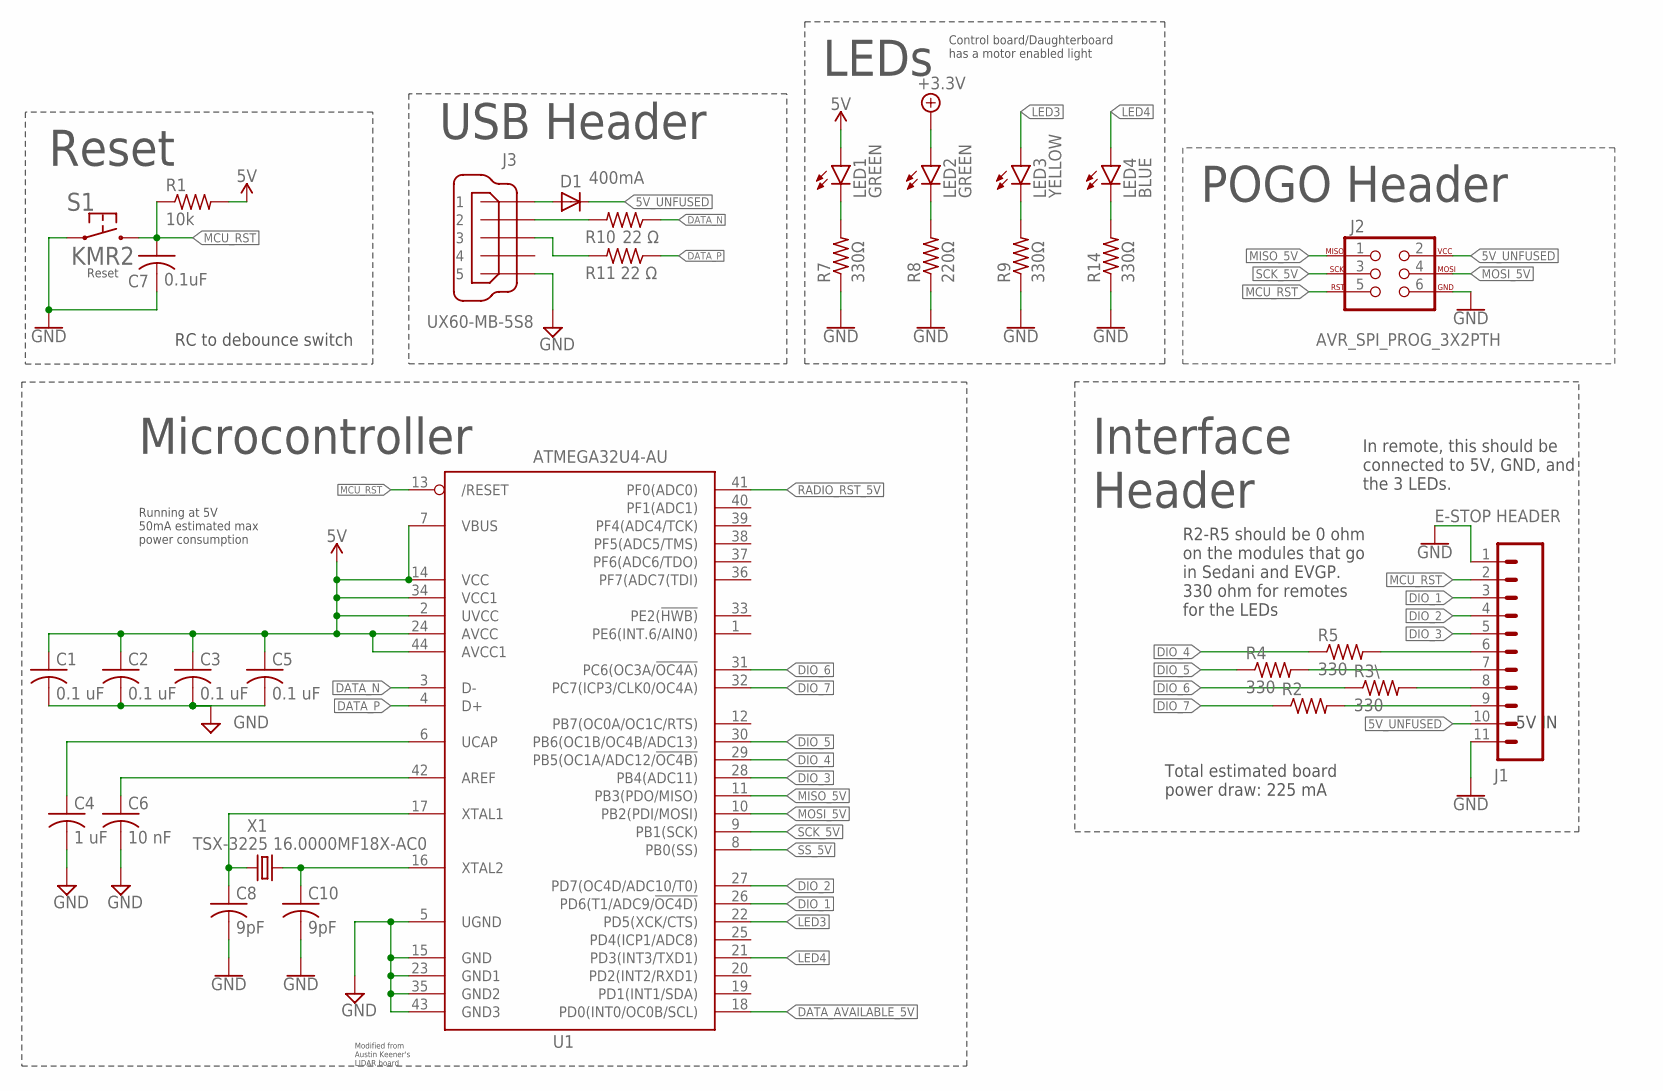
[picture p65: schematic e-stop-radio.sch, sheet 1]

Parts:
C1, C2, C3, C5: 0.1 uF; C0603
C4: 1 uF; C0603
C6: 10 nF; C0603
C7: 0.1uF; C0603
C8, C10: 9pF; C0603
D1: 400mA; SOD323-R
J1: E-STOP HEADER; 1X11
J2: AVR_SPI_PROG_3X2PTH; 2X3
J3: UX60-MB-5S8
LED1, LED2: GREEN; CHIP-LED0603
LED3: YELLOW; CHIP-LED0603
LED4: BLUE; CHIP-LED0603
R1: 10k; R0603
R2, R3\, R4, R5: 330; R0603
R7, R9, R14: 330Ω; R0603
R8: 220Ω; R0603
R10, R11: 22 Ω; R0603
S1: KMR2
U1: ATMEGA32U4-AU; TQFP44
X1: TSX-3225 16.0000MF18X-AC0; XTAL-3.2X2.5

Connections:
5V: C1.1, C2.1, C3.1, C5.1, LED1.A, R1.2, U1.2 (UVCC), U1.7 (VBUS), U1.14 (VCC), U1.24 (AVCC), U1.34 (VCC1), U1.44 (AVCC1); also elsewhere on the board
5V_UNFUSED: D1.C, J1.10, J2.2; also elsewhere on the board
+3.3V: LED2.A; also elsewhere on the board
AREF: C6.1, U1.42 (AREF)
DATA_AVAILABLE_5V: U1.18 (PD0(INT0/OC0B/SCL)); also elsewhere on the board
DATA_N: R10.1, U1.3 (D-)
DATA_P: R11.1, U1.4 (D+)
DIO_1: J1.3, U1.26 (PD6(T1/ADC9/!OC4D))
DIO_2: J1.4, U1.27 (PD7(OC4D/ADC10/T0))
DIO_3: J1.5, U1.28 (PB4(ADC11))
DIO_4: R5.1, U1.29 (PB5(OC1A/ADC12/!OC4B))
DIO_4_R: J1.6, R5.2
DIO_5: R4.1, U1.30 (PB6(OC1B/OC4B/ADC13))
DIO_5_R: J1.7, R4.2
DIO_6: R3\.1, U1.31 (PC6(OC3A/!OC4A))
DIO_6_R: J1.8, R3\.2
DIO_7: R2.1, U1.32 (PC7(ICP3/CLK0/OC4A))
DIO_7_R: J1.9, R2.2
GND: C1.2, C2.2, C3.2, C4.2, C5.2, C6.2, C7.2, C8.2, C10.2, J1.1, J1.11, J2.6, J3.5, R7.1, R8.1, R9.1, R14.1, S1.1.1 (1), S1.1.2 (1), U1.5 (UGND), U1.15 (GND), U1.23 (GND1), U1.35 (GND2), U1.43 (GND3); also elsewhere on the board
LED3: LED3.A, U1.22 (PD5(XCK/CTS))
LED4: LED4.A, U1.21 (PD3(INT3/TXD1))
MCU_RST: C7.1, J1.2, J2.5, R1.1, S1.2.1 (2), S1.2.2 (2), U1.13 (/RESET)
MISO_5V: J2.1, U1.11 (PB3(PDO/MISO)); also elsewhere on the board
MOSI_5V: J2.4, U1.10 (PB2(PDI/MOSI)); also elsewhere on the board
unnamed: LED3.C, R9.2
unnamed: LED1.C, R7.2
unnamed: LED2.C, R8.2
unnamed: J3.2, R10.2
unnamed: LED4.C, R14.2
unnamed: D1.A, J3.1
unnamed: J3.3, R11.2
RADIO_RST_5V: U1.41 (PF0(ADC0)); also elsewhere on the board
SCK_5V: J2.3, U1.9 (PB1(SCK)); also elsewhere on the board
SS_5V: U1.8 (PB0(SS)); also elsewhere on the board
UCAP: C4.1, U1.6 (UCAP)
XTAL1: C8.1, U1.17 (XTAL1), X1.1
XTAL2: C10.1, U1.16 (XTAL2), X1.3 (2)

Notes on the sheet:
Modified from Austin Keener's LIDAR board
5V IN
Interface Header
POGO Header
RC to debounce switch
Reset
Control board/Daughterboard has a motor enabled light
LEDs
Running at 5V 50mA estimated max power consumption
In remote, this should be connected to 5V, GND, and the 3 LEDs.
R2-R5 should be 0 ohm on the modules that go in Sedani and EVGP. 330 ohm for remotes for the LEDs
Microcontroller
USB Header
Total estimated board power draw: 225 mA

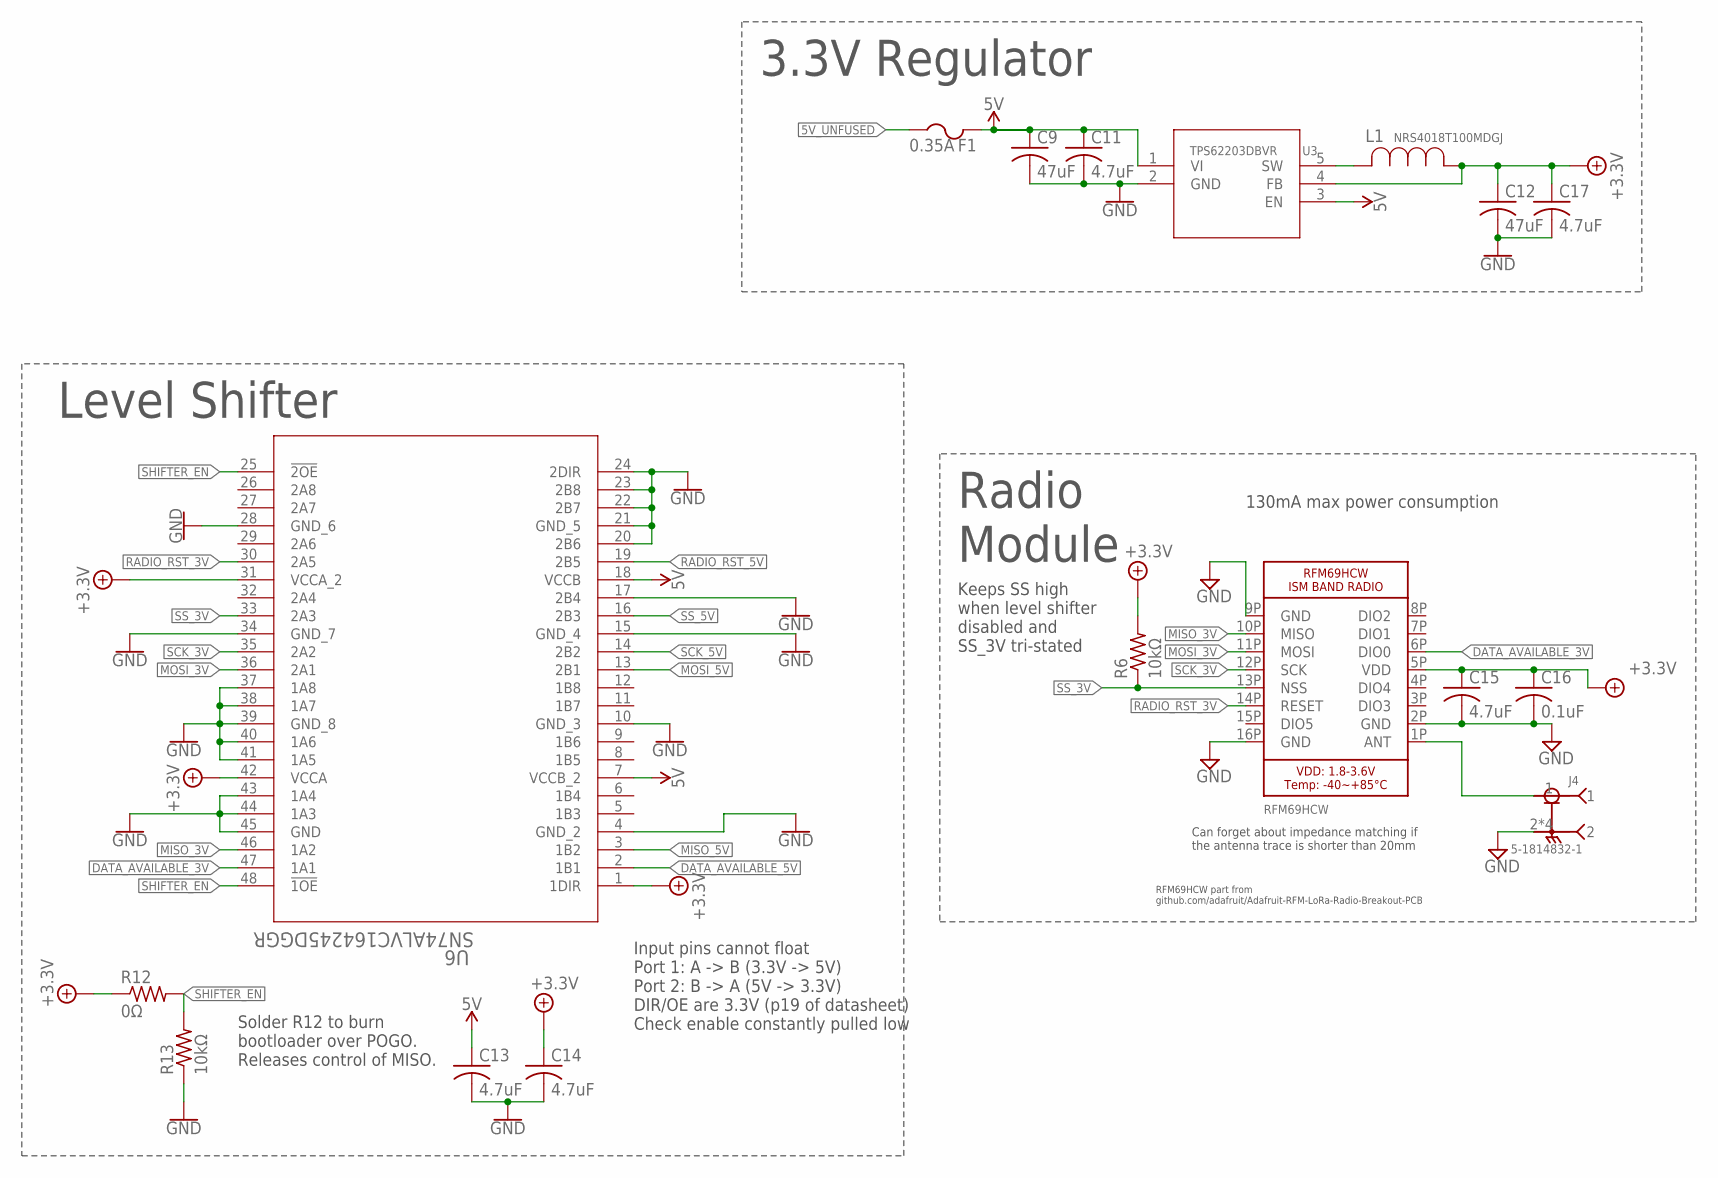
[picture p66: schematic e-stop-radio.sch, sheet 2]

Parts:
C9, C12: 47uF; C1206
C11, C13, C14, C15, C17: 4.7uF; C0603
C16: 0.1uF; C0603
F1: 0.35A; R1206
J4: 5-1814832-1; TE_5-1814832-1
L1: NRS4018T100MDGJ; IND_TAIYO_NRS4018
R6, R13: 10kΩ; R0603
R12: 0Ω; R0603
U3: TPS62203DBVR; DBV5
U5: RFM69HCW; RFMHCW_SMT
U6: SN74ALVC164245DGGR; DGG48

Connections:
5V: C9.1, C11.1, C13.1, F1.2, U3.1 (VI), U3.3 (EN), U6.7 (VCCB_2), U6.18 (VCCB); also elsewhere on the board
5V_UNFUSED: F1.1; also elsewhere on the board
+3.3V: C12.1, C14.1, C15.1, C16.1, C17.1, L1.1, R6.2, R12.1, U3.4 (FB), U5.5P (VDD), U6.1 (1DIR), U6.31 (VCCA_2), U6.42 (VCCA); also elsewhere on the board
DATA_AVAILABLE_3V: U5.6P (DIO0), U6.47 (1A1)
DATA_AVAILABLE_5V: U6.2 (1B1); also elsewhere on the board
GND: C9.2, C11.2, C12.2, C13.2, C14.2, C15.2, C16.2, C17.2, J4.2, J4.3 (2), J4.4 (2), J4.5 (2), R13.1, U3.2 (GND), U5.2P (GND), U5.9P (GND), U5.16P (GND), U6.4 (GND_2), U6.10 (GND_3), U6.15 (GND_4), U6.17 (2B4), U6.20 (2B6), U6.21 (GND_5), U6.22 (2B7), U6.23 (2B8), U6.24 (2DIR), U6.28 (GND_6), U6.34 (GND_7), U6.37 (1A8), U6.38 (1A7), U6.39 (GND_8), U6.40 (1A6), U6.41 (1A5), U6.43 (1A4), U6.44 (1A3), U6.45 (GND); also elsewhere on the board
MISO_3V: U5.10P (MISO), U6.46 (1A2)
MISO_5V: U6.3 (1B2); also elsewhere on the board
MOSI_3V: U5.11P (MOSI), U6.36 (2A1)
MOSI_5V: U6.13 (2B1); also elsewhere on the board
unnamed: L1.2, U3.5 (SW)
RADIO_RST_3V: U5.14P (RESET), U6.30 (2A5)
RADIO_RST_5V: U6.19 (2B5); also elsewhere on the board
RF_SIGNAL: J4.1, U5.1P (ANT)
SCK_3V: U5.12P (SCK), U6.35 (2A2)
SCK_5V: U6.14 (2B2); also elsewhere on the board
SHIFTER_EN: R12.2, R13.2, U6.25 (!2OE), U6.48 (!1OE)
SS_3V: R6.1, U5.13P (NSS), U6.33 (2A3)
SS_5V: U6.16 (2B3); also elsewhere on the board

Notes on the sheet:
RFM69HCW part from github.com/adafruit/Adafruit-RFM-LoRa-Radio-Breakout-PCB
130mA max power consumption
Radio Module
Can forget about impedance matching if the antenna trace is shorter than 20mm
3.3V Regulator
Level Shifter
Solder R12 to burn bootloader over POGO. Releases control of MISO.
Input pins cannot float Port 1: A -> B (3.3V -> 5V) Port 2: B -> A (5V -> 3.3V) DIR/OE are 3.3V (p19 of datasheet) Check enable constantly pulled low
Keeps SS high when level shifter disabled and SS_3V tri-stated

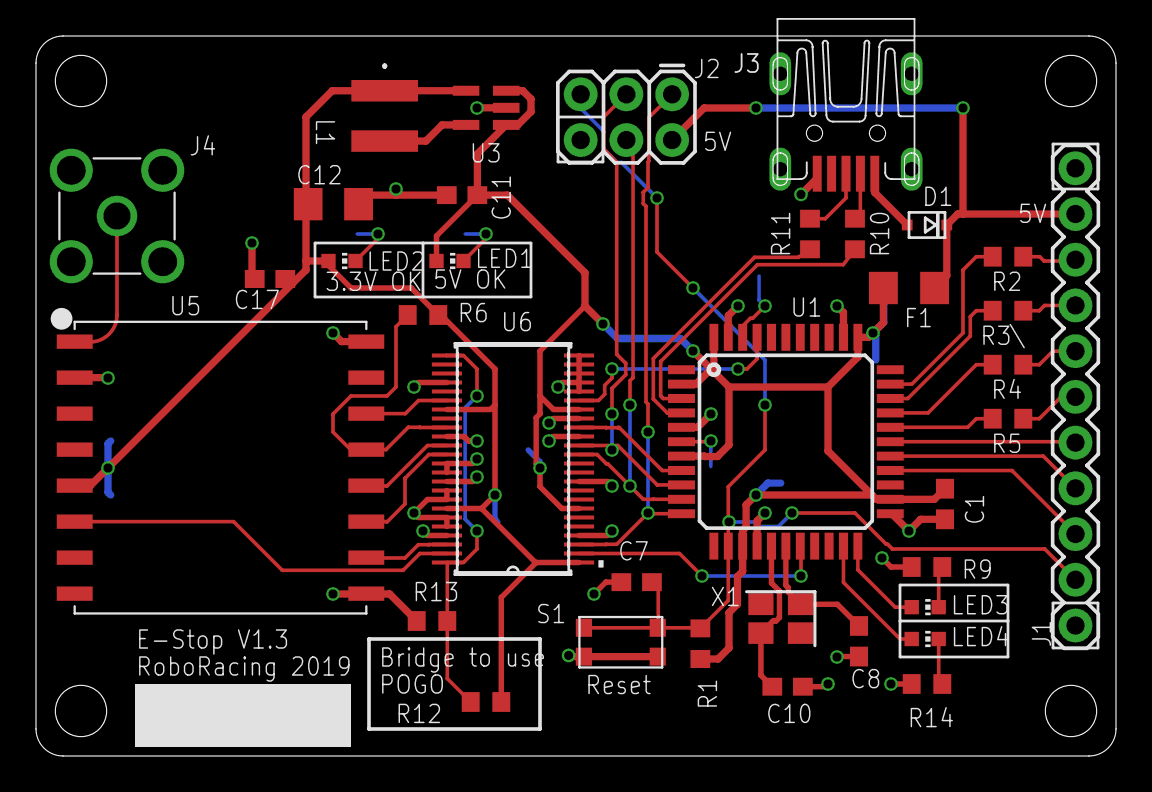
[picture p67: board e-stop-radio.brd from above]

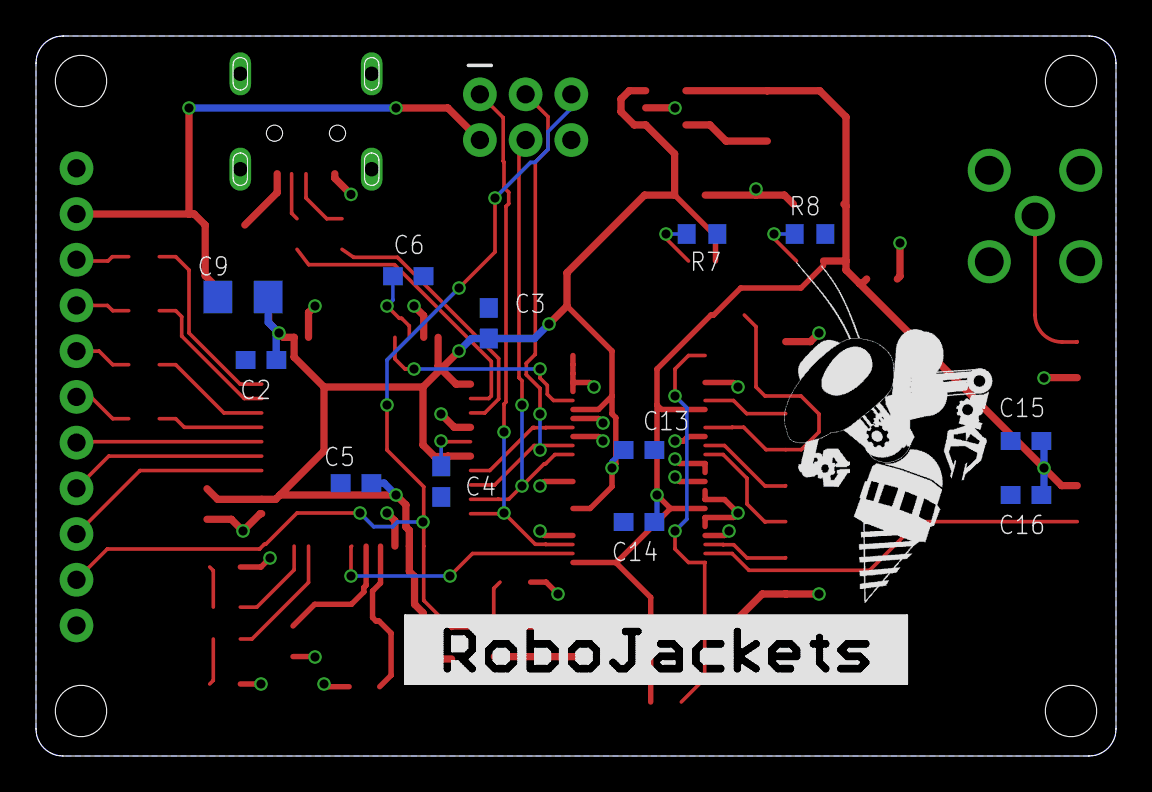
[picture p68: board e-stop-radio.brd from below]

Board: 2 copper layers, 60.0 x 40.0 mm, 50 parts (14 on the bottom side), 46 nets.

Other parts of the board:
U$1: ROBOBUZZ_1.0X
U$2: ROBOJACKETS
