RoboJackets/roboracing-electrical/sedani/chassis_control_board/sedani_chassis_control.brd

## EAGLE design sedani/chassis_control_board/sedani_chassis_control.brd (2020-05-11)

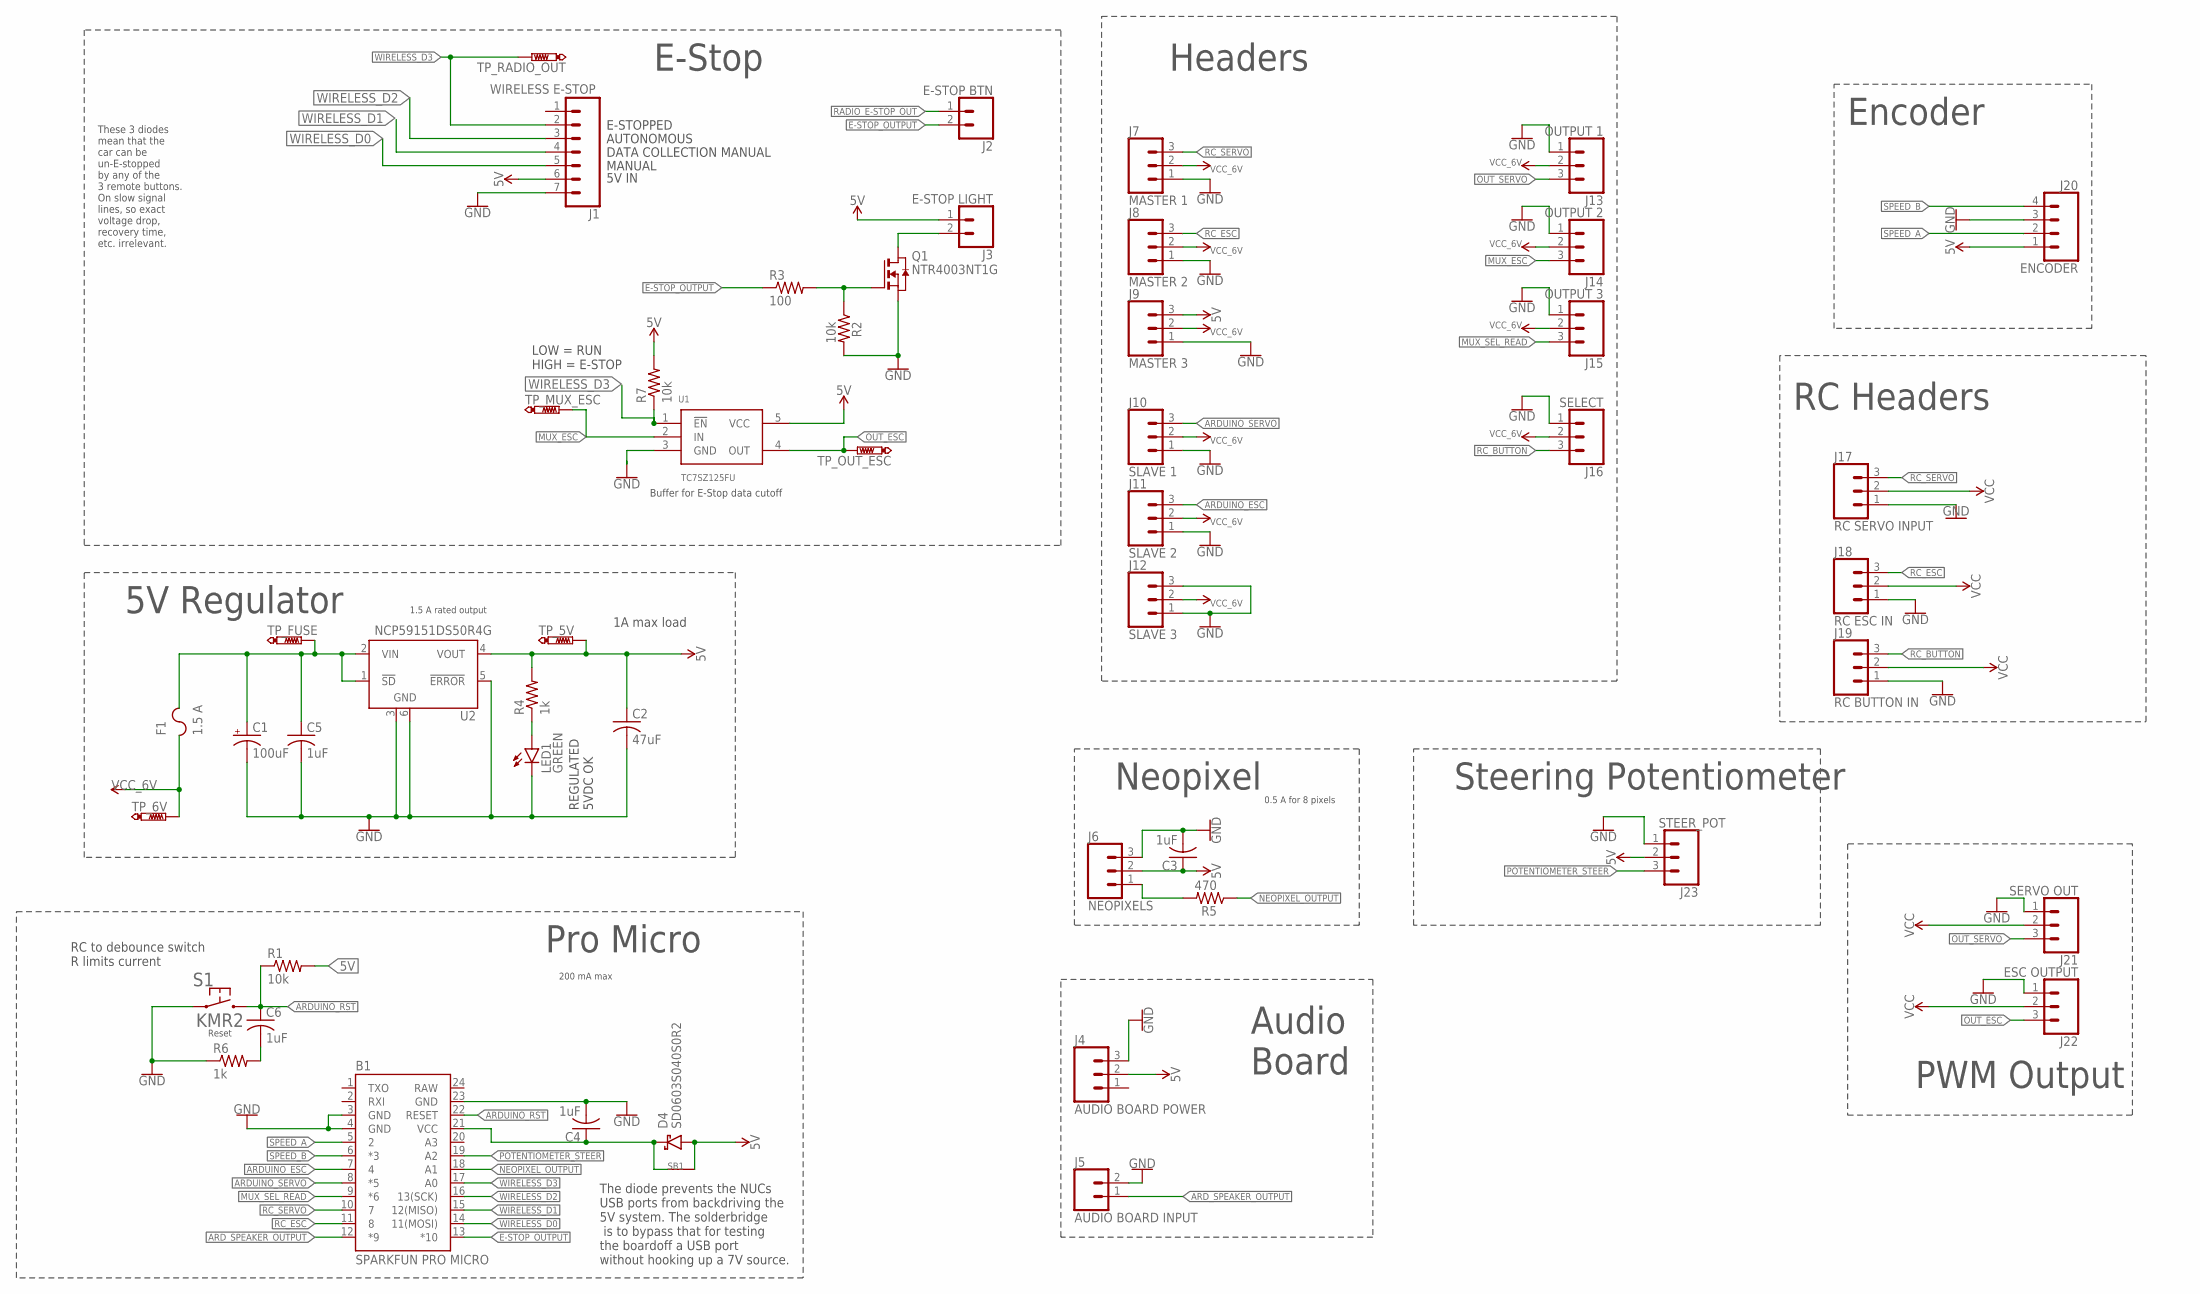
[picture p69: schematic sedani_chassis_control.sch]

Parts:
B1: SPARKFUN PRO MICRO; SPARKFUN_PRO_MICRO
C1: 100uF; E2-5
C2: 47uF; C1206
C3, C4, C5, C6: 1uF; C0603
D4: SD0603S040S0R2; SOD-323
F1: 1.5 A; F1812
J1: WIRELESS E-STOP; 1X07
J2: E-STOP BTN; 1X02
J3: E-STOP LIGHT; 1X02
J4: AUDIO BOARD POWER; 1X03
J5: AUDIO BOARD INPUT; 1X02
J6: NEOPIXELS; 1X03
J7: MASTER 1; 1X03
J8: MASTER 2; 1X03
J9: MASTER 3; 1X03
J10: SLAVE 1; 1X03
J11: SLAVE 2; 1X03
J12: SLAVE 3; 1X03
J13: OUTPUT 1; 1X03
J14: OUTPUT 2; 1X03
J15: OUTPUT 3; 1X03
J16: SELECT; 1X03
J17: RC SERVO INPUT; 1X03
J18: RC ESC IN; 1X03
J19: RC BUTTON IN; 1X03
J20: ENCODER; 1X04
J21: SERVO OUT; 1X03
J22: ESC OUTPUT; 1X03
J23: STEER_POT; 1X03
LED1: GREEN; CHIP-LED0603
Q1: NTR4003NT1G; SOT-23-3
R1, R2, R7: 10k; R0603
R3: 100; R0603
R4, R6: 1k; R0603
R5: 470; R0603
S1: KMR2
SB1: SOLDERBRIDGESB0603; SB0603
TP_5V, TP_6V: PTR1B1,27; B1,27
TP_FUSE: PTR1B1,27; B1,27
TP_MUX_ESC: PTR1B1,27; B1,27
TP_OUT_ESC: PTR1B1,27; B1,27
TP_RADIO_OUT: PTR1B1,27; B1,27
U1: TC7SZ125FU; SOT-353
U2: NCP59151DS50R4G; TO263-5

Connections:
5V: C2.1, C3.1, D4.A, J1.6, J3.1, J4.2, J6.2, J9.3, J20.1, J23.2, R1.2, R4.2, R7.2, SB1.2, TP_5V.TP, U1.5 (VCC), U2.4 (VOUT)
ARDUINO_ESC: B1.7 (4), J11.3
ARDUINO_RST: B1.22 (RESET), C6.1, R1.1, S1.2.1 (2), S1.2.2 (2)
ARDUINO_SERVO: B1.8 (*5), J10.3
ARD_SPEAKER_OUTPUT: B1.12 (*9), J5.1
E-STOP_OUTPUT: B1.13 (*10), J2.2, R3.1
GND: B1.3 (GND), B1.4 (GND), B1.23 (GND), C1.-, C2.2, C3.2, C4.2, C5.2, J1.7, J4.3, J5.2, J6.3, J7.1, J8.1, J9.1, J10.1, J11.1, J12.1, J12.3, J13.1, J14.1, J15.1, J16.1, J17.1, J18.1, J19.1, J20.3, J21.1, J22.1, J23.1, LED1.C, Q1.2 (S), R2.2, R6.1, S1.1.1 (1), S1.1.2 (1), U1.3 (GND), U2.3 (GND), U2.5 (!ERROR), U2.6 (GND)
MUX_ESC: J14.3, TP_MUX_ESC.TP, U1.2 (IN)
MUX_SEL_READ: B1.9 (*6), J15.3
unnamed: J3.2, Q1.3 (D)
unnamed: B1.21 (VCC), C4.1, D4.C, SB1.1
unnamed: LED1.A, R4.1
unnamed: J6.1, R5.2
unnamed: C6.2, R6.2
unnamed: Q1.1 (G), R2.1, R3.2
NEOPIXEL_OUTPUT: B1.18 (A1), R5.1
OUT_ESC: J22.3, TP_OUT_ESC.TP, U1.4 (OUT)
OUT_SERVO: J13.3, J21.3
POTENTIOMETER_STEER: B1.19 (A2), J23.3
RADIO_E-STOP_OUT: J2.1
RAW: B1.24 (RAW)
RC_BUTTON: J16.3, J19.3
RC_ESC: B1.11 (8), J8.3, J18.3
RC_SERVO: B1.10 (7), J7.3, J17.3
SPEED_A: B1.5 (2), J20.2
SPEED_B: B1.6 (*3), J20.4
VCC_6V: F1.1, J7.2, J8.2, J9.2, J10.2, J11.2, J12.2, J13.2, J14.2, J15.2, J16.2, J17.2, J18.2, J19.2, J21.2, J22.2, TP_6V.TP
VIN: C1.+, C5.1, F1.2, TP_FUSE.TP, U2.1 (!SD), U2.2 (VIN)
WIRELESS_D0: B1.14 (11(MOSI)), J1.5
WIRELESS_D1: B1.15 (12(MISO)), J1.4
WIRELESS_D2: B1.16 (13(SCK)), J1.3
WIRELESS_D3: B1.17 (A0), J1.2, R7.1, TP_RADIO_OUT.TP, U1.1 (!EN)

Notes on the sheet:
E-STOPPED
AUTONOMOUS
DATA COLLECTION MANUAL
MANUAL
5V IN
REGULATED 5VDC OK
E-Stop
Headers
Encoder
Audio Board
Pro Micro
PWM Output
5V Regulator
Neopixel
These 3 diodes mean that the car can be un-E-stopped by any of the 3 remote buttons. On slow signal lines, so exact voltage drop, recovery time, etc. irrelevant.
0.5 A for 8 pixels
200 mA max
1A max load
1.5 A rated output
RC Headers
RC to debounce switch R limits current
The diode prevents the NUCs USB ports from backdriving the 5V system. The solderbridge is to bypass that for testing the boardoff a USB port without hooking up a 7V source.
Buffer for E-Stop data cutoff
LOW = RUN HIGH = E-STOP
Steering Potentiometer

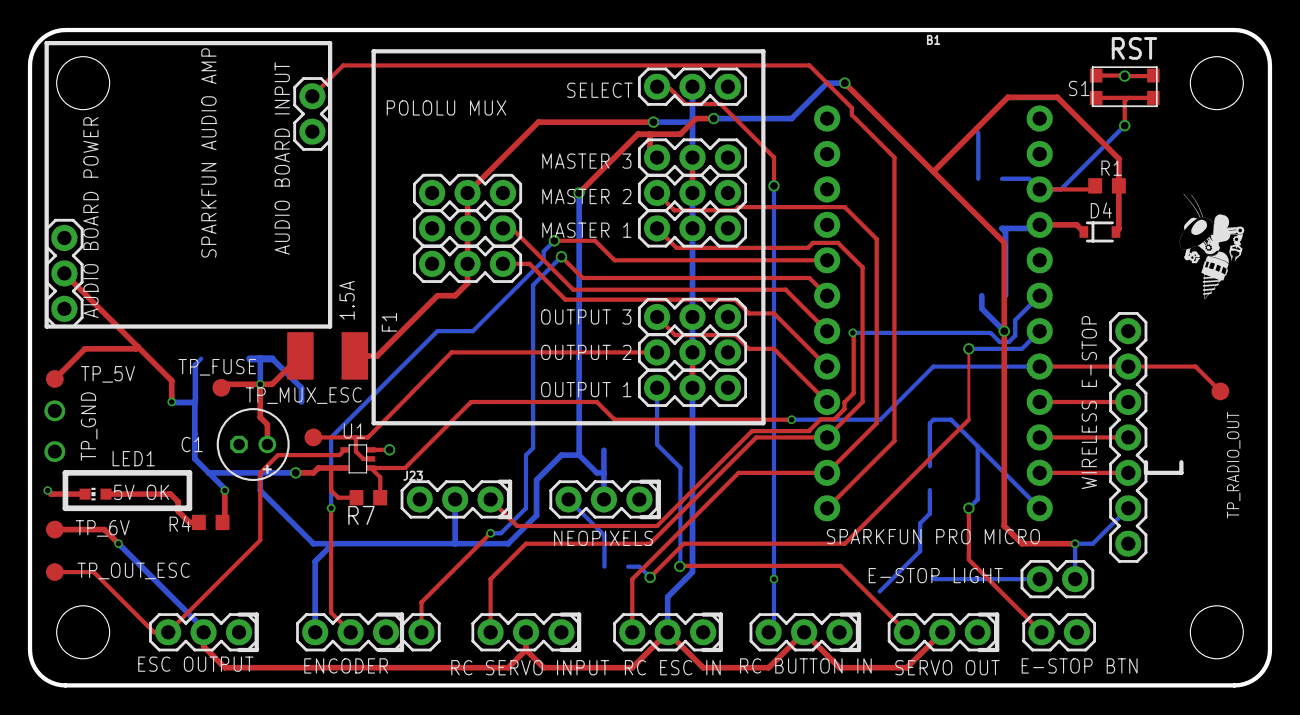
[picture p70: board sedani_chassis_control.brd from above]

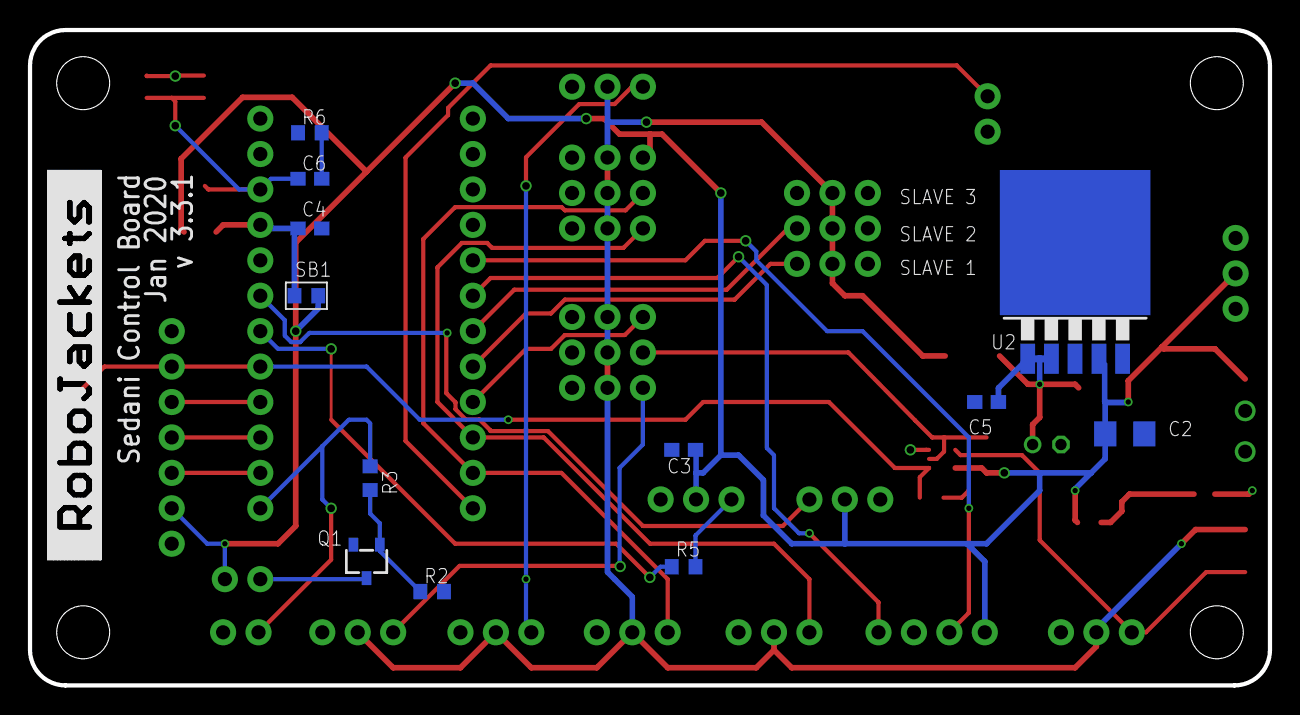
[picture p71: board sedani_chassis_control.brd from below]

Board: 2 copper layers, 88.9 x 47.0 mm, 53 parts (13 on the bottom side), 30 nets.

Other parts of the board:
U$2: ROBOJACKETS
U$3: ROBOBUZZ_0.4X
