RoboJackets/roboracing-electrical/estop_daugherboard/EVGP_Estop_Daugherboard.brd

## EAGLE design estop_daugherboard/EVGP_Estop_Daugherboard.brd (2020-05-11)

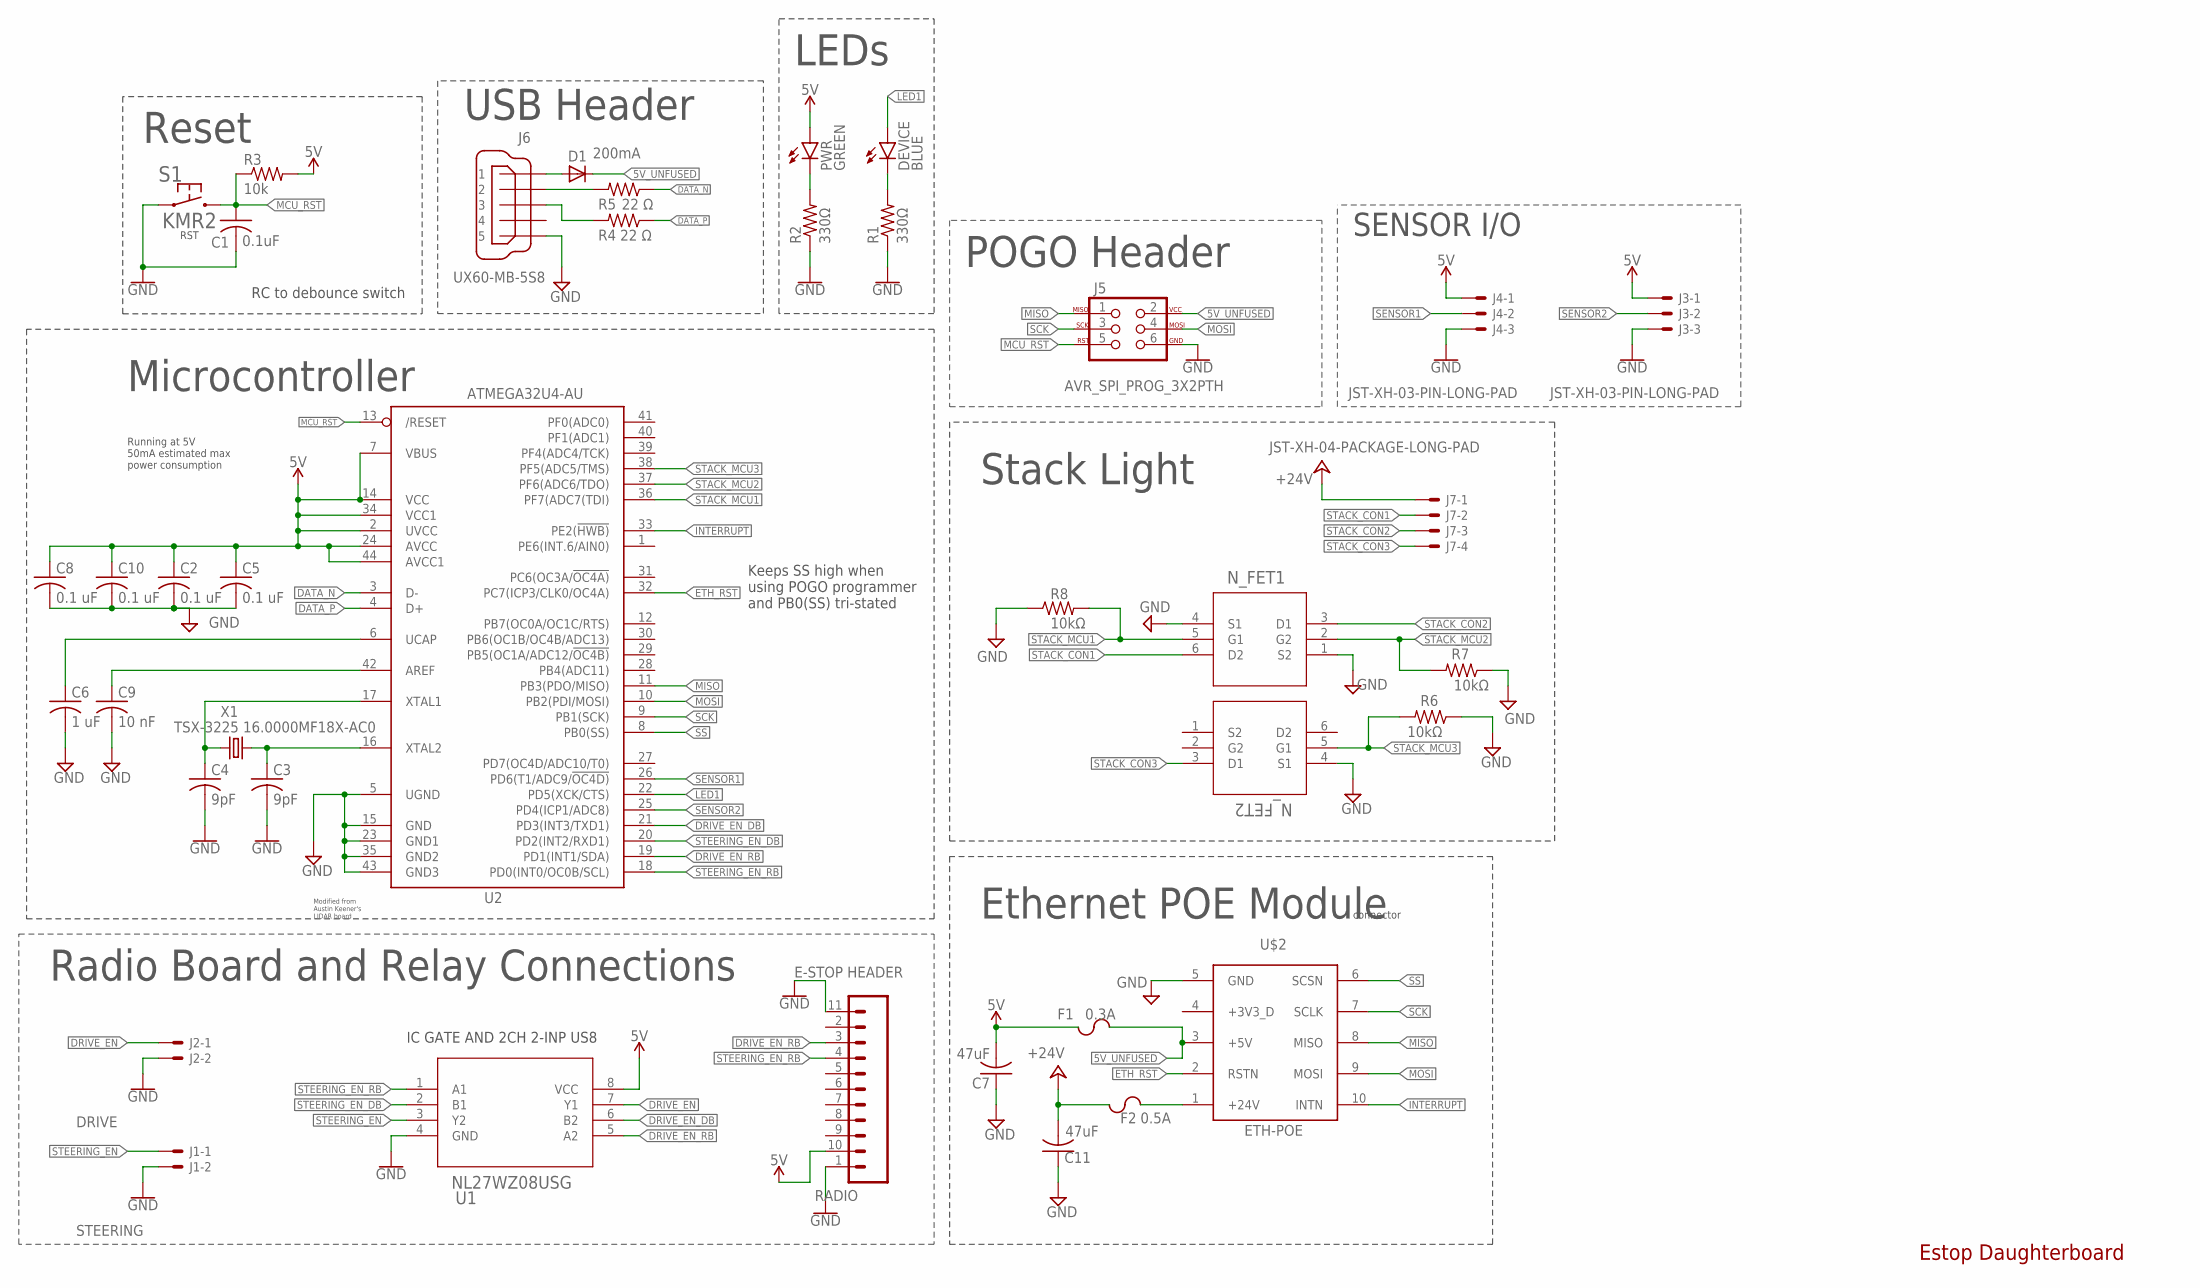
[picture p72: schematic EVGP_Estop_Daugherboard.sch]

Parts:
C1: 0.1uF; C0603
C2, C5, C8, C10: 0.1 uF; C0603
C3, C4: 9pF; C0603
C6: 1 uF; C0603
C7, C11: 47uF; C1206
C9: 10 nF; C0603
D1: 200mA; SOD323-R
DEVICE: BLUE; CHIP-LED0603
F1: 0.3A; F1206
F2: 0.5A; F1206
J1: STEERING; JST-XH-02-PACKAGE-LONG-PAD
J2: DRIVE; JST-XH-02-PACKAGE-LONG-PAD
J3, J4: JST-XH-03-PIN-LONG-PAD; JST-XH-03-PACKAGE-LONG-PAD
J5: AVR_SPI_PROG_3X2PTH; 2X3
J6: UX60-MB-5S8
J7: JST-XH-04-PACKAGE-LONG-PAD
PWR: GREEN; CHIP-LED0603
Q1: N_FET2; SOT-363
Q2: N_FET1; SOT-363
R1, R2: 330Ω; R0603
R3: 10k; R0603
R4, R5: 22 Ω; R0603
R6, R7, R8: 10kΩ; R0603
RADIO: E-STOP HEADER; RADIO_V1.3
S1: KMR2
U1: NL27WZ08USG; US8_2P40X2P10
U2: ATMEGA32U4-AU; TQFP44
U$2: ETH-POE; HDRVR10W64P4000X254_2X5_1016X508X254B
X1: TSX-3225 16.0000MF18X-AC0; XTAL-3.2X2.5

Connections:
5V: C2.1, C5.1, C7.2, C8.1, C10.1, F1.1, J3.1, J4.1, PWR.A, R3.2, RADIO.10 (5V), U1.8 (VCC), U2.2 (UVCC), U2.7 (VBUS), U2.14 (VCC), U2.24 (AVCC), U2.34 (VCC1), U2.44 (AVCC1)
5V_UNFUSED: D1.C, F1.2, J5.2, U$2.3 (+5V)
24V_UNFUSED: F2.2, U$2.1 (+24V)
+24V: C11.2, F2.1, J7.1
AREF: C9.1, U2.42 (AREF)
DATA_N: R5.1, U2.3 (D-)
DATA_P: R4.1, U2.4 (D+)
DRIVE_EN: J2.1, U1.7 (Y1)
DRIVE_EN_DB: U1.6 (B2), U2.21 (PD3(INT3/TXD1))
DRIVE_EN_RB: RADIO.3 (D1), U1.5 (A2), U2.19 (PD1(INT1/SDA))
ETH_RST: U2.32 (PC7(ICP3/CLK0/OC4A)), U$2.2 (RSTN)
GND: C1.2, C2.2, C3.2, C4.2, C5.2, C6.2, C7.1, C8.2, C9.2, C10.2, C11.1, J1.2, J2.2, J3.3, J4.3, J5.6, J6.5, Q1.4 (S1), Q2.1 (S2), Q2.4 (S1), R1.1, R2.1, R6.1, R7.1, R8.1, RADIO.1 (GND), RADIO.11 (GND), S1.1.1 (1), S1.1.2 (1), U1.4 (GND), U2.5 (UGND), U2.15 (GND), U2.23 (GND1), U2.35 (GND2), U2.43 (GND3), U$2.5 (GND)
INTERRUPT: U2.33 (PE2(!HWB)), U$2.10 (INTN)
LED1: DEVICE.A, U2.22 (PD5(XCK/CTS))
MCU_RST: C1.1, J5.5, R3.1, S1.2.1 (2), S1.2.2 (2), U2.13 (/RESET)
MISO: J5.1, U2.11 (PB3(PDO/MISO)), U$2.8 (MISO)
MOSI: J5.4, U2.10 (PB2(PDI/MOSI)), U$2.9 (MOSI)
unnamed: PWR.C, R2.2
unnamed: J6.2, R5.2
unnamed: DEVICE.C, R1.2
unnamed: D1.A, J6.1
unnamed: J6.3, R4.2
SCK: J5.3, U2.9 (PB1(SCK)), U$2.7 (SCLK)
SENSOR1: J4.2, U2.26 (PD6(T1/ADC9/!OC4D))
SENSOR2: J3.2, U2.25 (PD4(ICP1/ADC8))
SS: U2.8 (PB0(SS)), U$2.6 (SCSN)
STACK_CON1: J7.2, Q2.6 (D2)
STACK_CON2: J7.3, Q2.3 (D1)
STACK_CON3: J7.4, Q1.3 (D1)
STACK_MCU1: Q2.5 (G1), R8.2, U2.36 (PF7(ADC7(TDI))
STACK_MCU2: Q2.2 (G2), R7.2, U2.37 (PF6(ADC6/TDO))
STACK_MCU3: Q1.5 (G1), R6.2, U2.38 (PF5(ADC5/TMS))
STEERING_EN: J1.1, U1.3 (Y2)
STEERING_EN_DB: U1.2 (B1), U2.20 (PD2(INT2/RXD1))
STEERING_EN_RB: RADIO.4 (D2), U1.1 (A1), U2.18 (PD0(INT0/OC0B/SCL))
UCAP: C6.1, U2.6 (UCAP)
XTAL1: C4.1, U2.17 (XTAL1), X1.1
XTAL2: C3.1, U2.16 (XTAL2), X1.3 (2)

Notes on the sheet:
Modified from Austin Keener's LIDAR board
POGO Header
RC to debounce switch
Reset
LEDs
Running at 5V 50mA estimated max power consumption
Microcontroller
USB Header
Keeps SS high when using POGO programmer and PB0(SS) tri-stated
Radio Board and Relay Connections
IC GATE AND 2CH 2-INP US8
SENSOR I/O
Stack Light
Ethernet POE Module
connector
Estop Daughterboard
