RoboJackets/roboracing-electrical/estop_daugherboard/EVGP_Estop_Daugherboard.brd

## EAGLE design estop_daugherboard/EVGP_Estop_Daugherboard.brd (continued)

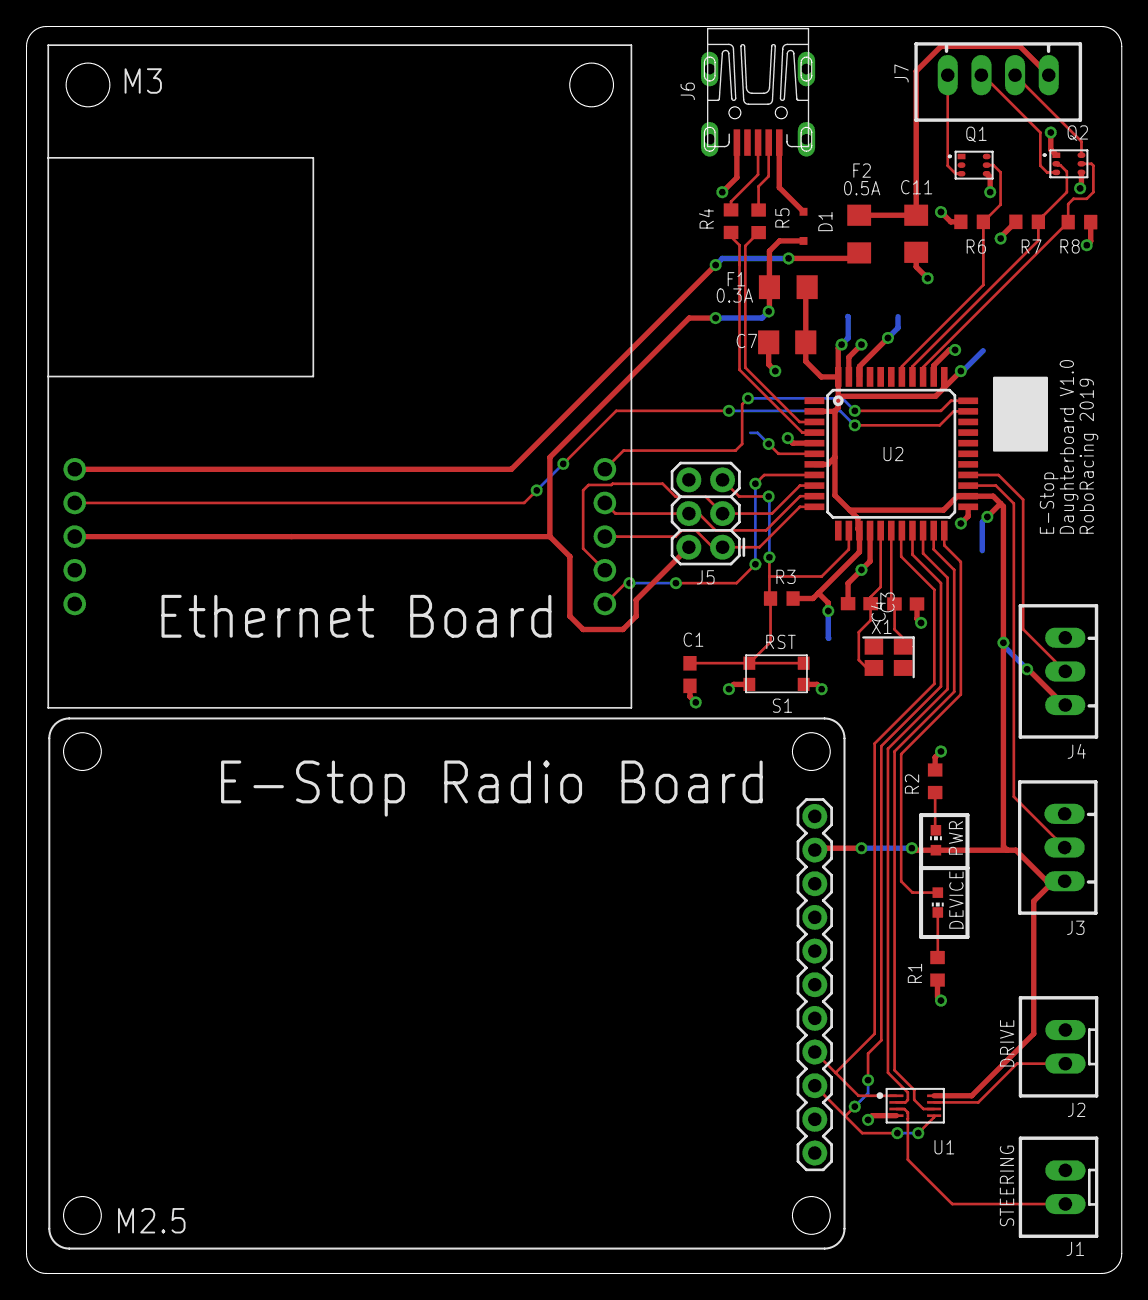
[picture p73: board EVGP_Estop_Daugherboard.brd from above]

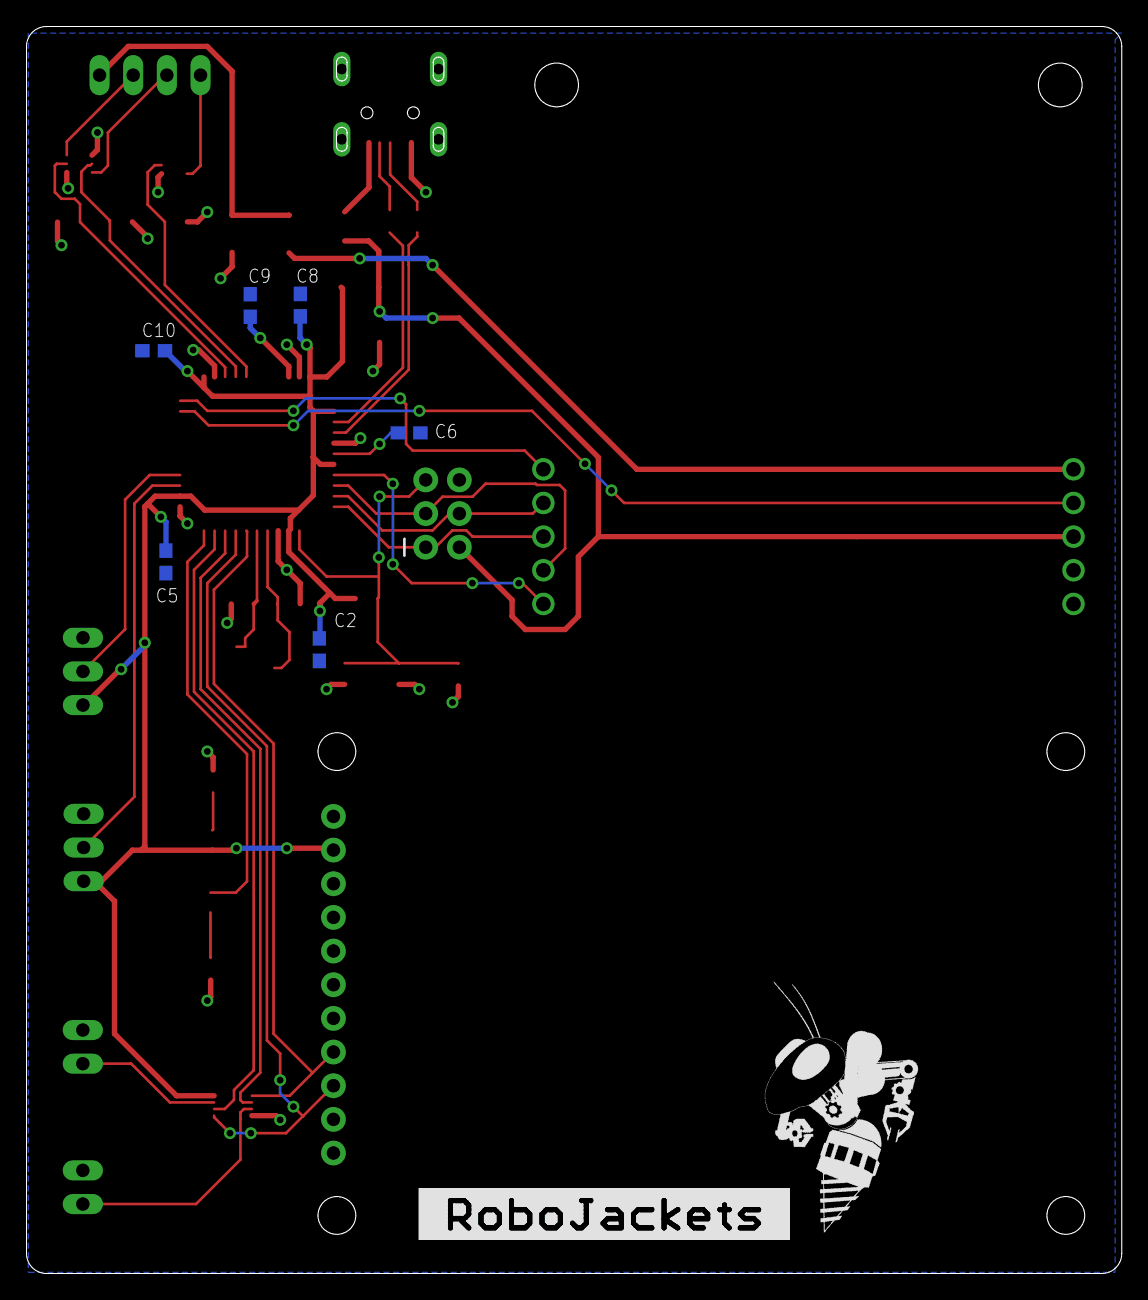
[picture p74: board EVGP_Estop_Daugherboard.brd from below]

Board: 2 copper layers, 82.6 x 94.1 mm, 41 parts (8 on the bottom side), 38 nets.

Other parts of the board:
U$1: ROBOBUZZ_1.0X
U$3: ROBOJACKETS
