RoboJackets/roboracing-electrical/lidar-breakout/V2/LIDAR_Breakout_V2.brd

## EAGLE design lidar-breakout/V2/LIDAR_Breakout_V2.brd (2019-04-24)

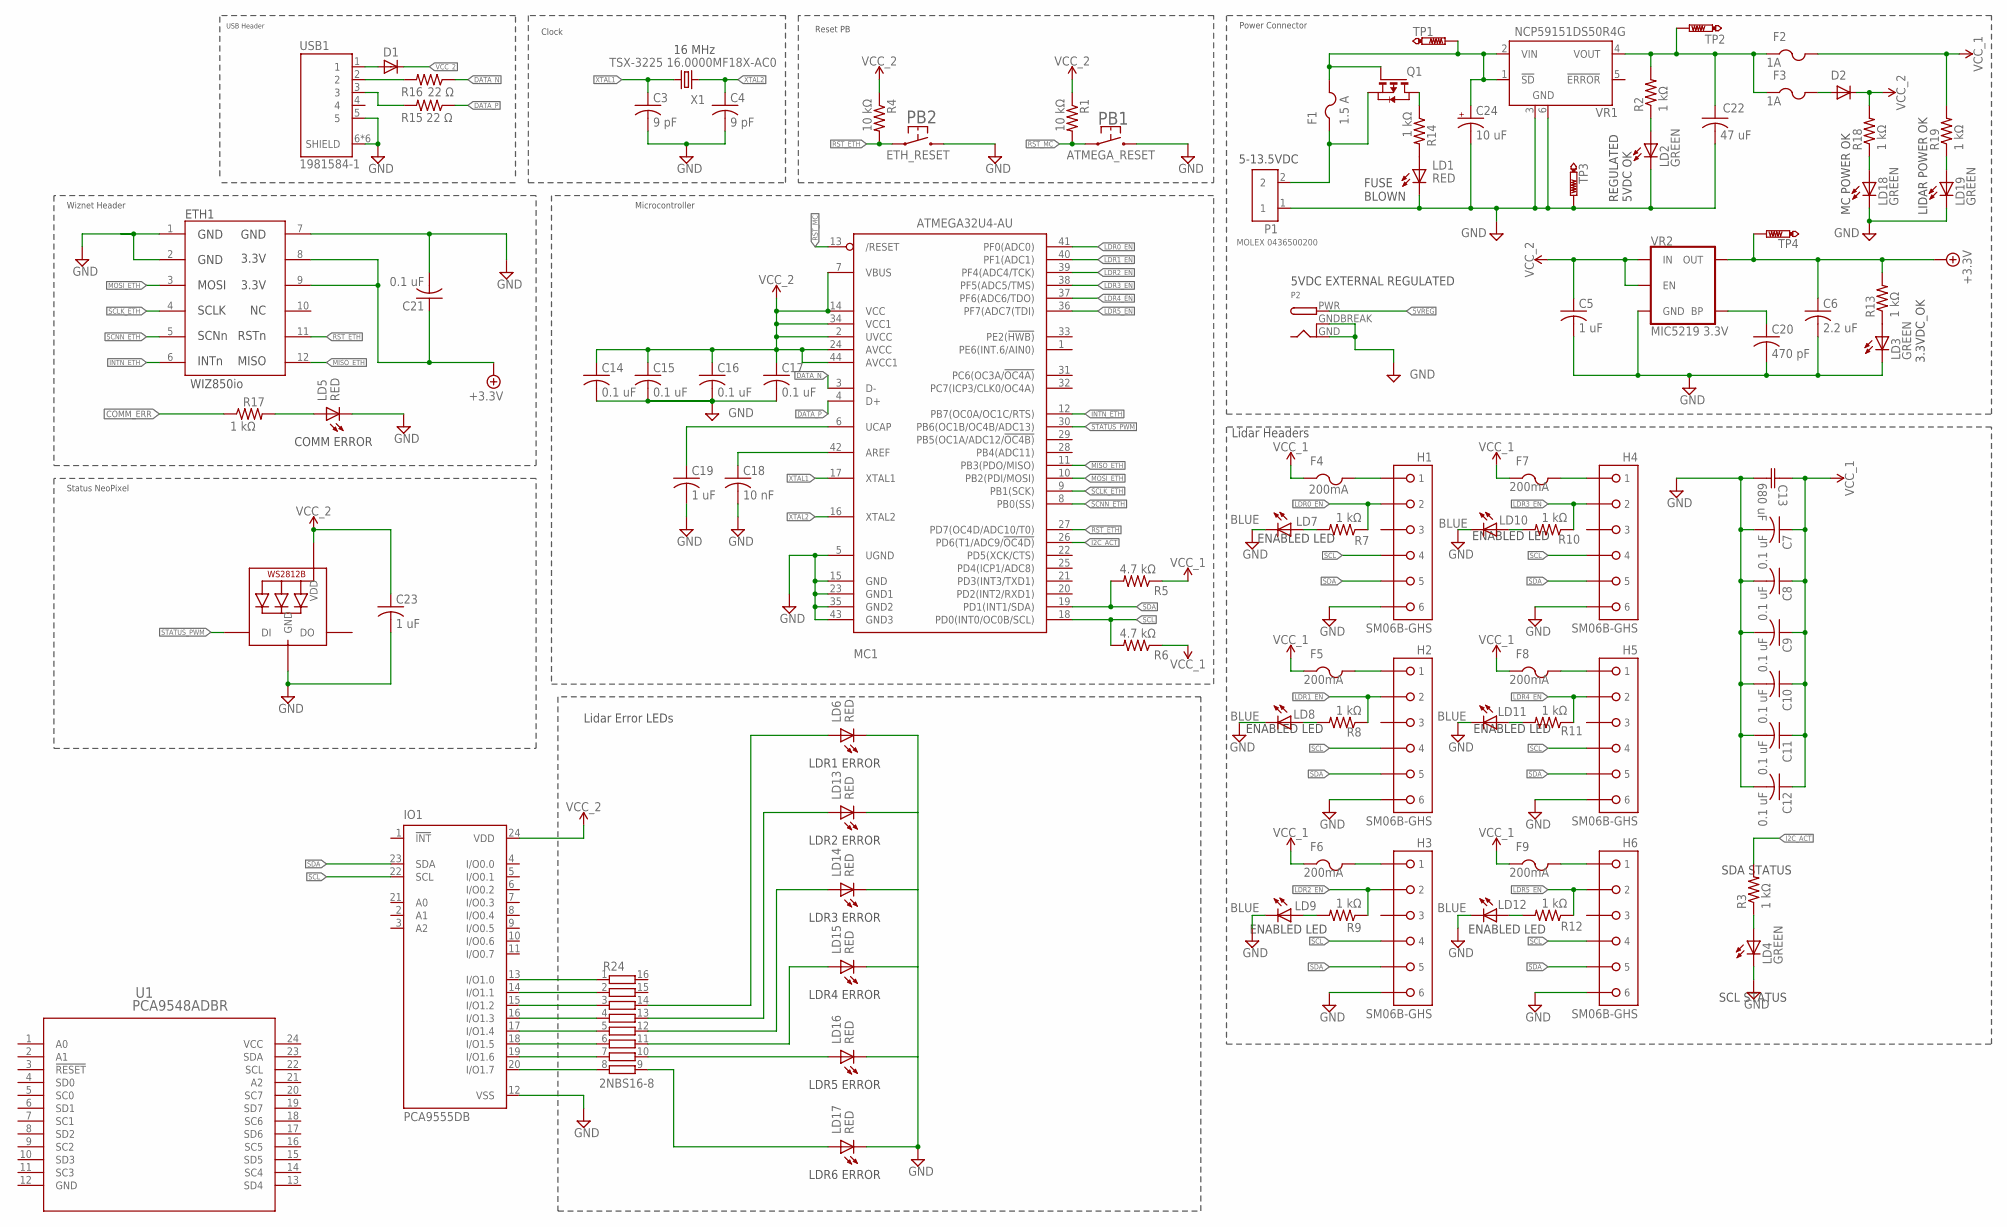
[picture p75: schematic LIDAR_Breakout_V2.sch]

Parts:
C3, C4: 9 pF; C0603
C5, C19, C23: 1 uF; C0603
C6: 2.2 uF; C0603
C7, C8, C9, C10, C11, C12, C14, C15, C16, C17, C21: 0.1 uF; C0603
C13: 680 uF; CAP_PAN_EEE_D8
C18: 10 nF; C0603
C20: 470 pF; C0603
C22: 47 uF; C0805
C24: 10 uF; E2-5
D1, D2: DIODE-DO-214AC; DO-214AC
ETH1: WIZ850IO
F1: 1.5 A; 1812
F2, F3: 1A; R1206
F4, F5, F6, F7, F8, F9: 200mA; R1206
H1, H2, H3, H4, H5, H6: SM06B-GHS
IO1: PCA9555DB; SSOP24
LD1, LD5, LD6, LD13, LD14, LD15, LD16, LD17: RED; CHIP-LED0603
LD2, LD3, LD4, LD18, LD19: GREEN; CHIP-LED0603
LD7, LD8, LD9, LD10, LD11, LD12: BLUE; CHIP-LED0603
LED1: WS2812B5050; WS2812B
MC1: ATMEGA32U4-AU; TQFP44
P1: MOLEX 0436500200; MOLEX_0436500200
P2: DCBARRELPTH; DCJACK_2MM_PTH
PB1: ATMEGA_RESET; RESET_PB_RA
PB2: ETH_RESET; RESET_PB_RA
Q1: PMOS; SOT-23-3
R1, R4: 10 kΩ; R0603
R2, R3, R7, R8, R9, R10, R11, R12, R13, R14, R17, R18, R19: 1 kΩ; R0603
R5, R6: 4.7 kΩ; R0603
R15, R16: 22 Ω; R0603
R24: 2NBS16-8; SO16
TP1, TP2, TP4: PTR1B1,27; B1,27
TP3: PTR1PAD1-13; P1-13
U1: PCA9548ADBR; DB24
USB1: 1981584-1; TE_1981584-1
VR1: NCP59151DS50R4G; TO263-5
VR2: MIC5219 3.3V; SOT23-5
X1: TSX-3225 16.0000MF18X-AC0; XTAL-3.2X2.5

Connections:
5VREG: C22.1, F2.1, F3.1, P2.PWR, R2.2, TP2.TP, VR1.4 (VOUT)
+3.3V: C6.1, C21.1, ETH1.8, ETH1.9, R13.2, TP4.TP, VR2.5 (OUT)
AREF: C18.1, MC1.42 (AREF)
COMM_ERR: R17.1
DATA_N: MC1.3 (D-), R16.1
DATA_P: MC1.4 (D+), R15.1
GND: C3.2, C4.2, C5.2, C6.2, C7.2, C8.2, C9.2, C10.2, C11.2, C12.2, C13.2 (22), C14.2, C15.2, C16.2, C17.2, C18.2, C19.2, C20.2, C21.2, C22.2, C23.2, C24.-, ETH1.1, ETH1.2, ETH1.7, H1.P$8 (6), H2.P$8 (6), H3.P$8 (6), H4.P$8 (6), H5.P$8 (6), H6.P$8 (6), IO1.12 (VSS), LD1.C (K), LD2.C, LD3.C, LD4.C, LD5.C (K), LD6.C (K), LD7.C, LD8.C, LD9.C, LD10.C, LD11.C, LD12.C, LD17.C (K), LD18.C, LD19.C, LED1.3-GND (GND), MC1.5 (UGND), MC1.15 (GND), MC1.23 (GND1), MC1.35 (GND2), MC1.43 (GND3), P1.1, P2.GND, P2.GNDBREAK, PB1.P$3 (2), PB2.P$3 (2), TP3.TP, U1.12 (GND), USB1.5, USB1.6 (SHIELD), USB1.7 (SHIELD), USB1.8 (SHIELD), USB1.9 (SHIELD), USB1.10 (SHIELD), USB1.11 (SHIELD), VR1.3 (GND), VR1.6 (GND), VR2.2 (GND)
I2C_ACT: MC1.26 (PD6(T1/ADC9/!OC4D)), R3.2
INTN_ETH: ETH1.6, MC1.12 (PB7(OC0A/OC1C/RTS))
LDR0_EN: H1.P$4 (2), MC1.41 (PF0(ADC0)), R7.1
LDR0_LED: LD7.A, R7.2
LDR1_EN: H2.P$4 (2), MC1.40 (PF1(ADC1)), R8.1
LDR1_LED: LD8.A, R8.2
LDR2_EN: H3.P$4 (2), MC1.39 (PF4(ADC4/TCK)), R9.1
LDR2_ERR: LD13.A, R24.13
LDR2_LED: LD9.A, R9.2
LDR3_EN: H4.P$4 (2), MC1.38 (PF5(ADC5/TMS)), R10.1
LDR3_LED: LD10.A, R10.2
LDR4_EN: H5.P$4 (2), MC1.37 (PF6(ADC6/TDO)), R11.1
LDR4_LED: LD11.A, R11.2
LDR5_EN: H6.P$4 (2), MC1.36 (PF7(ADC7(TDI)), R12.1
LDR5_LED: LD12.A, R12.2
LDR6_ERR: LD6.A, LD14.A, LD15.A, LD16.A, LD17.A, R24.9, R24.10, R24.11, R24.12, R24.14
MISO_ETH: ETH1.12, MC1.11 (PB3(PDO/MISO))
MOSI_ETH: ETH1.3, MC1.10 (PB2(PDI/MOSI))
unnamed: D1.A, USB1.1
unnamed: LD4.A, R3.1
unnamed: LD2.A, R2.1
unnamed: Q1.3 (D), R14.1
unnamed: LD3.A, R13.1
unnamed: LD1.A, R14.2
unnamed: D2.A, F3.2
unnamed: R16.2, USB1.2
unnamed: LD5.A, R17.2
unnamed: LD18.A, R18.1
unnamed: LD19.A, R19.1
unnamed: IO1.13 (I/O1.0), R24.1
unnamed: IO1.14 (I/O1.1), R24.2
unnamed: IO1.15 (I/O1.2), R24.3
unnamed: R15.2, USB1.3
unnamed: IO1.16 (I/O1.3), R24.4
unnamed: IO1.17 (I/O1.4), R24.5
unnamed: IO1.18 (I/O1.5), R24.6
unnamed: IO1.19 (I/O1.6), R24.7
unnamed: IO1.20 (I/O1.7), R24.8
unnamed: C20.1, VR2.4 (BP)
RST_ETH: ETH1.11, MC1.27 (PD7(OC4D/ADC10/T0)), PB2.P$1 (1), R4.2
RST_MC: MC1.13 (/RESET), PB1.P$1 (1), R1.2
SCL: H1.P$6 (4), H2.P$6 (4), H3.P$6 (4), H4.P$6 (4), H5.P$6 (4), H6.P$6 (4), IO1.22 (SCL), MC1.18 (PD0(INT0/OC0B/SCL)), R6.2
SCLK_ETH: ETH1.4, MC1.9 (PB1(SCK))
SCNN_ETH: ETH1.5, MC1.8 (PB0(SS))
SDA: H1.P$7 (5), H2.P$7 (5), H3.P$7 (5), H4.P$7 (5), H5.P$7 (5), H6.P$7 (5), IO1.23 (SDA), MC1.19 (PD1(INT1/SDA)), R5.2
STATUS_PWM: LED1.4-DIN (DI), MC1.30 (PB6(OC1B/OC4B/ADC13))
UCAP: C19.1, MC1.6 (UCAP)
UVCC: F1.1, P1.2, Q1.2 (S)
VCC: U1.24 (VCC)
VCC_1: C7.1, C8.1, C9.1, C10.1, C11.1, C12.1, C13.1 (11), F2.2, F4.1, F5.1, F6.1, F7.1, F8.1, F9.1, R5.1, R6.1, R19.2
VCC_2: C5.1, C14.1, C15.1, C16.1, C17.1, C23.1, D1.C, D2.C, IO1.24 (VDD), LED1.1-VDD (VDD), MC1.2 (UVCC), MC1.7 (VBUS), MC1.14 (VCC), MC1.24 (AVCC), MC1.34 (VCC1), MC1.44 (AVCC1), R1.1, R4.1, R18.2, VR2.1 (IN), VR2.3 (EN)
VCC_LDR0: F4.2, H1.P$3 (1)
VCC_LDR1: F5.2, H2.P$3 (1)
VCC_LDR2: F6.2, H3.P$3 (1)
VCC_LDR3: F7.2, H4.P$3 (1)
VCC_LDR4: F8.2, H5.P$3 (1)
VCC_LDR5: F9.2, H6.P$3 (1)
VIN: C24.+, F1.2, Q1.1 (G), TP1.TP, VR1.1 (!SD), VR1.2 (VIN)
XTAL1: C3.1, MC1.17 (XTAL1), X1.1
XTAL2: C4.1, MC1.16 (XTAL2), X1.3 (2)

Notes on the sheet:
Power Connector
Lidar Headers
Reset PB
Clock
Microcontroller
USB Header
Wiznet Header
5-13.5VDC
3.3VDC_OK
REGULATED 5VDC OK
FUSE BLOWN
SDA STATUS
SCL STATUS
ENABLED LED
Status NeoPixel
5VDC EXTERNAL REGULATED
16 MHz
COMM ERROR
LDR1 ERROR
LDR2 ERROR
LDR3 ERROR
LDR4 ERROR
LDR5 ERROR
LDR6 ERROR
Lidar Error LEDs
MC POWER OK
LIDAR POWER OK

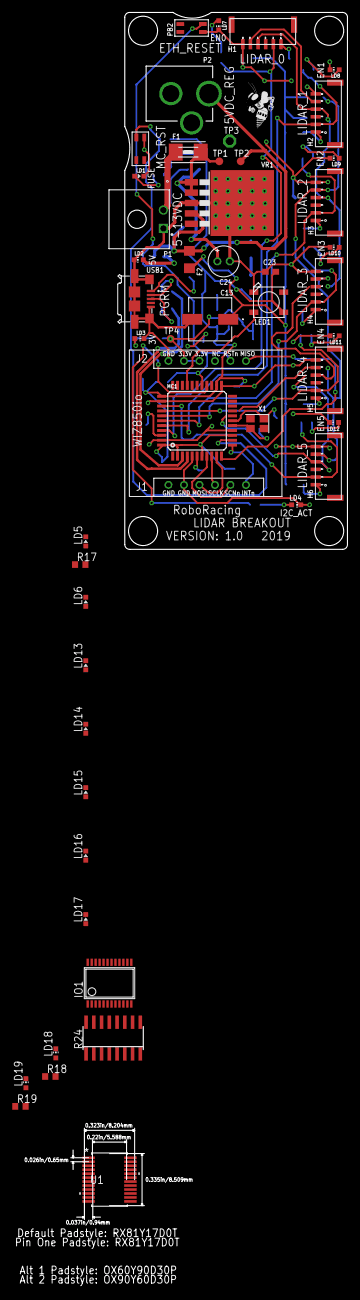
[picture p76: board LIDAR_Breakout_V2.brd from above]

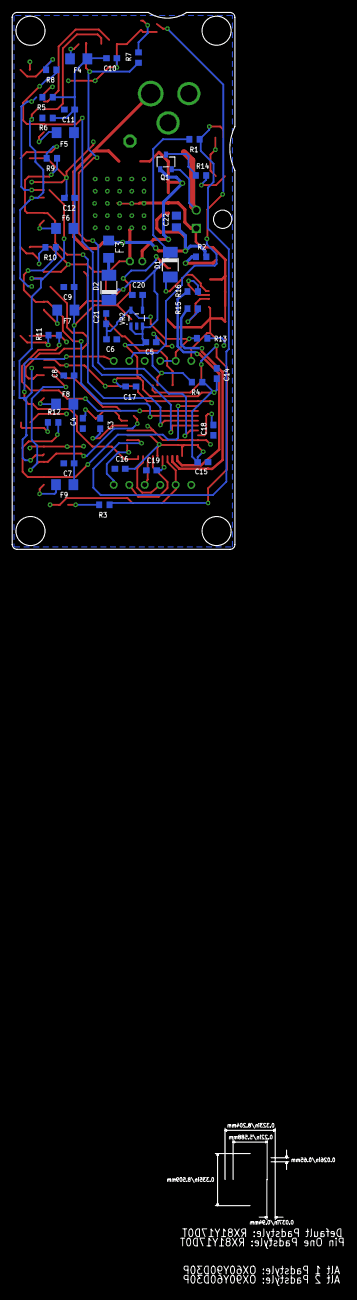
[picture p77: board LIDAR_Breakout_V2.brd from below]

Board: 2 copper layers, 36.5 x 88.0 mm, 97 parts (46 on the bottom side), 65 nets.

Other parts of the board:
U$1: ROBOBUZZ0.4X; ROBOBUZZ_0.4X
