RoboJackets/roboracing-electrical/neopixel_board/neopixel_board.brd

## EAGLE design neopixel_board/neopixel_board.brd (2019-02-21)

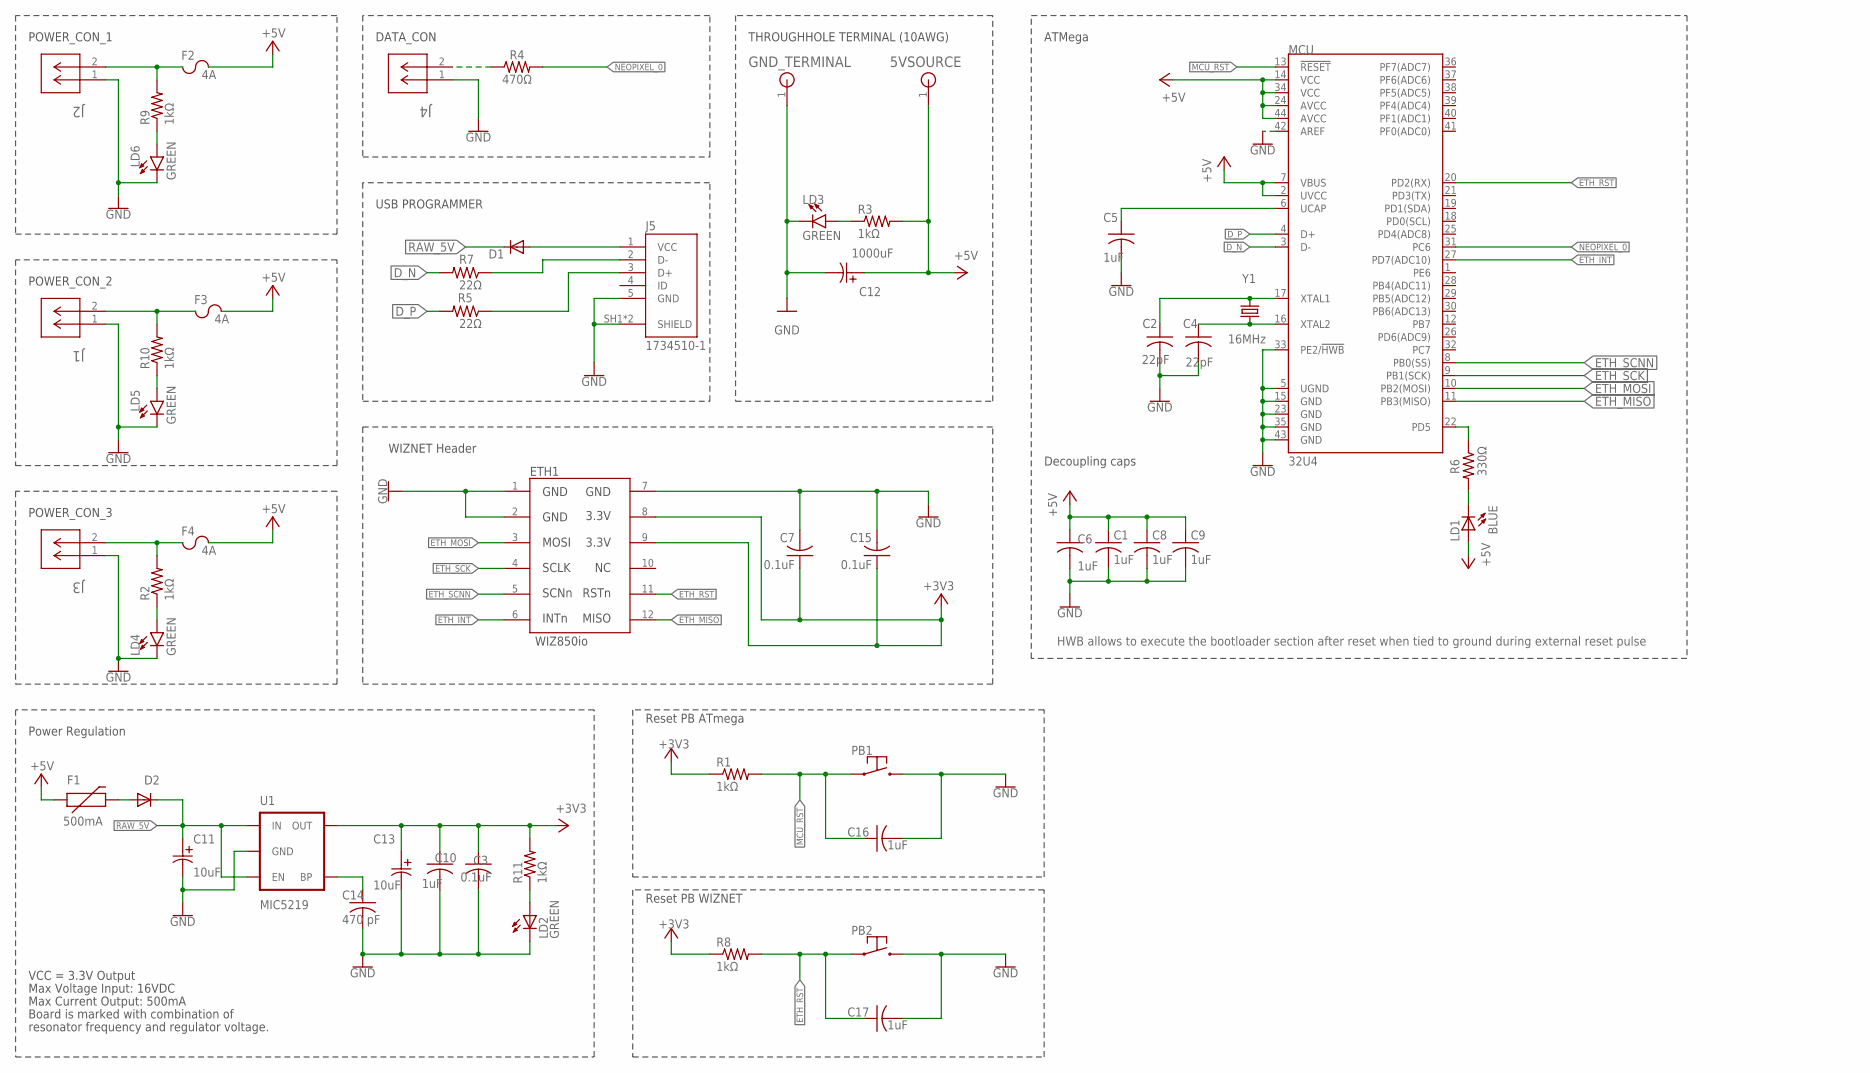
[picture p78: schematic neopixel_board.sch]

Parts:
5VSOURCE: THOLE_SOURCE
C1, C5, C6, C8, C9, C10, C16, C17: 1uF; C0603
C2, C4: 22pF; C0603
C3, C7, C15: 0.1uF; C0603
C11, C13: 10uF; CAP_4_X_5.4
C12: 1000uF; PCAP_8X112
C14: 470 pF; C0603
D1, D2: DIODESOD; SOD-323
ETH1: WIZ850IO
F1: 500mA; PTC-1206
F2, F3, F4: 4A; 3557-2
GND_TERMINAL: THOLE_SOURCE
J1, J2, J3, J4: SSW-102-02-T-S-RA; CON2_1X2_TR_SSQ
J5: 1734510-1; TE_1734510-1
LD1: BLUE; LED-0603
LD2, LD3, LD4, LD5, LD6: GREEN; LED-0603
MCU: 32U4; TQFP44
PB1, PB2: PTS645PTS645_SMD1; PTS645_SMD
R1, R8: 1kΩ; R0603
R2, R3, R9, R10, R11: 1kΩ; 0603-RES
R4: 470Ω; 0603
R5, R7: 22Ω; 0603-RES
R6: 330Ω; 0603-RES
U1: MIC5219; SOT23-5
Y1: 16MHz; CRYSTAL-SMD-5X3

Connections:
+3V3: C3.1, C7.1, C10.1, C13.1 (11), C15.1, ETH1.8, ETH1.9, R1.1, R8.1, R11.2, U1.5 (OUT)
+5V: 5VSOURCE.1, C1.1, C6.1, C8.1, C9.1, C12.1 (11), F1.1, F2.3 (2), F2.4 (2), F3.3 (2), F3.4 (2), F4.3 (2), F4.4 (2), LD1.A, MCU.2 (UVCC), MCU.7 (VBUS), MCU.14 (VCC), MCU.24 (AVCC), MCU.34 (VCC), MCU.44 (AVCC), R3.2
D_N: MCU.3 (D-), R7.2
D_P: MCU.4 (D+), R5.2
ETH_INT: ETH1.6, MCU.27 (PD7(ADC10))
ETH_MISO: ETH1.12, MCU.11 (PB3(MISO))
ETH_MOSI: ETH1.3, MCU.10 (PB2(MOSI))
ETH_RST: C17.1, ETH1.11, MCU.20 (PD2(RX)), PB2.P$1 (1), PB2.P$2 (1), R8.2
ETH_SCK: ETH1.4, MCU.9 (PB1(SCK))
ETH_SCNN: ETH1.5, MCU.8 (PB0(SS))
GND: C1.2, C2.2, C3.2, C4.2, C5.2, C6.2, C7.2, C8.2, C9.2, C10.2, C11.2 (22), C12.2 (22), C13.2 (22), C14.2, C15.2, C16.2, C17.2, ETH1.1, ETH1.2, ETH1.7, GND_TERMINAL.1, J1.1, J2.1, J3.1, J4.1, J5.5 (GND), J5.SH1 (SHIELD), J5.SH2 (SHIELD), LD2.C, LD3.C, LD4.C, LD5.C, LD6.C, MCU.5 (UGND), MCU.15 (GND), MCU.23 (GND), MCU.33 (PE2/!HWB), MCU.35 (GND), MCU.42 (AREF), MCU.43 (GND), PB1.P$3 (2), PB1.P$4 (2), PB2.P$3 (2), PB2.P$4 (2), U1.2 (GND)
MCU_RST: C16.1, MCU.13 (!RESET), PB1.P$1 (1), PB1.P$2 (1), R1.2
unnamed: C4.1, MCU.16 (XTAL2), Y1.1
unnamed: C2.1, MCU.17 (XTAL1), Y1.3 (2)
unnamed: J5.2 (D-), R7.1
unnamed: C5.1, MCU.6 (UCAP)
unnamed: C14.1, U1.4 (BP)
unnamed: J5.3 (D+), R5.1
unnamed: LD1.C, R6.2
unnamed: D1.2 (A), J5.1 (VCC)
unnamed: D2.2 (A), F1.2
unnamed: F2.1, F2.2 (1), J2.2, R9.2
unnamed: F3.1, F3.2 (1), J1.2, R10.2
unnamed: F4.1, F4.2 (1), J3.2, R2.2
unnamed: J4.2, R4.1
unnamed: LD4.A, R2.1
unnamed: LD5.A, R10.1
unnamed: LD6.A, R9.1
unnamed: LD3.A, R3.1
unnamed: LD2.A, R11.1
NEOPIXEL_0: MCU.31 (PC6), R4.2
RAW_5V: C11.1 (11), D1.1 (C), D2.1 (C), U1.1 (IN), U1.3 (EN)
TXLED: MCU.22 (PD5), R6.1

Notes on the sheet:
Max Voltage Input: 16VDC
Max Current Output: 500mA
Board is marked with combination of
resonator frequency and regulator voltage.
VCC = 3.3V Output
Reset PB ATmega
WIZNET Header
USB PROGRAMMER
Power Regulation
ATMega
THROUGHHOLE TERMINAL (10AWG)
Reset PB WIZNET
POWER_CON_1
POWER_CON_2
POWER_CON_3
DATA_CON
Decoupling caps
HWB allows to execute the bootloader section after reset when tied to ground during external reset pulse

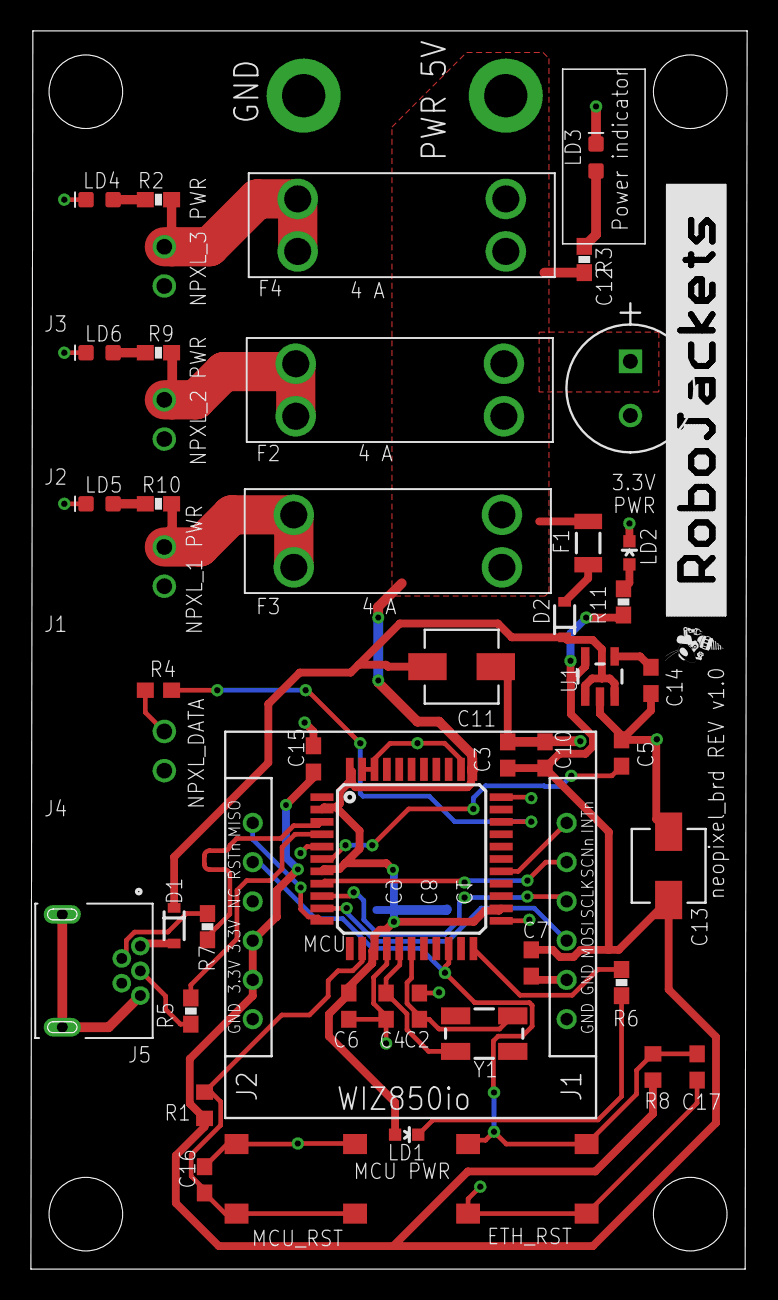
[picture p79: board neopixel_board.brd from above]

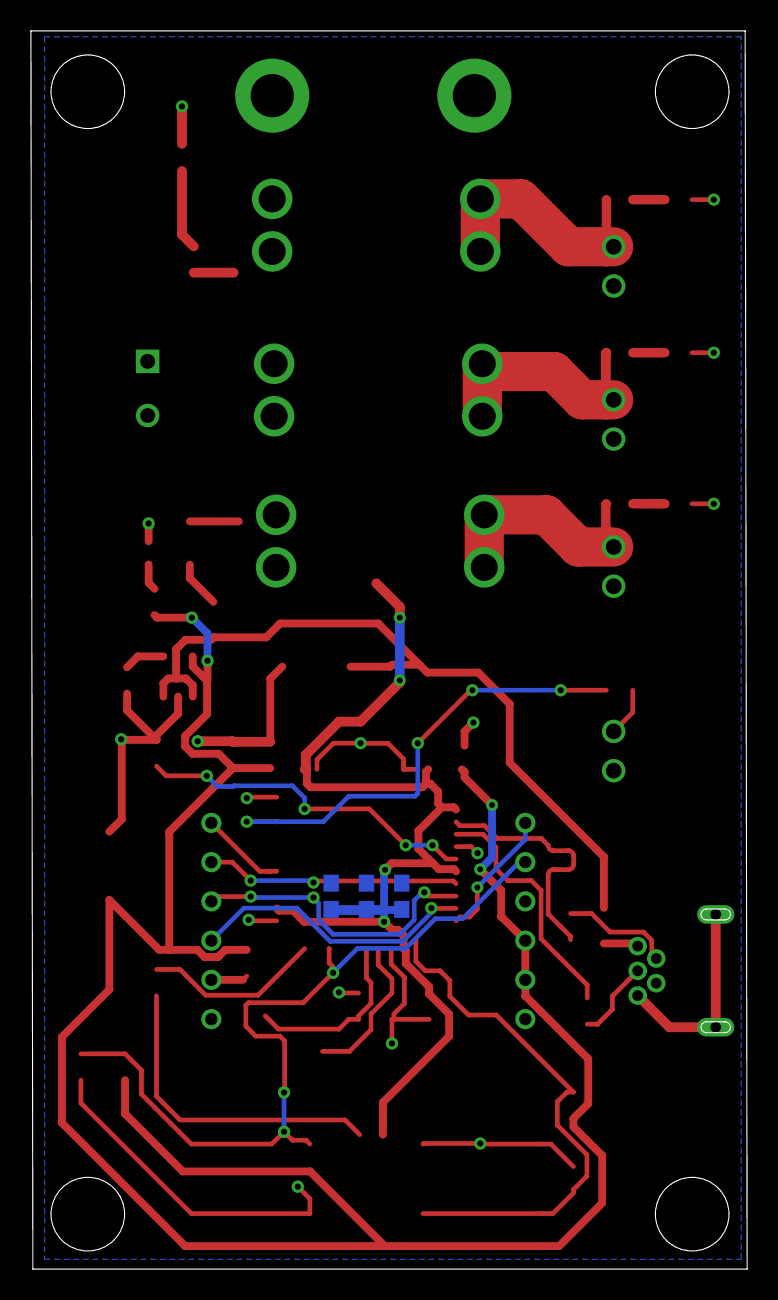
[picture p80: board neopixel_board.brd from below]

Board: 2 copper layers, 46.4 x 80.1 mm, 55 parts (3 on the bottom side), 33 nets.

Other parts of the board:
U$1: ROBOJACKETS
U$2: ROBOBUZZ_0.2X
