RoboJackets/roboracing-electrical/rigatoni/radar-adapter/Logic_Level_Bidirectional-master/Production Files/Logic_Level_Bidirectional-GiantPanel-v01.brd

## EAGLE design rigatoni/radar-adapter/Logic_Level_Bidirectional-master/Production Files/Logic_Level_Bidirectional-GiantPanel-v01.brd (2021-10-24)

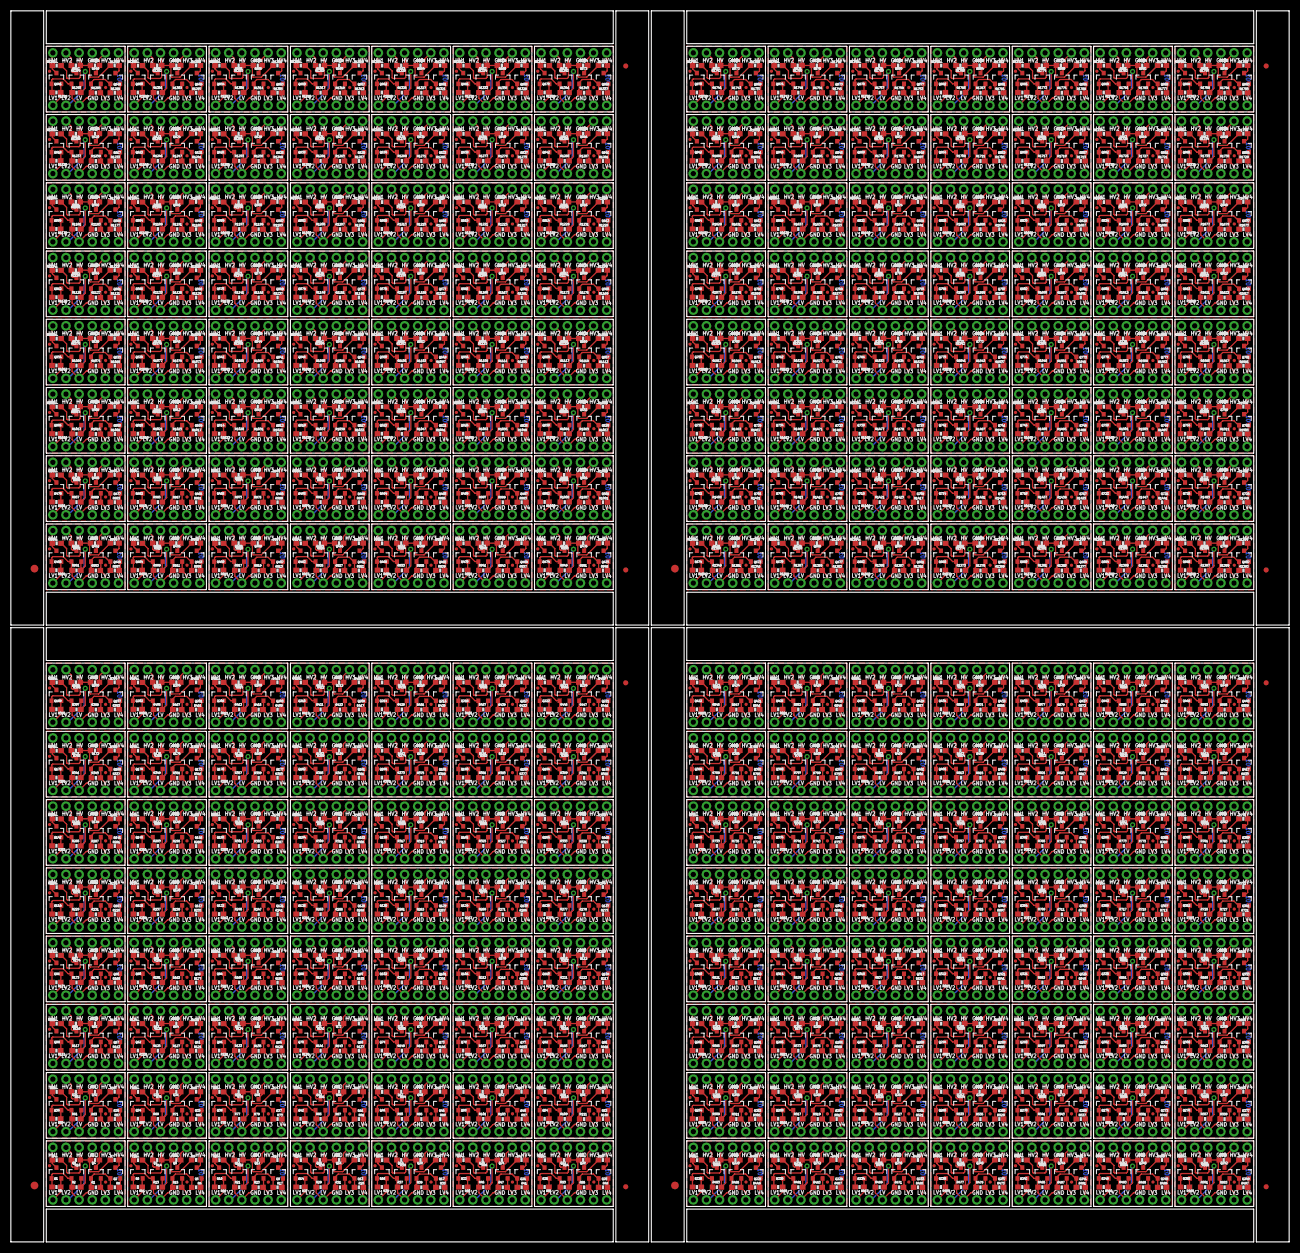
[picture p83: board Logic_Level_Bidirectional-GiantPanel-v01.brd from above]

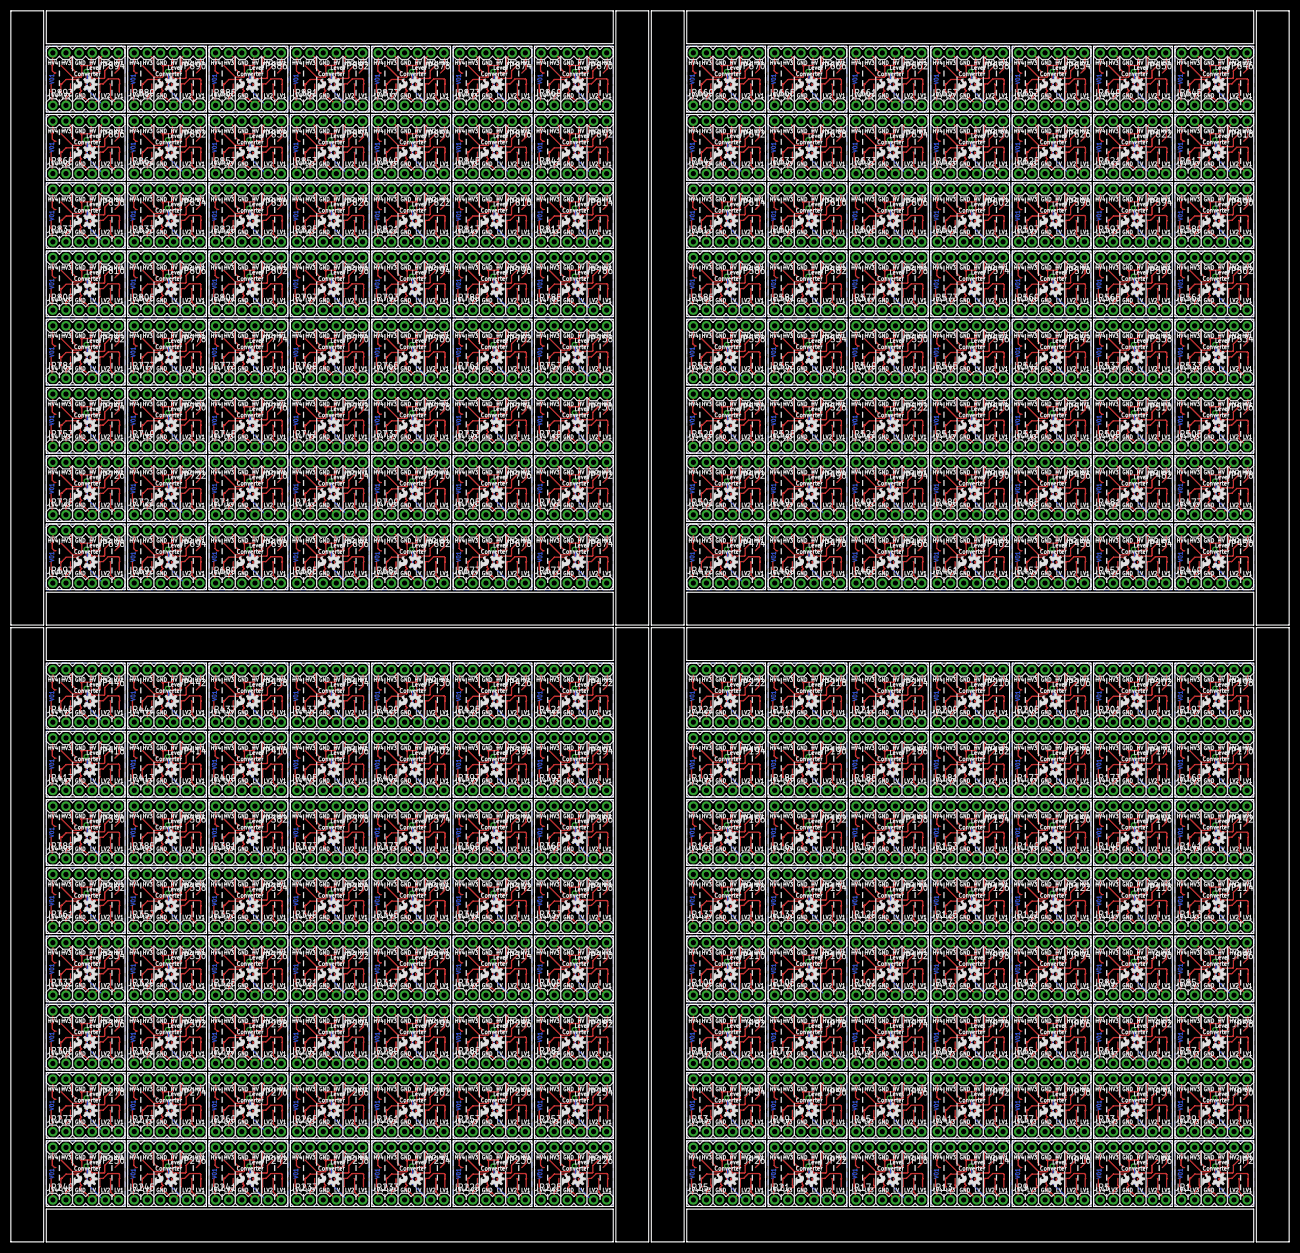
[picture p84: board Logic_Level_Bidirectional-GiantPanel-v01.brd from below]

Board: 2 copper layers, 247.4 x 238.3 mm, 4044 parts (896 on the bottom side), 2464 nets.

Parts:
E$1, E$6, E$9, E$12: FIDUCIAL-1.5X3
E$2, E$3, E$4, E$5, E$7, E$8, E$10, E$11: FIDUCIAL-1X2
JP1, JP2, JP5, JP6, JP9, JP10, JP13, JP14, JP17, JP18, JP21, JP22, JP25, JP26, JP29, JP30, JP33, JP34, JP37, JP38, JP41, JP42, JP45, JP46, JP49, JP50, JP53, JP54, JP57, JP58, JP61, JP62, JP65, JP66, JP69, JP70, JP73, JP74, JP77, JP78, JP81, JP82, JP85, JP86, JP89, JP90, JP93, JP94, JP97, JP98, JP101, JP102, JP105, JP106, JP109, JP110, JP113, JP114, JP117, JP118, JP121, JP122, JP125, JP126, JP129, JP130, JP133, JP134, JP137, JP138, JP141, JP142, JP145, JP146, JP149, JP150, JP153, JP154, JP157, JP158, JP161, JP162, JP165, JP166, JP169, JP170, JP173, JP174, JP177, JP178, JP181, JP182, JP185, JP186, JP189, JP190, JP193, JP194, JP197, JP198, JP201, JP202, JP205, JP206, JP209, JP210, JP213, JP214, JP217, JP218, JP221, JP222, JP225, JP226, JP229, JP230, JP233, JP234, JP237, JP238, JP241, JP242, JP245, JP246, JP249, JP250, JP253, JP254, JP257, JP258, JP261, JP262, JP265, JP266, JP269, JP270, JP273, JP274, JP277, JP278, JP281, JP282, JP285, JP286, JP289, JP290, JP293, JP294, JP297, JP298, JP301, JP302, JP305, JP306, JP309, JP310, JP313, JP314, JP317, JP318, JP321, JP322, JP325, JP326, JP329, JP330, JP333, JP334, JP337, JP338, JP341, JP342, JP345, JP346, JP349, JP350, JP353, JP354, JP357, JP358, JP361, JP362, JP365, JP366, JP369, JP370, JP373, JP374, JP377, JP378, JP381, JP382, JP385, JP386, JP389, JP390, JP393, JP394, JP397, JP398, JP401, JP402, JP405, JP406, JP409, JP410, JP413, JP414, JP417, JP418, JP421, JP422, JP425, JP426, JP429, JP430, JP433, JP434, JP437, JP438, JP441, JP442, JP445, JP446, JP449, JP450, JP453, JP454, JP457, JP458, JP461, JP462, JP465, JP466, JP469, JP470, JP473, JP474, JP477, JP478, JP481, JP482, JP485, JP486, JP489, JP490, JP493, JP494, JP497, JP498, JP501, JP502, JP505, JP506, JP509, JP510, JP513, JP514, JP517, JP518, JP521, JP522, JP525, JP526, JP529, JP530, JP533, JP534, JP537, JP538, JP541, JP542, JP545, JP546, JP549, JP550, JP553, JP554, JP557, JP558, JP561, JP562, JP565, JP566, JP569, JP570, JP573, JP574, JP577, JP578, JP581, JP582, JP585, JP586, JP589, JP590, JP593, JP594, JP597, JP598, JP601, JP602, JP605, JP606, JP609, JP610, JP613, JP614, JP617, JP618, JP621, JP622, JP625, JP626, JP629, JP630, JP633, JP634, JP637, JP638, JP641, JP642, JP645, JP646, JP649, JP650, JP653, JP654, JP657, JP658, JP661, JP662, JP665, JP666, JP669, JP670, JP673, JP674, JP677, JP678, JP681, JP682, JP685, JP686, JP689, JP690, JP693, JP694, JP697, JP698, JP701, JP702, JP705, JP706, JP709, JP710, JP713, JP714, JP717, JP718, JP721, JP722, JP725, JP726, JP729, JP730, JP733, JP734, JP737, JP738, JP741, JP742, JP745, JP746, JP749, JP750, JP753, JP754, JP757, JP758, JP761, JP762, JP765, JP766, JP769, JP770, JP773, JP774, JP777, JP778, JP781, JP782, JP785, JP786, JP789, JP790, JP793, JP794, JP797, JP798, JP801, JP802, JP805, JP806, JP809, JP810, JP813, JP814, JP817, JP818, JP821, JP822, JP825, JP826, JP829, JP830, JP833, JP834, JP837, JP838, JP841, JP842, JP845, JP846, JP849, JP850, JP853, JP854, JP857, JP858, JP861, JP862, JP865, JP866, JP869, JP870, JP873, JP874, JP877, JP878, JP881, JP882, JP885, JP886, JP889, JP890, JP893, JP894: 1X06
JP3, JP4, JP7, JP8, JP11, JP12, JP15, JP16, JP19, JP20, JP23, JP24, JP27, JP28, JP31, JP32, JP35, JP36, JP39, JP40, JP43, JP44, JP47, JP48, JP51, JP52, JP55, JP56, JP59, JP60, JP63, JP64, JP67, JP68, JP71, JP72, JP75, JP76, JP79, JP80, JP83, JP84, JP87, JP88, JP91, JP92, JP95, JP96, JP99, JP100, JP103, JP104, JP107, JP108, JP111, JP112, JP115, JP116, JP119, JP120, JP123, JP124, JP127, JP128, JP131, JP132, JP135, JP136, JP139, JP140, JP143, JP144, JP147, JP148, JP151, JP152, JP155, JP156, JP159, JP160, JP163, JP164, JP167, JP168, JP171, JP172, JP175, JP176, JP179, JP180, JP183, JP184, JP187, JP188, JP191, JP192, JP195, JP196, JP199, JP200, JP203, JP204, JP207, JP208, JP211, JP212, JP215, JP216, JP219, JP220, JP223, JP224, JP227, JP228, JP231, JP232, JP235, JP236, JP239, JP240, JP243, JP244, JP247, JP248, JP251, JP252, JP255, JP256, JP259, JP260, JP263, JP264, JP267, JP268, JP271, JP272, JP275, JP276, JP279, JP280, JP283, JP284, JP287, JP288, JP291, JP292, JP295, JP296, JP299, JP300, JP303, JP304, JP307, JP308, JP311, JP312, JP315, JP316, JP319, JP320, JP323, JP324, JP327, JP328, JP331, JP332, JP335, JP336, JP339, JP340, JP343, JP344, JP347, JP348, JP351, JP352, JP355, JP356, JP359, JP360, JP363, JP364, JP367, JP368, JP371, JP372, JP375, JP376, JP379, JP380, JP383, JP384, JP387, JP388, JP391, JP392, JP395, JP396, JP399, JP400, JP403, JP404, JP407, JP408, JP411, JP412, JP415, JP416, JP419, JP420, JP423, JP424, JP427, JP428, JP431, JP432, JP435, JP436, JP439, JP440, JP443, JP444, JP447, JP448, JP451, JP452, JP455, JP456, JP459, JP460, JP463, JP464, JP467, JP468, JP471, JP472, JP475, JP476, JP479, JP480, JP483, JP484, JP487, JP488, JP491, JP492, JP495, JP496, JP499, JP500, JP503, JP504, JP507, JP508, JP511, JP512, JP515, JP516, JP519, JP520, JP523, JP524, JP527, JP528, JP531, JP532, JP535, JP536, JP539, JP540, JP543, JP544, JP547, JP548, JP551, JP552, JP555, JP556, JP559, JP560, JP563, JP564, JP567, JP568, JP571, JP572, JP575, JP576, JP579, JP580, JP583, JP584, JP587, JP588, JP591, JP592, JP595, JP596, JP599, JP600, JP603, JP604, JP607, JP608, JP611, JP612, JP615, JP616, JP619, JP620, JP623, JP624, JP627, JP628, JP631, JP632, JP635, JP636, JP639, JP640, JP643, JP644, JP647, JP648, JP651, JP652, JP655, JP656, JP659, JP660, JP663, JP664, JP667, JP668, JP671, JP672, JP675, JP676, JP679, JP680, JP683, JP684, JP687, JP688, JP691, JP692, JP695, JP696, JP699, JP700, JP703, JP704, JP707, JP708, JP711, JP712, JP715, JP716, JP719, JP720, JP723, JP724, JP727, JP728, JP731, JP732, JP735, JP736, JP739, JP740, JP743, JP744, JP747, JP748, JP751, JP752, JP755, JP756, JP759, JP760, JP763, JP764, JP767, JP768, JP771, JP772, JP775, JP776, JP779, JP780, JP783, JP784, JP787, JP788, JP791, JP792, JP795, JP796, JP799, JP800, JP803, JP804, JP807, JP808, JP811, JP812, JP815, JP816, JP819, JP820, JP823, JP824, JP827, JP828, JP831, JP832, JP835, JP836, JP839, JP840, JP843, JP844, JP847, JP848, JP851, JP852, JP855, JP856, JP859, JP860, JP863, JP864, JP867, JP868, JP871, JP872, JP875, JP876, JP879, JP880, JP883, JP884, JP887, JP888, JP891, JP892, JP895, JP896: FIDUCIALUFIDUCIAL; MICRO-FIDUCIAL
LOGO1, LOGO3, LOGO5, LOGO7, LOGO9, LOGO11, LOGO13, LOGO15, LOGO17, LOGO19, LOGO21, LOGO23, LOGO25, LOGO27, LOGO29, LOGO31, LOGO33, LOGO35, LOGO37, LOGO39, LOGO41, LOGO43, LOGO45, LOGO47, LOGO49, LOGO51, LOGO53, LOGO55, LOGO57, LOGO59, LOGO61, LOGO63, LOGO65, LOGO67, LOGO69, LOGO71, LOGO73, LOGO75, LOGO77, LOGO79, LOGO81, LOGO83, LOGO85, LOGO87, LOGO89, LOGO91, LOGO93, LOGO95, LOGO97, LOGO99, LOGO101, LOGO103, LOGO105, LOGO107, LOGO109, LOGO111, LOGO113, LOGO115, LOGO117, LOGO119, LOGO121, LOGO123, LOGO125, LOGO127, LOGO129, LOGO131, LOGO133, LOGO135, LOGO137, LOGO139, LOGO141, LOGO143, LOGO145, LOGO147, LOGO149, LOGO151, LOGO153, LOGO155, LOGO157, LOGO159, LOGO161, LOGO163, LOGO165, LOGO167, LOGO169, LOGO171, LOGO173, LOGO175, LOGO177, LOGO179, LOGO181, LOGO183, LOGO185, LOGO187, LOGO189, LOGO191, LOGO193, LOGO195, LOGO197, LOGO199, LOGO201, LOGO203, LOGO205, LOGO207, LOGO209, LOGO211, LOGO213, LOGO215, LOGO217, LOGO219, LOGO221, LOGO223, LOGO225, LOGO227, LOGO229, LOGO231, LOGO233, LOGO235, LOGO237, LOGO239, LOGO241, LOGO243, LOGO245, LOGO247, LOGO249, LOGO251, LOGO253, LOGO255, LOGO257, LOGO259, LOGO261, LOGO263, LOGO265, LOGO267, LOGO269, LOGO271, LOGO273, LOGO275, LOGO277, LOGO279, LOGO281, LOGO283, LOGO285, LOGO287, LOGO289, LOGO291, LOGO293, LOGO295, LOGO297, LOGO299, LOGO301, LOGO303, LOGO305, LOGO307, LOGO309, LOGO311, LOGO313, LOGO315, LOGO317, LOGO319, LOGO321, LOGO323, LOGO325, LOGO327, LOGO329, LOGO331, LOGO333, LOGO335, LOGO337, LOGO339, LOGO341, LOGO343, LOGO345, LOGO347, LOGO349, LOGO351, LOGO353, LOGO355, LOGO357, LOGO359, LOGO361, LOGO363, LOGO365, LOGO367, LOGO369, LOGO371, LOGO373, LOGO375, LOGO377, LOGO379, LOGO381, LOGO383, LOGO385, LOGO387, LOGO389, LOGO391, LOGO393, LOGO395, LOGO397, LOGO399, LOGO401, LOGO403, LOGO405, LOGO407, LOGO409, LOGO411, LOGO413, LOGO415, LOGO417, LOGO419, LOGO421, LOGO423, LOGO425, LOGO427, LOGO429, LOGO431, LOGO433, LOGO435, LOGO437, LOGO439, LOGO441, LOGO443, LOGO445, LOGO447: SFE_LOGO_FLAME.1_INCH; SFE_LOGO_FLAME_.1
LOGO2, LOGO4, LOGO6, LOGO8, LOGO10, LOGO12, LOGO14, LOGO16, LOGO18, LOGO20, LOGO22, LOGO24, LOGO26, LOGO28, LOGO30, LOGO32, LOGO34, LOGO36, LOGO38, LOGO40, LOGO42, LOGO44, LOGO46, LOGO48, LOGO50, LOGO52, LOGO54, LOGO56, LOGO58, LOGO60, LOGO62, LOGO64, LOGO66, LOGO68, LOGO70, LOGO72, LOGO74, LOGO76, LOGO78, LOGO80, LOGO82, LOGO84, LOGO86, LOGO88, LOGO90, LOGO92, LOGO94, LOGO96, LOGO98, LOGO100, LOGO102, LOGO104, LOGO106, LOGO108, LOGO110, LOGO112, LOGO114, LOGO116, LOGO118, LOGO120, LOGO122, LOGO124, LOGO126, LOGO128, LOGO130, LOGO132, LOGO134, LOGO136, LOGO138, LOGO140, LOGO142, LOGO144, LOGO146, LOGO148, LOGO150, LOGO152, LOGO154, LOGO156, LOGO158, LOGO160, LOGO162, LOGO164, LOGO166, LOGO168, LOGO170, LOGO172, LOGO174, LOGO176, LOGO178, LOGO180, LOGO182, LOGO184, LOGO186, LOGO188, LOGO190, LOGO192, LOGO194, LOGO196, LOGO198, LOGO200, LOGO202, LOGO204, LOGO206, LOGO208, LOGO210, LOGO212, LOGO214, LOGO216, LOGO218, LOGO220, LOGO222, LOGO224, LOGO226, LOGO228, LOGO230, LOGO232, LOGO234, LOGO236, LOGO238, LOGO240, LOGO242, LOGO244, LOGO246, LOGO248, LOGO250, LOGO252, LOGO254, LOGO256, LOGO258, LOGO260, LOGO262, LOGO264, LOGO266, LOGO268, LOGO270, LOGO272, LOGO274, LOGO276, LOGO278, LOGO280, LOGO282, LOGO284, LOGO286, LOGO288, LOGO290, LOGO292, LOGO294, LOGO296, LOGO298, LOGO300, LOGO302, LOGO304, LOGO306, LOGO308, LOGO310, LOGO312, LOGO314, LOGO316, LOGO318, LOGO320, LOGO322, LOGO324, LOGO326, LOGO328, LOGO330, LOGO332, LOGO334, LOGO336, LOGO338, LOGO340, LOGO342, LOGO344, LOGO346, LOGO348, LOGO350, LOGO352, LOGO354, LOGO356, LOGO358, LOGO360, LOGO362, LOGO364, LOGO366, LOGO368, LOGO370, LOGO372, LOGO374, LOGO376, LOGO378, LOGO380, LOGO382, LOGO384, LOGO386, LOGO388, LOGO390, LOGO392, LOGO394, LOGO396, LOGO398, LOGO400, LOGO402, LOGO404, LOGO406, LOGO408, LOGO410, LOGO412, LOGO414, LOGO416, LOGO418, LOGO420, LOGO422, LOGO424, LOGO426, LOGO428, LOGO430, LOGO432, LOGO434, LOGO436, LOGO438, LOGO440, LOGO442, LOGO444, LOGO446, LOGO448: OSHW-LOGOS; OSHW-LOGO-S
Q1, Q2, Q3, Q4, Q5, Q6, Q7, Q8, Q9, Q10, Q11, Q12, Q13, Q14, Q15, Q16, Q17, Q18, Q19, Q20, Q21, Q22, Q23, Q24, Q25, Q26, Q27, Q28, Q29, Q30, Q31, Q32, Q33, Q34, Q35, Q36, Q37, Q38, Q39, Q40, Q41, Q42, Q43, Q44, Q45, Q46, Q47, Q48, Q49, Q50, Q51, Q52, Q53, Q54, Q55, Q56, Q57, Q58, Q59, Q60, Q61, Q62, Q63, Q64, Q65, Q66, Q67, Q68, Q69, Q70, Q71, Q72, Q73, Q74, Q75, Q76, Q77, Q78, Q79, Q80, Q81, Q82, Q83, Q84, Q85, Q86, Q87, Q88, Q89, Q90, Q91, Q92, Q93, Q94, Q95, Q96, Q97, Q98, Q99, Q100, Q101, Q102, Q103, Q104, Q105, Q106, Q107, Q108, Q109, Q110, Q111, Q112, Q113, Q114, Q115, Q116, Q117, Q118, Q119, Q120, Q121, Q122, Q123, Q124, Q125, Q126, Q127, Q128, Q129, Q130, Q131, Q132, Q133, Q134, Q135, Q136, Q137, Q138, Q139, Q140, Q141, Q142, Q143, Q144, Q145, Q146, Q147, Q148, Q149, Q150, Q151, Q152, Q153, Q154, Q155, Q156, Q157, Q158, Q159, Q160, Q161, Q162, Q163, Q164, Q165, Q166, Q167, Q168, Q169, Q170, Q171, Q172, Q173, Q174, Q175, Q176, Q177, Q178, Q179, Q180, Q181, Q182, Q183, Q184, Q185, Q186, Q187, Q188, Q189, Q190, Q191, Q192, Q193, Q194, Q195, Q196, Q197, Q198, Q199, Q200, Q201, Q202, Q203, Q204, Q205, Q206, Q207, Q208, Q209, Q210, Q211, Q212, Q213, Q214, Q215, Q216, Q217, Q218, Q219, Q220, Q221, Q222, Q223, Q224, Q225, Q226, Q227, Q228, Q229, Q230, Q231, Q232, Q233, Q234, Q235, Q236, Q237, Q238, Q239, Q240, Q241, Q242, Q243, Q244, Q245, Q246, Q247, Q248, Q249, Q250, Q251, Q252, Q253, Q254, Q255, Q256, Q257, Q258, Q259, Q260, Q261, Q262, Q263, Q264, Q265, Q266, Q267, Q268, Q269, Q270, Q271, Q272, Q273, Q274, Q275, Q276, Q277, Q278, Q279, Q280, Q281, Q282, Q283, Q284, Q285, Q286, Q287, Q288, Q289, Q290, Q291, Q292, Q293, Q294, Q295, Q296, Q297, Q298, Q299, Q300, Q301, Q302, Q303, Q304, Q305, Q306, Q307, Q308, Q309, Q310, Q311, Q312, Q313, Q314, Q315, Q316, Q317, Q318, Q319, Q320, Q321, Q322, Q323, Q324, Q325, Q326, Q327, Q328, Q329, Q330, Q331, Q332, Q333, Q334, Q335, Q336, Q337, Q338, Q339, Q340, Q341, Q342, Q343, Q344, Q345, Q346, Q347, Q348, Q349, Q350, Q351, Q352, Q353, Q354, Q355, Q356, Q357, Q358, Q359, Q360, Q361, Q362, Q363, Q364, Q365, Q366, Q367, Q368, Q369, Q370, Q371, Q372, Q373, Q374, Q375, Q376, Q377, Q378, Q379, Q380, Q381, Q382, Q383, Q384, Q385, Q386, Q387, Q388, Q389, Q390, Q391, Q392, Q393, Q394, Q395, Q396, Q397, Q398, Q399, Q400, Q401, Q402, Q403, Q404, Q405, Q406, Q407, Q408, Q409, Q410, Q411, Q412, Q413, Q414, Q415, Q416, Q417, Q418, Q419, Q420, Q421, Q422, Q423, Q424, Q425, Q426, Q427, Q428, Q429, Q430, Q431, Q432, Q433, Q434, Q435, Q436, Q437, Q438, Q439, Q440, Q441, Q442, Q443, Q444, Q445, Q446, Q447, Q448, Q449, Q450, Q451, Q452, Q453, Q454, Q455, Q456, Q457, Q458, Q459, Q460, Q461, Q462, Q463, Q464, Q465, Q466, Q467, Q468, Q469, Q470, Q471, Q472, Q473, Q474, Q475, Q476, Q477, Q478, Q479, Q480, Q481, Q482, Q483, Q484, Q485, Q486, Q487, Q488, Q489, Q490, Q491, Q492, Q493, Q494, Q495, Q496, Q497, Q498, Q499, Q500, Q501, Q502, Q503, Q504, Q505, Q506, Q507, Q508, Q509, Q510, Q511, Q512, Q513, Q514, Q515, Q516, Q517, Q518, Q519, Q520, Q521, Q522, Q523, Q524, Q525, Q526, Q527, Q528, Q529, Q530, Q531, Q532, Q533, Q534, Q535, Q536, Q537, Q538, Q539, Q540, Q541, Q542, Q543, Q544, Q545, Q546, Q547, Q548, Q549, Q550, Q551, Q552, Q553, Q554, Q555, Q556, Q557, Q558, Q559, Q560, Q561, Q562, Q563, Q564, Q565, Q566, Q567, Q568, Q569, Q570, Q571, Q572, Q573, Q574, Q575, Q576, Q577, Q578, Q579, Q580, Q581, Q582, Q583, Q584, Q585, Q586, Q587, Q588, Q589, Q590, Q591, Q592, Q593, Q594, Q595, Q596, Q597, Q598, Q599, Q600, Q601, Q602, Q603, Q604, Q605, Q606, Q607, Q608, Q609, Q610, Q611, Q612, Q613, Q614, Q615, Q616, Q617, Q618, Q619, Q620, Q621, Q622, Q623, Q624, Q625, Q626, Q627, Q628, Q629, Q630, Q631, Q632, Q633, Q634, Q635, Q636, Q637, Q638, Q639, Q640, Q641, Q642, Q643, Q644, Q645, Q646, Q647, Q648, Q649, Q650, Q651, Q652, Q653, Q654, Q655, Q656, Q657, Q658, Q659, Q660, Q661, Q662, Q663, Q664, Q665, Q666, Q667, Q668, Q669, Q670, Q671, Q672, Q673, Q674, Q675, Q676, Q677, Q678, Q679, Q680, Q681, Q682, Q683, Q684, Q685, Q686, Q687, Q688, Q689, Q690, Q691, Q692, Q693, Q694, Q695, Q696, Q697, Q698, Q699, Q700, Q701, Q702, Q703, Q704, Q705, Q706, Q707, Q708, Q709, Q710, Q711, Q712, Q713, Q714, Q715, Q716, Q717, Q718, Q719, Q720, Q721, Q722, Q723, Q724, Q725, Q726, Q727, Q728, Q729, Q730, Q731, Q732, Q733, Q734, Q735, Q736, Q737, Q738, Q739, Q740, Q741, Q742, Q743, Q744, Q745, Q746, Q747, Q748, Q749, Q750, Q751, Q752, Q753, Q754, Q755, Q756, Q757, Q758, Q759, Q760, Q761, Q762, Q763, Q764, Q765, Q766, Q767, Q768, Q769, Q770, Q771, Q772, Q773, Q774, Q775, Q776, Q777, Q778, Q779, Q780, Q781, Q782, Q783, Q784, Q785, Q786, Q787, Q788, Q789, Q790, Q791, Q792, Q793, Q794, Q795, Q796, Q797, Q798, Q799, Q800, Q801, Q802, Q803, Q804, Q805, Q806, Q807, Q808, Q809, Q810, Q811, Q812, Q813, Q814, Q815, Q816, Q817, Q818, Q819, Q820, Q821, Q822, Q823, Q824, Q825, Q826, Q827, Q828, Q829, Q830, Q831, Q832, Q833, Q834, Q835, Q836, Q837, Q838, Q839, Q840, Q841, Q842, Q843, Q844, Q845, Q846, Q847, Q848, Q849, Q850, Q851, Q852, Q853, Q854, Q855, Q856, Q857, Q858, Q859, Q860, Q861, Q862, Q863, Q864, Q865, Q866, Q867, Q868, Q869, Q870, Q871, Q872, Q873, Q874, Q875, Q876, Q877, Q878, Q879, Q880, Q881, Q882, Q883, Q884, Q885, Q886, Q887, Q888, Q889, Q890, Q891, Q892, Q893, Q894, Q895, Q896: BSS138; SOT23-3
R1, R2, R3, R4, R5, R6, R7, R8, R9, R10, R11, R12, R13, R14, R15, R16, R17, R18, R19, R20, R21, R22, R23, R24, R25, R26, R27, R28, R29, R30, R31, R32, R33, R34, R35, R36, R37, R38, R39, R40, R41, R42, R43, R44, R45, R46, R47, R48, R49, R50, R51, R52, R53, R54, R55, R56, R57, R58, R59, R60, R61, R62, R63, R64, R65, R66, R67, R68, R69, R70, R71, R72, R73, R74, R75, R76, R77, R78, R79, R80, R81, R82, R83, R84, R85, R86, R87, R88, R89, R90, R91, R92, R93, R94, R95, R96, R97, R98, R99, R100, R101, R102, R103, R104, R105, R106, R107, R108, R109, R110, R111, R112, R113, R114, R115, R116, R117, R118, R119, R120, R121, R122, R123, R124, R125, R126, R127, R128, R129, R130, R131, R132, R133, R134, R135, R136, R137, R138, R139, R140, R141, R142, R143, R144, R145, R146, R147, R148, R149, R150, R151, R152, R153, R154, R155, R156, R157, R158, R159, R160, R161, R162, R163, R164, R165, R166, R167, R168, R169, R170, R171, R172, R173, R174, R175, R176, R177, R178, R179, R180, R181, R182, R183, R184, R185, R186, R187, R188, R189, R190, R191, R192, R193, R194, R195, R196, R197, R198, R199, R200, R201, R202, R203, R204, R205, R206, R207, R208, R209, R210, R211, R212, R213, R214, R215, R216, R217, R218, R219, R220, R221, R222, R223, R224, R225, R226, R227, R228, R229, R230, R231, R232, R233, R234, R235, R236, R237, R238, R239, R240, R241, R242, R243, R244, R245, R246, R247, R248, R249, R250, R251, R252, R253, R254, R255, R256, R257, R258, R259, R260, R261, R262, R263, R264, R265, R266, R267, R268, R269, R270, R271, R272, R273, R274, R275, R276, R277, R278, R279, R280, R281, R282, R283, R284, R285, R286, R287, R288, R289, R290, R291, R292, R293, R294, R295, R296, R297, R298, R299, R300, R301, R302, R303, R304, R305, R306, R307, R308, R309, R310, R311, R312, R313, R314, R315, R316, R317, R318, R319, R320, R321, R322, R323, R324, R325, R326, R327, R328, R329, R330, R331, R332, R333, R334, R335, R336, R337, R338, R339, R340, R341, R342, R343, R344, R345, R346, R347, R348, R349, R350, R351, R352, R353, R354, R355, R356, R357, R358, R359, R360, R361, R362, R363, R364, R365, R366, R367, R368, R369, R370, R371, R372, R373, R374, R375, R376, R377, R378, R379, R380, R381, R382, R383, R384, R385, R386, R387, R388, R389, R390, R391, R392, R393, R394, R395, R396, R397, R398, R399, R400, R401, R402, R403, R404, R405, R406, R407, R408, R409, R410, R411, R412, R413, R414, R415, R416, R417, R418, R419, R420, R421, R422, R423, R424, R425, R426, R427, R428, R429, R430, R431, R432, R433, R434, R435, R436, R437, R438, R439, R440, R441, R442, R443, R444, R445, R446, R447, R448, R449, R450, R451, R452, R453, R454, R455, R456, R457, R458, R459, R460, R461, R462, R463, R464, R465, R466, R467, R468, R469, R470, R471, R472, R473, R474, R475, R476, R477, R478, R479, R480, R481, R482, R483, R484, R485, R486, R487, R488, R489, R490, R491, R492, R493, R494, R495, R496, R497, R498, R499, R500, R501, R502, R503, R504, R505, R506, R507, R508, R509, R510, R511, R512, R513, R514, R515, R516, R517, R518, R519, R520, R521, R522, R523, R524, R525, R526, R527, R528, R529, R530, R531, R532, R533, R534, R535, R536, R537, R538, R539, R540, R541, R542, R543, R544, R545, R546, R547, R548, R549, R550, R551, R552, R553, R554, R555, R556, R557, R558, R559, R560, R561, R562, R563, R564, R565, R566, R567, R568, R569, R570, R571, R572, R573, R574, R575, R576, R577, R578, R579, R580, R581, R582, R583, R584, R585, R586, R587, R588, R589, R590, R591, R592, R593, R594, R595, R596, R597, R598, R599, R600, R601, R602, R603, R604, R605, R606, R607, R608, R609, R610, R611, R612, R613, R614, R615, R616, R617, R618, R619, R620, R621, R622, R623, R624, R625, R626, R627, R628, R629, R630, R631, R632, R633, R634, R635, R636, R637, R638, R639, R640, R641, R642, R643, R644, R645, R646, R647, R648, R649, R650, R651, R652, R653, R654, R655, R656, R657, R658, R659, R660, R661, R662, R663, R664, R665, R666, R667, R668, R669, R670, R671, R672, R673, R674, R675, R676, R677, R678, R679, R680, R681, R682, R683, R684, R685, R686, R687, R688, R689, R690, R691, R692, R693, R694, R695, R696, R697, R698, R699, R700, R701, R702, R703, R704, R705, R706, R707, R708, R709, R710, R711, R712, R713, R714, R715, R716, R717, R718, R719, R720, R721, R722, R723, R724, R725, R726, R727, R728, R729, R730, R731, R732, R733, R734, R735, R736, R737, R738, R739, R740, R741, R742, R743, R744, R745, R746, R747, R748, R749, R750, R751, R752, R753, R754, R755, R756, R757, R758, R759, R760, R761, R762, R763, R764, R765, R766, R767, R768, R769, R770, R771, R772, R773, R774, R775, R776, R777, R778, R779, R780, R781, R782, R783, R784, R785, R786, R787, R788, R789, R790, R791, R792, R793, R794, R795, R796, R797, R798, R799, R800, R801, R802, R803, R804, R805, R806, R807, R808, R809, R810, R811, R812, R813, R814, R815, R816, R817, R818, R819, R820, R821, R822, R823, R824, R825, R826, R827, R828, R829, R830, R831, R832, R833, R834, R835, R836, R837, R838, R839, R840, R841, R842, R843, R844, R845, R846, R847, R848, R849, R850, R851, R852, R853, R854, R855, R856, R857, R858, R859, R860, R861, R862, R863, R864, R865, R866, R867, R868, R869, R870, R871, R872, R873, R874, R875, R876, R877, R878, R879, R880, R881, R882, R883, R884, R885, R886, R887, R888, R889, R890, R891, R892, R893, R894, R895, R896, R897, R898, R899, R900, R901, R902, R903, R904, R905, R906, R907, R908, R909, R910, R911, R912, R913, R914, R915, R916, R917, R918, R919, R920, R921, R922, R923, R924, R925, R926, R927, R928, R929, R930, R931, R932, R933, R934, R935, R936, R937, R938, R939, R940, R941, R942, R943, R944, R945, R946, R947, R948, R949, R950, R951, R952, R953, R954, R955, R956, R957, R958, R959, R960, R961, R962, R963, R964, R965, R966, R967, R968, R969, R970, R971, R972, R973, R974, R975, R976, R977, R978, R979, R980, R981, R982, R983, R984, R985, R986, R987, R988, R989, R990, R991, R992, R993, R994, R995, R996, R997, R998, R999, R1000, R1001, R1002, R1003, R1004, R1005, R1006, R1007, R1008, R1009, R1010, R1011, R1012, R1013, R1014, R1015, R1016, R1017, R1018, R1019, R1020, R1021, R1022, R1023, R1024, R1025, R1026, R1027, R1028, R1029, R1030, R1031, R1032, R1033, R1034, R1035, R1036, R1037, R1038, R1039, R1040, R1041, R1042, R1043, R1044, R1045, R1046, R1047, R1048, R1049, R1050, R1051, R1052, R1053, R1054, R1055, R1056, R1057, R1058, R1059, R1060, R1061, R1062, R1063, R1064, R1065, R1066, R1067, R1068, R1069, R1070, R1071, R1072, R1073, R1074, R1075, R1076, R1077, R1078, R1079, R1080, R1081, R1082, R1083, R1084, R1085, R1086, R1087, R1088, R1089, R1090, R1091, R1092, R1093, R1094, R1095, R1096, R1097, R1098, R1099, R1100, R1101, R1102, R1103, R1104, R1105, R1106, R1107, R1108, R1109, R1110, R1111, R1112, R1113, R1114, R1115, R1116, R1117, R1118, R1119, R1120, R1121, R1122, R1123, R1124, R1125, R1126, R1127, R1128, R1129, R1130, R1131, R1132, R1133, R1134, R1135, R1136, R1137, R1138, R1139, R1140, R1141, R1142, R1143, R1144, R1145, R1146, R1147, R1148, R1149, R1150, R1151, R1152, R1153, R1154, R1155, R1156, R1157, R1158, R1159, R1160, R1161, R1162, R1163, R1164, R1165, R1166, R1167, R1168, R1169, R1170, R1171, R1172, R1173, R1174, R1175, R1176, R1177, R1178, R1179, R1180, R1181, R1182, R1183, R1184, R1185, R1186, R1187, R1188, R1189, R1190, R1191, R1192, R1193, R1194, R1195, R1196, R1197, R1198, R1199, R1200, R1201, R1202, R1203, R1204, R1205, R1206, R1207, R1208, R1209, R1210, R1211, R1212, R1213, R1214, R1215, R1216, R1217, R1218, R1219, R1220, R1221, R1222, R1223, R1224, R1225, R1226, R1227, R1228, R1229, R1230, R1231, R1232, R1233, R1234, R1235, R1236, R1237, R1238, R1239, R1240, R1241, R1242, R1243, R1244, R1245, R1246, R1247, R1248, R1249, R1250, R1251, R1252, R1253, R1254, R1255, R1256, R1257, R1258, R1259, R1260, R1261, R1262, R1263, R1264, R1265, R1266, R1267, R1268, R1269, R1270, R1271, R1272, R1273, R1274, R1275, R1276, R1277, R1278, R1279, R1280, R1281, R1282, R1283, R1284, R1285, R1286, R1287, R1288, R1289, R1290, R1291, R1292, R1293, R1294, R1295, R1296, R1297, R1298, R1299, R1300, R1301, R1302, R1303, R1304, R1305, R1306, R1307, R1308, R1309, R1310, R1311, R1312, R1313, R1314, R1315, R1316, R1317, R1318, R1319, R1320, R1321, R1322, R1323, R1324, R1325, R1326, R1327, R1328, R1329, R1330, R1331, R1332, R1333, R1334, R1335, R1336, R1337, R1338, R1339, R1340, R1341, R1342, R1343, R1344, R1345, R1346, R1347, R1348, R1349, R1350, R1351, R1352, R1353, R1354, R1355, R1356, R1357, R1358, R1359, R1360, R1361, R1362, R1363, R1364, R1365, R1366, R1367, R1368, R1369, R1370, R1371, R1372, R1373, R1374, R1375, R1376, R1377, R1378, R1379, R1380, R1381, R1382, R1383, R1384, R1385, R1386, R1387, R1388, R1389, R1390, R1391, R1392, R1393, R1394, R1395, R1396, R1397, R1398, R1399, R1400, R1401, R1402, R1403, R1404, R1405, R1406, R1407, R1408, R1409, R1410, R1411, R1412, R1413, R1414, R1415, R1416, R1417, R1418, R1419, R1420, R1421, R1422, R1423, R1424, R1425, R1426, R1427, R1428, R1429, R1430, R1431, R1432, R1433, R1434, R1435, R1436, R1437, R1438, R1439, R1440, R1441, R1442, R1443, R1444, R1445, R1446, R1447, R1448, R1449, R1450, R1451, R1452, R1453, R1454, R1455, R1456, R1457, R1458, R1459, R1460, R1461, R1462, R1463, R1464, R1465, R1466, R1467, R1468, R1469, R1470, R1471, R1472, R1473, R1474, R1475, R1476, R1477, R1478, R1479, R1480, R1481, R1482, R1483, R1484, R1485, R1486, R1487, R1488, R1489, R1490, R1491, R1492, R1493, R1494, R1495, R1496, R1497, R1498, R1499, R1500, R1501, R1502, R1503, R1504, R1505, R1506, R1507, R1508, R1509, R1510, R1511, R1512, R1513, R1514, R1515, R1516, R1517, R1518, R1519, R1520, R1521, R1522, R1523, R1524, R1525, R1526, R1527, R1528, R1529, R1530, R1531, R1532, R1533, R1534, R1535, R1536, R1537, R1538, R1539, R1540, R1541, R1542, R1543, R1544, R1545, R1546, R1547, R1548, R1549, R1550, R1551, R1552, R1553, R1554, R1555, R1556, R1557, R1558, R1559, R1560, R1561, R1562, R1563, R1564, R1565, R1566, R1567, R1568, R1569, R1570, R1571, R1572, R1573, R1574, R1575, R1576, R1577, R1578, R1579, R1580, R1581, R1582, R1583, R1584, R1585, R1586, R1587, R1588, R1589, R1590, R1591, R1592, R1593, R1594, R1595, R1596, R1597, R1598, R1599, R1600, R1601, R1602, R1603, R1604, R1605, R1606, R1607, R1608, R1609, R1610, R1611, R1612, R1613, R1614, R1615, R1616, R1617, R1618, R1619, R1620, R1621, R1622, R1623, R1624, R1625, R1626, R1627, R1628, R1629, R1630, R1631, R1632, R1633, R1634, R1635, R1636, R1637, R1638, R1639, R1640, R1641, R1642, R1643, R1644, R1645, R1646, R1647, R1648, R1649, R1650, R1651, R1652, R1653, R1654, R1655, R1656, R1657, R1658, R1659, R1660, R1661, R1662, R1663, R1664, R1665, R1666, R1667, R1668, R1669, R1670, R1671, R1672, R1673, R1674, R1675, R1676, R1677, R1678, R1679, R1680, R1681, R1682, R1683, R1684, R1685, R1686, R1687, R1688, R1689, R1690, R1691, R1692, R1693, R1694, R1695, R1696, R1697, R1698, R1699, R1700, R1701, R1702, R1703, R1704, R1705, R1706, R1707, R1708, R1709, R1710, R1711, R1712, R1713, R1714, R1715, R1716, R1717, R1718, R1719, R1720, R1721, R1722, R1723, R1724, R1725, R1726, R1727, R1728, R1729, R1730, R1731, R1732, R1733, R1734, R1735, R1736, R1737, R1738, R1739, R1740, R1741, R1742, R1743, R1744, R1745, R1746, R1747, R1748, R1749, R1750, R1751, R1752, R1753, R1754, R1755, R1756, R1757, R1758, R1759, R1760, R1761, R1762, R1763, R1764, R1765, R1766, R1767, R1768, R1769, R1770, R1771, R1772, R1773, R1774, R1775, R1776, R1777, R1778, R1779, R1780, R1781, R1782, R1783, R1784, R1785, R1786, R1787, R1788, R1789, R1790, R1791, R1792: 10K; 0603-RES

Connections:
GND: JP1.3, JP2.4
GND1: JP5.3, JP6.4
GND2: JP9.3, JP10.4
GND3: JP13.3, JP14.4
GND4: JP17.3, JP18.4
GND5: JP21.3, JP22.4
GND6: JP25.3, JP26.4
GND7: JP29.3, JP30.4
GND8: JP33.3, JP34.4
GND9: JP37.3, JP38.4
GND10: JP41.3, JP42.4
GND11: JP45.3, JP46.4
GND12: JP49.3, JP50.4
GND13: JP53.3, JP54.4
GND14: JP57.3, JP58.4
GND15: JP61.3, JP62.4
GND16: JP65.3, JP66.4
GND17: JP69.3, JP70.4
GND18: JP73.3, JP74.4
GND19: JP77.3, JP78.4
GND20: JP81.3, JP82.4
GND21: JP85.3, JP86.4
GND22: JP89.3, JP90.4
GND23: JP93.3, JP94.4
GND24: JP97.3, JP98.4
GND25: JP101.3, JP102.4
GND26: JP105.3, JP106.4
GND27: JP109.3, JP110.4
GND28: JP113.3, JP114.4
GND29: JP117.3, JP118.4
GND30: JP121.3, JP122.4
GND31: JP125.3, JP126.4
GND32: JP129.3, JP130.4
GND33: JP133.3, JP134.4
GND34: JP137.3, JP138.4
GND35: JP141.3, JP142.4
GND36: JP145.3, JP146.4
GND37: JP149.3, JP150.4
GND38: JP153.3, JP154.4
GND39: JP157.3, JP158.4
GND40: JP161.3, JP162.4
GND41: JP165.3, JP166.4
GND42: JP169.3, JP170.4
GND43: JP173.3, JP174.4
GND44: JP177.3, JP178.4
GND45: JP181.3, JP182.4
GND46: JP185.3, JP186.4
GND47: JP189.3, JP190.4
GND48: JP193.3, JP194.4
GND49: JP197.3, JP198.4
GND50: JP201.3, JP202.4
GND51: JP205.3, JP206.4
GND52: JP209.3, JP210.4
GND53: JP213.3, JP214.4
GND54: JP217.3, JP218.4
GND55: JP221.3, JP222.4
GND56: JP225.3, JP226.4
GND57: JP229.3, JP230.4
GND58: JP233.3, JP234.4
GND59: JP237.3, JP238.4
GND60: JP241.3, JP242.4
GND61: JP245.3, JP246.4
GND62: JP249.3, JP250.4
GND63: JP253.3, JP254.4
GND64: JP257.3, JP258.4
GND65: JP261.3, JP262.4
GND66: JP265.3, JP266.4
GND67: JP269.3, JP270.4
GND68: JP273.3, JP274.4
GND69: JP277.3, JP278.4
GND70: JP281.3, JP282.4
GND71: JP285.3, JP286.4
GND72: JP289.3, JP290.4
GND73: JP293.3, JP294.4
GND74: JP297.3, JP298.4
GND75: JP301.3, JP302.4
GND76: JP305.3, JP306.4
GND77: JP309.3, JP310.4
GND78: JP313.3, JP314.4
GND79: JP317.3, JP318.4
GND80: JP321.3, JP322.4
GND81: JP325.3, JP326.4
GND82: JP329.3, JP330.4
GND83: JP333.3, JP334.4
GND84: JP337.3, JP338.4
GND85: JP341.3, JP342.4
GND86: JP345.3, JP346.4
GND87: JP349.3, JP350.4
GND88: JP353.3, JP354.4
GND89: JP357.3, JP358.4
GND90: JP361.3, JP362.4
GND91: JP365.3, JP366.4
GND92: JP369.3, JP370.4
GND93: JP373.3, JP374.4
GND94: JP377.3, JP378.4
GND95: JP381.3, JP382.4
GND96: JP385.3, JP386.4
GND97: JP389.3, JP390.4
GND98: JP393.3, JP394.4
GND99: JP397.3, JP398.4
GND100: JP401.3, JP402.4
GND101: JP405.3, JP406.4
GND102: JP409.3, JP410.4
GND103: JP413.3, JP414.4
GND104: JP417.3, JP418.4
GND105: JP421.3, JP422.4
GND106: JP425.3, JP426.4
GND107: JP429.3, JP430.4
GND108: JP433.3, JP434.4
GND109: JP437.3, JP438.4
GND110: JP441.3, JP442.4
GND111: JP445.3, JP446.4
GND112: JP449.3, JP450.4
GND113: JP453.3, JP454.4
GND114: JP457.3, JP458.4
GND115: JP461.3, JP462.4
GND116: JP465.3, JP466.4
GND117: JP469.3, JP470.4
GND118: JP473.3, JP474.4
GND119: JP477.3, JP478.4
GND120: JP481.3, JP482.4
GND121: JP485.3, JP486.4
GND122: JP489.3, JP490.4
GND123: JP493.3, JP494.4
GND124: JP497.3, JP498.4
GND125: JP501.3, JP502.4
GND126: JP505.3, JP506.4
GND127: JP509.3, JP510.4
GND128: JP513.3, JP514.4
GND129: JP517.3, JP518.4
GND130: JP521.3, JP522.4
GND131: JP525.3, JP526.4
GND132: JP529.3, JP530.4
GND133: JP533.3, JP534.4
GND134: JP537.3, JP538.4
GND135: JP541.3, JP542.4
GND136: JP545.3, JP546.4
GND137: JP549.3, JP550.4
GND138: JP553.3, JP554.4
GND139: JP557.3, JP558.4
GND140: JP561.3, JP562.4
GND141: JP565.3, JP566.4
GND142: JP569.3, JP570.4
GND143: JP573.3, JP574.4
GND144: JP577.3, JP578.4
GND145: JP581.3, JP582.4
GND146: JP585.3, JP586.4
GND147: JP589.3, JP590.4
GND148: JP593.3, JP594.4
GND149: JP597.3, JP598.4
GND150: JP601.3, JP602.4
GND151: JP605.3, JP606.4
GND152: JP609.3, JP610.4
GND153: JP613.3, JP614.4
GND154: JP617.3, JP618.4
GND155: JP621.3, JP622.4
GND156: JP625.3, JP626.4
GND157: JP629.3, JP630.4
GND158: JP633.3, JP634.4
GND159: JP637.3, JP638.4
GND160: JP641.3, JP642.4
GND161: JP645.3, JP646.4
GND162: JP649.3, JP650.4
GND163: JP653.3, JP654.4
GND164: JP657.3, JP658.4
GND165: JP661.3, JP662.4
GND166: JP665.3, JP666.4
GND167: JP669.3, JP670.4
GND168: JP673.3, JP674.4
GND169: JP677.3, JP678.4
GND170: JP681.3, JP682.4
GND171: JP685.3, JP686.4
GND172: JP689.3, JP690.4
GND173: JP693.3, JP694.4
GND174: JP697.3, JP698.4
GND175: JP701.3, JP702.4
GND176: JP705.3, JP706.4
GND177: JP709.3, JP710.4
GND178: JP713.3, JP714.4
GND179: JP717.3, JP718.4
GND180: JP721.3, JP722.4
GND181: JP725.3, JP726.4
GND182: JP729.3, JP730.4
GND183: JP733.3, JP734.4
GND184: JP737.3, JP738.4
GND185: JP741.3, JP742.4
GND186: JP745.3, JP746.4
GND187: JP749.3, JP750.4
GND188: JP753.3, JP754.4
GND189: JP757.3, JP758.4
GND190: JP761.3, JP762.4
GND191: JP765.3, JP766.4
GND192: JP769.3, JP770.4
GND193: JP773.3, JP774.4
GND194: JP777.3, JP778.4
GND195: JP781.3, JP782.4
GND196: JP785.3, JP786.4
GND197: JP789.3, JP790.4
GND198: JP793.3, JP794.4
GND199: JP797.3, JP798.4
GND200: JP801.3, JP802.4
GND201: JP805.3, JP806.4
GND202: JP809.3, JP810.4
GND203: JP813.3, JP814.4
GND204: JP817.3, JP818.4
GND205: JP821.3, JP822.4
GND206: JP825.3, JP826.4
GND207: JP829.3, JP830.4
GND208: JP833.3, JP834.4
GND209: JP837.3, JP838.4
GND210: JP841.3, JP842.4
GND211: JP845.3, JP846.4
GND212: JP849.3, JP850.4
GND213: JP853.3, JP854.4
GND214: JP857.3, JP858.4
GND215: JP861.3, JP862.4
GND216: JP865.3, JP866.4
GND217: JP869.3, JP870.4
GND218: JP873.3, JP874.4
GND219: JP877.3, JP878.4
GND220: JP881.3, JP882.4
GND221: JP885.3, JP886.4
GND222: JP889.3, JP890.4
GND223: JP893.3, JP894.4
HV: JP2.3, R4.1, R5.1, R7.1, R10.1
HV1: JP2.1, Q1.3, R4.2
HV2: JP2.2, Q3.3, R10.2
HV3: JP2.5, Q4.3, R5.2
HV4: JP2.6, Q2.3, R7.2
HV5: JP6.1, Q6.3, R12.2
HV6: JP6.2, Q7.3, R14.2
HV7: JP6.3, R9.1, R12.1, R14.1, R16.1
HV8: JP6.5, Q8.3, R16.2
HV9: JP6.6, Q5.3, R9.2
HV10: JP10.1, Q10.3, R20.2
HV11: JP10.2, Q11.3, R22.2
HV12: JP10.3, R18.1, R20.1, R22.1, R24.1
HV13: JP10.5, Q12.3, R24.2
HV14: JP10.6, Q9.3, R18.2
HV15: JP14.1, Q14.3, R28.2
HV16: JP14.2, Q15.3, R30.2
HV17: JP14.3, R26.1, R28.1, R30.1, R32.1
HV18: JP14.5, Q16.3, R32.2
HV19: JP14.6, Q13.3, R26.2
HV20: JP18.1, Q18.3, R36.2
HV21: JP18.2, Q19.3, R38.2
HV22: JP18.3, R34.1, R36.1, R38.1, R40.1
HV23: JP18.5, Q20.3, R40.2
HV24: JP18.6, Q17.3, R34.2
HV25: JP22.1, Q22.3, R44.2
HV26: JP22.2, Q23.3, R46.2
HV27: JP22.3, R42.1, R44.1, R46.1, R48.1
HV28: JP22.5, Q24.3, R48.2
HV29: JP22.6, Q21.3, R42.2
HV30: JP26.1, Q26.3, R52.2
HV31: JP26.2, Q27.3, R54.2
HV32: JP26.3, R50.1, R52.1, R54.1, R56.1
HV33: JP26.5, Q28.3, R56.2
HV34: JP26.6, Q25.3, R50.2
HV35: JP30.1, Q30.3, R60.2
HV36: JP30.2, Q31.3, R62.2
HV37: JP30.3, R58.1, R60.1, R62.1, R64.1
HV38: JP30.5, Q32.3, R64.2
HV39: JP30.6, Q29.3, R58.2
HV40: JP34.1, Q34.3, R68.2
HV41: JP34.2, Q35.3, R70.2
HV42: JP34.3, R66.1, R68.1, R70.1, R72.1
HV43: JP34.5, Q36.3, R72.2
HV44: JP34.6, Q33.3, R66.2
HV45: JP38.1, Q38.3, R76.2
HV46: JP38.2, Q39.3, R78.2
HV47: JP38.3, R74.1, R76.1, R78.1, R80.1
HV48: JP38.5, Q40.3, R80.2
HV49: JP38.6, Q37.3, R74.2
HV50: JP42.1, Q42.3, R84.2
HV51: JP42.2, Q43.3, R86.2
HV52: JP42.3, R82.1, R84.1, R86.1, R88.1
HV53: JP42.5, Q44.3, R88.2
HV54: JP42.6, Q41.3, R82.2
HV55: JP46.1, Q46.3, R92.2
HV56: JP46.2, Q47.3, R94.2
HV57: JP46.3, R90.1, R92.1, R94.1, R96.1
HV58: JP46.5, Q48.3, R96.2
HV59: JP46.6, Q45.3, R90.2
HV60: JP50.1, Q50.3, R100.2
HV61: JP50.2, Q51.3, R102.2
HV62: JP50.3, R98.1, R100.1, R102.1, R104.1
HV63: JP50.5, Q52.3, R104.2
HV64: JP50.6, Q49.3, R98.2
HV65: JP54.1, Q54.3, R108.2
HV66: JP54.2, Q55.3, R110.2
HV67: JP54.3, R106.1, R108.1, R110.1, R112.1
HV68: JP54.5, Q56.3, R112.2
HV69: JP54.6, Q53.3, R106.2
HV70: JP58.1, Q58.3, R116.2
HV71: JP58.2, Q59.3, R118.2
HV72: JP58.3, R114.1, R116.1, R118.1, R120.1
HV73: JP58.5, Q60.3, R120.2
HV74: JP58.6, Q57.3, R114.2
HV75: JP62.1, Q62.3, R124.2
HV76: JP62.2, Q63.3, R126.2
HV77: JP62.3, R122.1, R124.1, R126.1, R128.1
HV78: JP62.5, Q64.3, R128.2
HV79: JP62.6, Q61.3, R122.2
HV80: JP66.1, Q66.3, R132.2
HV81: JP66.2, Q67.3, R134.2
HV82: JP66.3, R130.1, R132.1, R134.1, R136.1
HV83: JP66.5, Q68.3, R136.2
HV84: JP66.6, Q65.3, R130.2
HV85: JP70.1, Q70.3, R140.2
HV86: JP70.2, Q71.3, R142.2
HV87: JP70.3, R138.1, R140.1, R142.1, R144.1
HV88: JP70.5, Q72.3, R144.2
HV89: JP70.6, Q69.3, R138.2
HV90: JP74.1, Q74.3, R148.2
HV91: JP74.2, Q75.3, R150.2
HV92: JP74.3, R146.1, R148.1, R150.1, R152.1
HV93: JP74.5, Q76.3, R152.2
HV94: JP74.6, Q73.3, R146.2
HV95: JP78.1, Q78.3, R156.2
HV96: JP78.2, Q79.3, R158.2
HV97: JP78.3, R154.1, R156.1, R158.1, R160.1
HV98: JP78.5, Q80.3, R160.2
HV99: JP78.6, Q77.3, R154.2
HV100: JP82.1, Q82.3, R164.2
HV101: JP82.2, Q83.3, R166.2
HV102: JP82.3, R162.1, R164.1, R166.1, R168.1
HV103: JP82.5, Q84.3, R168.2
HV104: JP82.6, Q81.3, R162.2
HV105: JP86.1, Q86.3, R172.2
HV106: JP86.2, Q87.3, R174.2
HV107: JP86.3, R170.1, R172.1, R174.1, R176.1
HV108: JP86.5, Q88.3, R176.2
HV109: JP86.6, Q85.3, R170.2
HV110: JP90.1, Q90.3, R180.2
HV111: JP90.2, Q91.3, R182.2
HV112: JP90.3, R178.1, R180.1, R182.1, R184.1
HV113: JP90.5, Q92.3, R184.2
HV114: JP90.6, Q89.3, R178.2
HV115: JP94.1, Q94.3, R188.2
HV116: JP94.2, Q95.3, R190.2
HV117: JP94.3, R186.1, R188.1, R190.1, R192.1
HV118: JP94.5, Q96.3, R192.2
HV119: JP94.6, Q93.3, R186.2
HV120: JP98.1, Q98.3, R196.2
HV121: JP98.2, Q99.3, R198.2
HV122: JP98.3, R194.1, R196.1, R198.1, R200.1
HV123: JP98.5, Q100.3, R200.2
HV124: JP98.6, Q97.3, R194.2
HV125: JP102.1, Q102.3, R204.2
HV126: JP102.2, Q103.3, R206.2
HV127: JP102.3, R202.1, R204.1, R206.1, R208.1
HV128: JP102.5, Q104.3, R208.2
HV129: JP102.6, Q101.3, R202.2
HV130: JP106.1, Q106.3, R212.2
HV131: JP106.2, Q107.3, R214.2
HV132: JP106.3, R210.1, R212.1, R214.1, R216.1
HV133: JP106.5, Q108.3, R216.2
HV134: JP106.6, Q105.3, R210.2
HV135: JP110.1, Q110.3, R220.2
HV136: JP110.2, Q111.3, R222.2
HV137: JP110.3, R218.1, R220.1, R222.1, R224.1
HV138: JP110.5, Q112.3, R224.2
HV139: JP110.6, Q109.3, R218.2
HV140: JP114.1, Q114.3, R228.2
HV141: JP114.2, Q115.3, R230.2
HV142: JP114.3, R226.1, R228.1, R230.1, R232.1
HV143: JP114.5, Q116.3, R232.2
HV144: JP114.6, Q113.3, R226.2
HV145: JP118.1, Q118.3, R236.2
HV146: JP118.2, Q119.3, R238.2
HV147: JP118.3, R234.1, R236.1, R238.1, R240.1
HV148: JP118.5, Q120.3, R240.2
HV149: JP118.6, Q117.3, R234.2
HV150: JP122.1, Q122.3, R244.2
HV151: JP122.2, Q123.3, R246.2
HV152: JP122.3, R242.1, R244.1, R246.1, R248.1
HV153: JP122.5, Q124.3, R248.2
HV154: JP122.6, Q121.3, R242.2
HV155: JP126.1, Q126.3, R252.2
HV156: JP126.2, Q127.3, R254.2
HV157: JP126.3, R250.1, R252.1, R254.1, R256.1
HV158: JP126.5, Q128.3, R256.2
HV159: JP126.6, Q125.3, R250.2
HV160: JP130.1, Q130.3, R260.2
HV161: JP130.2, Q131.3, R262.2
HV162: JP130.3, R258.1, R260.1, R262.1, R264.1
HV163: JP130.5, Q132.3, R264.2
HV164: JP130.6, Q129.3, R258.2
HV165: JP134.1, Q134.3, R268.2
HV166: JP134.2, Q135.3, R270.2
HV167: JP134.3, R266.1, R268.1, R270.1, R272.1
HV168: JP134.5, Q136.3, R272.2
HV169: JP134.6, Q133.3, R266.2
HV170: JP138.1, Q138.3, R276.2
HV171: JP138.2, Q139.3, R278.2
HV172: JP138.3, R274.1, R276.1, R278.1, R280.1
HV173: JP138.5, Q140.3, R280.2
HV174: JP138.6, Q137.3, R274.2
HV175: JP142.1, Q142.3, R284.2
HV176: JP142.2, Q143.3, R286.2
HV177: JP142.3, R282.1, R284.1, R286.1, R288.1
HV178: JP142.5, Q144.3, R288.2
HV179: JP142.6, Q141.3, R282.2
HV180: JP146.1, Q146.3, R292.2
HV181: JP146.2, Q147.3, R294.2
HV182: JP146.3, R290.1, R292.1, R294.1, R296.1
HV183: JP146.5, Q148.3, R296.2
HV184: JP146.6, Q145.3, R290.2
HV185: JP150.1, Q150.3, R300.2
HV186: JP150.2, Q151.3, R302.2
HV187: JP150.3, R298.1, R300.1, R302.1, R304.1
HV188: JP150.5, Q152.3, R304.2
HV189: JP150.6, Q149.3, R298.2
HV190: JP154.1, Q154.3, R308.2
HV191: JP154.2, Q155.3, R310.2
HV192: JP154.3, R306.1, R308.1, R310.1, R312.1
HV193: JP154.5, Q156.3, R312.2
HV194: JP154.6, Q153.3, R306.2
HV195: JP158.1, Q158.3, R316.2
HV196: JP158.2, Q159.3, R318.2
HV197: JP158.3, R314.1, R316.1, R318.1, R320.1
HV198: JP158.5, Q160.3, R320.2
HV199: JP158.6, Q157.3, R314.2
HV200: JP162.1, Q162.3, R324.2
HV201: JP162.2, Q163.3, R326.2
HV202: JP162.3, R322.1, R324.1, R326.1, R328.1
HV203: JP162.5, Q164.3, R328.2
HV204: JP162.6, Q161.3, R322.2
HV205: JP166.1, Q166.3, R332.2
HV206: JP166.2, Q167.3, R334.2
HV207: JP166.3, R330.1, R332.1, R334.1, R336.1
HV208: JP166.5, Q168.3, R336.2
HV209: JP166.6, Q165.3, R330.2
HV210: JP170.1, Q170.3, R340.2
HV211: JP170.2, Q171.3, R342.2
HV212: JP170.3, R338.1, R340.1, R342.1, R344.1
HV213: JP170.5, Q172.3, R344.2
HV214: JP170.6, Q169.3, R338.2
HV215: JP174.1, Q174.3, R348.2
HV216: JP174.2, Q175.3, R350.2
HV217: JP174.3, R346.1, R348.1, R350.1, R352.1
HV218: JP174.5, Q176.3, R352.2
HV219: JP174.6, Q173.3, R346.2
HV220: JP178.1, Q178.3, R356.2
HV221: JP178.2, Q179.3, R358.2
HV222: JP178.3, R354.1, R356.1, R358.1, R360.1
HV223: JP178.5, Q180.3, R360.2
HV224: JP178.6, Q177.3, R354.2
HV225: JP182.1, Q182.3, R364.2
HV226: JP182.2, Q183.3, R366.2
HV227: JP182.3, R362.1, R364.1, R366.1, R368.1
HV228: JP182.5, Q184.3, R368.2
HV229: JP182.6, Q181.3, R362.2
HV230: JP186.1, Q186.3, R372.2
HV231: JP186.2, Q187.3, R374.2
HV232: JP186.3, R370.1, R372.1, R374.1, R376.1
HV233: JP186.5, Q188.3, R376.2
HV234: JP186.6, Q185.3, R370.2
HV235: JP190.1, Q190.3, R380.2
HV236: JP190.2, Q191.3, R382.2
HV237: JP190.3, R378.1, R380.1, R382.1, R384.1
HV238: JP190.5, Q192.3, R384.2
HV239: JP190.6, Q189.3, R378.2
HV240: JP194.1, Q194.3, R388.2
HV241: JP194.2, Q195.3, R390.2
HV242: JP194.3, R386.1, R388.1, R390.1, R392.1
HV243: JP194.5, Q196.3, R392.2
HV244: JP194.6, Q193.3, R386.2
HV245: JP198.1, Q198.3, R396.2
HV246: JP198.2, Q199.3, R398.2
HV247: JP198.3, R394.1, R396.1, R398.1, R400.1
HV248: JP198.5, Q200.3, R400.2
HV249: JP198.6, Q197.3, R394.2
HV250: JP202.1, Q202.3, R404.2
HV251: JP202.2, Q203.3, R406.2
HV252: JP202.3, R402.1, R404.1, R406.1, R408.1
HV253: JP202.5, Q204.3, R408.2
HV254: JP202.6, Q201.3, R402.2
HV255: JP206.1, Q206.3, R412.2
HV256: JP206.2, Q207.3, R414.2
HV257: JP206.3, R410.1, R412.1, R414.1, R416.1
HV258: JP206.5, Q208.3, R416.2
HV259: JP206.6, Q205.3, R410.2
HV260: JP210.1, Q210.3, R420.2
HV261: JP210.2, Q211.3, R422.2
HV262: JP210.3, R418.1, R420.1, R422.1, R424.1
HV263: JP210.5, Q212.3, R424.2
HV264: JP210.6, Q209.3, R418.2
HV265: JP214.1, Q214.3, R428.2
HV266: JP214.2, Q215.3, R430.2
HV267: JP214.3, R426.1, R428.1, R430.1, R432.1
HV268: JP214.5, Q216.3, R432.2
HV269: JP214.6, Q213.3, R426.2
HV270: JP218.1, Q218.3, R436.2
HV271: JP218.2, Q219.3, R438.2
HV272: JP218.3, R434.1, R436.1, R438.1, R440.1
HV273: JP218.5, Q220.3, R440.2
HV274: JP218.6, Q217.3, R434.2
HV275: JP222.1, Q222.3, R444.2
HV276: JP222.2, Q223.3, R446.2
HV277: JP222.3, R442.1, R444.1, R446.1, R448.1
HV278: JP222.5, Q224.3, R448.2
HV279: JP222.6, Q221.3, R442.2
HV280: JP226.1, Q226.3, R452.2
HV281: JP226.2, Q227.3, R454.2
HV282: JP226.3, R450.1, R452.1, R454.1, R456.1
HV283: JP226.5, Q228.3, R456.2
HV284: JP226.6, Q225.3, R450.2
HV285: JP230.1, Q230.3, R460.2
HV286: JP230.2, Q231.3, R462.2
HV287: JP230.3, R458.1, R460.1, R462.1, R464.1
HV288: JP230.5, Q232.3, R464.2
HV289: JP230.6, Q229.3, R458.2
HV290: JP234.1, Q234.3, R468.2
HV291: JP234.2, Q235.3, R470.2
HV292: JP234.3, R466.1, R468.1, R470.1, R472.1
HV293: JP234.5, Q236.3, R472.2
HV294: JP234.6, Q233.3, R466.2
HV295: JP238.1, Q238.3, R476.2
HV296: JP238.2, Q239.3, R478.2
HV297: JP238.3, R474.1, R476.1, R478.1, R480.1
HV298: JP238.5, Q240.3, R480.2
HV299: JP238.6, Q237.3, R474.2
HV300: JP242.1, Q242.3, R484.2
HV301: JP242.2, Q243.3, R486.2
HV302: JP242.3, R482.1, R484.1, R486.1, R488.1
HV303: JP242.5, Q244.3, R488.2
HV304: JP242.6, Q241.3, R482.2
HV305: JP246.1, Q246.3, R492.2
HV306: JP246.2, Q247.3, R494.2
HV307: JP246.3, R490.1, R492.1, R494.1, R496.1
HV308: JP246.5, Q248.3, R496.2
HV309: JP246.6, Q245.3, R490.2
HV310: JP250.1, Q250.3, R500.2
HV311: JP250.2, Q251.3, R502.2
HV312: JP250.3, R498.1, R500.1, R502.1, R504.1
HV313: JP250.5, Q252.3, R504.2
HV314: JP250.6, Q249.3, R498.2
HV315: JP254.1, Q254.3, R508.2
HV316: JP254.2, Q255.3, R510.2
HV317: JP254.3, R506.1, R508.1, R510.1, R512.1
HV318: JP254.5, Q256.3, R512.2
HV319: JP254.6, Q253.3, R506.2
HV320: JP258.1, Q258.3, R516.2
HV321: JP258.2, Q259.3, R518.2
HV322: JP258.3, R514.1, R516.1, R518.1, R520.1
HV323: JP258.5, Q260.3, R520.2
HV324: JP258.6, Q257.3, R514.2
HV325: JP262.1, Q262.3, R524.2
HV326: JP262.2, Q263.3, R526.2
HV327: JP262.3, R522.1, R524.1, R526.1, R528.1
HV328: JP262.5, Q264.3, R528.2
HV329: JP262.6, Q261.3, R522.2
HV330: JP266.1, Q266.3, R532.2
HV331: JP266.2, Q267.3, R534.2
HV332: JP266.3, R530.1, R532.1, R534.1, R536.1
HV333: JP266.5, Q268.3, R536.2
HV334: JP266.6, Q265.3, R530.2
HV335: JP270.1, Q270.3, R540.2
HV336: JP270.2, Q271.3, R542.2
HV337: JP270.3, R538.1, R540.1, R542.1, R544.1
HV338: JP270.5, Q272.3, R544.2
HV339: JP270.6, Q269.3, R538.2
HV340: JP274.1, Q274.3, R548.2
HV341: JP274.2, Q275.3, R550.2
HV342: JP274.3, R546.1, R548.1, R550.1, R552.1
HV343: JP274.5, Q276.3, R552.2
HV344: JP274.6, Q273.3, R546.2
HV345: JP278.1, Q278.3, R556.2
HV346: JP278.2, Q279.3, R558.2
HV347: JP278.3, R554.1, R556.1, R558.1, R560.1
HV348: JP278.5, Q280.3, R560.2
HV349: JP278.6, Q277.3, R554.2
HV350: JP282.1, Q282.3, R564.2
HV351: JP282.2, Q283.3, R566.2
HV352: JP282.3, R562.1, R564.1, R566.1, R568.1
HV353: JP282.5, Q284.3, R568.2
HV354: JP282.6, Q281.3, R562.2
HV355: JP286.1, Q286.3, R572.2
HV356: JP286.2, Q287.3, R574.2
HV357: JP286.3, R570.1, R572.1, R574.1, R576.1
HV358: JP286.5, Q288.3, R576.2
HV359: JP286.6, Q285.3, R570.2
HV360: JP290.1, Q290.3, R580.2
HV361: JP290.2, Q291.3, R582.2
HV362: JP290.3, R578.1, R580.1, R582.1, R584.1
HV363: JP290.5, Q292.3, R584.2
HV364: JP290.6, Q289.3, R578.2
HV365: JP294.1, Q294.3, R588.2
HV366: JP294.2, Q295.3, R590.2
HV367: JP294.3, R586.1, R588.1, R590.1, R592.1
HV368: JP294.5, Q296.3, R592.2
HV369: JP294.6, Q293.3, R586.2
HV370: JP298.1, Q298.3, R596.2
HV371: JP298.2, Q299.3, R598.2
HV372: JP298.3, R594.1, R596.1, R598.1, R600.1
HV373: JP298.5, Q300.3, R600.2
HV374: JP298.6, Q297.3, R594.2
HV375: JP302.1, Q302.3, R604.2
HV376: JP302.2, Q303.3, R606.2
HV377: JP302.3, R602.1, R604.1, R606.1, R608.1
HV378: JP302.5, Q304.3, R608.2
HV379: JP302.6, Q301.3, R602.2
HV380: JP306.1, Q306.3, R612.2
HV381: JP306.2, Q307.3, R614.2
HV382: JP306.3, R610.1, R612.1, R614.1, R616.1
HV383: JP306.5, Q308.3, R616.2
HV384: JP306.6, Q305.3, R610.2
HV385: JP310.1, Q310.3, R620.2
HV386: JP310.2, Q311.3, R622.2
HV387: JP310.3, R618.1, R620.1, R622.1, R624.1
HV388: JP310.5, Q312.3, R624.2
HV389: JP310.6, Q309.3, R618.2
HV390: JP314.1, Q314.3, R628.2
HV391: JP314.2, Q315.3, R630.2
HV392: JP314.3, R626.1, R628.1, R630.1, R632.1
HV393: JP314.5, Q316.3, R632.2
HV394: JP314.6, Q313.3, R626.2
HV395: JP318.1, Q318.3, R636.2
HV396: JP318.2, Q319.3, R638.2
HV397: JP318.3, R634.1, R636.1, R638.1, R640.1
HV398: JP318.5, Q320.3, R640.2
HV399: JP318.6, Q317.3, R634.2
HV400: JP322.1, Q322.3, R644.2
HV401: JP322.2, Q323.3, R646.2
HV402: JP322.3, R642.1, R644.1, R646.1, R648.1
HV403: JP322.5, Q324.3, R648.2
HV404: JP322.6, Q321.3, R642.2
HV405: JP326.1, Q326.3, R652.2
HV406: JP326.2, Q327.3, R654.2
HV407: JP326.3, R650.1, R652.1, R654.1, R656.1
HV408: JP326.5, Q328.3, R656.2
HV409: JP326.6, Q325.3, R650.2
HV410: JP330.1, Q330.3, R660.2
HV411: JP330.2, Q331.3, R662.2
HV412: JP330.3, R658.1, R660.1, R662.1, R664.1
HV413: JP330.5, Q332.3, R664.2
HV414: JP330.6, Q329.3, R658.2
HV415: JP334.1, Q334.3, R668.2
HV416: JP334.2, Q335.3, R670.2
HV417: JP334.3, R666.1, R668.1, R670.1, R672.1
HV418: JP334.5, Q336.3, R672.2
HV419: JP334.6, Q333.3, R666.2
HV420: JP338.1, Q338.3, R676.2
HV421: JP338.2, Q339.3, R678.2
HV422: JP338.3, R674.1, R676.1, R678.1, R680.1
HV423: JP338.5, Q340.3, R680.2
HV424: JP338.6, Q337.3, R674.2
HV425: JP342.1, Q342.3, R684.2
HV426: JP342.2, Q343.3, R686.2
HV427: JP342.3, R682.1, R684.1, R686.1, R688.1
HV428: JP342.5, Q344.3, R688.2
HV429: JP342.6, Q341.3, R682.2
HV430: JP346.1, Q346.3, R692.2
HV431: JP346.2, Q347.3, R694.2
HV432: JP346.3, R690.1, R692.1, R694.1, R696.1
HV433: JP346.5, Q348.3, R696.2
HV434: JP346.6, Q345.3, R690.2
HV435: JP350.1, Q350.3, R700.2
HV436: JP350.2, Q351.3, R702.2
HV437: JP350.3, R698.1, R700.1, R702.1, R704.1
HV438: JP350.5, Q352.3, R704.2
HV439: JP350.6, Q349.3, R698.2
HV440: JP354.1, Q354.3, R708.2
HV441: JP354.2, Q355.3, R710.2
HV442: JP354.3, R706.1, R708.1, R710.1, R712.1
HV443: JP354.5, Q356.3, R712.2
HV444: JP354.6, Q353.3, R706.2
HV445: JP358.1, Q358.3, R716.2
HV446: JP358.2, Q359.3, R718.2
HV447: JP358.3, R714.1, R716.1, R718.1, R720.1
HV448: JP358.5, Q360.3, R720.2
HV449: JP358.6, Q357.3, R714.2
HV450: JP362.1, Q362.3, R724.2
HV451: JP362.2, Q363.3, R726.2
HV452: JP362.3, R722.1, R724.1, R726.1, R728.1
HV453: JP362.5, Q364.3, R728.2
HV454: JP362.6, Q361.3, R722.2
HV455: JP366.1, Q366.3, R732.2
HV456: JP366.2, Q367.3, R734.2
HV457: JP366.3, R730.1, R732.1, R734.1, R736.1
HV458: JP366.5, Q368.3, R736.2
HV459: JP366.6, Q365.3, R730.2
HV460: JP370.1, Q370.3, R740.2
HV461: JP370.2, Q371.3, R742.2
HV462: JP370.3, R738.1, R740.1, R742.1, R744.1
HV463: JP370.5, Q372.3, R744.2
HV464: JP370.6, Q369.3, R738.2
HV465: JP374.1, Q374.3, R748.2
HV466: JP374.2, Q375.3, R750.2
HV467: JP374.3, R746.1, R748.1, R750.1, R752.1
HV468: JP374.5, Q376.3, R752.2
HV469: JP374.6, Q373.3, R746.2
HV470: JP378.1, Q378.3, R756.2
HV471: JP378.2, Q379.3, R758.2
HV472: JP378.3, R754.1, R756.1, R758.1, R760.1
HV473: JP378.5, Q380.3, R760.2
HV474: JP378.6, Q377.3, R754.2
HV475: JP382.1, Q382.3, R764.2
HV476: JP382.2, Q383.3, R766.2
HV477: JP382.3, R762.1, R764.1, R766.1, R768.1
HV478: JP382.5, Q384.3, R768.2
HV479: JP382.6, Q381.3, R762.2
HV480: JP386.1, Q386.3, R772.2
HV481: JP386.2, Q387.3, R774.2
HV482: JP386.3, R770.1, R772.1, R774.1, R776.1
HV483: JP386.5, Q388.3, R776.2
HV484: JP386.6, Q385.3, R770.2
HV485: JP390.1, Q390.3, R780.2
HV486: JP390.2, Q391.3, R782.2
HV487: JP390.3, R778.1, R780.1, R782.1, R784.1
HV488: JP390.5, Q392.3, R784.2
HV489: JP390.6, Q389.3, R778.2
HV490: JP394.1, Q394.3, R788.2
HV491: JP394.2, Q395.3, R790.2
HV492: JP394.3, R786.1, R788.1, R790.1, R792.1
HV493: JP394.5, Q396.3, R792.2
HV494: JP394.6, Q393.3, R786.2
HV495: JP398.1, Q398.3, R796.2
HV496: JP398.2, Q399.3, R798.2
HV497: JP398.3, R794.1, R796.1, R798.1, R800.1
HV498: JP398.5, Q400.3, R800.2
HV499: JP398.6, Q397.3, R794.2
HV500: JP402.1, Q402.3, R804.2
HV501: JP402.2, Q403.3, R806.2
HV502: JP402.3, R802.1, R804.1, R806.1, R808.1
HV503: JP402.5, Q404.3, R808.2
HV504: JP402.6, Q401.3, R802.2
HV505: JP406.1, Q406.3, R812.2
HV506: JP406.2, Q407.3, R814.2
HV507: JP406.3, R810.1, R812.1, R814.1, R816.1
HV508: JP406.5, Q408.3, R816.2
HV509: JP406.6, Q405.3, R810.2
HV510: JP410.1, Q410.3, R820.2
HV511: JP410.2, Q411.3, R822.2
HV512: JP410.3, R818.1, R820.1, R822.1, R824.1
HV513: JP410.5, Q412.3, R824.2
HV514: JP410.6, Q409.3, R818.2
HV515: JP414.1, Q414.3, R828.2
HV516: JP414.2, Q415.3, R830.2
HV517: JP414.3, R826.1, R828.1, R830.1, R832.1
HV518: JP414.5, Q416.3, R832.2
HV519: JP414.6, Q413.3, R826.2
HV520: JP418.1, Q418.3, R836.2
HV521: JP418.2, Q419.3, R838.2
HV522: JP418.3, R834.1, R836.1, R838.1, R840.1
HV523: JP418.5, Q420.3, R840.2
HV524: JP418.6, Q417.3, R834.2
HV525: JP422.1, Q422.3, R844.2
HV526: JP422.2, Q423.3, R846.2
HV527: JP422.3, R842.1, R844.1, R846.1, R848.1
HV528: JP422.5, Q424.3, R848.2
HV529: JP422.6, Q421.3, R842.2
HV530: JP426.1, Q426.3, R852.2
HV531: JP426.2, Q427.3, R854.2
HV532: JP426.3, R850.1, R852.1, R854.1, R856.1
HV533: JP426.5, Q428.3, R856.2
HV534: JP426.6, Q425.3, R850.2
HV535: JP430.1, Q430.3, R860.2
HV536: JP430.2, Q431.3, R862.2
HV537: JP430.3, R858.1, R860.1, R862.1, R864.1
HV538: JP430.5, Q432.3, R864.2
HV539: JP430.6, Q429.3, R858.2
HV540: JP434.1, Q434.3, R868.2
HV541: JP434.2, Q435.3, R870.2
HV542: JP434.3, R866.1, R868.1, R870.1, R872.1
HV543: JP434.5, Q436.3, R872.2
HV544: JP434.6, Q433.3, R866.2
HV545: JP438.1, Q438.3, R876.2
HV546: JP438.2, Q439.3, R878.2
HV547: JP438.3, R874.1, R876.1, R878.1, R880.1
HV548: JP438.5, Q440.3, R880.2
HV549: JP438.6, Q437.3, R874.2
HV550: JP442.1, Q442.3, R884.2
HV551: JP442.2, Q443.3, R886.2
HV552: JP442.3, R882.1, R884.1, R886.1, R888.1
HV553: JP442.5, Q444.3, R888.2
HV554: JP442.6, Q441.3, R882.2
HV555: JP446.1, Q446.3, R892.2
HV556: JP446.2, Q447.3, R894.2
HV557: JP446.3, R890.1, R892.1, R894.1, R896.1
HV558: JP446.5, Q448.3, R896.2
HV559: JP446.6, Q445.3, R890.2
HV560: JP450.1, Q450.3, R900.2
HV561: JP450.2, Q451.3, R902.2
HV562: JP450.3, R898.1, R900.1, R902.1, R904.1
HV563: JP450.5, Q452.3, R904.2
HV564: JP450.6, Q449.3, R898.2
HV565: JP454.1, Q454.3, R908.2
HV566: JP454.2, Q455.3, R910.2
HV567: JP454.3, R906.1, R908.1, R910.1, R912.1
HV568: JP454.5, Q456.3, R912.2
HV569: JP454.6, Q453.3, R906.2
HV570: JP458.1, Q458.3, R916.2
HV571: JP458.2, Q459.3, R918.2
HV572: JP458.3, R914.1, R916.1, R918.1, R920.1
HV573: JP458.5, Q460.3, R920.2
HV574: JP458.6, Q457.3, R914.2
HV575: JP462.1, Q462.3, R924.2
HV576: JP462.2, Q463.3, R926.2
HV577: JP462.3, R922.1, R924.1, R926.1, R928.1
HV578: JP462.5, Q464.3, R928.2
HV579: JP462.6, Q461.3, R922.2
HV580: JP466.1, Q466.3, R932.2
HV581: JP466.2, Q467.3, R934.2
HV582: JP466.3, R930.1, R932.1, R934.1, R936.1
HV583: JP466.5, Q468.3, R936.2
HV584: JP466.6, Q465.3, R930.2
HV585: JP470.1, Q470.3, R940.2
HV586: JP470.2, Q471.3, R942.2
HV587: JP470.3, R938.1, R940.1, R942.1, R944.1
HV588: JP470.5, Q472.3, R944.2
HV589: JP470.6, Q469.3, R938.2
HV590: JP474.1, Q474.3, R948.2
HV591: JP474.2, Q475.3, R950.2
HV592: JP474.3, R946.1, R948.1, R950.1, R952.1
HV593: JP474.5, Q476.3, R952.2
HV594: JP474.6, Q473.3, R946.2
HV595: JP478.1, Q478.3, R956.2
HV596: JP478.2, Q479.3, R958.2
HV597: JP478.3, R954.1, R956.1, R958.1, R960.1
HV598: JP478.5, Q480.3, R960.2
HV599: JP478.6, Q477.3, R954.2
HV600: JP482.1, Q482.3, R964.2
HV601: JP482.2, Q483.3, R966.2
HV602: JP482.3, R962.1, R964.1, R966.1, R968.1
HV603: JP482.5, Q484.3, R968.2
HV604: JP482.6, Q481.3, R962.2
HV605: JP486.1, Q486.3, R972.2
HV606: JP486.2, Q487.3, R974.2
HV607: JP486.3, R970.1, R972.1, R974.1, R976.1
HV608: JP486.5, Q488.3, R976.2
HV609: JP486.6, Q485.3, R970.2
HV610: JP490.1, Q490.3, R980.2
HV611: JP490.2, Q491.3, R982.2
HV612: JP490.3, R978.1, R980.1, R982.1, R984.1
HV613: JP490.5, Q492.3, R984.2
HV614: JP490.6, Q489.3, R978.2
HV615: JP494.1, Q494.3, R988.2
HV616: JP494.2, Q495.3, R990.2
HV617: JP494.3, R986.1, R988.1, R990.1, R992.1
HV618: JP494.5, Q496.3, R992.2
HV619: JP494.6, Q493.3, R986.2
HV620: JP498.1, Q498.3, R996.2
HV621: JP498.2, Q499.3, R998.2
HV622: JP498.3, R994.1, R996.1, R998.1, R1000.1
HV623: JP498.5, Q500.3, R1000.2
HV624: JP498.6, Q497.3, R994.2
HV625: JP502.1, Q502.3, R1004.2
HV626: JP502.2, Q503.3, R1006.2
HV627: JP502.3, R1002.1, R1004.1, R1006.1, R1008.1
HV628: JP502.5, Q504.3, R1008.2
HV629: JP502.6, Q501.3, R1002.2
HV630: JP506.1, Q506.3, R1012.2
HV631: JP506.2, Q507.3, R1014.2
HV632: JP506.3, R1010.1, R1012.1, R1014.1, R1016.1
HV633: JP506.5, Q508.3, R1016.2
HV634: JP506.6, Q505.3, R1010.2
HV635: JP510.1, Q510.3, R1020.2
HV636: JP510.2, Q511.3, R1022.2
HV637: JP510.3, R1018.1, R1020.1, R1022.1, R1024.1
HV638: JP510.5, Q512.3, R1024.2
HV639: JP510.6, Q509.3, R1018.2
HV640: JP514.1, Q514.3, R1028.2
HV641: JP514.2, Q515.3, R1030.2
HV642: JP514.3, R1026.1, R1028.1, R1030.1, R1032.1
HV643: JP514.5, Q516.3, R1032.2
HV644: JP514.6, Q513.3, R1026.2
HV645: JP518.1, Q518.3, R1036.2
HV646: JP518.2, Q519.3, R1038.2
HV647: JP518.3, R1034.1, R1036.1, R1038.1, R1040.1
HV648: JP518.5, Q520.3, R1040.2
HV649: JP518.6, Q517.3, R1034.2
HV650: JP522.1, Q522.3, R1044.2
HV651: JP522.2, Q523.3, R1046.2
HV652: JP522.3, R1042.1, R1044.1, R1046.1, R1048.1
HV653: JP522.5, Q524.3, R1048.2
HV654: JP522.6, Q521.3, R1042.2
HV655: JP526.1, Q526.3, R1052.2
HV656: JP526.2, Q527.3, R1054.2
HV657: JP526.3, R1050.1, R1052.1, R1054.1, R1056.1
HV658: JP526.5, Q528.3, R1056.2
HV659: JP526.6, Q525.3, R1050.2
HV660: JP530.1, Q530.3, R1060.2
HV661: JP530.2, Q531.3, R1062.2
HV662: JP530.3, R1058.1, R1060.1, R1062.1, R1064.1
HV663: JP530.5, Q532.3, R1064.2
HV664: JP530.6, Q529.3, R1058.2
HV665: JP534.1, Q534.3, R1068.2
HV666: JP534.2, Q535.3, R1070.2
HV667: JP534.3, R1066.1, R1068.1, R1070.1, R1072.1
HV668: JP534.5, Q536.3, R1072.2
HV669: JP534.6, Q533.3, R1066.2
HV670: JP538.1, Q538.3, R1076.2
HV671: JP538.2, Q539.3, R1078.2
HV672: JP538.3, R1074.1, R1076.1, R1078.1, R1080.1
HV673: JP538.5, Q540.3, R1080.2
HV674: JP538.6, Q537.3, R1074.2
HV675: JP542.1, Q542.3, R1084.2
HV676: JP542.2, Q543.3, R1086.2
HV677: JP542.3, R1082.1, R1084.1, R1086.1, R1088.1
HV678: JP542.5, Q544.3, R1088.2
HV679: JP542.6, Q541.3, R1082.2
HV680: JP546.1, Q546.3, R1092.2
HV681: JP546.2, Q547.3, R1094.2
HV682: JP546.3, R1090.1, R1092.1, R1094.1, R1096.1
HV683: JP546.5, Q548.3, R1096.2
HV684: JP546.6, Q545.3, R1090.2
HV685: JP550.1, Q550.3, R1100.2
HV686: JP550.2, Q551.3, R1102.2
HV687: JP550.3, R1098.1, R1100.1, R1102.1, R1104.1
HV688: JP550.5, Q552.3, R1104.2
HV689: JP550.6, Q549.3, R1098.2
HV690: JP554.1, Q554.3, R1108.2
HV691: JP554.2, Q555.3, R1110.2
HV692: JP554.3, R1106.1, R1108.1, R1110.1, R1112.1
HV693: JP554.5, Q556.3, R1112.2
HV694: JP554.6, Q553.3, R1106.2
HV695: JP558.1, Q558.3, R1116.2
HV696: JP558.2, Q559.3, R1118.2
HV697: JP558.3, R1114.1, R1116.1, R1118.1, R1120.1
HV698: JP558.5, Q560.3, R1120.2
HV699: JP558.6, Q557.3, R1114.2
HV700: JP562.1, Q562.3, R1124.2
HV701: JP562.2, Q563.3, R1126.2
HV702: JP562.3, R1122.1, R1124.1, R1126.1, R1128.1
HV703: JP562.5, Q564.3, R1128.2
HV704: JP562.6, Q561.3, R1122.2
HV705: JP566.1, Q566.3, R1132.2
HV706: JP566.2, Q567.3, R1134.2
HV707: JP566.3, R1130.1, R1132.1, R1134.1, R1136.1
HV708: JP566.5, Q568.3, R1136.2
HV709: JP566.6, Q565.3, R1130.2
HV710: JP570.1, Q570.3, R1140.2
HV711: JP570.2, Q571.3, R1142.2
HV712: JP570.3, R1138.1, R1140.1, R1142.1, R1144.1
HV713: JP570.5, Q572.3, R1144.2
HV714: JP570.6, Q569.3, R1138.2
HV715: JP574.1, Q574.3, R1148.2
HV716: JP574.2, Q575.3, R1150.2
HV717: JP574.3, R1146.1, R1148.1, R1150.1, R1152.1
HV718: JP574.5, Q576.3, R1152.2
HV719: JP574.6, Q573.3, R1146.2
HV720: JP578.1, Q578.3, R1156.2
HV721: JP578.2, Q579.3, R1158.2
HV722: JP578.3, R1154.1, R1156.1, R1158.1, R1160.1
HV723: JP578.5, Q580.3, R1160.2
HV724: JP578.6, Q577.3, R1154.2
HV725: JP582.1, Q582.3, R1164.2
HV726: JP582.2, Q583.3, R1166.2
HV727: JP582.3, R1162.1, R1164.1, R1166.1, R1168.1
HV728: JP582.5, Q584.3, R1168.2
HV729: JP582.6, Q581.3, R1162.2
HV730: JP586.1, Q586.3, R1172.2
HV731: JP586.2, Q587.3, R1174.2
HV732: JP586.3, R1170.1, R1172.1, R1174.1, R1176.1
HV733: JP586.5, Q588.3, R1176.2
HV734: JP586.6, Q585.3, R1170.2
HV735: JP590.1, Q590.3, R1180.2
HV736: JP590.2, Q591.3, R1182.2
HV737: JP590.3, R1178.1, R1180.1, R1182.1, R1184.1
HV738: JP590.5, Q592.3, R1184.2
HV739: JP590.6, Q589.3, R1178.2
HV740: JP594.1, Q594.3, R1188.2
HV741: JP594.2, Q595.3, R1190.2
HV742: JP594.3, R1186.1, R1188.1, R1190.1, R1192.1
HV743: JP594.5, Q596.3, R1192.2
HV744: JP594.6, Q593.3, R1186.2
HV745: JP598.1, Q598.3, R1196.2
HV746: JP598.2, Q599.3, R1198.2
HV747: JP598.3, R1194.1, R1196.1, R1198.1, R1200.1
HV748: JP598.5, Q600.3, R1200.2
HV749: JP598.6, Q597.3, R1194.2
HV750: JP602.1, Q602.3, R1204.2
HV751: JP602.2, Q603.3, R1206.2
HV752: JP602.3, R1202.1, R1204.1, R1206.1, R1208.1
HV753: JP602.5, Q604.3, R1208.2
HV754: JP602.6, Q601.3, R1202.2
HV755: JP606.1, Q606.3, R1212.2
HV756: JP606.2, Q607.3, R1214.2
HV757: JP606.3, R1210.1, R1212.1, R1214.1, R1216.1
HV758: JP606.5, Q608.3, R1216.2
HV759: JP606.6, Q605.3, R1210.2
HV760: JP610.1, Q610.3, R1220.2
HV761: JP610.2, Q611.3, R1222.2
HV762: JP610.3, R1218.1, R1220.1, R1222.1, R1224.1
HV763: JP610.5, Q612.3, R1224.2
HV764: JP610.6, Q609.3, R1218.2
HV765: JP614.1, Q614.3, R1228.2
HV766: JP614.2, Q615.3, R1230.2
HV767: JP614.3, R1226.1, R1228.1, R1230.1, R1232.1
HV768: JP614.5, Q616.3, R1232.2
HV769: JP614.6, Q613.3, R1226.2
HV770: JP618.1, Q618.3, R1236.2
HV771: JP618.2, Q619.3, R1238.2
HV772: JP618.3, R1234.1, R1236.1, R1238.1, R1240.1
HV773: JP618.5, Q620.3, R1240.2
HV774: JP618.6, Q617.3, R1234.2
HV775: JP622.1, Q622.3, R1244.2
HV776: JP622.2, Q623.3, R1246.2
HV777: JP622.3, R1242.1, R1244.1, R1246.1, R1248.1
HV778: JP622.5, Q624.3, R1248.2
HV779: JP622.6, Q621.3, R1242.2
HV780: JP626.1, Q626.3, R1252.2
HV781: JP626.2, Q627.3, R1254.2
HV782: JP626.3, R1250.1, R1252.1, R1254.1, R1256.1
HV783: JP626.5, Q628.3, R1256.2
HV784: JP626.6, Q625.3, R1250.2
HV785: JP630.1, Q630.3, R1260.2
HV786: JP630.2, Q631.3, R1262.2
HV787: JP630.3, R1258.1, R1260.1, R1262.1, R1264.1
HV788: JP630.5, Q632.3, R1264.2
HV789: JP630.6, Q629.3, R1258.2
HV790: JP634.1, Q634.3, R1268.2
HV791: JP634.2, Q635.3, R1270.2
HV792: JP634.3, R1266.1, R1268.1, R1270.1, R1272.1
HV793: JP634.5, Q636.3, R1272.2
HV794: JP634.6, Q633.3, R1266.2
HV795: JP638.1, Q638.3, R1276.2
HV796: JP638.2, Q639.3, R1278.2
HV797: JP638.3, R1274.1, R1276.1, R1278.1, R1280.1
HV798: JP638.5, Q640.3, R1280.2
HV799: JP638.6, Q637.3, R1274.2
HV800: JP642.1, Q642.3, R1284.2
HV801: JP642.2, Q643.3, R1286.2
HV802: JP642.3, R1282.1, R1284.1, R1286.1, R1288.1
HV803: JP642.5, Q644.3, R1288.2
HV804: JP642.6, Q641.3, R1282.2
HV805: JP646.1, Q646.3, R1292.2
HV806: JP646.2, Q647.3, R1294.2
HV807: JP646.3, R1290.1, R1292.1, R1294.1, R1296.1
HV808: JP646.5, Q648.3, R1296.2
HV809: JP646.6, Q645.3, R1290.2
HV810: JP650.1, Q650.3, R1300.2
HV811: JP650.2, Q651.3, R1302.2
HV812: JP650.3, R1298.1, R1300.1, R1302.1, R1304.1
HV813: JP650.5, Q652.3, R1304.2
HV814: JP650.6, Q649.3, R1298.2
HV815: JP654.1, Q654.3, R1308.2
HV816: JP654.2, Q655.3, R1310.2
HV817: JP654.3, R1306.1, R1308.1, R1310.1, R1312.1
HV818: JP654.5, Q656.3, R1312.2
HV819: JP654.6, Q653.3, R1306.2
HV820: JP658.1, Q658.3, R1316.2
HV821: JP658.2, Q659.3, R1318.2
HV822: JP658.3, R1314.1, R1316.1, R1318.1, R1320.1
HV823: JP658.5, Q660.3, R1320.2
HV824: JP658.6, Q657.3, R1314.2
HV825: JP662.1, Q662.3, R1324.2
HV826: JP662.2, Q663.3, R1326.2
HV827: JP662.3, R1322.1, R1324.1, R1326.1, R1328.1
HV828: JP662.5, Q664.3, R1328.2
HV829: JP662.6, Q661.3, R1322.2
HV830: JP666.1, Q666.3, R1332.2
HV831: JP666.2, Q667.3, R1334.2
HV832: JP666.3, R1330.1, R1332.1, R1334.1, R1336.1
HV833: JP666.5, Q668.3, R1336.2
HV834: JP666.6, Q665.3, R1330.2
HV835: JP670.1, Q670.3, R1340.2
HV836: JP670.2, Q671.3, R1342.2
HV837: JP670.3, R1338.1, R1340.1, R1342.1, R1344.1
HV838: JP670.5, Q672.3, R1344.2
HV839: JP670.6, Q669.3, R1338.2
HV840: JP674.1, Q674.3, R1348.2
HV841: JP674.2, Q675.3, R1350.2
HV842: JP674.3, R1346.1, R1348.1, R1350.1, R1352.1
HV843: JP674.5, Q676.3, R1352.2
HV844: JP674.6, Q673.3, R1346.2
HV845: JP678.1, Q678.3, R1356.2
HV846: JP678.2, Q679.3, R1358.2
HV847: JP678.3, R1354.1, R1356.1, R1358.1, R1360.1
HV848: JP678.5, Q680.3, R1360.2
HV849: JP678.6, Q677.3, R1354.2
HV850: JP682.1, Q682.3, R1364.2
HV851: JP682.2, Q683.3, R1366.2
HV852: JP682.3, R1362.1, R1364.1, R1366.1, R1368.1
HV853: JP682.5, Q684.3, R1368.2
HV854: JP682.6, Q681.3, R1362.2
HV855: JP686.1, Q686.3, R1372.2
HV856: JP686.2, Q687.3, R1374.2
HV857: JP686.3, R1370.1, R1372.1, R1374.1, R1376.1
HV858: JP686.5, Q688.3, R1376.2
HV859: JP686.6, Q685.3, R1370.2
HV860: JP690.1, Q690.3, R1380.2
HV861: JP690.2, Q691.3, R1382.2
HV862: JP690.3, R1378.1, R1380.1, R1382.1, R1384.1
HV863: JP690.5, Q692.3, R1384.2
HV864: JP690.6, Q689.3, R1378.2
HV865: JP694.1, Q694.3, R1388.2
HV866: JP694.2, Q695.3, R1390.2
HV867: JP694.3, R1386.1, R1388.1, R1390.1, R1392.1
HV868: JP694.5, Q696.3, R1392.2
HV869: JP694.6, Q693.3, R1386.2
HV870: JP698.1, Q698.3, R1396.2
HV871: JP698.2, Q699.3, R1398.2
HV872: JP698.3, R1394.1, R1396.1, R1398.1, R1400.1
HV873: JP698.5, Q700.3, R1400.2
HV874: JP698.6, Q697.3, R1394.2
HV875: JP702.1, Q702.3, R1404.2
HV876: JP702.2, Q703.3, R1406.2
HV877: JP702.3, R1402.1, R1404.1, R1406.1, R1408.1
HV878: JP702.5, Q704.3, R1408.2
HV879: JP702.6, Q701.3, R1402.2
HV880: JP706.1, Q706.3, R1412.2
HV881: JP706.2, Q707.3, R1414.2
HV882: JP706.3, R1410.1, R1412.1, R1414.1, R1416.1
HV883: JP706.5, Q708.3, R1416.2
HV884: JP706.6, Q705.3, R1410.2
HV885: JP710.1, Q710.3, R1420.2
HV886: JP710.2, Q711.3, R1422.2
HV887: JP710.3, R1418.1, R1420.1, R1422.1, R1424.1
HV888: JP710.5, Q712.3, R1424.2
HV889: JP710.6, Q709.3, R1418.2
HV890: JP714.1, Q714.3, R1428.2
HV891: JP714.2, Q715.3, R1430.2
HV892: JP714.3, R1426.1, R1428.1, R1430.1, R1432.1
HV893: JP714.5, Q716.3, R1432.2
HV894: JP714.6, Q713.3, R1426.2
HV895: JP718.1, Q718.3, R1436.2
HV896: JP718.2, Q719.3, R1438.2
HV897: JP718.3, R1434.1, R1436.1, R1438.1, R1440.1
HV898: JP718.5, Q720.3, R1440.2
HV899: JP718.6, Q717.3, R1434.2
HV900: JP722.1, Q722.3, R1444.2
HV901: JP722.2, Q723.3, R1446.2
HV902: JP722.3, R1442.1, R1444.1, R1446.1, R1448.1
HV903: JP722.5, Q724.3, R1448.2
HV904: JP722.6, Q721.3, R1442.2
HV905: JP726.1, Q726.3, R1452.2
HV906: JP726.2, Q727.3, R1454.2
HV907: JP726.3, R1450.1, R1452.1, R1454.1, R1456.1
HV908: JP726.5, Q728.3, R1456.2
HV909: JP726.6, Q725.3, R1450.2
HV910: JP730.1, Q730.3, R1460.2
HV911: JP730.2, Q731.3, R1462.2
HV912: JP730.3, R1458.1, R1460.1, R1462.1, R1464.1
HV913: JP730.5, Q732.3, R1464.2
HV914: JP730.6, Q729.3, R1458.2
HV915: JP734.1, Q734.3, R1468.2
HV916: JP734.2, Q735.3, R1470.2
HV917: JP734.3, R1466.1, R1468.1, R1470.1, R1472.1
HV918: JP734.5, Q736.3, R1472.2
HV919: JP734.6, Q733.3, R1466.2
HV920: JP738.1, Q738.3, R1476.2
HV921: JP738.2, Q739.3, R1478.2
HV922: JP738.3, R1474.1, R1476.1, R1478.1, R1480.1
HV923: JP738.5, Q740.3, R1480.2
HV924: JP738.6, Q737.3, R1474.2
HV925: JP742.1, Q742.3, R1484.2
HV926: JP742.2, Q743.3, R1486.2
HV927: JP742.3, R1482.1, R1484.1, R1486.1, R1488.1
HV928: JP742.5, Q744.3, R1488.2
HV929: JP742.6, Q741.3, R1482.2
HV930: JP746.1, Q746.3, R1492.2
HV931: JP746.2, Q747.3, R1494.2
HV932: JP746.3, R1490.1, R1492.1, R1494.1, R1496.1
HV933: JP746.5, Q748.3, R1496.2
HV934: JP746.6, Q745.3, R1490.2
HV935: JP750.1, Q750.3, R1500.2
HV936: JP750.2, Q751.3, R1502.2
HV937: JP750.3, R1498.1, R1500.1, R1502.1, R1504.1
HV938: JP750.5, Q752.3, R1504.2
HV939: JP750.6, Q749.3, R1498.2
HV940: JP754.1, Q754.3, R1508.2
HV941: JP754.2, Q755.3, R1510.2
HV942: JP754.3, R1506.1, R1508.1, R1510.1, R1512.1
HV943: JP754.5, Q756.3, R1512.2
HV944: JP754.6, Q753.3, R1506.2
HV945: JP758.1, Q758.3, R1516.2
HV946: JP758.2, Q759.3, R1518.2
HV947: JP758.3, R1514.1, R1516.1, R1518.1, R1520.1
HV948: JP758.5, Q760.3, R1520.2
HV949: JP758.6, Q757.3, R1514.2
HV950: JP762.1, Q762.3, R1524.2
HV951: JP762.2, Q763.3, R1526.2
HV952: JP762.3, R1522.1, R1524.1, R1526.1, R1528.1
HV953: JP762.5, Q764.3, R1528.2
HV954: JP762.6, Q761.3, R1522.2
HV955: JP766.1, Q766.3, R1532.2
HV956: JP766.2, Q767.3, R1534.2
HV957: JP766.3, R1530.1, R1532.1, R1534.1, R1536.1
HV958: JP766.5, Q768.3, R1536.2
HV959: JP766.6, Q765.3, R1530.2
HV960: JP770.1, Q770.3, R1540.2
HV961: JP770.2, Q771.3, R1542.2
HV962: JP770.3, R1538.1, R1540.1, R1542.1, R1544.1
HV963: JP770.5, Q772.3, R1544.2
HV964: JP770.6, Q769.3, R1538.2
HV965: JP774.1, Q774.3, R1548.2
HV966: JP774.2, Q775.3, R1550.2
HV967: JP774.3, R1546.1, R1548.1, R1550.1, R1552.1
HV968: JP774.5, Q776.3, R1552.2
HV969: JP774.6, Q773.3, R1546.2
HV970: JP778.1, Q778.3, R1556.2
HV971: JP778.2, Q779.3, R1558.2
HV972: JP778.3, R1554.1, R1556.1, R1558.1, R1560.1
HV973: JP778.5, Q780.3, R1560.2
HV974: JP778.6, Q777.3, R1554.2
HV975: JP782.1, Q782.3, R1564.2
HV976: JP782.2, Q783.3, R1566.2
HV977: JP782.3, R1562.1, R1564.1, R1566.1, R1568.1
HV978: JP782.5, Q784.3, R1568.2
HV979: JP782.6, Q781.3, R1562.2
HV980: JP786.1, Q786.3, R1572.2
HV981: JP786.2, Q787.3, R1574.2
HV982: JP786.3, R1570.1, R1572.1, R1574.1, R1576.1
HV983: JP786.5, Q788.3, R1576.2
HV984: JP786.6, Q785.3, R1570.2
HV985: JP790.1, Q790.3, R1580.2
HV986: JP790.2, Q791.3, R1582.2
HV987: JP790.3, R1578.1, R1580.1, R1582.1, R1584.1
HV988: JP790.5, Q792.3, R1584.2
HV989: JP790.6, Q789.3, R1578.2
HV990: JP794.1, Q794.3, R1588.2
HV991: JP794.2, Q795.3, R1590.2
HV992: JP794.3, R1586.1, R1588.1, R1590.1, R1592.1
HV993: JP794.5, Q796.3, R1592.2
HV994: JP794.6, Q793.3, R1586.2
HV995: JP798.1, Q798.3, R1596.2
HV996: JP798.2, Q799.3, R1598.2
HV997: JP798.3, R1594.1, R1596.1, R1598.1, R1600.1
HV998: JP798.5, Q800.3, R1600.2
HV999: JP798.6, Q797.3, R1594.2
HV1000: JP802.1, Q802.3, R1604.2
HV1001: JP802.2, Q803.3, R1606.2
HV1002: JP802.3, R1602.1, R1604.1, R1606.1, R1608.1
HV1003: JP802.5, Q804.3, R1608.2
HV1004: JP802.6, Q801.3, R1602.2
HV1005: JP806.1, Q806.3, R1612.2
HV1006: JP806.2, Q807.3, R1614.2
HV1007: JP806.3, R1610.1, R1612.1, R1614.1, R1616.1
HV1008: JP806.5, Q808.3, R1616.2
HV1009: JP806.6, Q805.3, R1610.2
HV1010: JP810.1, Q810.3, R1620.2
HV1011: JP810.2, Q811.3, R1622.2
HV1012: JP810.3, R1618.1, R1620.1, R1622.1, R1624.1
HV1013: JP810.5, Q812.3, R1624.2
HV1014: JP810.6, Q809.3, R1618.2
HV1015: JP814.1, Q814.3, R1628.2
HV1016: JP814.2, Q815.3, R1630.2
HV1017: JP814.3, R1626.1, R1628.1, R1630.1, R1632.1
HV1018: JP814.5, Q816.3, R1632.2
HV1019: JP814.6, Q813.3, R1626.2
HV1020: JP818.1, Q818.3, R1636.2
HV1021: JP818.2, Q819.3, R1638.2
HV1022: JP818.3, R1634.1, R1636.1, R1638.1, R1640.1
HV1023: JP818.5, Q820.3, R1640.2
HV1024: JP818.6, Q817.3, R1634.2
HV1025: JP822.1, Q822.3, R1644.2
HV1026: JP822.2, Q823.3, R1646.2
HV1027: JP822.3, R1642.1, R1644.1, R1646.1, R1648.1
HV1028: JP822.5, Q824.3, R1648.2
HV1029: JP822.6, Q821.3, R1642.2
HV1030: JP826.1, Q826.3, R1652.2
HV1031: JP826.2, Q827.3, R1654.2
HV1032: JP826.3, R1650.1, R1652.1, R1654.1, R1656.1
HV1033: JP826.5, Q828.3, R1656.2
HV1034: JP826.6, Q825.3, R1650.2
HV1035: JP830.1, Q830.3, R1660.2
HV1036: JP830.2, Q831.3, R1662.2
HV1037: JP830.3, R1658.1, R1660.1, R1662.1, R1664.1
HV1038: JP830.5, Q832.3, R1664.2
HV1039: JP830.6, Q829.3, R1658.2
HV1040: JP834.1, Q834.3, R1668.2
HV1041: JP834.2, Q835.3, R1670.2
HV1042: JP834.3, R1666.1, R1668.1, R1670.1, R1672.1
HV1043: JP834.5, Q836.3, R1672.2
HV1044: JP834.6, Q833.3, R1666.2
HV1045: JP838.1, Q838.3, R1676.2
HV1046: JP838.2, Q839.3, R1678.2
HV1047: JP838.3, R1674.1, R1676.1, R1678.1, R1680.1
HV1048: JP838.5, Q840.3, R1680.2
HV1049: JP838.6, Q837.3, R1674.2
HV1050: JP842.1, Q842.3, R1684.2
HV1051: JP842.2, Q843.3, R1686.2
HV1052: JP842.3, R1682.1, R1684.1, R1686.1, R1688.1
HV1053: JP842.5, Q844.3, R1688.2
HV1054: JP842.6, Q841.3, R1682.2
HV1055: JP846.1, Q846.3, R1692.2
HV1056: JP846.2, Q847.3, R1694.2
HV1057: JP846.3, R1690.1, R1692.1, R1694.1, R1696.1
HV1058: JP846.5, Q848.3, R1696.2
HV1059: JP846.6, Q845.3, R1690.2
HV1060: JP850.1, Q850.3, R1700.2
HV1061: JP850.2, Q851.3, R1702.2
HV1062: JP850.3, R1698.1, R1700.1, R1702.1, R1704.1
HV1063: JP850.5, Q852.3, R1704.2
HV1064: JP850.6, Q849.3, R1698.2
HV1065: JP854.1, Q854.3, R1708.2
HV1066: JP854.2, Q855.3, R1710.2
HV1067: JP854.3, R1706.1, R1708.1, R1710.1, R1712.1
HV1068: JP854.5, Q856.3, R1712.2
HV1069: JP854.6, Q853.3, R1706.2
HV1070: JP858.1, Q858.3, R1716.2
HV1071: JP858.2, Q859.3, R1718.2
HV1072: JP858.3, R1714.1, R1716.1, R1718.1, R1720.1
HV1073: JP858.5, Q860.3, R1720.2
HV1074: JP858.6, Q857.3, R1714.2
HV1075: JP862.1, Q862.3, R1724.2
HV1076: JP862.2, Q863.3, R1726.2
HV1077: JP862.3, R1722.1, R1724.1, R1726.1, R1728.1
HV1078: JP862.5, Q864.3, R1728.2
HV1079: JP862.6, Q861.3, R1722.2
HV1080: JP866.1, Q866.3, R1732.2
HV1081: JP866.2, Q867.3, R1734.2
HV1082: JP866.3, R1730.1, R1732.1, R1734.1, R1736.1
HV1083: JP866.5, Q868.3, R1736.2
HV1084: JP866.6, Q865.3, R1730.2
HV1085: JP870.1, Q870.3, R1740.2
HV1086: JP870.2, Q871.3, R1742.2
HV1087: JP870.3, R1738.1, R1740.1, R1742.1, R1744.1
HV1088: JP870.5, Q872.3, R1744.2
HV1089: JP870.6, Q869.3, R1738.2
HV1090: JP874.1, Q874.3, R1748.2
HV1091: JP874.2, Q875.3, R1750.2
HV1092: JP874.3, R1746.1, R1748.1, R1750.1, R1752.1
HV1093: JP874.5, Q876.3, R1752.2
HV1094: JP874.6, Q873.3, R1746.2
HV1095: JP878.1, Q878.3, R1756.2
HV1096: JP878.2, Q879.3, R1758.2
HV1097: JP878.3, R1754.1, R1756.1, R1758.1, R1760.1
HV1098: JP878.5, Q880.3, R1760.2
HV1099: JP878.6, Q877.3, R1754.2
HV1100: JP882.1, Q882.3, R1764.2
HV1101: JP882.2, Q883.3, R1766.2
HV1102: JP882.3, R1762.1, R1764.1, R1766.1, R1768.1
HV1103: JP882.5, Q884.3, R1768.2
HV1104: JP882.6, Q881.3, R1762.2
HV1105: JP886.1, Q886.3, R1772.2
HV1106: JP886.2, Q887.3, R1774.2
HV1107: JP886.3, R1770.1, R1772.1, R1774.1, R1776.1
HV1108: JP886.5, Q888.3, R1776.2
HV1109: JP886.6, Q885.3, R1770.2
HV1110: JP890.1, Q890.3, R1780.2
HV1111: JP890.2, Q891.3, R1782.2
HV1112: JP890.3, R1778.1, R1780.1, R1782.1, R1784.1
HV1113: JP890.5, Q892.3, R1784.2
HV1114: JP890.6, Q889.3, R1778.2
HV1115: JP894.1, Q894.3, R1788.2
HV1116: JP894.2, Q895.3, R1790.2
HV1117: JP894.3, R1786.1, R1788.1, R1790.1, R1792.1
HV1118: JP894.5, Q896.3, R1792.2
HV1119: JP894.6, Q893.3, R1786.2
LV: JP1.4, Q1.1, Q2.1, Q3.1, Q4.1, R1.1, R2.1, R3.1, R6.1
LV1: JP1.6, Q1.2, R3.2
LV2: JP1.5, Q3.2, R2.2
LV3: JP1.2, Q4.2, R1.2
LV4: JP1.1, Q2.2, R6.2
LV5: JP5.4, Q5.1, Q6.1, Q7.1, Q8.1, R8.1, R11.1, R13.1, R15.1
LV6: JP5.5, Q7.2, R13.2
LV7: JP5.6, Q6.2, R11.2
LV8: JP5.1, Q5.2, R8.2
LV9: JP5.2, Q8.2, R15.2
LV10: JP9.4, Q9.1, Q10.1, Q11.1, Q12.1, R17.1, R19.1, R21.1, R23.1
LV11: JP9.5, Q11.2, R21.2
LV12: JP9.6, Q10.2, R19.2
LV13: JP9.1, Q9.2, R17.2
LV14: JP9.2, Q12.2, R23.2
LV15: JP13.4, Q13.1, Q14.1, Q15.1, Q16.1, R25.1, R27.1, R29.1, R31.1
LV16: JP13.5, Q15.2, R29.2
LV17: JP13.6, Q14.2, R27.2
LV18: JP13.1, Q13.2, R25.2
LV19: JP13.2, Q16.2, R31.2
LV20: JP17.4, Q17.1, Q18.1, Q19.1, Q20.1, R33.1, R35.1, R37.1, R39.1
LV21: JP17.5, Q19.2, R37.2
LV22: JP17.6, Q18.2, R35.2
LV23: JP17.1, Q17.2, R33.2
LV24: JP17.2, Q20.2, R39.2
LV25: JP21.4, Q21.1, Q22.1, Q23.1, Q24.1, R41.1, R43.1, R45.1, R47.1
LV26: JP21.5, Q23.2, R45.2
LV27: JP21.6, Q22.2, R43.2
LV28: JP21.1, Q21.2, R41.2
LV29: JP21.2, Q24.2, R47.2
LV30: JP25.4, Q25.1, Q26.1, Q27.1, Q28.1, R49.1, R51.1, R53.1, R55.1
LV31: JP25.5, Q27.2, R53.2
LV32: JP25.6, Q26.2, R51.2
LV33: JP25.1, Q25.2, R49.2
LV34: JP25.2, Q28.2, R55.2
LV35: JP29.4, Q29.1, Q30.1, Q31.1, Q32.1, R57.1, R59.1, R61.1, R63.1
LV36: JP29.5, Q31.2, R61.2
LV37: JP29.6, Q30.2, R59.2
LV38: JP29.1, Q29.2, R57.2
LV39: JP29.2, Q32.2, R63.2
LV40: JP33.4, Q33.1, Q34.1, Q35.1, Q36.1, R65.1, R67.1, R69.1, R71.1
LV41: JP33.5, Q35.2, R69.2
LV42: JP33.6, Q34.2, R67.2
LV43: JP33.1, Q33.2, R65.2
LV44: JP33.2, Q36.2, R71.2
LV45: JP37.4, Q37.1, Q38.1, Q39.1, Q40.1, R73.1, R75.1, R77.1, R79.1
LV46: JP37.5, Q39.2, R77.2
LV47: JP37.6, Q38.2, R75.2
LV48: JP37.1, Q37.2, R73.2
LV49: JP37.2, Q40.2, R79.2
LV50: JP41.4, Q41.1, Q42.1, Q43.1, Q44.1, R81.1, R83.1, R85.1, R87.1
LV51: JP41.5, Q43.2, R85.2
LV52: JP41.6, Q42.2, R83.2
LV53: JP41.1, Q41.2, R81.2
LV54: JP41.2, Q44.2, R87.2
LV55: JP45.4, Q45.1, Q46.1, Q47.1, Q48.1, R89.1, R91.1, R93.1, R95.1
LV56: JP45.5, Q47.2, R93.2
LV57: JP45.6, Q46.2, R91.2
LV58: JP45.1, Q45.2, R89.2
LV59: JP45.2, Q48.2, R95.2
LV60: JP49.4, Q49.1, Q50.1, Q51.1, Q52.1, R97.1, R99.1, R101.1, R103.1
LV61: JP49.5, Q51.2, R101.2
LV62: JP49.6, Q50.2, R99.2
LV63: JP49.1, Q49.2, R97.2
LV64: JP49.2, Q52.2, R103.2
LV65: JP53.4, Q53.1, Q54.1, Q55.1, Q56.1, R105.1, R107.1, R109.1, R111.1
LV66: JP53.5, Q55.2, R109.2
LV67: JP53.6, Q54.2, R107.2
LV68: JP53.1, Q53.2, R105.2
LV69: JP53.2, Q56.2, R111.2
LV70: JP57.4, Q57.1, Q58.1, Q59.1, Q60.1, R113.1, R115.1, R117.1, R119.1
LV71: JP57.5, Q59.2, R117.2
LV72: JP57.6, Q58.2, R115.2
LV73: JP57.1, Q57.2, R113.2
LV74: JP57.2, Q60.2, R119.2
LV75: JP61.4, Q61.1, Q62.1, Q63.1, Q64.1, R121.1, R123.1, R125.1, R127.1
LV76: JP61.5, Q63.2, R125.2
LV77: JP61.6, Q62.2, R123.2
LV78: JP61.1, Q61.2, R121.2
LV79: JP61.2, Q64.2, R127.2
LV80: JP65.4, Q65.1, Q66.1, Q67.1, Q68.1, R129.1, R131.1, R133.1, R135.1
LV81: JP65.5, Q67.2, R133.2
LV82: JP65.6, Q66.2, R131.2
LV83: JP65.1, Q65.2, R129.2
LV84: JP65.2, Q68.2, R135.2
LV85: JP69.4, Q69.1, Q70.1, Q71.1, Q72.1, R137.1, R139.1, R141.1, R143.1
LV86: JP69.5, Q71.2, R141.2
LV87: JP69.6, Q70.2, R139.2
LV88: JP69.1, Q69.2, R137.2
LV89: JP69.2, Q72.2, R143.2
LV90: JP73.4, Q73.1, Q74.1, Q75.1, Q76.1, R145.1, R147.1, R149.1, R151.1
LV91: JP73.5, Q75.2, R149.2
LV92: JP73.6, Q74.2, R147.2
LV93: JP73.1, Q73.2, R145.2
LV94: JP73.2, Q76.2, R151.2
LV95: JP77.4, Q77.1, Q78.1, Q79.1, Q80.1, R153.1, R155.1, R157.1, R159.1
LV96: JP77.5, Q79.2, R157.2
LV97: JP77.6, Q78.2, R155.2
LV98: JP77.1, Q77.2, R153.2
LV99: JP77.2, Q80.2, R159.2
LV100: JP81.4, Q81.1, Q82.1, Q83.1, Q84.1, R161.1, R163.1, R165.1, R167.1
LV101: JP81.5, Q83.2, R165.2
LV102: JP81.6, Q82.2, R163.2
LV103: JP81.1, Q81.2, R161.2
LV104: JP81.2, Q84.2, R167.2
LV105: JP85.4, Q85.1, Q86.1, Q87.1, Q88.1, R169.1, R171.1, R173.1, R175.1
LV106: JP85.5, Q87.2, R173.2
LV107: JP85.6, Q86.2, R171.2
LV108: JP85.1, Q85.2, R169.2
LV109: JP85.2, Q88.2, R175.2
LV110: JP89.4, Q89.1, Q90.1, Q91.1, Q92.1, R177.1, R179.1, R181.1, R183.1
LV111: JP89.5, Q91.2, R181.2
LV112: JP89.6, Q90.2, R179.2
LV113: JP89.1, Q89.2, R177.2
LV114: JP89.2, Q92.2, R183.2
LV115: JP93.4, Q93.1, Q94.1, Q95.1, Q96.1, R185.1, R187.1, R189.1, R191.1
LV116: JP93.5, Q95.2, R189.2
LV117: JP93.6, Q94.2, R187.2
LV118: JP93.1, Q93.2, R185.2
LV119: JP93.2, Q96.2, R191.2
LV120: JP97.4, Q97.1, Q98.1, Q99.1, Q100.1, R193.1, R195.1, R197.1, R199.1
LV121: JP97.5, Q99.2, R197.2
LV122: JP97.6, Q98.2, R195.2
LV123: JP97.1, Q97.2, R193.2
LV124: JP97.2, Q100.2, R199.2
LV125: JP101.4, Q101.1, Q102.1, Q103.1, Q104.1, R201.1, R203.1, R205.1, R207.1
LV126: JP101.5, Q103.2, R205.2
LV127: JP101.6, Q102.2, R203.2
LV128: JP101.1, Q101.2, R201.2
LV129: JP101.2, Q104.2, R207.2
LV130: JP105.4, Q105.1, Q106.1, Q107.1, Q108.1, R209.1, R211.1, R213.1, R215.1
LV131: JP105.5, Q107.2, R213.2
LV132: JP105.6, Q106.2, R211.2
LV133: JP105.1, Q105.2, R209.2
LV134: JP105.2, Q108.2, R215.2
LV135: JP109.4, Q109.1, Q110.1, Q111.1, Q112.1, R217.1, R219.1, R221.1, R223.1
LV136: JP109.5, Q111.2, R221.2
LV137: JP109.6, Q110.2, R219.2
LV138: JP109.1, Q109.2, R217.2
LV139: JP109.2, Q112.2, R223.2
LV140: JP113.4, Q113.1, Q114.1, Q115.1, Q116.1, R225.1, R227.1, R229.1, R231.1
LV141: JP113.5, Q115.2, R229.2
LV142: JP113.6, Q114.2, R227.2
LV143: JP113.1, Q113.2, R225.2
LV144: JP113.2, Q116.2, R231.2
LV145: JP117.4, Q117.1, Q118.1, Q119.1, Q120.1, R233.1, R235.1, R237.1, R239.1
LV146: JP117.5, Q119.2, R237.2
LV147: JP117.6, Q118.2, R235.2
LV148: JP117.1, Q117.2, R233.2
LV149: JP117.2, Q120.2, R239.2
LV150: JP121.4, Q121.1, Q122.1, Q123.1, Q124.1, R241.1, R243.1, R245.1, R247.1
LV151: JP121.5, Q123.2, R245.2
LV152: JP121.6, Q122.2, R243.2
LV153: JP121.1, Q121.2, R241.2
LV154: JP121.2, Q124.2, R247.2
LV155: JP125.4, Q125.1, Q126.1, Q127.1, Q128.1, R249.1, R251.1, R253.1, R255.1
LV156: JP125.5, Q127.2, R253.2
LV157: JP125.6, Q126.2, R251.2
LV158: JP125.1, Q125.2, R249.2
LV159: JP125.2, Q128.2, R255.2
LV160: JP129.4, Q129.1, Q130.1, Q131.1, Q132.1, R257.1, R259.1, R261.1, R263.1
LV161: JP129.5, Q131.2, R261.2
LV162: JP129.6, Q130.2, R259.2
LV163: JP129.1, Q129.2, R257.2
LV164: JP129.2, Q132.2, R263.2
LV165: JP133.4, Q133.1, Q134.1, Q135.1, Q136.1, R265.1, R267.1, R269.1, R271.1
LV166: JP133.5, Q135.2, R269.2
LV167: JP133.6, Q134.2, R267.2
LV168: JP133.1, Q133.2, R265.2
LV169: JP133.2, Q136.2, R271.2
LV170: JP137.4, Q137.1, Q138.1, Q139.1, Q140.1, R273.1, R275.1, R277.1, R279.1
LV171: JP137.5, Q139.2, R277.2
LV172: JP137.6, Q138.2, R275.2
LV173: JP137.1, Q137.2, R273.2
LV174: JP137.2, Q140.2, R279.2
LV175: JP141.4, Q141.1, Q142.1, Q143.1, Q144.1, R281.1, R283.1, R285.1, R287.1
LV176: JP141.5, Q143.2, R285.2
LV177: JP141.6, Q142.2, R283.2
LV178: JP141.1, Q141.2, R281.2
LV179: JP141.2, Q144.2, R287.2
LV180: JP145.4, Q145.1, Q146.1, Q147.1, Q148.1, R289.1, R291.1, R293.1, R295.1
LV181: JP145.5, Q147.2, R293.2
LV182: JP145.6, Q146.2, R291.2
LV183: JP145.1, Q145.2, R289.2
LV184: JP145.2, Q148.2, R295.2
LV185: JP149.4, Q149.1, Q150.1, Q151.1, Q152.1, R297.1, R299.1, R301.1, R303.1
LV186: JP149.5, Q151.2, R301.2
LV187: JP149.6, Q150.2, R299.2
LV188: JP149.1, Q149.2, R297.2
LV189: JP149.2, Q152.2, R303.2
LV190: JP153.4, Q153.1, Q154.1, Q155.1, Q156.1, R305.1, R307.1, R309.1, R311.1
LV191: JP153.5, Q155.2, R309.2
LV192: JP153.6, Q154.2, R307.2
LV193: JP153.1, Q153.2, R305.2
LV194: JP153.2, Q156.2, R311.2
LV195: JP157.4, Q157.1, Q158.1, Q159.1, Q160.1, R313.1, R315.1, R317.1, R319.1
LV196: JP157.5, Q159.2, R317.2
LV197: JP157.6, Q158.2, R315.2
LV198: JP157.1, Q157.2, R313.2
LV199: JP157.2, Q160.2, R319.2
LV200: JP161.4, Q161.1, Q162.1, Q163.1, Q164.1, R321.1, R323.1, R325.1, R327.1
LV201: JP161.5, Q163.2, R325.2
LV202: JP161.6, Q162.2, R323.2
LV203: JP161.1, Q161.2, R321.2
LV204: JP161.2, Q164.2, R327.2
LV205: JP165.4, Q165.1, Q166.1, Q167.1, Q168.1, R329.1, R331.1, R333.1, R335.1
LV206: JP165.5, Q167.2, R333.2
LV207: JP165.6, Q166.2, R331.2
LV208: JP165.1, Q165.2, R329.2
LV209: JP165.2, Q168.2, R335.2
LV210: JP169.4, Q169.1, Q170.1, Q171.1, Q172.1, R337.1, R339.1, R341.1, R343.1
LV211: JP169.5, Q171.2, R341.2
LV212: JP169.6, Q170.2, R339.2
LV213: JP169.1, Q169.2, R337.2
LV214: JP169.2, Q172.2, R343.2
LV215: JP173.4, Q173.1, Q174.1, Q175.1, Q176.1, R345.1, R347.1, R349.1, R351.1
LV216: JP173.5, Q175.2, R349.2
LV217: JP173.6, Q174.2, R347.2
LV218: JP173.1, Q173.2, R345.2
LV219: JP173.2, Q176.2, R351.2
LV220: JP177.4, Q177.1, Q178.1, Q179.1, Q180.1, R353.1, R355.1, R357.1, R359.1
LV221: JP177.5, Q179.2, R357.2
LV222: JP177.6, Q178.2, R355.2
LV223: JP177.1, Q177.2, R353.2
LV224: JP177.2, Q180.2, R359.2
LV225: JP181.4, Q181.1, Q182.1, Q183.1, Q184.1, R361.1, R363.1, R365.1, R367.1
LV226: JP181.5, Q183.2, R365.2
LV227: JP181.6, Q182.2, R363.2
LV228: JP181.1, Q181.2, R361.2
LV229: JP181.2, Q184.2, R367.2
LV230: JP185.4, Q185.1, Q186.1, Q187.1, Q188.1, R369.1, R371.1, R373.1, R375.1
LV231: JP185.5, Q187.2, R373.2
LV232: JP185.6, Q186.2, R371.2
LV233: JP185.1, Q185.2, R369.2
LV234: JP185.2, Q188.2, R375.2
LV235: JP189.4, Q189.1, Q190.1, Q191.1, Q192.1, R377.1, R379.1, R381.1, R383.1
LV236: JP189.5, Q191.2, R381.2
LV237: JP189.6, Q190.2, R379.2
LV238: JP189.1, Q189.2, R377.2
LV239: JP189.2, Q192.2, R383.2
LV240: JP193.4, Q193.1, Q194.1, Q195.1, Q196.1, R385.1, R387.1, R389.1, R391.1
LV241: JP193.5, Q195.2, R389.2
LV242: JP193.6, Q194.2, R387.2
LV243: JP193.1, Q193.2, R385.2
LV244: JP193.2, Q196.2, R391.2
LV245: JP197.4, Q197.1, Q198.1, Q199.1, Q200.1, R393.1, R395.1, R397.1, R399.1
LV246: JP197.5, Q199.2, R397.2
LV247: JP197.6, Q198.2, R395.2
LV248: JP197.1, Q197.2, R393.2
LV249: JP197.2, Q200.2, R399.2
LV250: JP201.4, Q201.1, Q202.1, Q203.1, Q204.1, R401.1, R403.1, R405.1, R407.1
LV251: JP201.5, Q203.2, R405.2
LV252: JP201.6, Q202.2, R403.2
LV253: JP201.1, Q201.2, R401.2
LV254: JP201.2, Q204.2, R407.2
LV255: JP205.4, Q205.1, Q206.1, Q207.1, Q208.1, R409.1, R411.1, R413.1, R415.1
LV256: JP205.5, Q207.2, R413.2
LV257: JP205.6, Q206.2, R411.2
LV258: JP205.1, Q205.2, R409.2
LV259: JP205.2, Q208.2, R415.2
LV260: JP209.4, Q209.1, Q210.1, Q211.1, Q212.1, R417.1, R419.1, R421.1, R423.1
LV261: JP209.5, Q211.2, R421.2
LV262: JP209.6, Q210.2, R419.2
LV263: JP209.1, Q209.2, R417.2
LV264: JP209.2, Q212.2, R423.2
LV265: JP213.4, Q213.1, Q214.1, Q215.1, Q216.1, R425.1, R427.1, R429.1, R431.1
LV266: JP213.5, Q215.2, R429.2
LV267: JP213.6, Q214.2, R427.2
LV268: JP213.1, Q213.2, R425.2
LV269: JP213.2, Q216.2, R431.2
LV270: JP217.4, Q217.1, Q218.1, Q219.1, Q220.1, R433.1, R435.1, R437.1, R439.1
LV271: JP217.5, Q219.2, R437.2
LV272: JP217.6, Q218.2, R435.2
LV273: JP217.1, Q217.2, R433.2
LV274: JP217.2, Q220.2, R439.2
LV275: JP221.4, Q221.1, Q222.1, Q223.1, Q224.1, R441.1, R443.1, R445.1, R447.1
LV276: JP221.5, Q223.2, R445.2
LV277: JP221.6, Q222.2, R443.2
LV278: JP221.1, Q221.2, R441.2
LV279: JP221.2, Q224.2, R447.2
LV280: JP225.4, Q225.1, Q226.1, Q227.1, Q228.1, R449.1, R451.1, R453.1, R455.1
LV281: JP225.5, Q227.2, R453.2
LV282: JP225.6, Q226.2, R451.2
LV283: JP225.1, Q225.2, R449.2
LV284: JP225.2, Q228.2, R455.2
LV285: JP229.4, Q229.1, Q230.1, Q231.1, Q232.1, R457.1, R459.1, R461.1, R463.1
LV286: JP229.5, Q231.2, R461.2
LV287: JP229.6, Q230.2, R459.2
LV288: JP229.1, Q229.2, R457.2
LV289: JP229.2, Q232.2, R463.2
LV290: JP233.4, Q233.1, Q234.1, Q235.1, Q236.1, R465.1, R467.1, R469.1, R471.1
LV291: JP233.5, Q235.2, R469.2
LV292: JP233.6, Q234.2, R467.2
LV293: JP233.1, Q233.2, R465.2
LV294: JP233.2, Q236.2, R471.2
LV295: JP237.4, Q237.1, Q238.1, Q239.1, Q240.1, R473.1, R475.1, R477.1, R479.1
LV296: JP237.5, Q239.2, R477.2
LV297: JP237.6, Q238.2, R475.2
LV298: JP237.1, Q237.2, R473.2
LV299: JP237.2, Q240.2, R479.2
LV300: JP241.4, Q241.1, Q242.1, Q243.1, Q244.1, R481.1, R483.1, R485.1, R487.1
LV301: JP241.5, Q243.2, R485.2
LV302: JP241.6, Q242.2, R483.2
LV303: JP241.1, Q241.2, R481.2
LV304: JP241.2, Q244.2, R487.2
LV305: JP245.4, Q245.1, Q246.1, Q247.1, Q248.1, R489.1, R491.1, R493.1, R495.1
LV306: JP245.5, Q247.2, R493.2
LV307: JP245.6, Q246.2, R491.2
LV308: JP245.1, Q245.2, R489.2
LV309: JP245.2, Q248.2, R495.2
LV310: JP249.4, Q249.1, Q250.1, Q251.1, Q252.1, R497.1, R499.1, R501.1, R503.1
LV311: JP249.5, Q251.2, R501.2
LV312: JP249.6, Q250.2, R499.2
LV313: JP249.1, Q249.2, R497.2
LV314: JP249.2, Q252.2, R503.2
LV315: JP253.4, Q253.1, Q254.1, Q255.1, Q256.1, R505.1, R507.1, R509.1, R511.1
LV316: JP253.5, Q255.2, R509.2
LV317: JP253.6, Q254.2, R507.2
LV318: JP253.1, Q253.2, R505.2
LV319: JP253.2, Q256.2, R511.2
LV320: JP257.4, Q257.1, Q258.1, Q259.1, Q260.1, R513.1, R515.1, R517.1, R519.1
LV321: JP257.5, Q259.2, R517.2
LV322: JP257.6, Q258.2, R515.2
LV323: JP257.1, Q257.2, R513.2
LV324: JP257.2, Q260.2, R519.2
LV325: JP261.4, Q261.1, Q262.1, Q263.1, Q264.1, R521.1, R523.1, R525.1, R527.1
LV326: JP261.5, Q263.2, R525.2
LV327: JP261.6, Q262.2, R523.2
LV328: JP261.1, Q261.2, R521.2
LV329: JP261.2, Q264.2, R527.2
LV330: JP265.4, Q265.1, Q266.1, Q267.1, Q268.1, R529.1, R531.1, R533.1, R535.1
LV331: JP265.5, Q267.2, R533.2
LV332: JP265.6, Q266.2, R531.2
LV333: JP265.1, Q265.2, R529.2
LV334: JP265.2, Q268.2, R535.2
LV335: JP269.4, Q269.1, Q270.1, Q271.1, Q272.1, R537.1, R539.1, R541.1, R543.1
LV336: JP269.5, Q271.2, R541.2
LV337: JP269.6, Q270.2, R539.2
LV338: JP269.1, Q269.2, R537.2
LV339: JP269.2, Q272.2, R543.2
LV340: JP273.4, Q273.1, Q274.1, Q275.1, Q276.1, R545.1, R547.1, R549.1, R551.1
LV341: JP273.5, Q275.2, R549.2
LV342: JP273.6, Q274.2, R547.2
LV343: JP273.1, Q273.2, R545.2
LV344: JP273.2, Q276.2, R551.2
LV345: JP277.4, Q277.1, Q278.1, Q279.1, Q280.1, R553.1, R555.1, R557.1, R559.1
LV346: JP277.5, Q279.2, R557.2
LV347: JP277.6, Q278.2, R555.2
LV348: JP277.1, Q277.2, R553.2
LV349: JP277.2, Q280.2, R559.2
LV350: JP281.4, Q281.1, Q282.1, Q283.1, Q284.1, R561.1, R563.1, R565.1, R567.1
LV351: JP281.5, Q283.2, R565.2
LV352: JP281.6, Q282.2, R563.2
LV353: JP281.1, Q281.2, R561.2
LV354: JP281.2, Q284.2, R567.2
LV355: JP285.4, Q285.1, Q286.1, Q287.1, Q288.1, R569.1, R571.1, R573.1, R575.1
LV356: JP285.5, Q287.2, R573.2
LV357: JP285.6, Q286.2, R571.2
LV358: JP285.1, Q285.2, R569.2
LV359: JP285.2, Q288.2, R575.2
LV360: JP289.4, Q289.1, Q290.1, Q291.1, Q292.1, R577.1, R579.1, R581.1, R583.1
LV361: JP289.5, Q291.2, R581.2
LV362: JP289.6, Q290.2, R579.2
LV363: JP289.1, Q289.2, R577.2
LV364: JP289.2, Q292.2, R583.2
LV365: JP293.4, Q293.1, Q294.1, Q295.1, Q296.1, R585.1, R587.1, R589.1, R591.1
LV366: JP293.5, Q295.2, R589.2
LV367: JP293.6, Q294.2, R587.2
LV368: JP293.1, Q293.2, R585.2
LV369: JP293.2, Q296.2, R591.2
LV370: JP297.4, Q297.1, Q298.1, Q299.1, Q300.1, R593.1, R595.1, R597.1, R599.1
LV371: JP297.5, Q299.2, R597.2
LV372: JP297.6, Q298.2, R595.2
LV373: JP297.1, Q297.2, R593.2
LV374: JP297.2, Q300.2, R599.2
LV375: JP301.4, Q301.1, Q302.1, Q303.1, Q304.1, R601.1, R603.1, R605.1, R607.1
LV376: JP301.5, Q303.2, R605.2
LV377: JP301.6, Q302.2, R603.2
LV378: JP301.1, Q301.2, R601.2
LV379: JP301.2, Q304.2, R607.2
LV380: JP305.4, Q305.1, Q306.1, Q307.1, Q308.1, R609.1, R611.1, R613.1, R615.1
LV381: JP305.5, Q307.2, R613.2
LV382: JP305.6, Q306.2, R611.2
LV383: JP305.1, Q305.2, R609.2
LV384: JP305.2, Q308.2, R615.2
LV385: JP309.4, Q309.1, Q310.1, Q311.1, Q312.1, R617.1, R619.1, R621.1, R623.1
LV386: JP309.5, Q311.2, R621.2
LV387: JP309.6, Q310.2, R619.2
LV388: JP309.1, Q309.2, R617.2
LV389: JP309.2, Q312.2, R623.2
LV390: JP313.4, Q313.1, Q314.1, Q315.1, Q316.1, R625.1, R627.1, R629.1, R631.1
LV391: JP313.5, Q315.2, R629.2
LV392: JP313.6, Q314.2, R627.2
LV393: JP313.1, Q313.2, R625.2
LV394: JP313.2, Q316.2, R631.2
LV395: JP317.4, Q317.1, Q318.1, Q319.1, Q320.1, R633.1, R635.1, R637.1, R639.1
LV396: JP317.5, Q319.2, R637.2
LV397: JP317.6, Q318.2, R635.2
LV398: JP317.1, Q317.2, R633.2
LV399: JP317.2, Q320.2, R639.2
LV400: JP321.4, Q321.1, Q322.1, Q323.1, Q324.1, R641.1, R643.1, R645.1, R647.1
LV401: JP321.5, Q323.2, R645.2
LV402: JP321.6, Q322.2, R643.2
LV403: JP321.1, Q321.2, R641.2
LV404: JP321.2, Q324.2, R647.2
LV405: JP325.4, Q325.1, Q326.1, Q327.1, Q328.1, R649.1, R651.1, R653.1, R655.1
LV406: JP325.5, Q327.2, R653.2
LV407: JP325.6, Q326.2, R651.2
LV408: JP325.1, Q325.2, R649.2
LV409: JP325.2, Q328.2, R655.2
LV410: JP329.4, Q329.1, Q330.1, Q331.1, Q332.1, R657.1, R659.1, R661.1, R663.1
LV411: JP329.5, Q331.2, R661.2
LV412: JP329.6, Q330.2, R659.2
LV413: JP329.1, Q329.2, R657.2
LV414: JP329.2, Q332.2, R663.2
LV415: JP333.4, Q333.1, Q334.1, Q335.1, Q336.1, R665.1, R667.1, R669.1, R671.1
LV416: JP333.5, Q335.2, R669.2
LV417: JP333.6, Q334.2, R667.2
LV418: JP333.1, Q333.2, R665.2
LV419: JP333.2, Q336.2, R671.2
LV420: JP337.4, Q337.1, Q338.1, Q339.1, Q340.1, R673.1, R675.1, R677.1, R679.1
LV421: JP337.5, Q339.2, R677.2
LV422: JP337.6, Q338.2, R675.2
LV423: JP337.1, Q337.2, R673.2
LV424: JP337.2, Q340.2, R679.2
LV425: JP341.4, Q341.1, Q342.1, Q343.1, Q344.1, R681.1, R683.1, R685.1, R687.1
LV426: JP341.5, Q343.2, R685.2
LV427: JP341.6, Q342.2, R683.2
LV428: JP341.1, Q341.2, R681.2
LV429: JP341.2, Q344.2, R687.2
LV430: JP345.4, Q345.1, Q346.1, Q347.1, Q348.1, R689.1, R691.1, R693.1, R695.1
LV431: JP345.5, Q347.2, R693.2
LV432: JP345.6, Q346.2, R691.2
LV433: JP345.1, Q345.2, R689.2
LV434: JP345.2, Q348.2, R695.2
LV435: JP349.4, Q349.1, Q350.1, Q351.1, Q352.1, R697.1, R699.1, R701.1, R703.1
LV436: JP349.5, Q351.2, R701.2
LV437: JP349.6, Q350.2, R699.2
LV438: JP349.1, Q349.2, R697.2
LV439: JP349.2, Q352.2, R703.2
LV440: JP353.4, Q353.1, Q354.1, Q355.1, Q356.1, R705.1, R707.1, R709.1, R711.1
LV441: JP353.5, Q355.2, R709.2
LV442: JP353.6, Q354.2, R707.2
LV443: JP353.1, Q353.2, R705.2
LV444: JP353.2, Q356.2, R711.2
LV445: JP357.4, Q357.1, Q358.1, Q359.1, Q360.1, R713.1, R715.1, R717.1, R719.1
LV446: JP357.5, Q359.2, R717.2
LV447: JP357.6, Q358.2, R715.2
LV448: JP357.1, Q357.2, R713.2
LV449: JP357.2, Q360.2, R719.2
LV450: JP361.4, Q361.1, Q362.1, Q363.1, Q364.1, R721.1, R723.1, R725.1, R727.1
LV451: JP361.5, Q363.2, R725.2
LV452: JP361.6, Q362.2, R723.2
LV453: JP361.1, Q361.2, R721.2
LV454: JP361.2, Q364.2, R727.2
LV455: JP365.4, Q365.1, Q366.1, Q367.1, Q368.1, R729.1, R731.1, R733.1, R735.1
LV456: JP365.5, Q367.2, R733.2
LV457: JP365.6, Q366.2, R731.2
LV458: JP365.1, Q365.2, R729.2
LV459: JP365.2, Q368.2, R735.2
LV460: JP369.4, Q369.1, Q370.1, Q371.1, Q372.1, R737.1, R739.1, R741.1, R743.1
LV461: JP369.5, Q371.2, R741.2
LV462: JP369.6, Q370.2, R739.2
LV463: JP369.1, Q369.2, R737.2
LV464: JP369.2, Q372.2, R743.2
LV465: JP373.4, Q373.1, Q374.1, Q375.1, Q376.1, R745.1, R747.1, R749.1, R751.1
LV466: JP373.5, Q375.2, R749.2
LV467: JP373.6, Q374.2, R747.2
LV468: JP373.1, Q373.2, R745.2
LV469: JP373.2, Q376.2, R751.2
LV470: JP377.4, Q377.1, Q378.1, Q379.1, Q380.1, R753.1, R755.1, R757.1, R759.1
LV471: JP377.5, Q379.2, R757.2
LV472: JP377.6, Q378.2, R755.2
LV473: JP377.1, Q377.2, R753.2
LV474: JP377.2, Q380.2, R759.2
LV475: JP381.4, Q381.1, Q382.1, Q383.1, Q384.1, R761.1, R763.1, R765.1, R767.1
LV476: JP381.5, Q383.2, R765.2
LV477: JP381.6, Q382.2, R763.2
LV478: JP381.1, Q381.2, R761.2
LV479: JP381.2, Q384.2, R767.2
LV480: JP385.4, Q385.1, Q386.1, Q387.1, Q388.1, R769.1, R771.1, R773.1, R775.1
LV481: JP385.5, Q387.2, R773.2
LV482: JP385.6, Q386.2, R771.2
LV483: JP385.1, Q385.2, R769.2
LV484: JP385.2, Q388.2, R775.2
LV485: JP389.4, Q389.1, Q390.1, Q391.1, Q392.1, R777.1, R779.1, R781.1, R783.1
LV486: JP389.5, Q391.2, R781.2
LV487: JP389.6, Q390.2, R779.2
LV488: JP389.1, Q389.2, R777.2
LV489: JP389.2, Q392.2, R783.2
LV490: JP393.4, Q393.1, Q394.1, Q395.1, Q396.1, R785.1, R787.1, R789.1, R791.1
LV491: JP393.5, Q395.2, R789.2
LV492: JP393.6, Q394.2, R787.2
LV493: JP393.1, Q393.2, R785.2
LV494: JP393.2, Q396.2, R791.2
LV495: JP397.4, Q397.1, Q398.1, Q399.1, Q400.1, R793.1, R795.1, R797.1, R799.1
LV496: JP397.5, Q399.2, R797.2
LV497: JP397.6, Q398.2, R795.2
LV498: JP397.1, Q397.2, R793.2
LV499: JP397.2, Q400.2, R799.2
LV500: JP401.4, Q401.1, Q402.1, Q403.1, Q404.1, R801.1, R803.1, R805.1, R807.1
LV501: JP401.5, Q403.2, R805.2
LV502: JP401.6, Q402.2, R803.2
LV503: JP401.1, Q401.2, R801.2
LV504: JP401.2, Q404.2, R807.2
LV505: JP405.4, Q405.1, Q406.1, Q407.1, Q408.1, R809.1, R811.1, R813.1, R815.1
LV506: JP405.5, Q407.2, R813.2
LV507: JP405.6, Q406.2, R811.2
LV508: JP405.1, Q405.2, R809.2
LV509: JP405.2, Q408.2, R815.2
LV510: JP409.4, Q409.1, Q410.1, Q411.1, Q412.1, R817.1, R819.1, R821.1, R823.1
LV511: JP409.5, Q411.2, R821.2
LV512: JP409.6, Q410.2, R819.2
LV513: JP409.1, Q409.2, R817.2
LV514: JP409.2, Q412.2, R823.2
LV515: JP413.4, Q413.1, Q414.1, Q415.1, Q416.1, R825.1, R827.1, R829.1, R831.1
LV516: JP413.5, Q415.2, R829.2
LV517: JP413.6, Q414.2, R827.2
LV518: JP413.1, Q413.2, R825.2
LV519: JP413.2, Q416.2, R831.2
LV520: JP417.4, Q417.1, Q418.1, Q419.1, Q420.1, R833.1, R835.1, R837.1, R839.1
LV521: JP417.5, Q419.2, R837.2
LV522: JP417.6, Q418.2, R835.2
LV523: JP417.1, Q417.2, R833.2
LV524: JP417.2, Q420.2, R839.2
LV525: JP421.4, Q421.1, Q422.1, Q423.1, Q424.1, R841.1, R843.1, R845.1, R847.1
LV526: JP421.5, Q423.2, R845.2
LV527: JP421.6, Q422.2, R843.2
LV528: JP421.1, Q421.2, R841.2
LV529: JP421.2, Q424.2, R847.2
LV530: JP425.4, Q425.1, Q426.1, Q427.1, Q428.1, R849.1, R851.1, R853.1, R855.1
LV531: JP425.5, Q427.2, R853.2
LV532: JP425.6, Q426.2, R851.2
LV533: JP425.1, Q425.2, R849.2
LV534: JP425.2, Q428.2, R855.2
LV535: JP429.4, Q429.1, Q430.1, Q431.1, Q432.1, R857.1, R859.1, R861.1, R863.1
LV536: JP429.5, Q431.2, R861.2
LV537: JP429.6, Q430.2, R859.2
LV538: JP429.1, Q429.2, R857.2
LV539: JP429.2, Q432.2, R863.2
LV540: JP433.4, Q433.1, Q434.1, Q435.1, Q436.1, R865.1, R867.1, R869.1, R871.1
LV541: JP433.5, Q435.2, R869.2
LV542: JP433.6, Q434.2, R867.2
LV543: JP433.1, Q433.2, R865.2
LV544: JP433.2, Q436.2, R871.2
LV545: JP437.4, Q437.1, Q438.1, Q439.1, Q440.1, R873.1, R875.1, R877.1, R879.1
LV546: JP437.5, Q439.2, R877.2
LV547: JP437.6, Q438.2, R875.2
LV548: JP437.1, Q437.2, R873.2
LV549: JP437.2, Q440.2, R879.2
LV550: JP441.4, Q441.1, Q442.1, Q443.1, Q444.1, R881.1, R883.1, R885.1, R887.1
LV551: JP441.5, Q443.2, R885.2
LV552: JP441.6, Q442.2, R883.2
LV553: JP441.1, Q441.2, R881.2
LV554: JP441.2, Q444.2, R887.2
LV555: JP445.4, Q445.1, Q446.1, Q447.1, Q448.1, R889.1, R891.1, R893.1, R895.1
LV556: JP445.5, Q447.2, R893.2
LV557: JP445.6, Q446.2, R891.2
LV558: JP445.1, Q445.2, R889.2
LV559: JP445.2, Q448.2, R895.2
LV560: JP449.4, Q449.1, Q450.1, Q451.1, Q452.1, R897.1, R899.1, R901.1, R903.1
LV561: JP449.5, Q451.2, R901.2
LV562: JP449.6, Q450.2, R899.2
LV563: JP449.1, Q449.2, R897.2
LV564: JP449.2, Q452.2, R903.2
LV565: JP453.4, Q453.1, Q454.1, Q455.1, Q456.1, R905.1, R907.1, R909.1, R911.1
LV566: JP453.5, Q455.2, R909.2
LV567: JP453.6, Q454.2, R907.2
LV568: JP453.1, Q453.2, R905.2
LV569: JP453.2, Q456.2, R911.2
LV570: JP457.4, Q457.1, Q458.1, Q459.1, Q460.1, R913.1, R915.1, R917.1, R919.1
LV571: JP457.5, Q459.2, R917.2
LV572: JP457.6, Q458.2, R915.2
LV573: JP457.1, Q457.2, R913.2
LV574: JP457.2, Q460.2, R919.2
LV575: JP461.4, Q461.1, Q462.1, Q463.1, Q464.1, R921.1, R923.1, R925.1, R927.1
LV576: JP461.5, Q463.2, R925.2
LV577: JP461.6, Q462.2, R923.2
LV578: JP461.1, Q461.2, R921.2
LV579: JP461.2, Q464.2, R927.2
LV580: JP465.4, Q465.1, Q466.1, Q467.1, Q468.1, R929.1, R931.1, R933.1, R935.1
LV581: JP465.5, Q467.2, R933.2
LV582: JP465.6, Q466.2, R931.2
LV583: JP465.1, Q465.2, R929.2
LV584: JP465.2, Q468.2, R935.2
LV585: JP469.4, Q469.1, Q470.1, Q471.1, Q472.1, R937.1, R939.1, R941.1, R943.1
LV586: JP469.5, Q471.2, R941.2
LV587: JP469.6, Q470.2, R939.2
LV588: JP469.1, Q469.2, R937.2
LV589: JP469.2, Q472.2, R943.2
LV590: JP473.4, Q473.1, Q474.1, Q475.1, Q476.1, R945.1, R947.1, R949.1, R951.1
LV591: JP473.5, Q475.2, R949.2
LV592: JP473.6, Q474.2, R947.2
LV593: JP473.1, Q473.2, R945.2
LV594: JP473.2, Q476.2, R951.2
LV595: JP477.4, Q477.1, Q478.1, Q479.1, Q480.1, R953.1, R955.1, R957.1, R959.1
LV596: JP477.5, Q479.2, R957.2
LV597: JP477.6, Q478.2, R955.2
LV598: JP477.1, Q477.2, R953.2
LV599: JP477.2, Q480.2, R959.2
LV600: JP481.4, Q481.1, Q482.1, Q483.1, Q484.1, R961.1, R963.1, R965.1, R967.1
LV601: JP481.5, Q483.2, R965.2
LV602: JP481.6, Q482.2, R963.2
LV603: JP481.1, Q481.2, R961.2
LV604: JP481.2, Q484.2, R967.2
LV605: JP485.4, Q485.1, Q486.1, Q487.1, Q488.1, R969.1, R971.1, R973.1, R975.1
LV606: JP485.5, Q487.2, R973.2
LV607: JP485.6, Q486.2, R971.2
LV608: JP485.1, Q485.2, R969.2
LV609: JP485.2, Q488.2, R975.2
LV610: JP489.4, Q489.1, Q490.1, Q491.1, Q492.1, R977.1, R979.1, R981.1, R983.1
LV611: JP489.5, Q491.2, R981.2
LV612: JP489.6, Q490.2, R979.2
LV613: JP489.1, Q489.2, R977.2
LV614: JP489.2, Q492.2, R983.2
LV615: JP493.4, Q493.1, Q494.1, Q495.1, Q496.1, R985.1, R987.1, R989.1, R991.1
LV616: JP493.5, Q495.2, R989.2
LV617: JP493.6, Q494.2, R987.2
LV618: JP493.1, Q493.2, R985.2
LV619: JP493.2, Q496.2, R991.2
LV620: JP497.4, Q497.1, Q498.1, Q499.1, Q500.1, R993.1, R995.1, R997.1, R999.1
LV621: JP497.5, Q499.2, R997.2
LV622: JP497.6, Q498.2, R995.2
LV623: JP497.1, Q497.2, R993.2
LV624: JP497.2, Q500.2, R999.2
LV625: JP501.4, Q501.1, Q502.1, Q503.1, Q504.1, R1001.1, R1003.1, R1005.1, R1007.1
LV626: JP501.5, Q503.2, R1005.2
LV627: JP501.6, Q502.2, R1003.2
LV628: JP501.1, Q501.2, R1001.2
LV629: JP501.2, Q504.2, R1007.2
LV630: JP505.4, Q505.1, Q506.1, Q507.1, Q508.1, R1009.1, R1011.1, R1013.1, R1015.1
LV631: JP505.5, Q507.2, R1013.2
LV632: JP505.6, Q506.2, R1011.2
LV633: JP505.1, Q505.2, R1009.2
LV634: JP505.2, Q508.2, R1015.2
LV635: JP509.4, Q509.1, Q510.1, Q511.1, Q512.1, R1017.1, R1019.1, R1021.1, R1023.1
LV636: JP509.5, Q511.2, R1021.2
LV637: JP509.6, Q510.2, R1019.2
LV638: JP509.1, Q509.2, R1017.2
LV639: JP509.2, Q512.2, R1023.2
LV640: JP513.4, Q513.1, Q514.1, Q515.1, Q516.1, R1025.1, R1027.1, R1029.1, R1031.1
LV641: JP513.5, Q515.2, R1029.2
LV642: JP513.6, Q514.2, R1027.2
LV643: JP513.1, Q513.2, R1025.2
LV644: JP513.2, Q516.2, R1031.2
LV645: JP517.4, Q517.1, Q518.1, Q519.1, Q520.1, R1033.1, R1035.1, R1037.1, R1039.1
LV646: JP517.5, Q519.2, R1037.2
LV647: JP517.6, Q518.2, R1035.2
LV648: JP517.1, Q517.2, R1033.2
LV649: JP517.2, Q520.2, R1039.2
LV650: JP521.4, Q521.1, Q522.1, Q523.1, Q524.1, R1041.1, R1043.1, R1045.1, R1047.1
LV651: JP521.5, Q523.2, R1045.2
LV652: JP521.6, Q522.2, R1043.2
LV653: JP521.1, Q521.2, R1041.2
LV654: JP521.2, Q524.2, R1047.2
LV655: JP525.4, Q525.1, Q526.1, Q527.1, Q528.1, R1049.1, R1051.1, R1053.1, R1055.1
LV656: JP525.5, Q527.2, R1053.2
LV657: JP525.6, Q526.2, R1051.2
LV658: JP525.1, Q525.2, R1049.2
LV659: JP525.2, Q528.2, R1055.2
LV660: JP529.4, Q529.1, Q530.1, Q531.1, Q532.1, R1057.1, R1059.1, R1061.1, R1063.1
LV661: JP529.5, Q531.2, R1061.2
LV662: JP529.6, Q530.2, R1059.2
LV663: JP529.1, Q529.2, R1057.2
LV664: JP529.2, Q532.2, R1063.2
LV665: JP533.4, Q533.1, Q534.1, Q535.1, Q536.1, R1065.1, R1067.1, R1069.1, R1071.1
LV666: JP533.5, Q535.2, R1069.2
LV667: JP533.6, Q534.2, R1067.2
LV668: JP533.1, Q533.2, R1065.2
LV669: JP533.2, Q536.2, R1071.2
LV670: JP537.4, Q537.1, Q538.1, Q539.1, Q540.1, R1073.1, R1075.1, R1077.1, R1079.1
LV671: JP537.5, Q539.2, R1077.2
LV672: JP537.6, Q538.2, R1075.2
LV673: JP537.1, Q537.2, R1073.2
LV674: JP537.2, Q540.2, R1079.2
LV675: JP541.4, Q541.1, Q542.1, Q543.1, Q544.1, R1081.1, R1083.1, R1085.1, R1087.1
LV676: JP541.5, Q543.2, R1085.2
LV677: JP541.6, Q542.2, R1083.2
LV678: JP541.1, Q541.2, R1081.2
LV679: JP541.2, Q544.2, R1087.2
LV680: JP545.4, Q545.1, Q546.1, Q547.1, Q548.1, R1089.1, R1091.1, R1093.1, R1095.1
LV681: JP545.5, Q547.2, R1093.2
LV682: JP545.6, Q546.2, R1091.2
LV683: JP545.1, Q545.2, R1089.2
LV684: JP545.2, Q548.2, R1095.2
LV685: JP549.4, Q549.1, Q550.1, Q551.1, Q552.1, R1097.1, R1099.1, R1101.1, R1103.1
LV686: JP549.5, Q551.2, R1101.2
LV687: JP549.6, Q550.2, R1099.2
LV688: JP549.1, Q549.2, R1097.2
LV689: JP549.2, Q552.2, R1103.2
LV690: JP553.4, Q553.1, Q554.1, Q555.1, Q556.1, R1105.1, R1107.1, R1109.1, R1111.1
LV691: JP553.5, Q555.2, R1109.2
LV692: JP553.6, Q554.2, R1107.2
LV693: JP553.1, Q553.2, R1105.2
LV694: JP553.2, Q556.2, R1111.2
LV695: JP557.4, Q557.1, Q558.1, Q559.1, Q560.1, R1113.1, R1115.1, R1117.1, R1119.1
LV696: JP557.5, Q559.2, R1117.2
LV697: JP557.6, Q558.2, R1115.2
LV698: JP557.1, Q557.2, R1113.2
LV699: JP557.2, Q560.2, R1119.2
LV700: JP561.4, Q561.1, Q562.1, Q563.1, Q564.1, R1121.1, R1123.1, R1125.1, R1127.1
LV701: JP561.5, Q563.2, R1125.2
LV702: JP561.6, Q562.2, R1123.2
LV703: JP561.1, Q561.2, R1121.2
LV704: JP561.2, Q564.2, R1127.2
LV705: JP565.4, Q565.1, Q566.1, Q567.1, Q568.1, R1129.1, R1131.1, R1133.1, R1135.1
LV706: JP565.5, Q567.2, R1133.2
LV707: JP565.6, Q566.2, R1131.2
LV708: JP565.1, Q565.2, R1129.2
LV709: JP565.2, Q568.2, R1135.2
LV710: JP569.4, Q569.1, Q570.1, Q571.1, Q572.1, R1137.1, R1139.1, R1141.1, R1143.1
LV711: JP569.5, Q571.2, R1141.2
LV712: JP569.6, Q570.2, R1139.2
LV713: JP569.1, Q569.2, R1137.2
LV714: JP569.2, Q572.2, R1143.2
LV715: JP573.4, Q573.1, Q574.1, Q575.1, Q576.1, R1145.1, R1147.1, R1149.1, R1151.1
LV716: JP573.5, Q575.2, R1149.2
LV717: JP573.6, Q574.2, R1147.2
LV718: JP573.1, Q573.2, R1145.2
LV719: JP573.2, Q576.2, R1151.2
LV720: JP577.4, Q577.1, Q578.1, Q579.1, Q580.1, R1153.1, R1155.1, R1157.1, R1159.1
LV721: JP577.5, Q579.2, R1157.2
LV722: JP577.6, Q578.2, R1155.2
LV723: JP577.1, Q577.2, R1153.2
LV724: JP577.2, Q580.2, R1159.2
LV725: JP581.4, Q581.1, Q582.1, Q583.1, Q584.1, R1161.1, R1163.1, R1165.1, R1167.1
LV726: JP581.5, Q583.2, R1165.2
LV727: JP581.6, Q582.2, R1163.2
LV728: JP581.1, Q581.2, R1161.2
LV729: JP581.2, Q584.2, R1167.2
LV730: JP585.4, Q585.1, Q586.1, Q587.1, Q588.1, R1169.1, R1171.1, R1173.1, R1175.1
LV731: JP585.5, Q587.2, R1173.2
LV732: JP585.6, Q586.2, R1171.2
LV733: JP585.1, Q585.2, R1169.2
LV734: JP585.2, Q588.2, R1175.2
LV735: JP589.4, Q589.1, Q590.1, Q591.1, Q592.1, R1177.1, R1179.1, R1181.1, R1183.1
LV736: JP589.5, Q591.2, R1181.2
LV737: JP589.6, Q590.2, R1179.2
LV738: JP589.1, Q589.2, R1177.2
LV739: JP589.2, Q592.2, R1183.2
LV740: JP593.4, Q593.1, Q594.1, Q595.1, Q596.1, R1185.1, R1187.1, R1189.1, R1191.1
LV741: JP593.5, Q595.2, R1189.2
LV742: JP593.6, Q594.2, R1187.2
LV743: JP593.1, Q593.2, R1185.2
LV744: JP593.2, Q596.2, R1191.2
LV745: JP597.4, Q597.1, Q598.1, Q599.1, Q600.1, R1193.1, R1195.1, R1197.1, R1199.1
LV746: JP597.5, Q599.2, R1197.2
LV747: JP597.6, Q598.2, R1195.2
LV748: JP597.1, Q597.2, R1193.2
LV749: JP597.2, Q600.2, R1199.2
LV750: JP601.4, Q601.1, Q602.1, Q603.1, Q604.1, R1201.1, R1203.1, R1205.1, R1207.1
LV751: JP601.5, Q603.2, R1205.2
LV752: JP601.6, Q602.2, R1203.2
LV753: JP601.1, Q601.2, R1201.2
LV754: JP601.2, Q604.2, R1207.2
LV755: JP605.4, Q605.1, Q606.1, Q607.1, Q608.1, R1209.1, R1211.1, R1213.1, R1215.1
LV756: JP605.5, Q607.2, R1213.2
LV757: JP605.6, Q606.2, R1211.2
LV758: JP605.1, Q605.2, R1209.2
LV759: JP605.2, Q608.2, R1215.2
LV760: JP609.4, Q609.1, Q610.1, Q611.1, Q612.1, R1217.1, R1219.1, R1221.1, R1223.1
LV761: JP609.5, Q611.2, R1221.2
LV762: JP609.6, Q610.2, R1219.2
LV763: JP609.1, Q609.2, R1217.2
LV764: JP609.2, Q612.2, R1223.2
LV765: JP613.4, Q613.1, Q614.1, Q615.1, Q616.1, R1225.1, R1227.1, R1229.1, R1231.1
LV766: JP613.5, Q615.2, R1229.2
LV767: JP613.6, Q614.2, R1227.2
LV768: JP613.1, Q613.2, R1225.2
LV769: JP613.2, Q616.2, R1231.2
LV770: JP617.4, Q617.1, Q618.1, Q619.1, Q620.1, R1233.1, R1235.1, R1237.1, R1239.1
LV771: JP617.5, Q619.2, R1237.2
LV772: JP617.6, Q618.2, R1235.2
LV773: JP617.1, Q617.2, R1233.2
LV774: JP617.2, Q620.2, R1239.2
LV775: JP621.4, Q621.1, Q622.1, Q623.1, Q624.1, R1241.1, R1243.1, R1245.1, R1247.1
LV776: JP621.5, Q623.2, R1245.2
LV777: JP621.6, Q622.2, R1243.2
LV778: JP621.1, Q621.2, R1241.2
LV779: JP621.2, Q624.2, R1247.2
LV780: JP625.4, Q625.1, Q626.1, Q627.1, Q628.1, R1249.1, R1251.1, R1253.1, R1255.1
LV781: JP625.5, Q627.2, R1253.2
LV782: JP625.6, Q626.2, R1251.2
LV783: JP625.1, Q625.2, R1249.2
LV784: JP625.2, Q628.2, R1255.2
LV785: JP629.4, Q629.1, Q630.1, Q631.1, Q632.1, R1257.1, R1259.1, R1261.1, R1263.1
LV786: JP629.5, Q631.2, R1261.2
LV787: JP629.6, Q630.2, R1259.2
LV788: JP629.1, Q629.2, R1257.2
LV789: JP629.2, Q632.2, R1263.2
LV790: JP633.4, Q633.1, Q634.1, Q635.1, Q636.1, R1265.1, R1267.1, R1269.1, R1271.1
LV791: JP633.5, Q635.2, R1269.2
LV792: JP633.6, Q634.2, R1267.2
LV793: JP633.1, Q633.2, R1265.2
LV794: JP633.2, Q636.2, R1271.2
LV795: JP637.4, Q637.1, Q638.1, Q639.1, Q640.1, R1273.1, R1275.1, R1277.1, R1279.1
LV796: JP637.5, Q639.2, R1277.2
LV797: JP637.6, Q638.2, R1275.2
LV798: JP637.1, Q637.2, R1273.2
LV799: JP637.2, Q640.2, R1279.2
LV800: JP641.4, Q641.1, Q642.1, Q643.1, Q644.1, R1281.1, R1283.1, R1285.1, R1287.1
LV801: JP641.5, Q643.2, R1285.2
LV802: JP641.6, Q642.2, R1283.2
LV803: JP641.1, Q641.2, R1281.2
LV804: JP641.2, Q644.2, R1287.2
LV805: JP645.4, Q645.1, Q646.1, Q647.1, Q648.1, R1289.1, R1291.1, R1293.1, R1295.1
LV806: JP645.5, Q647.2, R1293.2
LV807: JP645.6, Q646.2, R1291.2
LV808: JP645.1, Q645.2, R1289.2
LV809: JP645.2, Q648.2, R1295.2
LV810: JP649.4, Q649.1, Q650.1, Q651.1, Q652.1, R1297.1, R1299.1, R1301.1, R1303.1
LV811: JP649.5, Q651.2, R1301.2
LV812: JP649.6, Q650.2, R1299.2
LV813: JP649.1, Q649.2, R1297.2
LV814: JP649.2, Q652.2, R1303.2
LV815: JP653.4, Q653.1, Q654.1, Q655.1, Q656.1, R1305.1, R1307.1, R1309.1, R1311.1
LV816: JP653.5, Q655.2, R1309.2
LV817: JP653.6, Q654.2, R1307.2
LV818: JP653.1, Q653.2, R1305.2
LV819: JP653.2, Q656.2, R1311.2
LV820: JP657.4, Q657.1, Q658.1, Q659.1, Q660.1, R1313.1, R1315.1, R1317.1, R1319.1
LV821: JP657.5, Q659.2, R1317.2
LV822: JP657.6, Q658.2, R1315.2
LV823: JP657.1, Q657.2, R1313.2
LV824: JP657.2, Q660.2, R1319.2
LV825: JP661.4, Q661.1, Q662.1, Q663.1, Q664.1, R1321.1, R1323.1, R1325.1, R1327.1
LV826: JP661.5, Q663.2, R1325.2
LV827: JP661.6, Q662.2, R1323.2
LV828: JP661.1, Q661.2, R1321.2
LV829: JP661.2, Q664.2, R1327.2
LV830: JP665.4, Q665.1, Q666.1, Q667.1, Q668.1, R1329.1, R1331.1, R1333.1, R1335.1
LV831: JP665.5, Q667.2, R1333.2
LV832: JP665.6, Q666.2, R1331.2
LV833: JP665.1, Q665.2, R1329.2
LV834: JP665.2, Q668.2, R1335.2
LV835: JP669.4, Q669.1, Q670.1, Q671.1, Q672.1, R1337.1, R1339.1, R1341.1, R1343.1
LV836: JP669.5, Q671.2, R1341.2
LV837: JP669.6, Q670.2, R1339.2
LV838: JP669.1, Q669.2, R1337.2
LV839: JP669.2, Q672.2, R1343.2
LV840: JP673.4, Q673.1, Q674.1, Q675.1, Q676.1, R1345.1, R1347.1, R1349.1, R1351.1
LV841: JP673.5, Q675.2, R1349.2
LV842: JP673.6, Q674.2, R1347.2
LV843: JP673.1, Q673.2, R1345.2
LV844: JP673.2, Q676.2, R1351.2
LV845: JP677.4, Q677.1, Q678.1, Q679.1, Q680.1, R1353.1, R1355.1, R1357.1, R1359.1
LV846: JP677.5, Q679.2, R1357.2
LV847: JP677.6, Q678.2, R1355.2
LV848: JP677.1, Q677.2, R1353.2
LV849: JP677.2, Q680.2, R1359.2
LV850: JP681.4, Q681.1, Q682.1, Q683.1, Q684.1, R1361.1, R1363.1, R1365.1, R1367.1
LV851: JP681.5, Q683.2, R1365.2
LV852: JP681.6, Q682.2, R1363.2
LV853: JP681.1, Q681.2, R1361.2
LV854: JP681.2, Q684.2, R1367.2
LV855: JP685.4, Q685.1, Q686.1, Q687.1, Q688.1, R1369.1, R1371.1, R1373.1, R1375.1
LV856: JP685.5, Q687.2, R1373.2
LV857: JP685.6, Q686.2, R1371.2
LV858: JP685.1, Q685.2, R1369.2
LV859: JP685.2, Q688.2, R1375.2
LV860: JP689.4, Q689.1, Q690.1, Q691.1, Q692.1, R1377.1, R1379.1, R1381.1, R1383.1
LV861: JP689.5, Q691.2, R1381.2
LV862: JP689.6, Q690.2, R1379.2
LV863: JP689.1, Q689.2, R1377.2
LV864: JP689.2, Q692.2, R1383.2
LV865: JP693.4, Q693.1, Q694.1, Q695.1, Q696.1, R1385.1, R1387.1, R1389.1, R1391.1
LV866: JP693.5, Q695.2, R1389.2
LV867: JP693.6, Q694.2, R1387.2
LV868: JP693.1, Q693.2, R1385.2
LV869: JP693.2, Q696.2, R1391.2
LV870: JP697.4, Q697.1, Q698.1, Q699.1, Q700.1, R1393.1, R1395.1, R1397.1, R1399.1
LV871: JP697.5, Q699.2, R1397.2
LV872: JP697.6, Q698.2, R1395.2
LV873: JP697.1, Q697.2, R1393.2
LV874: JP697.2, Q700.2, R1399.2
LV875: JP701.4, Q701.1, Q702.1, Q703.1, Q704.1, R1401.1, R1403.1, R1405.1, R1407.1
LV876: JP701.5, Q703.2, R1405.2
LV877: JP701.6, Q702.2, R1403.2
LV878: JP701.1, Q701.2, R1401.2
LV879: JP701.2, Q704.2, R1407.2
LV880: JP705.4, Q705.1, Q706.1, Q707.1, Q708.1, R1409.1, R1411.1, R1413.1, R1415.1
LV881: JP705.5, Q707.2, R1413.2
LV882: JP705.6, Q706.2, R1411.2
LV883: JP705.1, Q705.2, R1409.2
LV884: JP705.2, Q708.2, R1415.2
LV885: JP709.4, Q709.1, Q710.1, Q711.1, Q712.1, R1417.1, R1419.1, R1421.1, R1423.1
LV886: JP709.5, Q711.2, R1421.2
LV887: JP709.6, Q710.2, R1419.2
LV888: JP709.1, Q709.2, R1417.2
LV889: JP709.2, Q712.2, R1423.2
LV890: JP713.4, Q713.1, Q714.1, Q715.1, Q716.1, R1425.1, R1427.1, R1429.1, R1431.1
LV891: JP713.5, Q715.2, R1429.2
LV892: JP713.6, Q714.2, R1427.2
LV893: JP713.1, Q713.2, R1425.2
LV894: JP713.2, Q716.2, R1431.2
LV895: JP717.4, Q717.1, Q718.1, Q719.1, Q720.1, R1433.1, R1435.1, R1437.1, R1439.1
LV896: JP717.5, Q719.2, R1437.2
LV897: JP717.6, Q718.2, R1435.2
LV898: JP717.1, Q717.2, R1433.2
LV899: JP717.2, Q720.2, R1439.2
LV900: JP721.4, Q721.1, Q722.1, Q723.1, Q724.1, R1441.1, R1443.1, R1445.1, R1447.1
LV901: JP721.5, Q723.2, R1445.2
LV902: JP721.6, Q722.2, R1443.2
LV903: JP721.1, Q721.2, R1441.2
LV904: JP721.2, Q724.2, R1447.2
LV905: JP725.4, Q725.1, Q726.1, Q727.1, Q728.1, R1449.1, R1451.1, R1453.1, R1455.1
LV906: JP725.5, Q727.2, R1453.2
LV907: JP725.6, Q726.2, R1451.2
LV908: JP725.1, Q725.2, R1449.2
LV909: JP725.2, Q728.2, R1455.2
LV910: JP729.4, Q729.1, Q730.1, Q731.1, Q732.1, R1457.1, R1459.1, R1461.1, R1463.1
LV911: JP729.5, Q731.2, R1461.2
LV912: JP729.6, Q730.2, R1459.2
LV913: JP729.1, Q729.2, R1457.2
LV914: JP729.2, Q732.2, R1463.2
LV915: JP733.4, Q733.1, Q734.1, Q735.1, Q736.1, R1465.1, R1467.1, R1469.1, R1471.1
LV916: JP733.5, Q735.2, R1469.2
LV917: JP733.6, Q734.2, R1467.2
LV918: JP733.1, Q733.2, R1465.2
LV919: JP733.2, Q736.2, R1471.2
LV920: JP737.4, Q737.1, Q738.1, Q739.1, Q740.1, R1473.1, R1475.1, R1477.1, R1479.1
LV921: JP737.5, Q739.2, R1477.2
LV922: JP737.6, Q738.2, R1475.2
LV923: JP737.1, Q737.2, R1473.2
LV924: JP737.2, Q740.2, R1479.2
LV925: JP741.4, Q741.1, Q742.1, Q743.1, Q744.1, R1481.1, R1483.1, R1485.1, R1487.1
LV926: JP741.5, Q743.2, R1485.2
LV927: JP741.6, Q742.2, R1483.2
LV928: JP741.1, Q741.2, R1481.2
LV929: JP741.2, Q744.2, R1487.2
LV930: JP745.4, Q745.1, Q746.1, Q747.1, Q748.1, R1489.1, R1491.1, R1493.1, R1495.1
LV931: JP745.5, Q747.2, R1493.2
LV932: JP745.6, Q746.2, R1491.2
LV933: JP745.1, Q745.2, R1489.2
LV934: JP745.2, Q748.2, R1495.2
LV935: JP749.4, Q749.1, Q750.1, Q751.1, Q752.1, R1497.1, R1499.1, R1501.1, R1503.1
LV936: JP749.5, Q751.2, R1501.2
LV937: JP749.6, Q750.2, R1499.2
LV938: JP749.1, Q749.2, R1497.2
LV939: JP749.2, Q752.2, R1503.2
LV940: JP753.4, Q753.1, Q754.1, Q755.1, Q756.1, R1505.1, R1507.1, R1509.1, R1511.1
LV941: JP753.5, Q755.2, R1509.2
LV942: JP753.6, Q754.2, R1507.2
LV943: JP753.1, Q753.2, R1505.2
LV944: JP753.2, Q756.2, R1511.2
LV945: JP757.4, Q757.1, Q758.1, Q759.1, Q760.1, R1513.1, R1515.1, R1517.1, R1519.1
LV946: JP757.5, Q759.2, R1517.2
LV947: JP757.6, Q758.2, R1515.2
LV948: JP757.1, Q757.2, R1513.2
LV949: JP757.2, Q760.2, R1519.2
LV950: JP761.4, Q761.1, Q762.1, Q763.1, Q764.1, R1521.1, R1523.1, R1525.1, R1527.1
LV951: JP761.5, Q763.2, R1525.2
LV952: JP761.6, Q762.2, R1523.2
LV953: JP761.1, Q761.2, R1521.2
LV954: JP761.2, Q764.2, R1527.2
LV955: JP765.4, Q765.1, Q766.1, Q767.1, Q768.1, R1529.1, R1531.1, R1533.1, R1535.1
LV956: JP765.5, Q767.2, R1533.2
LV957: JP765.6, Q766.2, R1531.2
LV958: JP765.1, Q765.2, R1529.2
LV959: JP765.2, Q768.2, R1535.2
LV960: JP769.4, Q769.1, Q770.1, Q771.1, Q772.1, R1537.1, R1539.1, R1541.1, R1543.1
LV961: JP769.5, Q771.2, R1541.2
LV962: JP769.6, Q770.2, R1539.2
LV963: JP769.1, Q769.2, R1537.2
LV964: JP769.2, Q772.2, R1543.2
LV965: JP773.4, Q773.1, Q774.1, Q775.1, Q776.1, R1545.1, R1547.1, R1549.1, R1551.1
LV966: JP773.5, Q775.2, R1549.2
LV967: JP773.6, Q774.2, R1547.2
LV968: JP773.1, Q773.2, R1545.2
LV969: JP773.2, Q776.2, R1551.2
LV970: JP777.4, Q777.1, Q778.1, Q779.1, Q780.1, R1553.1, R1555.1, R1557.1, R1559.1
LV971: JP777.5, Q779.2, R1557.2
LV972: JP777.6, Q778.2, R1555.2
LV973: JP777.1, Q777.2, R1553.2
LV974: JP777.2, Q780.2, R1559.2
LV975: JP781.4, Q781.1, Q782.1, Q783.1, Q784.1, R1561.1, R1563.1, R1565.1, R1567.1
LV976: JP781.5, Q783.2, R1565.2
LV977: JP781.6, Q782.2, R1563.2
LV978: JP781.1, Q781.2, R1561.2
LV979: JP781.2, Q784.2, R1567.2
LV980: JP785.4, Q785.1, Q786.1, Q787.1, Q788.1, R1569.1, R1571.1, R1573.1, R1575.1
LV981: JP785.5, Q787.2, R1573.2
LV982: JP785.6, Q786.2, R1571.2
LV983: JP785.1, Q785.2, R1569.2
LV984: JP785.2, Q788.2, R1575.2
LV985: JP789.4, Q789.1, Q790.1, Q791.1, Q792.1, R1577.1, R1579.1, R1581.1, R1583.1
LV986: JP789.5, Q791.2, R1581.2
LV987: JP789.6, Q790.2, R1579.2
LV988: JP789.1, Q789.2, R1577.2
LV989: JP789.2, Q792.2, R1583.2
LV990: JP793.4, Q793.1, Q794.1, Q795.1, Q796.1, R1585.1, R1587.1, R1589.1, R1591.1
LV991: JP793.5, Q795.2, R1589.2
LV992: JP793.6, Q794.2, R1587.2
LV993: JP793.1, Q793.2, R1585.2
LV994: JP793.2, Q796.2, R1591.2
LV995: JP797.4, Q797.1, Q798.1, Q799.1, Q800.1, R1593.1, R1595.1, R1597.1, R1599.1
LV996: JP797.5, Q799.2, R1597.2
LV997: JP797.6, Q798.2, R1595.2
LV998: JP797.1, Q797.2, R1593.2
LV999: JP797.2, Q800.2, R1599.2
LV1000: JP801.4, Q801.1, Q802.1, Q803.1, Q804.1, R1601.1, R1603.1, R1605.1, R1607.1
LV1001: JP801.5, Q803.2, R1605.2
LV1002: JP801.6, Q802.2, R1603.2
LV1003: JP801.1, Q801.2, R1601.2
LV1004: JP801.2, Q804.2, R1607.2
LV1005: JP805.4, Q805.1, Q806.1, Q807.1, Q808.1, R1609.1, R1611.1, R1613.1, R1615.1
LV1006: JP805.5, Q807.2, R1613.2
LV1007: JP805.6, Q806.2, R1611.2
LV1008: JP805.1, Q805.2, R1609.2
LV1009: JP805.2, Q808.2, R1615.2
LV1010: JP809.4, Q809.1, Q810.1, Q811.1, Q812.1, R1617.1, R1619.1, R1621.1, R1623.1
LV1011: JP809.5, Q811.2, R1621.2
LV1012: JP809.6, Q810.2, R1619.2
LV1013: JP809.1, Q809.2, R1617.2
LV1014: JP809.2, Q812.2, R1623.2
LV1015: JP813.4, Q813.1, Q814.1, Q815.1, Q816.1, R1625.1, R1627.1, R1629.1, R1631.1
LV1016: JP813.5, Q815.2, R1629.2
LV1017: JP813.6, Q814.2, R1627.2
LV1018: JP813.1, Q813.2, R1625.2
LV1019: JP813.2, Q816.2, R1631.2
LV1020: JP817.4, Q817.1, Q818.1, Q819.1, Q820.1, R1633.1, R1635.1, R1637.1, R1639.1
LV1021: JP817.5, Q819.2, R1637.2
LV1022: JP817.6, Q818.2, R1635.2
LV1023: JP817.1, Q817.2, R1633.2
LV1024: JP817.2, Q820.2, R1639.2
LV1025: JP821.4, Q821.1, Q822.1, Q823.1, Q824.1, R1641.1, R1643.1, R1645.1, R1647.1
LV1026: JP821.5, Q823.2, R1645.2
LV1027: JP821.6, Q822.2, R1643.2
LV1028: JP821.1, Q821.2, R1641.2
LV1029: JP821.2, Q824.2, R1647.2
LV1030: JP825.4, Q825.1, Q826.1, Q827.1, Q828.1, R1649.1, R1651.1, R1653.1, R1655.1
LV1031: JP825.5, Q827.2, R1653.2
LV1032: JP825.6, Q826.2, R1651.2
LV1033: JP825.1, Q825.2, R1649.2
LV1034: JP825.2, Q828.2, R1655.2
LV1035: JP829.4, Q829.1, Q830.1, Q831.1, Q832.1, R1657.1, R1659.1, R1661.1, R1663.1
LV1036: JP829.5, Q831.2, R1661.2
LV1037: JP829.6, Q830.2, R1659.2
LV1038: JP829.1, Q829.2, R1657.2
LV1039: JP829.2, Q832.2, R1663.2
LV1040: JP833.4, Q833.1, Q834.1, Q835.1, Q836.1, R1665.1, R1667.1, R1669.1, R1671.1
LV1041: JP833.5, Q835.2, R1669.2
LV1042: JP833.6, Q834.2, R1667.2
LV1043: JP833.1, Q833.2, R1665.2
LV1044: JP833.2, Q836.2, R1671.2
LV1045: JP837.4, Q837.1, Q838.1, Q839.1, Q840.1, R1673.1, R1675.1, R1677.1, R1679.1
LV1046: JP837.5, Q839.2, R1677.2
LV1047: JP837.6, Q838.2, R1675.2
LV1048: JP837.1, Q837.2, R1673.2
LV1049: JP837.2, Q840.2, R1679.2
LV1050: JP841.4, Q841.1, Q842.1, Q843.1, Q844.1, R1681.1, R1683.1, R1685.1, R1687.1
LV1051: JP841.5, Q843.2, R1685.2
LV1052: JP841.6, Q842.2, R1683.2
LV1053: JP841.1, Q841.2, R1681.2
LV1054: JP841.2, Q844.2, R1687.2
LV1055: JP845.4, Q845.1, Q846.1, Q847.1, Q848.1, R1689.1, R1691.1, R1693.1, R1695.1
LV1056: JP845.5, Q847.2, R1693.2
LV1057: JP845.6, Q846.2, R1691.2
LV1058: JP845.1, Q845.2, R1689.2
LV1059: JP845.2, Q848.2, R1695.2
LV1060: JP849.4, Q849.1, Q850.1, Q851.1, Q852.1, R1697.1, R1699.1, R1701.1, R1703.1
LV1061: JP849.5, Q851.2, R1701.2
LV1062: JP849.6, Q850.2, R1699.2
LV1063: JP849.1, Q849.2, R1697.2
LV1064: JP849.2, Q852.2, R1703.2
LV1065: JP853.4, Q853.1, Q854.1, Q855.1, Q856.1, R1705.1, R1707.1, R1709.1, R1711.1
LV1066: JP853.5, Q855.2, R1709.2
LV1067: JP853.6, Q854.2, R1707.2
LV1068: JP853.1, Q853.2, R1705.2
LV1069: JP853.2, Q856.2, R1711.2
LV1070: JP857.4, Q857.1, Q858.1, Q859.1, Q860.1, R1713.1, R1715.1, R1717.1, R1719.1
LV1071: JP857.5, Q859.2, R1717.2
LV1072: JP857.6, Q858.2, R1715.2
LV1073: JP857.1, Q857.2, R1713.2
LV1074: JP857.2, Q860.2, R1719.2
LV1075: JP861.4, Q861.1, Q862.1, Q863.1, Q864.1, R1721.1, R1723.1, R1725.1, R1727.1
LV1076: JP861.5, Q863.2, R1725.2
LV1077: JP861.6, Q862.2, R1723.2
LV1078: JP861.1, Q861.2, R1721.2
LV1079: JP861.2, Q864.2, R1727.2
LV1080: JP865.4, Q865.1, Q866.1, Q867.1, Q868.1, R1729.1, R1731.1, R1733.1, R1735.1
LV1081: JP865.5, Q867.2, R1733.2
LV1082: JP865.6, Q866.2, R1731.2
LV1083: JP865.1, Q865.2, R1729.2
LV1084: JP865.2, Q868.2, R1735.2
LV1085: JP869.4, Q869.1, Q870.1, Q871.1, Q872.1, R1737.1, R1739.1, R1741.1, R1743.1
LV1086: JP869.5, Q871.2, R1741.2
LV1087: JP869.6, Q870.2, R1739.2
LV1088: JP869.1, Q869.2, R1737.2
LV1089: JP869.2, Q872.2, R1743.2
LV1090: JP873.4, Q873.1, Q874.1, Q875.1, Q876.1, R1745.1, R1747.1, R1749.1, R1751.1
LV1091: JP873.5, Q875.2, R1749.2
LV1092: JP873.6, Q874.2, R1747.2
LV1093: JP873.1, Q873.2, R1745.2
LV1094: JP873.2, Q876.2, R1751.2
LV1095: JP877.4, Q877.1, Q878.1, Q879.1, Q880.1, R1753.1, R1755.1, R1757.1, R1759.1
LV1096: JP877.5, Q879.2, R1757.2
LV1097: JP877.6, Q878.2, R1755.2
LV1098: JP877.1, Q877.2, R1753.2
LV1099: JP877.2, Q880.2, R1759.2
LV1100: JP881.4, Q881.1, Q882.1, Q883.1, Q884.1, R1761.1, R1763.1, R1765.1, R1767.1
LV1101: JP881.5, Q883.2, R1765.2
LV1102: JP881.6, Q882.2, R1763.2
LV1103: JP881.1, Q881.2, R1761.2
LV1104: JP881.2, Q884.2, R1767.2
LV1105: JP885.4, Q885.1, Q886.1, Q887.1, Q888.1, R1769.1, R1771.1, R1773.1, R1775.1
LV1106: JP885.5, Q887.2, R1773.2
LV1107: JP885.6, Q886.2, R1771.2
LV1108: JP885.1, Q885.2, R1769.2
LV1109: JP885.2, Q888.2, R1775.2
LV1110: JP889.4, Q889.1, Q890.1, Q891.1, Q892.1, R1777.1, R1779.1, R1781.1, R1783.1
LV1111: JP889.5, Q891.2, R1781.2
LV1112: JP889.6, Q890.2, R1779.2
LV1113: JP889.1, Q889.2, R1777.2
LV1114: JP889.2, Q892.2, R1783.2
LV1115: JP893.4, Q893.1, Q894.1, Q895.1, Q896.1, R1785.1, R1787.1, R1789.1, R1791.1
LV1116: JP893.5, Q895.2, R1789.2
LV1117: JP893.6, Q894.2, R1787.2
LV1118: JP893.1, Q893.2, R1785.2
LV1119: JP893.2, Q896.2, R1791.2
