RoboJackets/roboracing-electrical/(commit log)

2017-02-12 Uploading initial pcb schematic and library
    [Joulev1.sch]
2017-02-14 updated pcb
    [Joulev1.sch]
2017-02-15 added Readme
    [Joulev1.sch]
2017-02-15 a bit of repo cleanup
    [Joulev1.sch]
2017-02-20 updated files, added V2 for real time support using ATMega328P
    [Joulev2_RealTime.sch]
2017-02-21 updated to ATMega328p
    [Joulev2_RealTime.sch]
2017-02-26 further progress on pin layouts for ATMega, to do = add usb and programming pins
    [Joulev2_RealTime.sch]
2017-02-28 updates on pcb, still need to look into usb information.
    [Joulev2_RealTime.sch]
2017-03-06 inital board design
    [PCB (beta).sch]
2017-03-07 incomplete to page 10
    [PCB (beta).sch]
2017-03-15 Added more parts to library, 1 piece left for top 'library devices' section
2017-04-04 added battery holder
2017-04-04 Added Spreadsheet for Parts
    [PartsToCADSpreadsheet.xlsx]
2017-04-04 added parts to cad excel sheet
    added parts to cad excel sheet
2017-04-04 prioritized Joule connector
    [PartsToCADSpreadsheet.xlsx]
2017-04-06 final stages
    [PCB(beta).sch]
2017-04-06 added 100 pin connector
    [PartsToCADSpreadsheet.xlsx]
2017-04-08 updated excel sheet
    [PartsToCADSpreadsheet.xlsx]
2017-04-08 added usb power chip
    [PartsToCADSpreadsheet.xlsx]
2017-04-11 Added Kill Switch, Vehicle Control Unit, and Libraries
    Added Kill Switch, Vehicle Control Unit, and Libraries
2017-04-24 added USB hub
    [Joulev2_RealTime.sch]
2017-04-24 fixed hub & added template
    [Joulev2_RealTime.brd, Joulev2_RealTime.sch]
2017-04-25 updated schematic sheets
    [Joulev2_RealTime.sch]
2017-04-25 updated schematic added attiny
    [Joulev2_RealTime.sch]
2017-04-26 Initial placement of components for board
    90% of board placed for initial version.
    [Joulev2_RealTime.brd, Joulev2_RealTime.sch]
2017-04-26 'fixed' chaos
    [Joulev2_RealTime.brd, Joulev2_RealTime.sch]
2017-04-26 Post-"Chaos" Initial Placement of Board Components
    About 95% complete on component placement.
    [Joulev2_RealTime.brd]
2017-04-26 Minor Fixes
    [Joulev2_RealTime.brd]
2017-04-26 Reorganized schematic pre-routing
    [Joulev2_RealTime.brd]
2017-04-27 80% routed board
    [Joulev2_RealTime.brd]
2017-04-30 tweaked schematic, believe it is complete, now to finish routing.
    [Joulev2_RealTime.brd, Joulev2_RealTime.sch]
2017-05-05 inital commit
    [Joulev2_RealTime.brd, Joulev2_RealTime.sch]
2017-05-06 almost done USB2.0
    [Joulev2_RealTime.sch]
2017-05-06 minor updates on usb2.0
    [BOM.xlsx, Joulev2_RealTime.sch]
2017-05-09 5/9/17
    Finished majority of component placement and routing
    [Joulev2_RealTime.brd, Joulev2_RealTime.sch]
2017-05-10 5/9/17 v2
    [Joulev2_RealTime.brd]
2017-05-11 pre-final stages
    [Joulev2_RealTime.brd, Joulev2_RealTime.sch]
2017-05-15 new regulator
    [Joulev2_RealTime.brd, Joulev2_RealTime.sch]
2017-05-15 Added mosfet driver
    [Joulev2_RealTime.sch]
2017-05-15 Fixed f/b, more routing
    [Joulev2_RealTime.brd, Joulev2_RealTime.sch]
2017-05-16 done? take 2
    [Joulev2_RealTime.brd, Joulev2_RealTime.sch]
2017-05-16 done? take 3
    [Joulev2_RealTime.brd, Joulev2_RealTime.sch]
2017-05-16 done? take 4
    [Joulev2_RealTime.brd, Joulev2_RealTime.sch]
2017-05-18 Added BOM spreadsheet
    [BOM_Spreadsheet.xlsx, Joulev2_RealTime.csv]
2017-05-19 adding items to BOM
    [BOM_Spreadsheet.xlsx]
2017-05-24 further added to BOM
    [BOM_Spreadsheet.xlsx]
2017-05-25 completed BOM spreadsheet, updated a part in a library.
    [BOM_Spreadsheet.xlsx]
2017-05-28 Adds first pass at Car Wars PCB.
    [CarWarsPCB.brd, CarWarsPCB.sch]
2017-05-30 Updated CarWars PCB
    Adds barrel jack for power
    Re-arranges board
    Adds e-stop status connector
    [CarWarsPCB.brd, CarWarsPCB.sch]
2017-06-05 Updates CarWars PCB
    Adds connector for SprkFun Current/Voltage sensor
    Adds mounting holes to board layout
    [CarWarsPCB.brd, CarWarsPCB.sch]
2017-06-06 CarWars PCB Prototype finalization
    Implements Ryo's recommended changes to OSMC
    [CarWarsPCB.brd, CarWarsPCB.sch]
2017-09-18 Added ground changes, 3.3V to 5V logic shifter, diode to prevent mbed powering neopixel
    [CarWarsPCB.brd, CarWarsPCB.sch]
2017-09-22 Components laid out on the board
    [CarWarsPCB.brd, CarWarsPCB.sch]
2017-09-24 post review
    [CarWarsPCB.brd, CarWarsPCB.sch]
2017-09-25 Revert "Merge branch 'matt-carwars' of https://github.com/RoboJackets/roboracing-electrical into matt-carwars"
    This reverts commit f9da5e68138cf5e13760f0d0aa1d1b2e0e8a3923, reversing
    changes made to ac928bc71658feb40b7cd871a8aed9ac497dfdbc.
    [CarWarsPCB.brd, CarWarsPCB.sch]
2017-09-25 Updated design changes, under v2
    [CarWarsPCBv_2.brd, CarWarsPCBv_2.sch]
2017-09-28 Adds mounting holes & car wars gerbers
    [CarWarsPCBv_2.GBL, CarWarsPCBv_2.GBO, CarWarsPCBv_2.GBP, CarWarsPCBv_2.GBS, CarWarsPCBv_2.GTL, CarWarsPCBv_2.GTO, CarWarsPCBv_2.GTP, CarWarsPCBv_2.GTS]
2017-10-24 Additional reorganization
    [BOM_Spreadsheet.xlsx, CarWarsPCB.brd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]
2017-11-20 Fixed Routing so Pot runs at 3v3. Added Resistor and Capacitor Values.
    [CarWarsPCBv_2.brd, CarWarsPCBv_2.sch]
2017-11-21 Improve routing efficiency
    [CarWarsPCBv_2.brd]
2017-11-21 Added corrected spec-ed capacitor and resistor for neopixel
    [CarWarsPCBv_2.brd, CarWarsPCBv_2.sch]
2017-12-24 Removed old gerbers, updated board to spaced out layout
    [CarWarsPCBv_2.GBL, CarWarsPCBv_2.GBO, CarWarsPCBv_2.GBP, CarWarsPCBv_2.GBS, CarWarsPCBv_2.GTL, CarWarsPCBv_2.GTO, CarWarsPCBv_2.GTP, CarWarsPCBv_2.GTS]
2017-12-29 Added Doughi ultrasonic board
    [mux-board.sch]
2017-12-29 Added Bigoli Mbed shield library and schematic frames
    [CarWarsPCBv_3.sch]
2018-01-09 Imports hardware interface board design files.
    [hw_interface_board.brd, hw_interface_board.sch]
2018-01-15 Made Schematic Neater
    [mux-board.brd, mux-board.sch]
2018-01-16 Post Design Review of Bigoli Shield
    [CarWarsPCBv_3.brd, CarWarsPCBv_3.sch]
2018-01-22 Ultrasonic Mux Board Pre-Review
    [mux-board.brd, mux-board.sch]
2018-01-23 Fixes clearance issues based on Seeed Studios DRU
    [hw_interface_board.brd]
2018-01-27 Checked SeeedStudio design and fixed small routing issues
    [CarWarsPCBv_3.brd]
2018-01-30 Created gerbers, changed resistor symbols
    [CarWarsPCBv_3.GBL, CarWarsPCBv_3.GBO, CarWarsPCBv_3.GBP, CarWarsPCBv_3.GBS, CarWarsPCBv_3.GTL, CarWarsPCBv_3.GTO, CarWarsPCBv_3.GTP, CarWarsPCBv_3.GTS]
2018-01-31 Adds mounting holes to Macaroni PCB
    [hw_interface_board.brd]
2018-02-01 Finished routing Ultrasonic board
    [mux-board.brd, mux-board.sch]
2018-02-03 Made small routing changes to the mux board
    [mux-board.brd, mux-board.sch]
2018-02-03 Changed schematic outlining to the proper layer
    [mux-board.sch]
2018-02-04 Generated gerbers for HW interface board
    [hw_interface_board.GBL, hw_interface_board.GBO, hw_interface_board.GBP, hw_interface_board.GBS, hw_interface_board.GTL, hw_interface_board.GTO, hw_interface_board.GTP, hw_interface_board.GTS]
2018-02-06 Resized board and made traces thicker
    [mux-board.brd, mux-board.dxf, mux-board.sch]
2018-02-13 Aesthetic Additions
    [mux-board.brd]
2018-02-25 Added Crystal Oscillator and BOM
    [BillOfMaterials.xlsx, mux-board.brd, mux-board.csv, mux-board.sch]
2018-02-25 Renamed Doughi to Sedani
    [BillOfMaterials.xlsx, mux-board.brd, mux-board.csv, mux-board.dxf, mux-board.sch]
2018-03-01 updated with new connector positions and CAM
    [mux-board.GBL, mux-board.GBO, mux-board.GBP, mux-board.GBS, mux-board.GTL, mux-board.GTO, mux-board.GTP, mux-board.GTS]
2018-03-06 Added e-stop directory (which contains the IGVC repo)
    [RJ_IGVC_Estop.brd, RJ_IGVC_Estop.sch]
2018-03-23 Added more functionality to wireless remote, added speaker, fixed pin orientation
    [hw_interface_board.brd, hw_interface_board.sch]
2018-03-27 Created gerbers for new macaroni control board
    [hw_interface_board.GBL, hw_interface_board.GBO, hw_interface_board.GBP, hw_interface_board.GBS, hw_interface_board.GTL, hw_interface_board.GTO, hw_interface_board.GTP, hw_interface_board.GTS]
2018-05-15 Restructure reposistory, changed board
    Flip mux slave output
    Incorperated sound board
    Removed extraneous headers
    Replaced existing diodes with better sized diodes
    Added 5V Regulator
    Added Relay
    [hw_interface_board.brd, hw_interface_board.sch]
2018-05-16 Final Changes to Sedani Chassis Control Board
    [hw_interface_board.sch, sedani_chassis_control.brd, sedani_chassis_control.sch]
2018-05-16 Corrected speaker enable to disable
    [sedani_chassis_control.brd, sedani_chassis_control.sch]
2018-05-17 Moved e-stop input routing for better connection
    [sedani_chassis_control.brd, sedani_chassis_control.sch]
2018-05-17 Changed Sparkfun name layer, generated gerbers
    [sedani_chassis_control.GBL, sedani_chassis_control.GBO, sedani_chassis_control.GBP, sedani_chassis_control.GBS, sedani_chassis_control.GTL, sedani_chassis_control.GTO, sedani_chassis_control.GTP, sedani_chassis_control.GTS]
2018-08-05 Cleaned up library, re-routed new connectors
    [CarWarsPCBv_3.brd, CarWarsPCBv_3.sch]
2018-08-06 Curved the board edges, cleaned up hole placement
    [CarWarsPCBv_3.brd]
2018-08-07 Added gerbers, generated image
    [CarWarsPCBv_3.GBL, CarWarsPCBv_3.GBO, CarWarsPCBv_3.GBP, CarWarsPCBv_3.GBS, CarWarsPCBv_3.GTL, CarWarsPCBv_3.GTO, CarWarsPCBv_3.GTP, CarWarsPCBv_3.GTS]
2018-08-07 Corrected gerbers
    [copper_bottom.gbr, copper_top.gbr, drills.xln, gerber_job.gbrjob, profile.gbr, silkscreen_bottom.gbr, silkscreen_top.gbr, soldermask_bottom.gbr]
2018-08-13 Archive macaroni content
    [hw_interface_board.GBL, hw_interface_board.GBO, hw_interface_board.GBP, hw_interface_board.GBS, hw_interface_board.GTL, hw_interface_board.GTO, hw_interface_board.GTP, hw_interface_board.GTS]
2018-08-26 Fixed connector solder vias and generated gerbers
    [CarWarsPCBv_3.brd, CarWarsPCBv_3.sch]
2018-11-06 Staring to create schematic and board for neopixel controller
    [Eagle.sch, neopixel_board.sch]
2018-11-06 Update lidar-breakout/LIDAR_Breakout.sch
    initial commit
    Work-In-Progress
    [LIDAR_Breakout.sch]
2018-11-09 Updates
    Added Wiznet Header, Added 3.3V Voltage Regulator, Minor Updates
    [LIDAR_Breakout.brd, LIDAR_BreakoutV2.sch]
2018-11-09 -WIP-Started Board Layout
    -WIP-Started Board Layout
    [LIDAR_Breakout.brd, LIDAR_Breakout.sch]
2018-11-12 Updated Board Layout
    Updated Board Layout, needs more work
    [LIDAR_Breakout.brd, LIDAR_Breakout.sch]
2018-11-13 Added WIZio Library
    [LIDAR_Breakout.brd]
2018-11-13 WIP shematic
    [BOM_Spreadsheet.xlsx, BillOfMaterials.xlsx, CarWarsPCBv_3.brd, CarWarsPCBv_3.csv, CarWarsPCBv_3.sch, Joulev2_RealTime.brd, Joulev2_RealTime.sch, LIDAR_Breakout.brd]
2018-11-15 Continued Updates
    Board almost ready for design review
    -Needs a different LDO linear voltage regulator and heat sinking
    [LIDAR_Breakout.brd, LIDAR_Breakout.sch]
2018-11-19 Update neopixel_board/neopixel_board.sch
    WIP contunuing to update neopixel schematic
    [neopixel_board.sch]
2018-11-20 ixed some stuff on the HW control board
    [control_board_3.1_parts.xlsx, sedani_chassis_control.brd, sedani_chassis_control.sch]
2018-11-20 Cleaned up airwires
    [LIDAR_Breakout.brd, LIDAR_Breakout.sch]
2018-11-20 Neopixel Schematic WIP cont.
    [PCAPH.sym.sch, PCAPV.sym.sch, PCAP_8x10-ELECT-L.pac.sch, PCAP_8x10-ELECT-M.pac.sch, PCAP_8x10-ELECT.pac.sch, neopixel_board.sch]
2018-11-22 Cleaned up labels for parts
    [LIDAR_Breakout.brd, LIDAR_Breakout.sch]
2018-11-23 Layout Optimizations, Silkscreen Updates
    [LIDAR_Breakout.brd, LIDAR_Breakout.sch]
2018-11-23 More Silkscreen Updates
    [LIDAR_Breakout.brd]
2018-11-23 WIP cont
    Need to connect connectors to neopixelstrips and ATMega pins. Look at resistor specs on voltage reg LEDs.
    [SparkFun_Pro_Micro_v13a.sch, neopixel_board.sch]
2018-11-24 Added voltage regulator, cleaned up transistor layout
    [sedani_chassis_control.brd, sedani_chassis_control.sch]
2018-11-24 Added passive components for voltage regulator
    [sedani_chassis_control.brd, sedani_chassis_control.sch]
2018-11-25 Silkscreen cleanup
    [LIDAR_Breakout.brd, LIDAR_Breakout.sch]
2018-11-25 Cleanup, Added Thermals
    [LIDAR_Breakout.brd]
2018-11-26 added flyback diode and worked on routing
    [control_board_3.1_parts.xlsx, sedani_chassis_control.brd, sedani_chassis_control.sch]
2018-11-26 Finish SSCH start board
    [BOM_Spreadsheet.xlsx, BillOfMaterials.xlsx, CarWarsPCBv_3.brd, CarWarsPCBv_3.csv, CarWarsPCBv_3.sch, Joulev2_RealTime.brd, Joulev2_RealTime.sch, LIDAR_Breakout.brd]
2018-11-27 Design Review Changes
    [LIDAR_Breakout.brd, LIDAR_Breakout.sch, LIDAR_BreakoutV2.sch]
2018-11-27 Post Review Updates
    [LIDAR_Breakout.brd, LIDAR_Breakout.sch]
2018-11-27 SCH fixes and BRD WIP
    [neopixel_board.brd, neopixel_board.sch]
2018-11-27 Major Updates - View Task List for changelog
    [LIDAR_Breakout.brd, LIDAR_Breakout.sch]
2018-11-27 fixed broken wire and changed decoupling cap from VCC to VCC1
    [LIDAR_Breakout.brd, LIDAR_Breakout.sch]
2018-11-27 Added addtional TODOs and cleaned up small things
    [LIDAR_Breakout.brd, LIDAR_Breakout.sch]
2018-11-27 Revert "Added addtional TODOs and cleaned up small things"
    This reverts commit 2aa885b0454392678a68b29d995a4b75eb9078ff.
    [LIDAR_Breakout.brd, LIDAR_Breakout.sch]
2018-11-28 Added fuses, device placement, rounting
    [LIDAR_Breakout.brd, LIDAR_Breakout.sch]
2018-11-28 Finished schematic changes
    Added NeoPixel Status
    Aligned block in bottom corner
    Re-ordered component names
    [LIDAR_Breakout.brd, LIDAR_Breakout.sch]
2018-11-29 Added TODO for Schematic and Board
2018-11-29 Mostly finished routing
    [LIDAR_Breakout.brd]
2018-11-29 no air wires
    [LIDAR_Breakout.brd]
2018-11-29 Aligned schematic on grid, cleaned up routing, switched power symbol
    [LIDAR_Breakout.brd, LIDAR_Breakout.sch]
2018-11-30 SCH finish BRD WIP
    [neopixel_board.brd, neopixel_board.sch]
2018-11-30 Board WIP
    Changed some names and values in schematic. Worked on postioning part on board.
    [neopixel_board.brd, neopixel_board.sch]
2018-11-30 Schematic changes
    Named neopixel connectors in order
    [neopixel_board.brd, neopixel_board.sch]
2018-11-30 redrawn logic blocks
    [LIDAR_Breakout.sch]
2018-12-03 removed individual LIDAR fuses and added power header
    [LIDAR_Breakout.brd, LIDAR_Breakout.sch]
2018-12-04 Schematic changes
    -named connectors in order
    -named VCC voltages
    [neopixel_board.sch]
2018-12-04 added i2c activity led, added reverse polarity protection, changed layer to info, labeled crystal
    [LIDAR_Breakout.sch, Partlist.xlsx]
2018-12-07 made board and schematic consistent
    [LIDAR_Breakout.sch]
2018-12-07 finished adding back all the parts I had to remove
    [LIDAR_Breakout.brd, LIDAR_Breakout.sch]
2018-12-07 changed USB to be a differential pair in EAGLE. Not routed yet.
    [LIDAR_Breakout.brd, LIDAR_Breakout.sch]
2018-12-08 started cleaning up routing. Did differential pair.
    [LIDAR_Breakout.brd, LIDAR_Breakout.sch]
2018-12-08 more routing cleanups
    [LIDAR_Breakout.brd, LIDAR_Breakout.sch]
2018-12-20 Revert "no idea why a merge comflict arose"
    This reverts commit 9ce818a81b41e02f8a936c6e2fbe08936fe72570, reversing
    changes made to 6c18adf96faf09825b13fc52f62776a6f80cfb45.
    [sedani_chassis_control.brd, sedani_chassis_control.sch]
2018-12-20 Clarified flyback diode configuration
    [sedani_chassis_control.sch]
2018-12-22 started E-stop rebuild
    [control_board_3.1_parts.xlsx, sedani_chassis_control.brd, sedani_chassis_control.sch]
2018-12-31 added e-stop MOSFET gate resistor
    [sedani_chassis_control.brd, sedani_chassis_control.sch]
2018-12-31 finished routing, pending redesigned 5V regulator
    [sedani_chassis_control.brd, sedani_chassis_control.sch]
2018-12-31 copied 5V regulator from LIDAR board into chassis control board
    [sedani_chassis_control.brd, sedani_chassis_control.sch]
2018-12-31 no DRC errors. Routed new 5V regulator. Only thing left to do is e-stop connector
    [sedani_chassis_control.brd, sedani_chassis_control.sch]
2019-01-08 Routing Updates, Design Review Updates, Cleanup
    [LIDAR_Breakout.brd, LIDAR_Breakout.sch, Partlist.xlsx, PartsList_LidarBreakout.xlsx, VoltageReg Options.xlsx]
2019-01-08 added transistor to cut control line
    [sedani_chassis_control.brd, sedani_chassis_control.sch]
2019-01-08 Updated voltage regulator
    [LIDAR_Breakout.brd, LIDAR_Breakout.sch, VoltageReg Options.xlsx]
2019-01-08 rerouted oard
    [sedani_chassis_control.brd, sedani_chassis_control.sch]
2019-01-08 fixed e-stop
    [sedani_chassis_control.brd, sedani_chassis_control.sch]
2019-01-08 really fixed e-stop
    [sedani_chassis_control.brd, sedani_chassis_control.sch]
2019-01-08 New schematic & updated library
    [neopixel_board2.sch]
2019-01-08 More updates
    [LIDAR_Breakout.brd]
2019-01-09 Finished top Silkscreen, Routing Improvements
    [LIDAR_Breakout.brd, LIDAR_Breakout.sch]
2019-01-09 Silkscreen and routing updates.
    [LIDAR_Breakout.brd]
2019-01-11 Completed Silkscreen, Ran DRC and fixed errors
    [LIDAR_Breakout.brd, LIDAR_Breakout.sch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]
2019-01-13 changed BJT to MOSFET
    [sedani_chassis_control.brd, sedani_chassis_control.sch]
2019-01-13 Schematic WIP
    Add through hole terminals to lib. Added note for connection layout.
    [neopixel_board2.sch]
2019-01-13 Changed encoder connector
    [sedani_chassis_control.brd, sedani_chassis_control.sch]
2019-01-14 Added test points and prepped silk screen
    [sedani_chassis_control.brd, sedani_chassis_control.sch]
2019-01-15 added doide for reverse polarity protection
    [sedani_chassis_control.brd, sedani_chassis_control.sch]
2019-01-15 added all github issues except button swap and servo plug
    [sedani_chassis_control.brd, sedani_chassis_control.sch]
2019-01-15 found MOSFET and transistor
    [control_board_3.1_parts.xlsx]
2019-01-15 added all the github issues
    [sedani_chassis_control.brd, sedani_chassis_control.sch]
2019-01-15 added boxes on schematic
    [sedani_chassis_control.sch]
2019-01-15 Finish SCH
    [BOM_Spreadsheet.xlsx, BillOfMaterials.xlsx, CarWarsPCBv_3.brd, CarWarsPCBv_3.csv, CarWarsPCBv_3.sch, Joulev2_RealTime.brd, Joulev2_RealTime.sch, LIDAR_Breakout.brd]
2019-01-18 Added cutouts for reset PBs
    [LIDAR_Breakout.brd]
2019-01-20 Board WIP
    [BOM_Spreadsheet.xlsx, BillOfMaterials.xlsx, CarWarsPCBv_3.brd, CarWarsPCBv_3.csv, CarWarsPCBv_3.sch, Eagle.sch, Joulev2_RealTime.brd, Joulev2_RealTime.sch]
2019-01-20 board WIP traces started
    [neopixel_board2.brd, neopixel_board2.sch]
2019-01-20 Updated several packages, finished parts list.
    [LIDAR_Breakout.brd, LIDAR_Breakout.sch, PartsList_LidarBreakout.xlsx]
2019-01-21 Added CAM Files
    [copper_bottom.gbr, copper_top.gbr, drills.xln, gerber_job.gbrjob, profile.gbr, silkscreen_bottom.gbr, silkscreen_top.gbr, soldermask_bottom.gbr]
2019-01-21 Fixed DRC
    [LIDAR_Breakout.brd]
2019-01-21 Reran cam
    [LIDAR_Breakout.brd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]
2019-01-21 Corrected file structure
    [copper_bottom.gbr, copper_top.gbr, drills.xln, gerber_job.gbrjob, profile.gbr, silkscreen_bottom.gbr, silkscreen_top.gbr, soldermask_bottom.gbr]
2019-01-22 some control board changes to move to control board branch
    [sedani_chassis_control.brd, sedani_chassis_control.sch]
2019-01-22 added transistor to run panel e-stop light
    [sedani_chassis_control.brd, sedani_chassis_control.sch]
2019-01-22 Schematic WIP
    added new USB programmer, replaced fuse, ripup of autoroute
    [PCAPH.sym.sch, PCAPV.sym.sch, PCAP_8x10-ELECT-L.pac.sch, PCAP_8x10-ELECT-M.pac.sch, PCAP_8x10-ELECT.pac.sch, neopixel_board2.brd, neopixel_board2.sch]
2019-01-22 added transistor + LED point for light
    [sedani_chassis_control.brd, sedani_chassis_control.sch]
2019-01-22 beginning work on the BOM
    [control_board_3.1_parts.xlsx, sedani_chassis_control.brd]
2019-01-22 wrote BOM - no connectors
    [control_board_3.1_parts.xlsx, sedani_chassis_control.brd, sedani_chassis_control.sch]
2019-01-22 fixed up BOM and renamed test points to useful names
    [control_board_3.1_parts.xlsx, sedani_chassis_control.brd, sedani_chassis_control.sch]
2019-01-28 Board, Schematic, Library WIP
    Updated MCU, USB library layout of board completed, need to route
    [neopixel_board2.brd, neopixel_board2.sch]
2019-01-29 Code compiles now. LED_BUILITN conflicts with the SPI bus.
2019-01-29 Parts List for Neopixel Board
    Listed main parts on board
    [partsList_Neopixel.xlsx]
2019-01-29 Schematic, Board, Library Cleanup
    ready for an autoroute
    [neopixel_board2.brd, neopixel_board2.sch]
2019-01-31 Board Finished (tentative)
    [neopixel_board.brd, neopixel_board.sch, neopixel_board2.brd, neopixel_board2.sch]
2019-01-31 Cleaned up branch, re-added library
    [Eagle.sch, SparkFun_Pro_Micro_v13a.brd, SparkFun_Pro_Micro_v13a.sch]
2019-02-03 Updated Wiz850io footprint
    [LIDAR_Breakout.brd, LIDAR_Breakout.sch]
2019-02-03 added a header for neopixles and fixed silkscreening
    [sedani_chassis_control.brd, sedani_chassis_control.sch]
2019-02-03 BRD finishing touches
    [neopixel_board.brd, neopixel_board.sch]
2019-02-05 Schematic WIP
    addressing W.S. critique
    NOTE: in changing voltage tags to symbols, BRD routes are lost
    [neopixel_board.brd, neopixel_board.sch]
2019-02-05 Fixed most of Will's critiques
    [control_board_3.1_parts.xlsx, sedani_chassis_control.brd, sedani_chassis_control.sch]
2019-02-05 added decoupling caps to neopixles and Arduino
    [control_board_3.1_parts.xlsx, sedani_chassis_control.brd, sedani_chassis_control.sch]
2019-02-05 updated board photo
2019-02-08 Schematic updates
    [neopixel_board.brd, neopixel_board.sch]
2019-02-09 Added header for 2nd speed Hall sensor
    [sedani_chassis_control.brd, sedani_chassis_control.sch]
2019-02-10 BRD and SCH ready for review
    [neopixel_board.brd, neopixel_board.sch]
2019-02-10 Pre-design review corrections
    [neopixel_board.brd, neopixel_board.sch]
2019-02-10 Small board corrections pre-design review
    [sedani_chassis_control.brd]
2019-02-11 added solder bridge to bypass diode
    [sedani_chassis_control.brd, sedani_chassis_control.sch]
2019-02-12 Control board ready to order
    [control_board_3.1_parts.xlsx, sedani_chassis_control.brd, sedani_chassis_control.sch]
2019-02-12 really ready to order (added 5V connection)
    [sedani_chassis_control.brd, sedani_chassis_control.sch]
2019-02-12 exported CAM files and added labeling to schematic
    [control_board_3.1_parts.xlsx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]
2019-02-14 Re-organized directory
    [copper_bottom.gbr, copper_top.gbr, drills.xln, gerber_job.gbrjob, profile.gbr, silkscreen_bottom.gbr, silkscreen_top.gbr, soldermask_bottom.gbr]
2019-02-16 Board and Schematic Update
    Board and schematic updated with design review changes. Still need to add level shifter for data coming off of ATMega to neopixels.
    [neopixel_board.brd, neopixel_board.sch]
2019-02-17 Small Changes
    [neopixel_board.brd, neopixel_board.sch]
2019-02-17 Board Finished
    [neopixel_board.brd, neopixel_board.sch]
2019-02-18 Updated values for crystal caps
    [LIDAR_Breakout.brd, LIDAR_Breakout.sch]
2019-02-19 changed encoders to interrupt pins
    [sedani_chassis_control.brd, sedani_chassis_control.sch]
2019-02-19 saved the files this time
    [sedani_chassis_control.brd]
2019-02-19 Cleaned up repo
    [neopixel_board.brd, neopixel_board.sch]
2019-02-19 Updated gerbers
2019-02-20 started schematic work
    [RJ_IGVC_Estop.brd, RJ_IGVC_Estop.sch, e-stop-radio.sch]
2019-02-21 Small angle corrections
    [neopixel_board.brd]
2019-02-21 Finally fixed gerbers
    [copper_bottom.gbr, copper_top.gbr, drills.xln, gerber_job.gbrjob, profile.gbr, silkscreen_bottom.gbr, silkscreen_top.gbr, soldermask_bottom.gbr]
2019-02-22 Fixed R22 Package Size, Added Error Leds
    [LIDAR_Breakout.brd, LIDAR_Breakout.sch]
2019-02-22 Clean up directory
    [BOM_Spreadsheet.xlsx, BillOfMaterials.xlsx, CarWarsPCBv_3.brd, CarWarsPCBv_3.csv, CarWarsPCBv_3.sch, Joulev2_RealTime.brd, Joulev2_RealTime.sch, LIDAR_Breakout.brd]
2019-02-25 added radio module and pin header to schematic
    [e-stop-radio.sch]
2019-02-25 broke code over into firmware
    [e-stop-radio.sch]
2019-02-25 added a voltage regulator
    [e-stop-radio.sch, estop-1.0-bom.xlsx]
2019-02-26 Added Pin Mapping
2019-02-26 began speccing voltage regulator
    [e-stop-radio.sch, estop-1.0-bom.xlsx]
2019-02-26 fixed crystal, finished voltage regulator, added LEDs
    [e-stop-radio.sch, estop-1.0-bom.xlsx]
2019-02-26 Branch Cleanup, Rev 1.1 Updates
    Added I2C IO expander and resistor array for new leds.
    [LIDAR_Breakout.brd, LIDAR_Breakout.sch, LIDAR_Breakout_V1.1.brd, LIDAR_Breakout_V1.1.sch]
2019-02-26 Added Separate VCC1 and VCC2 power LEDs
    [LIDAR_Breakout_V1.1.brd, LIDAR_Breakout_V1.1.sch]
2019-02-26 added level shifter and button header. Need antenna
    [e-stop-radio.sch, estop-1.0-bom.xlsx]
2019-02-27 changed output caps for 3.3V regulator
    [e-stop-radio.sch, estop-1.0-bom.xlsx]
2019-02-27 made a SMA connector part
    [e-stop-radio.sch, estop-1.0-bom.xlsx]
2019-02-27 changed antenna part
    [e-stop-radio.sch, estop-1.0-bom.xlsx]
2019-02-28 Switched LED directions, Fixed I2C pulled resistor
    [LIDAR_Breakout.brd, LIDAR_Breakout.sch, LIDAR_Breakout_V2.brd, LIDAR_Breakout_V2.sch]
2019-03-02 fixed library parts and generated board
    [e-stop-radio.brd, e-stop-radio.sch]
2019-03-02 major parts on board
    [e-stop-radio.brd, e-stop-radio.sch]
2019-03-03 partially routed, but going to shrink dimensions
    [e-stop-radio.brd, e-stop-radio.sch]
2019-03-04 partially layed out. Need to change SMA connector
    [e-stop-radio.brd, e-stop-radio.sch]
2019-03-04 added new connector to BOM but NOT SCHEMATIC
    [estop-1.0-bom.xlsx]
2019-03-05 changed antenna to right angle and removed crystal
    [e-stop-radio.brd, e-stop-radio.sch, estop-1.0-bom.xlsx]
2019-03-05 optimized 3.3V regulator
    [e-stop-radio.brd]
2019-03-08 Added debounce caps, Swapped USB connector to MINI, Updated Parts List
    [LIDAR_Breakout.brd, LIDAR_Breakout.sch, PartsList_LidarBreakout.xlsx]
2019-03-09 Routed separate VCC leds
    [LIDAR_Breakout.brd]
2019-03-10 fixed silkscreen and almost done routing
    [e-stop-radio.brd, e-stop-radio.sch]
2019-03-10 added documentation for solderbridge
    [sedani_chassis_control.sch]
2019-03-10 added drill holes. Moved voltage regulator
    [e-stop-radio.brd, e-stop-radio.sch]
2019-03-10 WIP - Rerouting Headers
    [LIDAR_Breakout.brd, LIDAR_Breakout.sch, PartsList_LidarBreakout.xlsx]
2019-03-10 Fixed Merge Conflict
    [LIDAR_Breakout.brd]
2019-03-11 Finished Rerouting Headers
    [LIDAR_Breakout.brd, LIDAR_Breakout.sch]
2019-03-12 Finished Routing Components
    [LIDAR_Breakout.brd]
2019-03-12 added switch part numbers to BOM
    [estop-1.0-bom.xlsx]
2019-03-12 added lipo charger to BOM
    [estop-1.0-bom.xlsx]
2019-03-14 changed 3.3V routing
    [e-stop-radio.brd]
2019-03-15 added new battery charger to docs
2019-03-16 added terminal blocks to BOM and tweaked documentation
    [estop-1.0-bom.xlsx]
2019-03-16 changed link problem in BOM
    [estop-1.0-bom.xlsx]
2019-03-16 began wiring diagram for remote
2019-03-18 Moved neopixel, silkscreen cleanup
    [LIDAR_Breakout.brd, LIDAR_Breakout.sch]
2019-03-18 Fixed DRC Errors
    [LIDAR_Breakout.brd]
2019-03-18 fixed remote wiring diagram. Board is passing DRC.
    [e-stop-radio.brd, e-stop-radio.sch]
2019-03-19 Cleaned up board routing
    [e-stop-radio.brd]
2019-03-19 A few more routing changes
    [e-stop-radio.brd]
2019-03-24 Removed Transistor, added Buffer
    [sedani_chassis_control.brd, sedani_chassis_control.sch]
2019-03-25 Added POGO Pads
    [LIDAR_Breakout.brd, LIDAR_Breakout.sch]
2019-03-25 added RoboBuzz and schematic block
    [e-stop-radio.brd, e-stop-radio.sch]
2019-03-26 added RJ silkscreening
    [e-stop-radio.brd, e-stop-radio.sch, estop-1.0-bom.xlsx]
2019-03-26 added radio to library and fixed footprint
    [e-stop-radio.brd, e-stop-radio.sch]
2019-03-26 Updated Reset PB
    [LIDAR_Breakout.brd, LIDAR_Breakout.sch]
2019-03-26 reformatted schematic
    [e-stop-radio.brd, e-stop-radio.sch]
2019-03-26 added indications for solderbridges to silkscreen
    [e-stop-radio.brd]
2019-03-26 added board pictures
2019-03-27 Minor fixes/optimization
    [LIDAR_Breakout.brd]
2019-03-27 Updated LED resistor values
    [LIDAR_Breakout.brd, LIDAR_Breakout.sch]
2019-03-27 Updated parts list, cleaned up folder
    [PartsList_LidarBreakout.xlsx, VoltageReg Options.xlsx]
2019-03-28 Updated 3.2 issues
    [control_board_3.1_parts.xlsx, sedani_chassis_control.brd, sedani_chassis_control.sch]
2019-03-29 Minor Changes, DRC, Design Review Prep
    [LIDAR_Breakout.brd, LIDAR_Breakout.sch]
2019-03-29 DR Ready
    [LIDAR_Breakout.brd]
2019-03-31 Design Review Updates
    [LIDAR_Breakout.brd, LIDAR_Breakout.sch]
2019-03-31 changed 5V routing
    [e-stop-radio.brd]
2019-04-01 fixed DR stuff except for ground plane
    [e-stop-radio.brd, e-stop-radio.sch]
2019-04-02 fixed ground plane so it doesn't exceed board
    [e-stop-radio.brd, e-stop-radio.sch, estop-1.0-bom.xlsx]
2019-04-02 Added silkscreen box around botton pins. Updated docs to include 11-pin header.
    [e-stop-radio.brd]
2019-04-02 cleaned up schematic. Passing DRC
    [e-stop-radio.brd, e-stop-radio.sch]
2019-04-05 Post Design Review Updates
    [LIDAR_Breakout.brd, LIDAR_Breakout.sch]
2019-04-07 Board ready for 3.2 order
    [control_board_3.1_parts.xlsx, control_board_3.2_parts.csv, sedani_chassis_control.brd, sedani_chassis_control.sch]
2019-04-07 Removed extra 5V Reg, made cam
    [control_board_3.2_parts.csv, sedani_chassis_control.brd]
2019-04-08 updated BOM. Ready for order for v1.0.
    [estop-1.0-bom.xlsx]
2019-04-08 PartsList Update
    [PartsList_LidarBreakout.xlsx]
2019-04-08 Final Rev1.1 Updates
    [LIDAR_Breakout.brd, LIDAR_Breakout.sch]
2019-04-08 Added estop gerber
2019-04-08 Added gerbers
    [PartsList_LidarBreakout.xlsx]
2019-04-09 finished BOM for e-stop remote and car
    [estop-1.0-bom.xlsx]
2019-04-24 Removed sedani_chassis_control to remove merge conflict
    [sedani_chassis_control.brd, sedani_chassis_control.sch]
2019-04-24 Revert "Removed sedani_chassis_control to remove merge conflict"
    This reverts commit aeedfd48986dc2b9c450fa83957ead012011b45e.
    [sedani_chassis_control.brd, sedani_chassis_control.sch]
2019-04-24 Do bad version control and just delete merge conflicts
    [control_board_3.1_parts.xlsx, control_board_3.2_parts.csv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]
2019-05-02 Added Level Shifters and Solder Bridges on SPI Lines
    [e-stop-radio.brd, e-stop-radio.sch]
2019-05-03 finished schematic for v1.1. Changed ATMEGA to be 5V
    [e-stop-radio.brd, e-stop-radio.sch, estop-1.0-bom.xlsx, estop-1.1-bom.xlsx]
2019-05-03 started layout. Updated schematic to have solderbridges
    [e-stop-radio.brd, e-stop-radio.sch]
2019-05-03 routed board. Passing DRC.
    [e-stop-radio.brd, e-stop-radio.sch]
2019-05-03 Added oscillator, corrected silkscreen
    [e-stop-radio.brd, e-stop-radio.sch]
2019-05-03 cleaned up ground plane a little
    [e-stop-radio.brd]
2019-05-03 Removed inverter, increased versioning, added estop as input
    [sedani_chassis_control.brd, sedani_chassis_control.sch]
2019-05-04 Removed old parts from library, updated parts placement and routing
    [sedani_chassis_control.brd, sedani_chassis_control.sch]
2019-05-04 Fixed silkscreen issue
    [sedani_chassis_control.brd]
2019-05-04 Updated parts list
    [control_board_3.2_parts.csv, control_board_3.3_parts.csv, sedani_chassis_control.brd, sedani_chassis_control.sch]
2019-05-04 Switched manual pin so it is high if true
    [sedani_chassis_control.brd, sedani_chassis_control.sch]
2019-05-05 Updated gerber
    [sedani_chassis_control.brd]
2019-09-16 new branch for v1.2
    [estop-1.2-bom.xlsx]
2019-09-16 changed level shifters to 2 bidirectional ones
    [e-stop-radio.brd, e-stop-radio.sch]
2019-09-17 added mini-USB and a shifter enable
    [e-stop-radio.brd, e-stop-radio.sch]
2019-09-20 finished rearranging level shifters
    [e-stop-radio.brd, e-stop-radio.sch]
2019-09-27 Added RJ45 jack device, updated descriptions
2019-09-27 Made schematic changes
    [ethernet_poe.sch]
2019-09-28 Added 5V Regulator
    [ethernet_poe.sch]
2019-09-29 Cleaned up schematic, added inductor to library
    [ethernet_poe.sch]
2019-09-29 Added Regulators and 3v3 D,A
    [ethernet_poe.sch]
2019-09-29 Added new-cari folder and steering board
    Don't be a buzzkill and rename it, Varun!
    [Steering.brd, Steering.sch]
2019-09-29 Added inductor to schematic, fixed 3v3A/D
    [ethernet_poe.sch]
2019-09-30 Update Steering.sch
    cleaned up and labeled some stuff
    [Steering.sch]
2019-09-30 began routing v1.2
    [e-stop-radio.brd, e-stop-radio.sch, estop-1.2-bom.xlsx]
2019-10-01 continued routing
    [e-stop-radio.brd, e-stop-radio.sch]
2019-10-02 Added some notes
    Added some notes
    [Steering.brd, Steering.sch]
2019-10-03 changed USB diode
    [e-stop-radio.brd, e-stop-radio.sch, estop-1.2-bom.xlsx]
2019-10-06 Cleaned up style
    [ethernet_poe.sch]
2019-10-06 Added chassis ground/shielding to ethernet
    [ethernet_poe.sch]
2019-10-06 almost finished routing estop
    [e-stop-radio.brd, e-stop-radio.sch]
2019-10-07 Generated board and started with component placement
    [ethernet_poe.brd]
2019-10-07 Began routing, clarified nets
    [ethernet_poe.brd, ethernet_poe.sch]
2019-10-08 began silkscreening
    [e-stop-radio.brd]
2019-10-08 Added temp VGA connector
    [Steering.brd, Steering.sch]
2019-10-08 Finished Preliminary Routing
    [ethernet_poe.brd]
2019-10-08 Resized board
    [ethernet_poe.brd]
2019-10-08 Fixed silkscreen placement
    [ethernet_poe.brd]
2019-10-08 finished silkscreening estop
    [e-stop-radio.brd]
2019-10-08 Created design block and breakout board for testing
    [poe_breakout.brd, poe_breakout.sch]
2019-10-10 screenshot of Hytech's main power relay
2019-10-10 began redoing layout. Most components placed.
    [e-stop-radio.brd, e-stop-radio.sch]
2019-10-14 began routing estop board
    [e-stop-radio.brd, e-stop-radio.sch]
2019-10-15 mostly done routing
    [e-stop-radio.brd, e-stop-radio.sch, estop-1.2-bom.xlsx, estop-1.3-bom.xlsx]
2019-10-15 routing passing DRC
    [e-stop-radio.brd, e-stop-radio.sch]
2019-10-15 found new level shifter. Need to put in schematic
    [e-stop-radio.brd, e-stop-radio.sch, estop-1.3-bom.xlsx]
2019-10-17 schematic fixed with new level shifter
    [e-stop-radio.brd, e-stop-radio.sch, estop-1.3-bom.xlsx]
2019-10-17 mostly routed
    [e-stop-radio.brd, e-stop-radio.sch]
2019-10-17 passing DRC
    [e-stop-radio.brd, e-stop-radio.sch]
2019-10-17 cleaned up power traces
    [e-stop-radio.brd]
2019-10-20 finished silkscreening
    [e-stop-radio.brd, e-stop-radio.sch]
2019-10-20 finished silkscreen and schematic touchup
    [e-stop-radio.brd, e-stop-radio.sch]
2019-10-21 Unpushed to Master
    See title
    [Steering.brd, Steering.sch]
2019-10-21 Created Branch
    Rescued from master
    [Steering.brd, Steering.sch]
2019-10-21 made crystal lines same size
    [e-stop-radio.brd, estop-1.3-bom.xlsx]
2019-10-22 Fixed Molex Connector Package
    [Steering.brd, Steering.sch]
2019-10-22 exported dxf for mechanical
    [e-stop-radio.dxf]
2019-10-22 Library Stuff
    Configured Molex Pins and failed to make an ASSMANN DSUB15 connector, which needs to be removed from the library
    [Steering.brd, Steering.sch]
2019-10-23 Added SPI Transmission Gates
    Added Transmission gates to allow for a DIP switch to enable/disable the SPI lines for the POGO header and the devices.
    [Steering.brd, Steering.sch]
2019-10-27 New Car drive and brake branch created.
    Includes basic schematic of MCU from lidar_breakout.
    [Steering.brd, Steering.sch, base_mcu_sch.sch]
2019-10-27 updated specs
    [e-stop-radio.sch, estop-1.3-bom.xlsx]
2019-10-27 Passing Euro DRC
    [e-stop-radio.brd]
2019-10-28 Changed routing of TX and RX signals
    [ethernet_poe.brd, ethernet_poe.sch]
2019-10-28 Small modifications of no particular significance
    [Steering.brd]
2019-10-28 deleted steering code
    [Steering.brd, Steering.sch]
2019-10-28 created initial schematic w/ microcontroller
    [manual-rc.sch]
2019-10-29 standard components, stack light, ethernet
    [EVGP Daugherboard.sch]
2019-10-29 Update Steering.lbr
    Added NONASSMANN_VGA_CONNECTOR
2019-10-29 Implemented Non-Assmann VGA connector
    Put the Non-Assmann VGA connector on the schematic.
    [Steering.brd, Steering.sch]
2019-11-03 checked schematic
    [ethernet_poe.brd, ethernet_poe.sch]
2019-11-04 Got headers in
    [ethernet_poe.brd, ethernet_poe.sch]
2019-11-05 final pinout
    [ethernet_poe.brd]
2019-11-05 Update Steering.lbr
    Added 4 and 6 pin screw terminal
2019-11-05 Replaced transistor with BS (bilateral switch)
    [Steering.brd, Steering.sch]
2019-11-05 Update Steering.lbr
    Centered Parts
2019-11-05 added decoupling caps + continued routing
    [ethernet_poe.brd, ethernet_poe.sch]
2019-11-05 estop daugherboard stuff
    [EVGP Daugherboard.sch]
2019-11-10 schematic updates, header and and gates
    [EVGP Daugherboard.sch]
2019-11-10 Added More Screw Term. Sizes
2019-11-10 Added PCB concept image
    why didn't I do this a long time ago it would have made life so much easier someone hel[p
2019-11-10 updated libraries
    [ethernet_poe.brd, ethernet_poe.sch]
2019-11-10 Added POE module drop-in footprint to be shared among all boards
2019-11-10 Added Screw Terminals
    I hate screw terminals. Screw 'em
    [Steering.brd, Steering.sch]
2019-11-10 working on decouping
    [ethernet_poe.brd]
2019-11-10 updated schematic to disable whole shifter
    [e-stop-radio.brd, e-stop-radio.sch]
2019-11-10 fixed pullup and silkscreen
    [e-stop-radio.brd, e-stop-radio.sch]
2019-11-10 Integrated Ethernet POE module connection and stack light into the main schematic
    [EVGP Daugherboard.sch]
2019-11-10 finished cleanup for DR
    [e-stop-radio.brd, e-stop-radio.sch]
2019-11-10 Fixed the power stuff on the ethernet poe module
    [EVGP Daugherboard.sch]
2019-11-10 Added and routed decoupling capacitors
    [ethernet_poe.brd]
2019-11-11 Added LED, fixed library, and nearly finished schematic
    [Steering.brd, Steering.sch]
2019-11-11 Updated Library and Schematic
    [drive_brake.sch]
2019-11-11 completed schematic
    [manual-rc.brd, manual-rc.sch]
2019-11-12 finished fixing design review problems
    [e-stop-radio.brd, e-stop-radio.sch]
2019-11-12 schematic updates, connectors
    [EVGP Daugherboard.sch]
2019-11-12 Changed 4-pin JST library and some other small stuff
    [EVGP Daugherboard.sch]
2019-11-12 updated diode + fuse values
    [e-stop-radio.brd, e-stop-radio.sch, estop-1.3-bom.xlsx]
2019-11-12 schematic updates, connectors changes
    [EVGP Daugherboard.sch]
2019-11-12 updated BOM
    [estop-1.3-bom.xlsx]
2019-11-12 Prelim Board Layout
    [Steering.brd, Steering.sch]
2019-11-16 moved BOM to right branch
    [estop-1.3-bom.xlsx]
2019-11-17 Schematic Polish and Board Screw Holes
    Added Screw Holes to the board in semi-arbitrary (but also final) positions
    Added schottky diode and a fuse for protection circuitry on ethernet board input
    Added indicator LEDs for 32U4 power
    Added indicator LEDs for bilateral switch select
    Generally cleaned up and repositioned schematic boxes
    Added values to all components except fuse
    [Steering.brd, Steering.sch]
2019-11-17 Updated holes to M3
    [Steering.brd]
2019-11-17 added mounting holes
    [ethernet_poe.brd]
2019-11-17 more routing
    [ethernet_poe.brd, ethernet_poe.sch]
2019-11-17 Starting placing components
    [Steering.brd]
2019-11-17 Started board design
    [drive_brake.brd, drive_brake.sch]
2019-11-17 Started work on routing
    [EVGP Daugherboard.sch]
2019-11-17 Included new ethernet footprint
    [Steering.brd, Steering.sch]
2019-11-17 Added POE header to schematic
    [drive_brake.brd, drive_brake.sch]
2019-11-17 finished part for the radio
    [e-stop-radio.brd]
2019-11-17 basically nothing
    [EVGP Daugherboard.brd, EVGP Daugherboard.sch]
2019-11-17 Started Placing SPI and Protection Circuitry
    [Steering.brd, Steering.sch]
2019-11-17 Updated schematic
    [drive_brake.brd, drive_brake.sch]
2019-11-18 Started work on the daugtherboard routing
    [EVGP Daugherboard.brd, EVGP Daugherboard.sch]
2019-11-18 Finished Preliminary Component Placement
    Placed components in near-to-final locations, and changed the ethernet fuse for a larger package. Made sure the 5V_MC net and VCC2 nets were connected, as they previously weren't
    [Steering.brd, Steering.sch]
2019-11-18 board layout changes
    [EVGP Daugherboard.brd]
2019-11-18 Began Routing
    [Steering.brd]
2019-11-18 Completed SPI Switch Data Routes
    -Ran SCLK, MOSI, and MISO, and RESET through CD4066's and to the POGO and abs. encoder connectors
    -Positioned switch and indicator LEDs
    -Did not run power connections yet
    -Need to make silkscreen stuff.
    [Steering.brd, Steering.sch]
2019-11-18 Started Board WIP
    [manual-rc-v2.brd, manual-rc-v2.sch]
2019-11-19 more board layout changes
    [EVGP Daugherboard.brd, EVGP Daugherboard.sch]
2019-11-19 Some small board design stuff
    [EVGP Daugherboard.brd]
2019-11-19 Update Steering.brd
    Routed signals from VGA airwires
    [Steering.brd]
2019-11-19 passing DRC and finished silkscreen
    [ethernet_poe.brd, ethernet_poe.sch]
2019-11-19 Update Steering.brd
    More VGA wire routes
    [Steering.brd]
2019-11-19 power routed
    [EVGP Daugherboard.brd, EVGP Daugherboard.sch]
2019-11-19 fixed trace width
    [ethernet_poe.brd]
2019-11-19 Worked a bit more on routing
    [EVGP Daugherboard.brd]
2019-11-19 Manual RC Board WIP v2
    [manual-rc-v2.brd, manual-rc-v2.sch, manual-rc.brd, manual-rc.sch]
2019-11-19 Moved USB Position, more routing
    -Moved USB to over by VGA cable to minimize length due to differential routing not working
    -Moved reset switch over by crystal and DIP switches
    -Added 5V protection circuitry to both USB input and ethernet-poe input and began running 5V bus
    [Steering.brd]
2019-11-19 First routing iteration. SPI and stack light stuff needs to be switched positions
    [EVGP Daugherboard.brd]
2019-11-19 Added test points to fuse
    [Steering.brd, Steering.sch]
2019-11-20 Don't really remember what I changed but I'm sure it was important
    [Steering.brd, Steering.sch]
2019-11-20 Created another iteration of the board layout, with the POGO/ethernet stuff and the stack light (4-pin JST) stuff switched places
    [EVGP Daugherboard 2.brd, EVGP Daugherboard 2.sch]
2019-11-21 Added cad files and routes
    [Aluminum_Heatsink_Base.0004.ipt, Aluminum_Heatsink_Base.ipt, CL57T_Stepper_Driver.ipt, Plastic_Bracket.0001.ipt, Plastic_Bracket.ipt, Steering Electrical Assembly.iam, Steering.brd]
2019-11-21 Fixed up silkscreen
    [EVGP Daugherboard 2.brd, EVGP Daugherboard 2.sch]
2019-11-22 GND Plane and GND Vias, silkscreen updates
    [EVGP Daugherboard 2.brd, EVGP Daugherboard 2.sch]
2019-11-22 Completed Routing
    [Steering.brd]
2019-11-23 Completed Routing and Silkscreen
    [Steering.brd, Steering.sch]
2019-11-23 Board routing nearly completed
    [drive_brake.brd, drive_brake.sch]
2019-11-23 silkscreen updates, names
    [EVGP Daugherboard 2.brd, EVGP Daugherboard 2.sch]
2019-11-23 Board Routed
    [drive_brake.brd, drive_brake.sch]
2019-11-24 Replaced Pogo Header
    Switched out the pogo header for a properly sized (larger) one.
    [Steering.brd, Steering.sch]
2019-11-24 Minor Silkscreen Adjustments
    [Steering.brd]
2019-11-24 updated board and schemtaic
    Changed current sensor connector position, changed reset and spi on pogo
    [drive_brake.brd, drive_brake.sch]
2019-11-24 Added the library
    [EVGP Daugherboard 2.brd]
2019-11-24 deleted unused versions of Ethernet schematic
    [poe_breakout.brd, poe_breakout.sch]
2019-11-24 Board 1 removed, replaced with Board 2, library merged
    [EVGP Daugherboard 2.brd, EVGP Daugherboard 2.sch, EVGP Daugherboard.brd, EVGP Daugherboard.sch]
2019-11-24 added robobuzz and RoboJackets silkscreen
    [ethernet_poe.brd]
2019-11-24 IC silkscreens fixed and switched to merged library
    [EVGP Daugherboard 2.brd, EVGP Daugherboard 2.sch]
2019-11-24 Fixed the routing widths
    [EVGP Daugherboard 2.brd]
2019-11-24 Added connector for throttle output.
    [Steering.sch, drive_brake.brd, drive_brake.sch]
2019-11-25 Updated Board
    [drive_brake.brd]
2019-11-25 Updated board and schematic
    Changed encoder data to interrupt pin.
    [drive_brake.brd, drive_brake.sch]
2019-11-25 Completed Routing for reivew
    [manual-rc-v2.brd, manual-rc-v2.sch]
2019-11-25 added enable_rb connections to atmega
    [EVGP Daugherboard 2.brd, EVGP Daugherboard 2.sch]
2019-11-25 Silkscreen and via adjustment
    [Steering.brd]
2019-11-25 Added constellated vias
    [Steering.brd]
2019-11-25 usb resistors moved out of conflict
    [EVGP Daugherboard 2.brd]
2019-11-25 Added Status LED
    [Steering.brd, Steering.sch]
2019-11-26 Schematic Cleanup
    [manual-rc-v2.sch]
2019-11-26 changed device led name
    [EVGP_Estop_Daugherboard.brd, EVGP_Estop_Daugherboard.sch]
2019-11-26 Added indicator LED
    [Steering.brd, Steering.sch]
2019-11-26 Added 4-pin JST value to schematic
    [EVGP_Estop_Daugherboard.brd, EVGP_Estop_Daugherboard.sch]
2019-11-26 I'm not actually sure if anything has changed
    [EVGP_Estop_Daugherboard.brd, EVGP_Estop_Daugherboard.sch, manual-rc-v2.brd]
2019-11-26 moved u2 silkscreen from under the 32u4
    [EVGP_Estop_Daugherboard.brd]
2019-11-26 fixed some routing widths, added fuse values, etc
    [EVGP_Estop_Daugherboard.brd]
2019-11-26 Changed led2 name
    [EVGP Daugherboard 2.brd, EVGP Daugherboard 2.sch]
2019-11-26 Changed file name and added schematic border
    [EVGP_Estop_Daugherboard.brd, EVGP_Estop_Daugherboard.sch]
2019-11-26 Added a new board iteration with a new blinking led
    [EVGP_Estop_Daugherboard_with_LED.brd, EVGP_Estop_Daugherboard_with_LED.sch]
2019-11-26 Changed the library name, added 555 to library, implemented into both 'normal' and 'led' boards
    [EVGP_Estop_Daugherboard.brd, EVGP_Estop_Daugherboard.sch, EVGP_Estop_Daugherboard_with_LED.brd, EVGP_Estop_Daugherboard_with_LED.sch]
2019-11-28 Board and CAD Updates
    -Made changes recommended in informal design review
    -Exported Board file to Inventor and continued CAD assembly
    [Plastic_Bracket.0001.ipt, Plastic_Bracket.0002.ipt, Plastic_Bracket.ipt, Steering Electrical Assembly.0002.iam, Steering Electrical Assembly.iam, Steering.brd, Steering.brd.ipt, Steering.sch]
2019-11-29 Begin changes from design review
    Editing voltage regulator layout.
    [drive_brake.brd, drive_brake.sch]
2019-12-01 Added Ethernet Poe Board CAD
2019-12-01 Fixed PoE footprint in libraru
    [Steering.brd, Steering.sch]
2019-12-01 Continue updateding board and schematic with design review changes
    [drive_brake.brd, drive_brake.sch]
2019-12-02 Mounting
    -Added CAD files for nearly entire assembly
    -Widened plastic mounting bracket
    -Added supporting ribs
    -Fileted everything to make it pretty
    -Fixed hole pattern in eth-poe
    -Fixed hole pattern in lower-right steering board mounting hole
    -Added screws, heat inserts and other parts to cad
    -determined height between eth-poe and steering board of 11mm to account for .1in headers
    [92000A114_18-8 SS METRIC PAN HEAD PHIL MACHINE SCREW.ipt, 92000A120_18-8 SS METRIC PAN HEAD PHIL MACHINE SCREW.0001.ipt, 92000A120_18-8 SS METRIC PAN HEAD PHIL MACHINE SCREW.ipt, 92095A208_18-8 SS BUTTON-HEAD SOCKET CAP SCREW.ipt, 93657A207_NYLON UNTHREADED SPACER.ipt, 95947A509_ALUM FEM THRDED HEX STANDOFF.ipt, Aluminum_Heatsink_Base.0004.ipt, Aluminum_Heatsink_Base.0007.ipt]
2019-12-02 Finished Mechanical CAD
    Added in final bolts/inserts and recolored to make things clearer
    [Steering Electrical Assembly.0010.iam, Steering Electrical Assembly.0014.iam, Steering Electrical Assembly.iam]
2019-12-02 Fixed eth-poe footprint
    moved the holes on the ethernet-poe footprint down and in by 1mm in both the x and y directions, to match the existing state of the board
2019-12-02 Replaced Eth PoE board
    Hopefully now using the updated library w/ proper mounting hole locations
    [manual-rc-v2.brd, manual-rc-v2.sch]
2019-12-02 Updated ethernet footprint
    [EVGP_Estop_Daugherboard.brd, EVGP_Estop_Daugherboard.sch, EVGP_Estop_Daugherboard_with_LED.brd, EVGP_Estop_Daugherboard_with_LED.sch]
2019-12-02 board layout changes post-review
    Done: Repositioned RC Receiver
    Repositioned USB Connector
    Added space for a small ziptie (maybe)
    Made mounting holes 3.3 mm
    TBD: Power LED, fuse value, actually adding the slot for receiver ziptie, labeling/style
    Basically everything I needed a reference for (am working offline)
    [manual-rc-v2.brd, manual-rc-v2.sch]
2019-12-02 Added holes under PoE mounting holes
    [manual-rc-v2.brd]
2019-12-02 Fixed label style
    [manual-rc-v2.brd]
2019-12-02 Removed unnecessary holes
    TBD:
    Fuse value
    Power/status LEDs
    Slots for zipties for RC
    [manual-rc-v2.brd]
2019-12-02 Board cleanup
    More room for zipties, cleaner routing, moved RC outline to bottom layer (where it will be placed)
    [manual-rc-v2.brd, manual-rc-v2.sch]
2019-12-03 Receiver now completely under board
    [manual-rc-v2.brd]
2019-12-03 Very minor routing cleanup
    [manual-rc-v2.brd]
2019-12-03 Updated changes from design review
    [drive_brake.brd, drive_brake.sch]
2019-12-03 Added power and status LEDs
    [manual-rc-v2.brd, manual-rc-v2.sch]
2019-12-03 Added second status LED
    [manual-rc-v2.brd, manual-rc-v2.sch]
2019-12-03 Updated design review changes
    [drive_brake.brd, drive_brake.sch]
2019-12-03 Added ziptie holes
    [manual-rc-v2.brd]
2019-12-03 Made small silkscreen changes, moved usb to edge
    [EVGP_Estop_Motherboard_with_LED.brd]
2019-12-03 Removed Quadrature Encoder
    Removed quadrature encoder connection to microcontroller, as it went between +-5V, which would have damaged the 32u4
    [Steering.brd, Steering.sch]
2019-12-03 Turned off thermals
    [Steering.brd]
2019-12-03 Added documentation on tDocu layer
    [Steering.brd]
2019-12-03 Added brake-enable jst and steering/drive-enable push button jst
    [EVGP_Estop_Motherboard.brd, EVGP_Estop_Motherboard.sch, EVGP_Estop_Motherboard_with_LED.brd, EVGP_Estop_Motherboard_with_LED.sch]
2019-12-03 changed name of Estop_Daughterboard folder
    [EVGP_Estop_Daugherboard.brd, EVGP_Estop_Daugherboard.sch, EVGP_Estop_Daugherboard_with_LED.brd, EVGP_Estop_Daugherboard_with_LED.sch]
2019-12-03 test folder added
    [EVGP_Estop_Daugherboard.brd, EVGP_Estop_Daugherboard.sch, EVGP_Estop_Daugherboard_with_LED.brd, EVGP_Estop_Daugherboard_with_LED.sch]
2019-12-03 added estop daughterboard stuff into test folder
    [EVGP_Estop_Daugherboard.brd, EVGP_Estop_Daugherboard.sch, EVGP_Estop_Daugherboard_with_LED.brd, EVGP_Estop_Daugherboard_with_LED.sch]
2019-12-03 moved test folder into new-cari
    [EVGP_Estop_Daugherboard.brd, EVGP_Estop_Daugherboard.sch, EVGP_Estop_Daugherboard_with_LED.brd, EVGP_Estop_Daugherboard_with_LED.sch]
2019-12-03 changed estop daughterboard names to estop motherboard
    [EVGP_Estop_Motherboard.brd, EVGP_Estop_Motherboard.sch, EVGP_Estop_Motherboard_with_LED.brd, EVGP_Estop_Motherboard_with_LED.sch]
2019-12-03 Finished routing new connecters
    [EVGP_Estop_Motherboard.brd, EVGP_Estop_Motherboard.sch]
2019-12-03 Nice silkscreen USB
    [manual-rc-v2.brd, manual-rc-v2.sch]
2019-12-03 Fixed USB routing widths
    [manual-rc-v2.brd]
2019-12-04 made some minor a e s t h e t i c tweaks to the board layout
    [EVGP_Estop_Motherboard.brd]
2019-12-04 Replaced USB connector.
    [drive_brake.brd, drive_brake.sch]
2019-12-07 added crystal to BOM
    [estop-1.3-bom.xlsx]
2019-12-18 updated level shifter part
    [estop-1.3-bom.xlsx]
2019-12-30 making sure right part number in sheet
    [estop-1.3-bom.xlsx]
2020-01-05 Fall design review changes pt1
    [EVGP_Estop_Motherboard.brd, EVGP_Estop_Motherboard.sch]
2020-01-06 Fall design review changes pt2
    [EVGP_Estop_Motherboard.brd, EVGP_Estop_Motherboard.sch]
2020-01-07 Fall design review changes pt3
    [EVGP_Estop_Motherboard.brd]
2020-01-07 moved the estop_motherboard file from Estop_daugherboard to Estop_Daugherboard
    [EVGP_Estop_Motherboard.brd, EVGP_Estop_Motherboard.sch]
2020-01-07 added start and safe routes from radio board to motherboard microcontroler
    [EVGP_Estop_Motherboard.brd, EVGP_Estop_Motherboard.sch]
2020-01-07 Some design review changes
    [drive_brake.brd, drive_brake.sch]
2020-01-08 Revert "Some design review changes"
    This reverts commit 4e4a4bafaccf93ef73466e04bce7d88d4dd7373a.
    [drive_brake.brd, drive_brake.sch]
2020-01-08 Design review changes 1
    [drive_brake.brd, drive_brake.sch]
2020-01-08 Design review changes 2
    [drive_brake.brd, drive_brake.sch]
2020-01-08 Joe Review Changes
    [drive_brake.brd, drive_brake.sch]
2020-01-08 Button implemented in hardware through AND gates
    [EVGP_Estop_Motherboard.brd, EVGP_Estop_Motherboard.sch]
2020-01-09 Post-Design Review Board Changes
    [manual-rc-v2.brd]
2020-01-09 Changed board size to 44.5mm width and pin spacing to 40.64mm to allow fitting with 0.1 pitch header
    [ethernet_poe.brd]
2020-01-09 Edited ethernet library part to have 44.5mm width and 40.64mm spacing to allow mating to 0.1in headers
2020-01-09 Joe Review Changes Cont.
    [drive_brake.brd, drive_brake.sch]
2020-01-09 passing DRC now
    [EVGP_Estop_Motherboard.brd, EVGP_Estop_Motherboard.sch]
2020-01-09 Made some minor adjustments
    [EVGP_Estop_Motherboard.brd, EVGP_Estop_Motherboard.sch]
2020-01-09 Logic to control tri-state buffer needed to be corrected
    Connected enable on tri-state buffer to wireless_D3, removed diodes from wireless_D2, wireless__D1, and wireless_D0. Added 3-pin header from steering potentiometer and connected it to A02 on pro micro. Moved 7-pin header so that it wouldn't block other headers.
    [sedani_chassis_control.brd, sedani_chassis_control.sch]
2020-01-09 Fixed supply symbol for 5V input
    [sedani_chassis_control.brd, sedani_chassis_control.sch]
2020-01-09 Updated from Joe Review
    [drive_brake.brd, drive_brake.sch]
2020-01-10 Label changes to schematic
    Also trying to add another pin to the reciever so we can see when it's plugged in
    [manual-rc-v2.brd, manual-rc-v2.sch]
2020-01-10 Button changed to NO w/ pulldown resistor, inputs to MCU changed to IN signals
    [EVGP_Estop_Motherboard.brd, EVGP_Estop_Motherboard.sch]
2020-01-10 Added way to check if receiver is attached
    connected 5V pin on receiver to digital pin 13 of microcontroller w/ 10kΩ pulldown resistor
    [manual-rc-v2.brd, manual-rc-v2.sch]
2020-01-10 Brake_en moved to PWM pin on mcu
    [EVGP_Estop_Motherboard.brd, EVGP_Estop_Motherboard.sch]
2020-01-10 Update from review 2
    [drive_brake.brd, drive_brake.sch]
2020-01-10 Update sedani_chassis_control.brd
    Moved 3-pin header for steering potentiometer to be next to neopixel header
    [sedani_chassis_control.brd]
2020-01-10 Fixed labels and orientation of RJ Logo
    [sedani_chassis_control.brd, sedani_chassis_control.sch]
2020-01-11 Fall Design Review Updates
    Capitalization resistor values, named ethernet board, named Reset push button, labeled D2/D3/D7 colors, noted two SPST switches, renamed connectors in order, updates 'MC1' to 'U4,' and added Board# silkscreen patch
    [Steering.brd, Steering.sch]
2020-01-11 Added digikey part number attribute to most parts
    [drive_brake.brd, drive_brake.sch]
2020-01-12 updated ethernet poe board, made some minor rerouting changes, and cleaned everything up a bit
    [EVGP_Estop_Motherboard.brd, EVGP_Estop_Motherboard.sch]
2020-01-12 Added fuse current rating estimation
    Check design review doc for potential concerns
    [manual-rc-v2.brd]
2020-01-12 fixed Joe's critiques of ethernet POE
    [ethernet_poe.brd, ethernet_poe.sch]
2020-01-14 Create control_board_3.3_parts.csv
    Rearranged some column orders on the BOM
    [control_board_3.3_parts.csv]
2020-01-14 Created manufacturing files
    [drive_brake.sch]
2020-01-14 Removed Pink LED
    Sorry Kyle
    [manual-rc-v2.brd, manual-rc-v2.sch]
2020-01-14 Update control_board_3.3_parts.csv
    Removed diodes 1-3
    [control_board_3.3_parts.csv]
2020-01-14 Update control_board_3.3_parts.csv
    Added quantity per board column
    [control_board_3.3_parts.csv]
2020-01-14 Create Steering_2020-01-14.zip
    Created CAM file
2020-01-14 added throttle and switch connectors
    [manual-rc-v2.brd, manual-rc-v2.sch]
2020-01-14 Updated resistive bridge to scale current sensor reading and RC filter to smooth PWM signal
    [drive_brake.brd, drive_brake.sch]
2020-01-14 Updated resistive bridge with cap to gnd
    [drive_brake.brd, drive_brake.sch]
2020-01-14 Cleaned up schematic and board
    [drive_brake.brd, drive_brake.sch]
2020-01-18 changed ethernet jack and rerouted
    [ethernet_poe.brd, ethernet_poe.sch]
2020-01-20 added Arduino firmware folder
2020-01-20 removed arduino folder
2020-01-21 moved LED1 to pin 25
    [EVGP_Estop_Motherboard.brd, EVGP_Estop_Motherboard.sch]
2020-02-18 did an inventory
    [estop-1.3-inventory.xlsx]
2020-02-19 finished to order list
    [estop-1.3-inventory.xlsx]
2020-03-03 Changed crystal capactor values
    [drive_brake.brd, drive_brake.sch]
2020-03-29 Added LED Cube personal project
2020-04-06 Remapped SCNN to 28
    [drive_brake.brd, drive_brake.sch]
2020-04-06 Replaced Non-Assmann VGA connector with TE one
    Look it's not pretty but it's 2 AM routing. It'll do the job.
    [Steering.brd, Steering.sch]
2020-04-06 Fixed flipped pins on gates and mosfets, added details on schematic
    [EVGP_Estop_Motherboard.brd, EVGP_Estop_Motherboard.sch]
2020-04-06 Improved documentation on schematic
    [EVGP_Estop_Motherboard.sch]
2020-04-07 Update sch with documentation. Still need to document Motor input
    [drive_brake.sch]
2020-04-13 Updated SCNN pin
    [Steering.brd, Steering.sch]
2020-04-13 Updated SS pin and trace
    [EVGP_Estop_Motherboard.brd, EVGP_Estop_Motherboard.sch]
2020-04-13 Updated CS_ETH pin
    [Steering.brd, Steering.sch]
2020-04-13 Fixed USB to ground
    [manual-rc-v2.brd, manual-rc-v2.sch]
2020-05-23 Restructure folders, updated library
    [ethernet_poe.brd, ethernet_poe.sch]
2020-05-25 Added more parts to library, cleaned up board and schematic
    [ethernet_poe.brd, ethernet_poe.sch]
2020-05-26 Finished first draft of schematic
    [ethernet_poe.brd, ethernet_poe.sch]
2020-05-26 Added termination of ethernet taps
    [ethernet_poe.brd, ethernet_poe.sch]
2020-05-26 Cleaned up ethernet tap circuit
    [ethernet_poe.brd, ethernet_poe.sch]
2020-06-26 First routing and layout pass completed.
    [ethernet_poe.brd, ethernet_poe.sch]
2020-06-26 resolved some drc errors
    [ethernet_poe.brd]
2020-06-27 Updated Steering library to style guide standards
2020-06-28 Updated board_outline library to style guide standards
2020-06-28 Updated mux-board library to style guide standards
2020-07-07 updates
    -added grounded mounting holes
    - added ground and stich capacitor for SPI line return current
    - added some polygons
    - fixed several DRC errors
    [ethernet_poe.brd, ethernet_poe.sch]
2020-07-08 Added eFuse, additional header points
    [ethernet_poe.brd, ethernet_poe.sch]
2020-07-08 Actually finished changes for eFuse schematic
    [ethernet_poe.brd, ethernet_poe.sch]
2020-07-11 routing for efuse
    [ethernet_poe.brd, ethernet_poe.sch]
2020-07-11 Placed + routed bulk 24v capacitor
    [ethernet_poe.brd]
2020-07-12 Pre Review Commit, Completed Routing
    [ethernet_poe.brd, ethernet_poe.sch]
2020-07-12 added DRC
    [ethernet_poe.brd]
2020-07-12 Additional design review updates
    [ethernet_poe.brd, ethernet_poe.sch]
2020-07-12 Made drc compliant
    [ethernet_poe.brd, ethernet_poe.sch]
2020-07-12 DRC fixes
    [ethernet_poe.brd, ethernet_poe.sch]
2020-07-25 Began design review changes
    [ethernet_poe.brd, ethernet_poe.sch]
2020-08-03 post design review routing updates
    replaced 5V DC/DC converter catch diode
    routed Wiznet LEDs
    added thermal pads to efuse and DC/DC converters
    [ethernet_poe.brd, ethernet_poe.sch]
2020-08-05 final changes, created manufacturing output
    - Modified layer stackup to match AllPCB standard 4-layer
    - Modified MDI trace widths and spacing for 100ohm differential impedance control
    - Generated manufacturing CAM files
    [ethernet_poe.brd, ethernet_poe.sch]
2020-08-07 added top board with wiznet port
    [ethernet_top_board.brd, ethernet_top_board.sch]
2020-08-24 Updated values to be common digikey values
    [ethernet_poe.brd, ethernet_poe.sch]
2020-08-24 Changed capacitor for load
    [ethernet_poe.brd, ethernet_poe.sch]
2020-08-24 Updated more values based on availability
    [ethernet_poe.brd, ethernet_poe.sch]
2020-10-11 Added FSUSB42 device
2020-10-15 Made v2.1, updated initial problems on library, sch
    [ethernet_poe.brd, ethernet_poe.sch]
2020-10-18 Added Footprint and Symbols for CM3+
2020-11-01 creating schematic file for adapter
    [adapterSchematic.sch]
2020-11-01 copied over circuit blocks from Estop motherboard
    [adapterSchematic.brd, adapterSchematic.sch]
2020-11-08 Committed XS10 Symbol
    Finished symbol, would like review before doing footprint as unsure on a few aspects.
2020-11-08 Began raspberry pi compute
2020-11-09 Finished Raspberry Pi Compute
2020-11-17 Added headers to board and rough board layout.
    [adapterSchematic.brd, adapterSchematic.sch]
2020-11-22 Worked on Schematic Page 3.
    Not yet finished, about half done with 3rd page.
    [DistributedVisionSchematicPage3.sch]
2020-11-22 Added bidirectional level shifters for 3.3v SPI and I2C connectivity
    [adapterSchematic.brd, adapterSchematic.sch]
2020-11-22 Updated Capacitors/Resistors
    [DistributedVisionSchematicPage3.sch]
2020-11-23 Copied sparkfun bidirectional level shifters. Added LEDs. Created switch device for UART voltage
    [Logic_Level_Bidirectional-GiantPanel-v01.brd, Logic_Level_Bidirectional-Panel-v01.brd, Logic_Level_Bidirectional.brd, Logic_Level_Bidirectional.sch, adapterSchematic.brd, adapterSchematic.sch]
2020-11-23 repositioned some headers
    [adapterSchematic.brd]
2020-12-04 Finished schematic and library changes
    [ethernet_poe.brd, ethernet_poe.sch]
2020-12-04 Finished board changes
    [ethernet_poe.brd, ethernet_poe.sch]
2020-12-30 Routed all the traces
    [adapterSchematic.brd, adapterSchematic.sch]
2021-01-08 Fixed Silkscreen, added header pinout, misc touchups
    [adapterSchematic.brd, adapterSchematic.sch]
2021-01-16 Finished Page 3, Re-working Page 1
    [DistributedVisionSchematicPage1_33.sch]
2021-01-17 began some DR fixes
    [adapterSchematic.brd, adapterSchematic.sch]
2021-01-17 more fixes
    [adapterSchematic.brd]
2021-01-17 added levelshifter link
    [adapterSchematic.sch]
2021-01-18 passing drc except for header errors
    [adapterSchematic.brd, adapterSchematic.sch]
2021-01-22 Disb Vision Library Edit/Schematic Update
    Edited Pins 4,6,10,12,14,16,18,22,24 to SDX_ for MicroSD
    Finish Micro_SD part of Schematic on Pg 1
    Replaced BJT with JP1 on Pg 3
    [DistributedVisionSchematicPage1_3.sch]
2021-01-23 Completed Page 1 & 3
    Page 3 Unchanged.
    Page 1 Edits:
    Corrected to 15 pin FPC Connector
    Connected ESD224 in HDMI Connector Section
    [DistributedVisionSchematicPage1_3.sch]
2021-01-23 Corrected FB1 Label Issue
    [DistributedVisionSchematicPage1_3.sch]
2021-01-25 added 3.3v indicator. misc schematic fixes
    [adapterSchematic.brd, adapterSchematic.sch]
2021-01-31 Combined all Schematic Pages
    Fixed some Capacitor/Resistor Values
    Began integrating POE
    [DistributedVisionSchematicPage1_3.sch]
2021-01-31 added board mfg pictures and changed a right angle wire
    [adapterSchematic.brd]
2021-02-01 moved usb, trace under label, and stray line on silkscreen
    [adapterSchematic.brd]
2021-02-07 Cleaning up Schematic
    [DistributedVisionSchematicPage1_3.sch]
2021-02-07 Cleaned up Schematic
    [DistributedVisionSchematicPage1_3.sch]
2021-02-07 Integrated PoE
    [DistributedVisionSchematicPage1_3.sch]
2021-02-14 Added schematic files for speedometer
    [IR_LED.brd, IR_LED.sch, Phototransistor.brd, Phototransistor.sch]
2021-02-14 Changed shifters on spi to resistor divider. misc silkscreen fixes
    [adapterSchematic.brd, adapterSchematic.sch]
2021-02-21 Cleaned up Schematic/Worked on Board
    [DistributedVisionSchematicPage1_3.brd, DistributedVisionSchematicPage1_3.sch, LIDAR_Breakout.sch, LIDAR_BreakoutV2.sch, LIDAR_Breakout_V2.sch, Steering Electrical Assembly.0014.iam, Steering Electrical Assembly.iam, Steering.sch]
2021-02-28 some value changes to ptc fuse, started BOM, gerber zip file
    [adapterSchematic.brd, adapterSchematic.sch]
2021-03-07 added components etc to BOM
    [BOM from eagle.xlsx]
2021-03-07 with BOM
    [Motherboard Components.xlsx]
2021-03-07 Cleaned BOM for Radar adapter. Copy is on Google Drive
    [BOM from eagle.xlsx, RADAR BOM.xlsx]
2021-03-21 Board/Schematic Update
    [DistributedVisionSchematicFINALsch.sch, DistributedVisionSchematicPage1_3 4.brd, DistributedVisionSchematicPage1_3.brd, DistributedVisionSchematicPage1_33.sch, DistributedVisionSchematicPage3.sch]
2021-04-24 AprilTag Board Routing Fix
    [DistributedVisionSchematicPage1_3 4.brd, DistributedVisionSchematicPage1_3 4.sch, DistributedVisionSchematicPage1_3.brd, DistributedVisionSchematicPageFINAL.brd]
2021-04-26 This is some firmware that plots the radar position and velocity data
2021-05-14 Version 2 of April Tag Board with Design Review Changes
    [DistributedVisionSchematicPage1_3 4.brd, DistributedVisionSchematicPageFINAL.brd, DistributedVisionSchematicPagePRAC.sch]
2021-05-15 Version 3
    [DistributedVisionSchematicPage1_3 4VER2.brd, DistributedVisionSchematicPage1_3 4VER2.csv, DistributedVisionSchematicPage1_3 4VER2.sch]
2021-05-15 Joe Cleanup Schematic
    [DistributedVisionSchematicPage1_3 4VER2.brd, DistributedVisionSchematicPage1_3 4VER2.sch]
2021-05-15 Joe Small board cleanup
    [DistributedVisionSchematicPage1_3 4VER2.brd]
2021-05-16 Updated Values in DisbVision sch
    [DistributedVisionSchematicPage1_3 4VER2.brd, DistributedVisionSchematicPage1_3 4VER2.sch]
2021-05-16 Routed Board Based off Schematic Changes
    [DistributedVisionSchematicPage1_3 4VER2.brd, DistributedVisionSchematicPage1_3 4VER2.sch]
2021-05-16 Generated Gerber
    (Zip now available as DistributedVisionVer2_1_2021-05-16.zip)
2021-05-17 BOM + Pick & Place Files
    [DisbVisionBOMVer2_1.xlsx, DisbVisionBOM_DigiKey.csv]
2021-05-17 Added pick and place
    [PnP_DistributedVisionSchematicPage1_3 4VER2_front.csv]
2021-05-17 BOM/PnP Changes
    [DisbVisionBOMVer2_1.xlsx, DisbVisionBOM_DigiKey.csv, DisbVision_JLC_BOM.xlsx, DisbVision_JLC_PnP_2.xlsx, DistributedVisionSchematicPage1_3 4VER2.brd, DistributedVisionSchematicPage1_3 4VER2.sch, top.csv]
2021-05-18 Final DigiKey BOM
    [DisbVision_DigiKey_Final_BOM.csv]
2021-07-11 Created Speedometer board
    Created board file and removed other unused files
    [IR_LED.brd, IR_LED.sch, Speedometer.brd, Speedometer.sch]
2021-07-11 Added Gerber files
    [Speedometer.sch]
2021-07-11 Added RoboBuzz/RoboJackets symbols on board
    [Speedometer.brd]
2021-07-14 Updated board and gerber files
    [Speedometer.brd]
2021-10-24 Made CSV so git trackable
    [Motherboard Components.csv, Motherboard Components.xlsx]
2021-10-24 Cleanup for merge
    [DistributedVision.brd, DistributedVision.csv, DistributedVision.sch, DistributedVisionSchematicPage1_3 4.brd, DistributedVisionSchematicPage1_3 4.sch, DistributedVisionSchematicPagePRAC.sch]
2021-10-24 Restored deleted files
    [LIDAR_Breakout.sch, LIDAR_BreakoutV2.sch, LIDAR_Breakout_V2.sch, Steering Electrical Assembly.0014.iam, Steering Electrical Assembly.iam, Steering.sch]
2021-10-24 Renamed folders, organized
    [92000A114_18-8 SS METRIC PAN HEAD PHIL MACHINE SCREW.ipt, 92000A120_18-8 SS METRIC PAN HEAD PHIL MACHINE SCREW.0001.ipt, 92000A120_18-8 SS METRIC PAN HEAD PHIL MACHINE SCREW.ipt, 92095A208_18-8 SS BUTTON-HEAD SOCKET CAP SCREW.ipt, 93657A207_NYLON UNTHREADED SPACER.ipt, 95947A509_ALUM FEM THRDED HEX STANDOFF.ipt, Aluminum_Heatsink_Base.0007.ipt, Aluminum_Heatsink_Base.ipt]
2021-11-14 Created RoboRacing_STM
    Includes LAN8742A and STM32H743 Components
2021-12-22 Created a Header Part for the Nucleo 144 Board
2022-01-18 Steering Schematic Draft 1
    [Steering.sch, SteeringV2.sch]
2022-01-21 Switched out old Nucleo Header with updated one that has Morpho Connectors Integrated
    [SteeringV2.sch]
2022-01-22 Integrated new header symbols and updated power circuitry on steering schematic
    [SteeringV2.sch]
2022-01-23 Updated power circuitry
    [SteeringV2.sch]
2022-01-30 Copies for Archie/Advaith
    [SteeringV2 - Advaith.sch, SteeringV2 - Archie.sch, SteeringV2.brd]
2022-01-30 Committed for Archie/Advaith
    [SteeringV2.brd]
2022-02-01 Commit Internal Design Review
    [SteeringV2.brd, SteeringV2.sch]
2022-02-04 Updated Common Power Circuitry
    [SteeringV2.brd, SteeringV2.sch]
2022-02-04 Steering Schematic Updated After Internal Design Review
    [SteeringV2.brd, SteeringV2.sch]
2022-02-05 Finished Steering V2 Board Layout
    [SteeringV2.brd, SteeringV2.sch]
2022-02-05 Adjusted some placement
    [SteeringV2.brd]
2022-02-05 Cleaned up islands on Steering Board and generated a manufacturing picture
    [SteeringV2.brd]
2022-02-23 Cleaned up
    [SteeringV2 - Advaith.sch, SteeringV2 - Archie.sch, SteeringV2.brd, SteeringV2.sch]
2022-02-23 Board Cleanup
    [SteeringV2.brd, SteeringV2.sch]
2022-02-24 Cleaned up Board
    [SteeringV2.brd]
2022-02-24 Cleaned up brd
    [SteeringV2.brd]
2022-02-25 Finished Board Cleanup
    [SteeringV2.brd, SteeringV2.sch]
2024-03-12 Found radio estop board files
    [2024-estop-radio.kicad_pcb, 2024-estop-radio.kicad_sch, e-stop-radio.brd, e-stop-radio.dxf, e-stop-radio.sch, estop-1.3-bom.csv, estop-1.3-inventory.csv]
2024-04-07 Added some changes to CAN header board for Nucleo
2024-04-12 Finished CAN to Ethernet PCB Header for Nucleo
2024-04-12 Gerber files generated for CAN to ethernet board
2024-04-16 Completed PCBs for 2024
